guyleslie/EasySD-Gemini/docs/architecture/INIT_LOG_AUDIT_REPORT.md

# Init Log Audit Report

**Date:** 2025-12-26
**Component:** Arduino EasySD Firmware
**Scope:** POST_SPRINT6_PLAN B3 - Init Logging Consolidation

---

## Audit Findings

### 1. Duplicate Initialization (CRITICAL)

**Location:** `EasySD.ino setup()`

**Current flow:**
```cpp
// Line 143-145: Serial init + banner
Serial.begin(57600);
printStartupBanner();

// Line 154: SD init with retry
bool sdSuccess = initSD();

// Line 156-160: DUPLICATE INITIALIZATION #1
if (sdSuccess) {
    dirFunc.ReInit();   // → Calls ToRoot() → "DIR: ROOT"
    dirFunc.Prepare();  // → "DIR: RAM before=...", "DIR: Prep / n=...", "DIR: RAM after=..."
}

// Line 164: SD status
printSDStatus(sdSuccess);

// Line 168: DUPLICATE INITIALIZATION #2
cartApi.Init();  // → Internally calls:
                 //    dirFunc.ReInit();  (line 36)
                 //    dirFunc.Prepare(); (line 37)
```

**Problem:**
- `dirFunc.ReInit()` and `Prepare()` are called **TWICE**
- First call (line 158-159): Only if SD success
- Second call (line 168 → CartApi.cpp:36-37): **ALWAYS**, regardless of SD status

**Debug output duplication:**
```
[First call - line 158-159]
DIR: ROOT
DIR: RAM before=437
DIR: Prep / n=3
DIR: RAM after=437

[Second call - cartApi.Init()]
DIR: ROOT                    ← DUPLICATE
DIR: RAM before=437          ← DUPLICATE
DIR: Prep / n=3              ← DUPLICATE
DIR: RAM after=437           ← DUPLICATE
```

---

## Recommended Fixes

### Fix 1: Remove Redundant Initialization (PREFERRED)

**Action:** Delete lines 156-160 in `EasySD.ino`

**Rationale:**
- `cartApi.Init()` already calls `dirFunc.ReInit()` + `Prepare()`
- No need to call them explicitly in `setup()`
- Simplifies initialization flow
- Reduces log duplication

**New flow:**
```cpp
bool sdSuccess = initSD();
// Removed: dirFunc.ReInit() + Prepare() (cartApi.Init() handles this)
printSDStatus(sdSuccess);
cartApi.Init();  // Handles dirFunc init internally
```

**Note:** There's a comment on line 167:
```cpp
// Note: cartApi.Init() also calls dirFunc.ReInit/Prepare (duplicate but safe)
```
This comment acknowledges the duplication. We're fixing it now.

---

### Fix 2: Improve DirFunction::Prepare() Logging

**Current logging (too verbose):**
```cpp
#ifdef EASYSD_DEBUG_SERIAL
Serial.print(F("DIR: RAM before=")); Serial.println(FreeStack());
// ... processing ...
Serial.print(F("DIR: Prep ")); Serial.print(currentPath);
Serial.print(F(" n=")); Serial.println(count);
Serial.print(F("DIR: RAM after=")); Serial.println(FreeStack());
#endif
```

**Proposed (consolidated):**
```cpp
#ifdef EASYSD_DEBUG_SERIAL
Serial.print(F("[DIR] Prep: "));
Serial.print(currentPath);
Serial.print(F(" ("));
Serial.print(count);
Serial.print(F(" items, "));
Serial.print(FreeStack());
Serial.println(F(" bytes free)"));
#endif
```

**Before:**
```
DIR: RAM before=437
DIR: Prep / n=3
DIR: RAM after=437
```

**After:**
```
[DIR] Prep: / (3 items, 437 bytes free)
```

**Benefits:**
- One line instead of three
- Easier to grep: `grep "\[DIR\]" log.txt`
- Consistent with DebugLog.h format
- Still contains all critical info

---

### Fix 3: ToRoot() Logging Cleanup

**Current:**
```cpp
#ifdef EASYSD_DEBUG_SERIAL
Serial.println(F("DIR: ROOT"));
#endif
```

**Proposed:**
```cpp
#ifdef EASYSD_DEBUG_SERIAL
Serial.println(F("[DIR] Changed to ROOT"));
#endif
```

**Benefit:** Consistent prefix `[DIR]` for all directory operations

---

## Summary of Changes

| File | Line | Change | Priority |
|---|---|---|---|
| `EasySD.ino` | 156-160 | DELETE redundant dirFunc calls | **HIGH** |
| `EasySD.ino` | 167 | UPDATE comment (remove "duplicate but safe") | LOW |
| `DirFunction.cpp` | 224-252 | CONSOLIDATE Prepare() logging (3 lines → 1) | MEDIUM |
| `DirFunction.cpp` | 81 | UPDATE ToRoot() log prefix | LOW |

---

## Expected Outcome

**Before (duplicated logs):**
```
================================
 EasySD v2.1.0
 SdFat 2.3.0 | Arduino Nano
================================

SD: Init attempt 1/3 failed
SD: OK after 2 attempts
DIR: ROOT
DIR: RAM before=437
DIR: Prep / n=3
DIR: RAM after=437
SD OK
RAM: 437
Type 'h' for help

DIR: ROOT                    ← DUPLICATE
DIR: RAM before=437          ← DUPLICATE
DIR: Prep / n=3              ← DUPLICATE
DIR: RAM after=437           ← DUPLICATE
```

**After (clean logs):**
```
================================
 EasySD v2.1.0
 SdFat 2.3.0 | Arduino Nano
================================

SD: Init attempt 1/3 failed
SD: OK after 2 attempts
SD OK
RAM: 437
Type 'h' for help

[DIR] Changed to ROOT
[DIR] Prep: / (3 items, 437 bytes free)
```

**Reduction:** 10 lines → 6 lines (40% reduction)

---

## Implementation Plan

1. **Edit EasySD.ino** (HIGH priority)
   - Delete lines 156-160 (redundant dirFunc init)
   - Update line 167 comment

2. **Edit DirFunction.cpp** (MEDIUM priority)
   - Consolidate Prepare() logging (lines 224-252)
   - Update ToRoot() logging (line 81)

3. **Validation**
   - Build debug firmware
   - Verify no duplicate "DIR: ROOT" messages
   - Verify consolidated Prepare() log format
   - Check SD fail case (dirFunc init should still work via cartApi.Init())

---

**Status:** Ready for implementation
**Estimated time:** 30 minutes
**Risk:** Low (removing redundant code, improving logging only)
