guyleslie/EasySD-Gemini/docs/sprints/SPRINT6_PLAN.md

# Sprint 6 - Production Polish & User Experience

> **Tervezett dátum:** 2025-12-26+
> **Előfeltétel:** Sprint 5 Complete (v2.0.6)
> **Célverzió:** v2.1.0
> **Státusz:** Planning Phase

---

## Sprint Cél

**Professzionális user experience és production stability finomhangolás** a SdFat 2.x migráció lezárásaként.

**Fókusz:**
1. ✨ Serial Monitor UI/UX javítás (user-friendly output)
2. 🔧 Cold Boot SD Init javítás (retry logic)
3. 🎯 SdFat 2.x migráció véglegesítése
4. 📊 Extended testing & validation

---

## Prioritás 1 (P1) - Mandatory

### P1.1: Cold Boot SD Initialization Retry Logic

**Probléma (Sprint 5 Known Issue):**
```
Power cycle → SD init failure → Manual reset required
```

**Root Cause:**
- SD kártya ~100-200ms VCC stabilizáció szükséges
- Arduino gyorsabban bootol mint SD kártya készen áll
- `sd.begin()` túl korán hívódik

**Megoldás:**
```cpp
// IRQHack64.ino setup() módosítás
bool initSD() {
  const uint8_t SD_RETRY_COUNT = 3;
  const uint16_t SD_RETRY_DELAY_MS = 200;

  for (uint8_t retry = 0; retry < SD_RETRY_COUNT; retry++) {
    if (sd.begin(SD_CS_PIN, SD_SCK_MHZ(4))) {
      #ifdef DEBUG
      if (retry > 0) {
        Serial.print(F("SD: OK after "));
        Serial.print(retry + 1);
        Serial.println(F(" attempts"));
      }
      #endif
      return true;
    }

    #ifdef DEBUG
    Serial.print(F("SD: Init attempt "));
    Serial.print(retry + 1);
    Serial.print(F("/"));
    Serial.print(SD_RETRY_COUNT);
    Serial.println(F(" failed"));
    #endif

    if (retry < SD_RETRY_COUNT - 1) {
      delay(SD_RETRY_DELAY_MS);
    }
  }

  return false;
}
```

**Érintett fájl:** `Arduino/IRQHack64/IRQHack64.ino`

**Tesztelés:**
1. Cold boot (USB + SD táp lecsatlakoztatva, visszacsatlakoztatva)
2. Warm boot (Arduino reset gomb)
3. Hot boot (Serial monitor reconnect)

**Success Criteria:**
- ✅ Cold boot 95%+ siker ráta (3 retry esetén)
- ✅ Warm/hot boot továbbra is instant
- ✅ DEBUG log informatív (retry count visible)

**Becsült effort:** 1 óra (implementáció + tesztelés)

---

### P1.2: Serial Monitor UI/UX Refactoring

**Jelenlegi probléma:**
```
DIR: ROOT
DIR: RAM before=389
DIR: Prep / n=3
DIR: RAM after=389
=== IrqHack64 SPRINT 1 ===
d=nav r=reset p=status l=list
Free RAM: 437
```

**Problémák:**
- Nem user-friendly (DEBUG output dominál)
- Keverednek a DEBUG és user üzenetek
- Nincs strukturált navigációs feedback
- Hiányzik status bar / header

#### P1.2.1: Startup Banner Professzionalizálása

**Jelenlegi:**
```
=== IrqHack64 SPRINT 1 ===
```

**Javasolt (v2.1.0):**
```
╔════════════════════════════════════════╗
║   EasySD IRQHack64 Firmware v2.1.0    ║
║   SdFat 2.3.0 | Arduino Nano           ║
╚════════════════════════════════════════╝

Initializing SD card...
✓ SD card ready (FAT32, 32GB)
✓ Directory system initialized
✓ Free RAM: 437 bytes

Ready. Type 'h' for help.
> _
```

**Implementáció:**
```cpp
void printStartupBanner() {
  Serial.println(F("╔════════════════════════════════════════╗"));
  Serial.println(F("║   EasySD IRQHack64 Firmware v2.1.0    ║"));
  Serial.println(F("║   SdFat 2.3.0 | Arduino Nano           ║"));
  Serial.println(F("╚════════════════════════════════════════╝"));
  Serial.println();
}

void printSDStatus() {
  Serial.println(F("Initializing SD card..."));

  if (initSD()) {
    Serial.print(F("✓ SD card ready ("));
    // Print card type (FAT16/FAT32/exFAT)
    Serial.print(F(", "));
    // Print card size
    Serial.println(F(")"));
  } else {
    Serial.println(F("✗ SD card initialization failed"));
    Serial.println(F("  Check: Card inserted? Format correct?"));
  }
}
```

#### P1.2.2: Navigation Feedback Strukturálása

**Jelenlegi:**
```
Navigate: UTILS
DIR: CD UTILS
DIR: Entered /UTILS
OK
Path: /UTILS
Items: 3
```

**Javasolt:**
```
Navigating to: UTILS
  ✓ Changed directory to /UTILS
  ✓ Found 3 items

Current path: /UTILS
> _
```

**Implementáció:**
```cpp
void printNavigationSuccess(const char* path, uint16_t itemCount) {
  Serial.print(F("  ✓ Changed directory to "));
  Serial.println(path);
  Serial.print(F("  ✓ Found "));
  Serial.print(itemCount);
  Serial.println(F(" items"));
  Serial.println();
  Serial.print(F("Current path: "));
  Serial.println(path);
}

void printNavigationError(const char* dirname) {
  Serial.print(F("  ✗ Cannot access directory: "));
  Serial.println(dirname);
  Serial.println(F("    Check: Directory exists? Name correct?"));
}
```

#### P1.2.3: Directory Listing Format

**Jelenlegi:**
```
List: /UTILS
1: .. [DIR]
2: UTILS2 [DIR]
3: 2kscrollerizer.prg
DIR: Iterate Finished
Total: 3
```

**Javasolt:**
```
Directory: /UTILS
────────────────────────────────────────
  📁 ..
  📁 UTILS2
  📄 2kscrollerizer.prg
────────────────────────────────────────
Total: 3 items (2 folders, 1 file)
> _
```

**Implementáció:**
```cpp
void printDirectoryHeader(const char* path) {
  Serial.print(F("Directory: "));
  Serial.println(path);
  Serial.println(F("────────────────────────────────────────"));
}

void printDirectoryEntry(const char* name, bool isDir) {
  Serial.print(F("  "));
  Serial.print(isDir ? F("📁 ") : F("📄 "));
  Serial.println(name);
}

void printDirectoryFooter(uint16_t totalItems, uint16_t dirCount, uint16_t fileCount) {
  Serial.println(F("────────────────────────────────────────"));
  Serial.print(F("Total: "));
  Serial.print(totalItems);
  Serial.print(F(" items ("));
  Serial.print(dirCount);
  Serial.print(F(" folders, "));
  Serial.print(fileCount);
  Serial.println(F(" files)"));
}
```

#### P1.2.4: Help System

**Új parancs:** `h` (help)

**Kimenet:**
```
EasySD IRQHack64 - Command Reference
────────────────────────────────────────
  h     Show this help
  d     Navigate to directory (prompts for name)
  r     Return to root directory
  l     List current directory contents
  p     Show current path and status
  m     Show memory usage (DEBUG only)
────────────────────────────────────────
Examples:
  d → UTILS → d → UTILS2 → r

> _
```

#### P1.2.5: DEBUG Mode Separation

**Stratégia:**
```cpp
#ifdef DEBUG
  // DEBUG-only részletes info
  #define DEBUG_PRINT(x) Serial.print(F("DEBUG: ")); Serial.println(x)
  #define DEBUG_RAM() printRAMStatus()
#else
  #define DEBUG_PRINT(x)
  #define DEBUG_RAM()
#endif

// User-facing mindig látható
#define USER_PRINT(x) Serial.println(x)
```

**Alkalmazás:**
```cpp
// User-facing output
USER_PRINT("Navigating to: UTILS");

// DEBUG details
DEBUG_PRINT("DIR: chdir(UTILS) called");
DEBUG_PRINT("DIR: ResyncDirFromCwd() success");
DEBUG_RAM(); // RAM before/after

// User-facing result
printNavigationSuccess(currentPath, count);
```

**Érintett fájlok:**
- `Arduino/IRQHack64/IRQHack64.ino` (main loop, banner)
- `Arduino/IRQHack64/DirFunction.cpp` (navigation feedback)

**Becsült effort:** 3-4 óra (UI design + implementáció + tesztelés)

---

## Prioritás 2 (P2) - Strongly Recommended

### P2.1: Error Handling Standardization

**Cél:** Egységes error message formátum minden művelethez

**Error Categories:**
1. **SD Card Errors:** Init, read, write failures
2. **Directory Errors:** Navigation, listing failures
3. **File Errors:** Open, read failures
4. **System Errors:** Memory, state inconsistency

**Template:**
```
✗ [Category] Error: [Short description]
  Cause: [Technical reason]
  Action: [User suggestion]
```

**Példa:**
```
✗ Directory Error: Cannot navigate to UTILS2
  Cause: Directory does not exist
  Action: Check directory name spelling

✗ SD Card Error: Card initialization failed
  Cause: No SD card detected
  Action: Insert SD card and press reset button
```

**Implementáció:**
```cpp
enum ErrorCategory {
  ERR_SD_CARD,
  ERR_DIRECTORY,
  ERR_FILE,
  ERR_SYSTEM
};

void printError(ErrorCategory cat, const char* desc, const char* cause, const char* action) {
  Serial.print(F("✗ "));

  switch(cat) {
    case ERR_SD_CARD:   Serial.print(F("SD Card")); break;
    case ERR_DIRECTORY: Serial.print(F("Directory")); break;
    case ERR_FILE:      Serial.print(F("File")); break;
    case ERR_SYSTEM:    Serial.print(F("System")); break;
  }

  Serial.print(F(" Error: "));
  Serial.println(desc);
  Serial.print(F("  Cause: "));
  Serial.println(cause);
  Serial.print(F("  Action: "));
  Serial.println(action);
}
```

**Becsült effort:** 2 óra

---

### P2.2: Memory Status Display Improvement

**Jelenlegi:**
```
Free RAM: 437
DIR: RAM before=389
DIR: RAM after=389
```

**Javasolt (m parancs):**
```
Memory Status
────────────────────────────────────────
  Total SRAM:        2048 bytes
  Used:              1611 bytes (78.7%)
  Free:               437 bytes (21.3%)

  Stack (approx):     256 bytes
  Heap (approx):     1355 bytes

  Dir handle RAM:     389 bytes
────────────────────────────────────────
Status: ✓ Normal (>400 bytes free)
```

**Warning levels:**
```cpp
void printMemoryStatus() {
  uint16_t freeRAM = FreeStack();

  // ... (táblázat kiírása)

  Serial.print(F("Status: "));
  if (freeRAM > 400) {
    Serial.println(F("✓ Normal"));
  } else if (freeRAM > 300) {
    Serial.println(F("⚠ Low (consider freeing resources)"));
  } else {
    Serial.println(F("✗ Critical (risk of stack overflow)"));
  }
}
```

**Becsült effort:** 1.5 óra

---

## Prioritás 3 (P3) - Quality/Polish

### P3.1: Extended Hardware Testing

**Test Suite:**

1. **Stress Test - Navigation Cycles:**
   - 20x Root → UTILS → UTILS2 → Root cycle
   - RAM monitoring minden lépésnél
   - Assertion: Visszatér baseline-ra (<5 byte eltérés)

2. **Deep Nesting Test:**
   - 5-6 szintű directory navigáció (ha van ilyen az SD-n)
   - Path buffer overflow detection (64 byte limit)
   - GoBack működés minden szintről

3. **Large Directory Test:**
   - 50+ fájl egy directory-ban (ha van)
   - Prepare() performance (<500ms)
   - Iterate() stability

4. **Edge Cases:**
   - Üres directory
   - Single file directory
   - Csak subdirectory, file nélkül
   - Very long filename (>20 char)

**Test Script (Python):**
```python
# Tools/test_navigation_stress.py
import serial
import time

def stress_test_navigation(port, cycles=20):
    ser = serial.Serial(port, 57600, timeout=2)

    for i in range(cycles):
        print(f"Cycle {i+1}/{cycles}")

        # Navigate: Root → UTILS → UTILS2
        ser.write(b'd\n')
        time.sleep(0.5)
        ser.write(b'UTILS\n')
        time.sleep(0.5)

        ser.write(b'd\n')
        time.sleep(0.5)
        ser.write(b'UTILS2\n')
        time.sleep(0.5)

        # Return to root
        ser.write(b'r\n')
        time.sleep(0.5)

        # Check memory
        ser.write(b'm\n')
        response = ser.read(500).decode('utf-8')

        # Parse RAM usage
        # Assert: RAM within expected range

    ser.close()
    print("✓ Stress test complete")
```

**Becsült effort:** 2-3 óra (script + manual testing + documentation)

---

### P3.2: SdFat 2.3.0 → 2.3.3 Upgrade Evaluation

**Jelenlegi:** SdFat 2.3.0 (2023)
**Latest:** SdFat 2.3.3 (2024)

**Changelog Review (2.3.0 → 2.3.3):**
- FAT32 edge case bug fixes
- ExFAT performance improvements
- Better error handling

**Kockázat Értékelés:**
- ✅ Minor version jump (low risk)
- ✅ Sprint 5 tests reusable (regression detection)
- ⚠️ New bugs possible (mindig van rizikó)

**Döntési Fa:**
```
1. Review SdFat 2.3.3 changelog részletesen
2. Ha van critical bugfix → UPGRADE (Priority: High)
3. Ha csak minor improvements → DEFER (Priority: Low)
4. Ha uncertainty → TEST in separate branch first
```

**Upgrade Process (ha GO):**
1. Backup current Arduino/libraries/SdFat
2. Install SdFat 2.3.3 via Library Manager
3. Full Sprint 5 regression test suite
4. Extended testing (P3.1)
5. Documentation update

**Becsült effort:** 1-2 óra (review + potential upgrade + testing)

---

### P3.3: Documentation Finalization

**Sprint 6 dokumentáció:**
1. ✅ `SPRINT6_PLAN.md` - Ez a fájl
2. ⏳ `SPRINT6_COMPLETION.md` - Sprint végén
3. ⏳ `SERIAL_UI_GUIDE.md` - User manual a parancsokhoz
4. ⏳ Update `CHANGELOG_UNIFIED.md` - v2.1.0 entry

**SERIAL_UI_GUIDE.md tartalom:**
```markdown
# EasySD IRQHack64 - Serial Interface Guide

## Commands
- h: Help
- d: Navigate
- r: Root
- l: List
- p: Path
- m: Memory (DEBUG)

## Navigation Examples
## Error Messages
## Troubleshooting
```

**Becsült effort:** 1.5 óra

---

## Definition of Done (Sprint 6)

Sprint 6 **COMPLETE** amikor:

### Mandatory (P1)
1. ✅ Cold boot SD init retry logic implementálva és tesztelve
   - 95%+ cold boot success rate (3 retry)
   - No regression warm/hot boot esetén
2. ✅ Serial Monitor UI/UX refactoring befejezve
   - Startup banner professional
   - Navigation feedback user-friendly
   - Directory listing structured
   - Help system working
   - DEBUG/User output separated

### Recommended (P2)
3. ✅ Error handling standardizálva (4 kategória)
4. ✅ Memory status display improved

### Quality (P3)
5. ✅ Extended hardware testing suite completed
   - 20x stress test passed
   - Deep nesting tested
   - Large directory tested
   - Edge cases covered
6. ✅ SdFat upgrade decision made (upgrade or defer)
7. ✅ Documentation finalized
   - SPRINT6_COMPLETION.md
   - SERIAL_UI_GUIDE.md
   - CHANGELOG_UNIFIED.md updated

---

## Sprint 6 Effort Estimate

| Priority | Task | Effort | Cumulative |
|---|---|---|---|
| P1.1 | Cold Boot Retry | 1h | 1h |
| P1.2 | Serial UI/UX | 4h | 5h |
| P2.1 | Error Handling | 2h | 7h |
| P2.2 | Memory Display | 1.5h | 8.5h |
| P3.1 | Extended Testing | 3h | 11.5h |
| P3.2 | SdFat Evaluation | 2h | 13.5h |
| P3.3 | Documentation | 1.5h | **15h total** |

**Becsült Sprint időtartam:** 2-3 nap (casual pace) vagy 1 nap (focused sprint)

---

## Testing Strategy

### Unit Tests (Arduino Serial Monitor)

**Test 1: Cold Boot**
```
1. Power cycle (USB + SD power off/on)
2. Observe: SD init retry attempts
3. Expected: Success within 3 attempts
4. Log: Retry count in DEBUG mode
```

**Test 2: UI/UX Validation**
```
1. Reset Arduino
2. Observe: Startup banner
3. Type: h
4. Expected: Help displayed
5. Type: l
6. Expected: Structured directory listing
```

**Test 3: Navigation Flow**
```
1. Type: d → UTILS → d → UTILS2
2. Observe: User-friendly feedback
3. Type: r
4. Expected: Clean return to root with status
```

### Regression Tests (Reuse Sprint 5)

```
All Sprint 5 tests must PASS:
✅ Multi-level navigation (5 scenarios)
✅ RAM stability (0 byte leaks)
✅ State synchronization (no drift)
```

### Performance Tests

```
Benchmark: Directory operations timing
- Prepare() on 3-item dir: <50ms
- Iterate() per item: <10ms
- ChangeDirectory(): <100ms
```

---

## Risk Assessment

| Risk | Probability | Impact | Mitigation |
|---|---|---|---|
| Serial output breaks existing C64 integration | Low | High | Ensure C64 side ignores Serial, test thoroughly |
| Cold boot retry adds delay | Medium | Low | Only 400ms max (2x200ms), acceptable |
| UI changes confuse users | Low | Medium | Provide SERIAL_UI_GUIDE.md |
| SdFat upgrade breaks code | Low | High | Full regression test suite, backup old version |
| Extended testing finds new bugs | Medium | Medium | Good! Fix before production |

---

## Success Metrics

**User Experience:**
- [ ] Startup time: <2 seconds (including SD init with retry)
- [ ] Command response: Instant (<100ms perceived)
- [ ] Error messages: Clear, actionable
- [ ] Help system: Comprehensive, easy to understand

**Stability:**
- [ ] Cold boot success rate: >95% (vs current ~50%)
- [ ] RAM stability: Maintained (no regression vs Sprint 5)
- [ ] Zero crashes during 20x stress test

**Code Quality:**
- [ ] Code coverage: DEBUG macros properly used
- [ ] Documentation: Complete, professional
- [ ] Maintainability: Clear separation User/DEBUG output

---

## Next Steps (Post Sprint 6)

**v2.1.0 is PRODUCTION READY when Sprint 6 DoD met.**

**Future Sprints (Optional):**
- **Sprint 7:** C64 side improvements (menu UX, error handling)
- **Sprint 8:** Advanced features (file search, recursive ops)
- **Sprint 9:** Performance optimization (if needed)

**Maintenance Mode:**
- Monitor user feedback
- Bug fixes as needed
- Library updates (SdFat, Arduino Core) as released

---

**Status:** 📋 Planning Complete - Ready for Implementation
**Created:** 2025-12-26
**Target Start:** TBD (User decision)
**Estimated Duration:** 1-3 days
