guyleslie/EasySD-Gemini/docs/architecture/ARCHITECTURE_CONSOLIDATION_PLAN.md

# IRQHack64 Architekturális Konszolidációs Terv
## "IO2 Kanonikus Architektúra" - Sprint A-D

**Dokumentum típus:** Stratégiai terv
**Verzió:** 2.2 (SPRINT A.3 CANCELLED - ARCHITECTURAL CORRECTIONS)
**Készült:** 2025-12-29
**Frissítve:** 2025-12-30 (Sprint A.3.0 research findings + NO-GO decision)
**Alapja:** nieuw 7.txt elemzés, Sprint A.3.0 code research, architectural fact-checking
**Status:** SPRINT A COMPLETE (with NO-GO on refactoring)

**v2.0 változások:**
- ✅ Sprint B.0: "Visibility over Magic" filozófia (kritikus kiegészítés)
- ✅ Sprint B.2: Tier-alapú macro rendszer (1=primitives, 2=caller-responsible, 3=lifecycle)
- ✅ Sprint B.3: Code review enforcement (NEM compile-time, pragmatikus)
- ✅ Sprint B.4: Audit tools (grep-based, egyszerű scriptek)

**v2.1 változások (KRITIKUS KORREKCIÓK):**
- ✅ Sprint A.3 előfeltevések javítása: Pluginok NEM hardcode-olják a címeket
- ✅ Sprint A.3.0 ÚJ: Pre-refactoring kutatási fázis hozzáadva
- ✅ Refaktoring stratégia módosítása: "Replace" → "ADD explicit addresses"
- ✅ Refaktoring példák javítása (auto-placement → explicit ORG)
- ✅ BurstLoader exception tisztázása (approved architectural decision)
- ✅ Timeline frissítése: 2-3 nap → 4-5 nap (kutatási fázis miatt)
- ✅ Referencia: docs/sprints/SPRINT_A_AUDIT_FINDINGS.md (részletes audit jelentés)

**v2.2 változások (SPRINT A.3 CANCELLED - ARCHITECTURAL FACT-CHECKING):**
- 🔴 **SPRINT A.3 CANCELLED** - Plugin refactoring NO-GO (architectural assumptions were INCORRECT)
- ✅ **MEMORY_MAP_CANONICAL.md v2.0** released - corrected ZP pointer architecture documentation
- ✅ **Type A/B Program Categorization** - BurstLoader is standalone app (NOT plugin exception)
- ✅ **Zero technical value** from refactoring - API uses ZP pointers (buffers can be anywhere)
- ✅ **Sprint A.1-A.2 COMPLETE** - IO2_PROTOCOL_SPECIFICATION.md ✅, CartMemoryMap.inc ✅
- ✅ **Sprint A.3.0 COMPLETE** - Architectural research, NO-GO decision approved by user
- ✅ Referenciák:
  - docs/sprints/A.3.0_PLUGIN_ARCHITECTURE_RESEARCH.md (Type A/B categories)
  - docs/sprints/A.3.0_REFACTORING_DECISION.md (NO-GO justification)
  - docs/MEMORY_MAP_CANONICAL.md v2.0 (corrected normative spec)

---

## Executive Summary

Ez a dokumentum a **"nieuw 7.txt"** által definiált kanonikus architektúra megvalósításának részletes tervét tartalmazza. A terv négy sprintre (A-D) bontva konzolidálja az IRQHack64 projekt jelenlegi implementációját, tisztázza az IO2-alapú streaming protokollt, standardizálja a memóriatérképet és a kódolási mintázatokat.

### Kulcsmegállapítások a projekt jelenlegi állapotáról

✅ **ERŐSSÉGEK** (már megvalósított elemek):
- IO2/DF00 protokoll **helyesen implementálva** (CartLibStream.s, CartApi.cpp)
- Streaming timeout **működik** (100ms, STREAM_TIMEOUT_MS)
- Transfer buffer memóriatérkép **konzisztens** ($C000-$C19F kanonikus, $A000 csak BurstLoader)
- Zero Page management **professzionális** (ZP_GUIDELINES.md normatív dokument)
- Macro architektúra **érett** (SystemMacros.s, Sprint 1-11 eredményei)
- ByteQueue **helyesen használva** (csak parancsok fogadására, NEM streaminghez)

⚠️ **JAVÍTANDÓ TERÜLETEK** (konszolidációs célpontok):
- ZP naming convention **nem teljes** (Sprint 11 folyamatban, de teljes átnevezés hiányzik)
- Plugin memóriatérkép audit **részleges** (BurstLoader vs. többi plugin esete dokumentált, de nem normatív)
- Makró használat **nem egységes minden pluginban** (411× READCART_MODULATED jó példa, de nem minden plugin használja)
- "Kanonikus architektúra" dokumentáció **szétszórt** (ARCHITECTURE_REVIEW.md, ZP_GUIDELINES.md, MemUsage.txt külön élnek)

📋 **TERV CÉLJAI**:
1. **Konzisztencia** - Egyetlen "igazság forrása" minden architekturális döntésre
2. **Dokumentáltság** - Normatív architektúra dokumentum, amely kötelező referencia
3. **Compliance** - Minden plugin és kód megfelel a kanonikus szabályoknak
4. **Tesztelhetőség** - Determinisztikus tesztek az IO2 protokoll és memória helyességére
5. **Tudatos fejlesztés** - Makrók "segítenek", nem "helyettesítik" a gondolkodást (v2.0 kiegészítés)

---

## JELENLEGI ÁLLAPOT - Részletes Audit Eredmények

### 1. IO2/DF00 Protokoll Implementáció

**STATUS: ✅ HELYES IMPLEMENTÁCIÓ**

#### C64 oldal (CartLibStream.s)

```assembly
; Jelenlegi implementáció (CartLibStream.s:40-42, 81-82)
STREAM_TRIGGER_PORT = $DF00  ; IO2 trigger
STREAM_DATA_PORT    = $DE00  ; Data read

_stream_loop:
    LDA STREAM_TRIGGER_PORT  ; Pulse /IO2
    LDA STREAM_DATA_PORT     ; Read byte
    STA (ZP_STREAM_API_TARGET_LO),Y
```

**Megfelelőség:**
- ✅ IO2 címzés helyes ($DF00 trigger)
- ✅ 32-bit file size támogatás (ZP_STREAM_API_REMAIN0-3, $92-$95)
- ✅ SEI/CLI interrupt védelem
- ✅ Passzív terminálás (C64 abbahagyja a request-eket, Arduino timeout észleli)

#### Arduino oldal (CartApi.cpp)

```cpp
// CartApi.cpp:905-950
#define STREAM_TIMEOUT_MS 100

void CartApi::HandleStream() {
    // Double-buffered streaming (64 byte × 2)
    attachInterrupt(digitalPinToInterrupt(IO2),
                    CartApi::DoubleBufferedStreaming, FALLING);

    while(1) {
        while(usedBuffer == 0) {
            if (!digitalRead(SEL)) goto out;  // Emergency exit
            if (millis() - lastStreamRequestTime > STREAM_TIMEOUT_MS) goto out;  // Timeout
        }
        workingFile.read(streamingBuffer1, DOUBLE_BUFFER_SIZE);
        // ... buffer swap ...
    }
out:
    TIMSK2 = 0x02;  // Restore timer interrupts
}
```

**Megfelelőség:**
- ✅ IO2 interrupt FALLING edge (CartInterface.h:35 - `#define IO2 2`)
- ✅ 100ms timeout implementálva
- ✅ SEL line emergency exit
- ✅ ISR-safe static bufferek (Sprint 1 bugfix)

**KÖVETKEZTETÉS:** Az IO2/DF00 protokoll **kanonikus implementáció**, nincs szükség architektúrális változtatásra. **Dokumentáció hiányzik** egy normatív "IO2 Protocol Specification" formájában.

---

### 2. Memóriatérkép Állapot

**STATUS: ⚠️ KONZISZTENS, DE NEM NORMATÍV**

#### Kanonikus térkép (MemUsage.txt alapján)

```
$C000-$C19F  : Transfer buffer (416 byte) - KANONIKUS
$C1A0-$CEB6  : NMI handlers              - KANONIKUS
$A000-$A18F  : BurstLoader transfer buffer (400 byte) - SPECIÁLIS CÉL
```

#### Plugin állapot audit

| Plugin | Transfer Buffer | Megfelelőség | Megjegyzés |
|---|---|---|---|
| **BurstLoader** | $A000 | ✅ OK | Speciális célú, dokumentált (MemUsage.txt) |
| **PrgPlugin** | $C000 | ✅ OK | Kanonikus |
| **MusPlayer** | $C000 | ✅ OK | Kanonikus |
| **KoalaDisplayer**| $C000 | ✅ OK | Kanonikus |
| **PetsciiDisplayer** | $C000 | ✅ OK | Kanonikus |
| **WavPlayer** | $C000 | ✅ OK | Kanonikus |

**Inkonzisztencia elemzés:**
- ❌ **NINCS valódi inkonzisztencia** - BurstLoader $A000 használat **tervezett döntés**
- ⚠️ **HIÁNYZÓ NORMA** - MemUsage.txt nem normatív dokumentum, hanem csak leíró
- ⚠️ **HIÁNYZÓ SYMBOL** - Nincs egyetlen közös `TRANSFER_BUFFER_ADDR` szimbólum CartZpMap.inc-ben

**KÖVETKEZTETÉS:** Memóriatérkép **helyes**, de **normatív definíció és közös szimbólum hiányzik**.

---

### 3. Zero Page Állapot

**STATUS: ⚠️ RÉSZBEN MEGFELELŐ (Sprint 11 folyamatban)**

#### Kanonikus tartományok (ZP_GUIDELINES.md szerint)

| Tartomány | Kategória | Owner | IRQ Safety | Status |
|---|---|---|---|---|
| $64-$77 | Protocol Layer | IRQHack64 protocol | KRITIKUS | ✅ Stabil |
| $80-$87 | LoadFileBySize API | LoadFileBySize function | UNSAFE | ⚠️ Naming |
| $90-$95 | StreamLargeFile API | StreamLargeFile function | SEI protected | ⚠️ Naming |

#### Naming Convention Compliance

**Előírás (ZP_GUIDELINES.md):**
```
ZP_<MODULE>_<CATEGORY>_<DESC>
Példa: ZP_LOADFILE_API_SIZE0
```

**Jelenlegi állapot (CartZpMap.inc):**
```assembly
; ROSSZ (régi naming):
ZP_LF_SIZE0          = $80  ; LoadFile Size byte 0

; JÓ (új naming):
ZP_LOADFILE_API_SIZE0 = $80  ; Követi a konvenciót
```

**Sprint 11 Progress:**
- ✅ CartZpMap.inc struktúra átdolgozva (Sprint 10)
- ⚠️ Teljes átnevezés **folyamatban** (Sprint 11)
- ❌ Pluginok **nem frissítettek** még az új nevekre

**KÖVETKEZTETÉS:** ZP guideline **kiváló normatív dokumentum**, de a **naming compliance csak 40% körül van**.

---

### 4. ByteQueue Szerepe

**STATUS: ✅ HELYESEN HASZNÁLVA**

#### ByteQueue architektúra

**Jelenlegi használat (CartInterface.cpp:21, 83, 137, 146):**
```cpp
// ISR (ReceiveInterrupt) fogadja a C64-től a parancsokat
volatile ByteQueue readQueue;

static void CartInterface::ReceiveInterrupt() {
    // ... PHI2-clocked serial protocol ...
    if (!readQueue.IsFull()) {
        readQueue.Enqueue(currentByte);  // Parancs byte tárolás
    }
}

uint16_t CartInterface::Read() {
    if (readQueue.IsAvailable()) {
        return readQueue.Dequeue();  // Parancs olvasás
    }
}
```

**Használati terület:**
- ✅ **C64 → Arduino parancs kommunikáció** (IRQ_StartTalking, IRQ_Send, stb.)
- ✅ **Soft-serial protocol** (PHI2-clocked, CartInterface.h:6-9)
- ❌ **NINCS használva streaming adatokhoz** (helyesen!)

**Protokoll szerepek:**
1. **ByteQueue** - Parancsok (command bytes, arguments)
2. **HandleStream()** - Nagy tömegű adat (video, audio, file content)

**KÖVETKEZTETÉS:** ByteQueue **architektúrája helyes**, szerepe **tiszta és dokumentált**. A "nieuw 7.txt" által javasolt "ByteQueue nem a streaming fő megoldása" **már megvalósított állapot**.

---

### 5. Makró Architektúra Használat

**STATUS: ⚠️ NEM EGYSÉGES MINDEN PLUGINBAN**

#### Makró használat példák

**BurstLoader NMI.s - KIVÁLÓ PÉLDA:**
```assembly
; 411× használat READCART_MODULATED makróval
NMI_000:
    READCART_MODULATED $A000, CARTRIDGE_BANK  ; 1. byte
    READCART_MODULATED $A001, CARTRIDGE_BANK  ; 2. byte
    ; ... 409 további sor ...
```

**Pluginok makró compliance:**

| Plugin | READCART használat | SystemMacros include | Compliance |
|---|---|---|---|
| **BurstLoader** | 411× READCART_MODULATED | ✅ Igen | ✅ 100% |
| **PrgPlugin** | Inline LDA $DE00 | ❌ Nem | ❌ 0% |
| **MusPlayer** | Inline cartridge read | ❌ Nem | ❌ 0% |
| **KoalaDisplayer**| Inline | ❌ Nem | ❌ 0% |

**KÖVETKEZTETÉS:** Macro architecture **kiválóan megtervezett** (SystemMacros.s, Sprint 1), de **adoption rate alacsony**. BurstLoader referencia implementáció, de más pluginok nem követik.

---

## SPRINT A - "Egyetlen Igaz Jelút" Konszolidáció

**Cél:** IO2/DF00 protokoll és memóriatérkép normatív dokumentálása, közös szimbólumok létrehozása

**Időtartam:** 4-5 munkanap (frissített - v2.1 audit után)
**Prioritás:** KRITIKUS (alapozza meg a többi sprintet)

**⚠️ v2.1 MEGJEGYZÉS:**
A Sprint A audit felfedezte, hogy a pluginok **NEM hardcode-olják** a memória címeket.
Az assembler automatikusan helyezi el a buffereket. A refaktoring célja **explicit címzés hozzáadása** (nem replace!).
**Részletek:** `docs/sprints/SPRINT_A_AUDIT_FINDINGS.md`

### A.1 - IO2 Protokoll Kanonizálás

**Feladat:** Normatív "IO2 Protocol Specification" dokumentum létrehozása

**Kimenet:** `docs/IO2_PROTOCOL_SPECIFICATION.md`

**Tartalom:**
```markdown
# IO2 Protocol Specification v1.0 (Normative)

## 1. Hardware Layer
- IO2 line: C64 /IO2 → Arduino D2 (INPUT, FALLING edge interrupt)
- Trigger: C64 LDA $DF00 → generates /IO2 pulse
- Data: C64 LDA $DE00 → reads cartridge data register

## 2. C64 Side Contract
- Function: StreamLargeFile (CartLibStream.s)
- ZP usage: $90-$95 (STREAM_TARGET_ADDR, STREAM_REMAIN 32-bit)
- Interrupt state: SEI during streaming
- Termination: PASSIVE (stop requesting, Arduino timeout)

## 3. Arduino Side Contract
- Function: HandleStream() (CartApi.cpp:905)
- ISR: DoubleBufferedStreaming() (FALLING edge on IO2)
- Buffering: Double buffer (64 byte × 2)
- Timeout: 100ms (STREAM_TIMEOUT_MS)
- Emergency exit: SEL line LOW

## 4. Timing Constraints
- C64 request rate: Max ~500 kHz (2 cycles per byte)
- Arduino response: < 2 μs (ISR execution)
- Timeout window: 100ms (no request → exit)

## 5. Error Handling
- Arduino: SUCCESSFUL (0x00) or error code via HandleResponse
- C64: Carry flag (CLC=success, SEC=error)

## 6. Test Requirements (Sprint D)
- Test 1: 1MB file transfer (deterministic byte count)
- Test 2: Mid-stream abort (C64 stops requesting)
- Test 3: Timeout trigger (verify 100ms clean exit)
```

**Approval:** Normatív dokumentum, minden jövőbeli kód ezt KELL kövesse.

---

### A.2 - Memóriatérkép Normatív Definíció

**Feladat:** `docs/MEMORY_MAP_CANONICAL.md` létrehozása + **CartMemoryMap.inc létrehozása** (ÚJ fájl!)

**⚠️ v2.1 VÁLTOZÁS:** CartZpMap.inc **CSAK Zero Page** változókat ($00-$FF) tartalmaz.
High memory szimbólumok ($C000+) egy **ÚJ** fájlba kerülnek: `IRQHack64/Loader/CartMemoryMap.inc`

**1. Normatív dokumentum (`docs/MEMORY_MAP_CANONICAL.md`):**

```markdown
# Canonical Memory Map - IRQHack64 (Normative)

**Version:** 1.0
**Status:** CANONICAL - All code MUST conform

## Standard Plugin Memory Layout

```
$C000-$C19F  : TRANSFER_BUFFER (416 bytes)
               - Temporary storage for file I/O
               - Volatile (content not preserved across plugin calls)
               - ALL standard plugins MUST use this address

$C1A0-$CEB6  : NMI_HANDLER_REGION
               - Reserved for NMI interrupt code
               - Plugins MAY place NMI handlers here
               - MUST NOT overlap TRANSFER_BUFFER
```

## Special Cases

### BurstLoader Exception
```
$A000-$A18F  : BURST_TRANSFER_BUFFER (400 bytes)
               - ONLY BurstLoader plugin
               - Reason: Optimized burst loading algorithm
               - Architectural approval: 2025-12-27
```

## Compliance Rules
1. Standard plugins MUST use $C000 for transfer buffer
2. Exceptions require architectural review
3. MemUsage.txt must document deviations
```

**2. CartMemoryMap.inc létrehozása (ÚJ FÁJL):**

**Fájl:** `IRQHack64/Loader/CartMemoryMap.inc`

```assembly
; ============================================================
; EasySD / IRQHack64 - Canonical Memory Map (High Memory Symbols)
; ============================================================
;
; ⚠️ IMPORTANT: This file defines HIGH MEMORY addresses ($C000+),
;               NOT Zero Page ($00-$FF).
;               For Zero Page variables, see CartZpMap.inc
;
; Reference: docs/MEMORY_MAP_CANONICAL.md
; ============================================================

; Standard transfer buffer (416 bytes)
TRANSFER_BUFFER_ADDR     = $C000  ; Base address (NOT Zero Page!)
TRANSFER_BUFFER_SIZE     = $01A0  ; 416 bytes ($C000-$C19F)
TRANSFER_BUFFER_END      = $C19F  ; Last byte

; NMI handler region
NMI_HANDLER_REGION_START = $C1A0
NMI_HANDLER_REGION_END   = $CEB6
NMI_HANDLER_REGION_SIZE  = $0D17  ; 3351 bytes

; BurstLoader exception (approved architectural exception)
BURST_BUFFER_ADDR        = $A000  ; BurstLoader ONLY
BURST_BUFFER_SIZE        = $0190  ; 400 bytes
BURST_BUFFER_END         = $A18F
```

**3. Plugin refactoring (példa PrgPlugin.s):**

**⚠️ v2.1 JAVÍTÁS:** Az ELŐTTE példa **TÉVES VOLT** (a terv feltételezte, hogy `*=$C000` a buffer címe).

**VALÓDI ELŐTTE (audit alapján):**
```assembly
; PrgPlugin.s - JELENLEGI állapot
*=$C000        ; Entry point (JMP MAIN, 3 byte)
JMP MAIN

*=$C700
MAIN
    ; ... code ...

; NINCS explicit ORG - assembler automatikusan helyezi el!
GENERALBUFFER
    .FILL 256  ; Assembler dönt → $D032 (listing szerint)
```

**UTÁNA (explicit canonical címzés):**
```assembly
; PrgPlugin.s - REFAKTORÁLT állapot
.include "../../Loader/CartMemoryMap.inc"

; Transfer buffer at CANONICAL address
*=TRANSFER_BUFFER_ADDR  ; $C000
FileInfoBuffer:
    .res TRANSFER_BUFFER_SIZE  ; 416 bytes

; Plugin entry point AFTER buffer
*=NMI_HANDLER_REGION_START  ; $C1A0
PluginEntry:
    JMP MAIN

*=$C700
MAIN:
    ; Plugin code...
    ; Minden GENERALBUFFER → FileInfoBuffer referencia módosítása
```

**Érintett fájlok:**
- ✅ CartMemoryMap.inc (ÚJ fájl létrehozva)
- ⏳ PrgPlugin.s, MusPlayer.s, KoalaDisplayer.s, PetsciiDisplayer.s, WavPlayer.s
- ⏳ BurstLoader.s (header comment exception dokumentálása)

---

### A.3.0 - Pre-Refactoring Kutatási Fázis (ÚJ - v2.1)

**⚠️ KRITIKUS ELŐFELTÉTEL:** Audit felfedezte, hogy a pluginok NEM hardcode-olják a címeket!
**Feladat:** Válaszolni kell a kritikus kérdésekre, MIELŐTT refaktorálás kezdődik.

**Kutatási kérdések:**

**1. Plugin Loader Mechanizmus:**
   - Hogyan tölti be a menu a pluginokat?
   - Van-e fix entry point elvárás ($C000)?
   - Mi történik, ha az entry point címe változik?
   - Lehet-e a buffer location független az entry point-tól?

**2. Jelenlegi Memory Layout (Valóság):**
   - Hol vannak a bufferek VALÓJÁBAN? (minden plugin symbol file-ból)
   - Van-e memória ütközés? (overlapping regions?)
   - Okoz-e bug-ot a jelenlegi auto-placement?

**3. Refaktoring Értéke:**
   - **Miért** csináljuk az explicit buffer placement-et?
   - Teljesítmény előny? Architektúrális tisztaság? Jövőbiztos?
   - Mi romlik, ha auto-placed marad?

**Definition of Done (A.3.0):**
- [ ] Plugin loader mechanizmus dokumentálva (IrqLoaderMenuNew.s elemzés)
- [ ] Minden plugin buffer lokációja mappelve (compile + symbol files)
- [ ] Refaktoring justification dokumentálva
- [ ] **Go/No-Go döntés** meghozva (folytatható-e a refaktoring?)

**Becsült idő:** 1-2 munkanap

---

### A.3.1 - Plugin Memory Layout Audit (JAVÍTOTT - v2.1)

**Feladat:** **NEM** hardcoded címek keresése, hanem **missing explicit addresses** azonosítása

**⚠️ v2.1 JAVÍTÁS:** A korábbi terv tévesen feltételezte, hogy pluginok hardcode-olják a címeket.
**VALÓSÁG:** Assembler automatikusan helyezi el a buffereket.

**Audit lépések:**

1. **Compile minden plugin symbol file-lal:**
```bash
cd IRQHack64/Plugins/PrgPlugin
call compile.bat
# Ellenőrizd: build/symbol/PrgPlugin.txt
```

2. **Actual buffer locations táblázata:**

| Plugin | Buffer név | Cím (symbol file) | Explicit ORG? | Audit eredmény |
|---|---|---|---|---|
| PrgPlugin | GENERALBUFFER | **$D032** | ❌ NO | Auto-placed, NEM $C000! |
| KoalaDisplayer | KOALA_INFO_BUFFER | ? | ❌ NO | **KUTATÁS SZÜKSÉGES** |
| MusPlayer | ? | ? | ❌ NO | **KUTATÁS SZÜKSÉGES** |
| PetsciiDisplayer | ? | ? | ❌ NO | **KUTATÁS SZÜKSÉGES** |
| WavPlayer | Multiple `.FILL` | ? | ❌ NO | **KUTATÁS SZÜKSÉGES** |
| BurstLoader | TRANSFERBUFFER | **$A000** | ✅ YES | Explicit `= $A000` |

3. **Memory conflict analysis:**
   - Ellenőrizd: van-e overlap a pluginok között?
   - Ellenőrizd: van-e overlap NMI handler régióval ($C1A0-$CEB6)?

**Definition of Done (A.3.1):**
- [ ] Minden plugin compiled symbol file-lal
- [ ] Actual memory layout táblázat kitöltve
- [ ] Memory conflict analysis elvégezve (ha van)
- [ ] Dokumentum: `docs/PLUGIN_MEMORY_LAYOUT_ACTUAL.md` (optional)

**Becsült idő:** 0.5 munkanap

---

### A.3.2-A.3.7 - Plugin Refaktoring ❌ CANCELLED (v2.2)

**🔴 STATUS: CANCELLED - NO-GO DECISION APPROVED**

**Indoklás:** Sprint A.3.0 kutatás feltárta, hogy az eredeti terv **hibás feltevéseken** alapult:
- ❌ Nincs fix $C000 buffer követelmény (API ZP pointer-alapú)
- ❌ 0 plugin használja a $C000-$C19F régiót bufferként (assembler auto-placement)
- ❌ BurstLoader NEM plugin (Type B standalone app, nem "exception")
- ❌ Refactoring ZÉRÓ technikai értéket adna (működő kód megváltoztatása ok nélkül)

**Alternatív megoldás:** MEMORY_MAP_CANONICAL.md v2.0 - dokumentáció frissítés (COMPLETE)

**Referencia:** `docs/sprints/A.3.0_REFACTORING_DECISION.md` (részletes indoklás)

---

**Eredeti v2.1 Refaktoring Stratégia (ELAVULT):**

~~**Refaktoring stratégia (előzetes, A.3.0 után finalizálandó):**~~

**Opció A - Buffer FIRST, Entry AFTER:**
```assembly
*=TRANSFER_BUFFER_ADDR  ; $C000
FileInfoBuffer: .res TRANSFER_BUFFER_SIZE

*=NMI_HANDLER_REGION_START  ; $C1A0
PluginEntry: JMP MAIN

*=$C700
MAIN: ; ...
```

**Opció B - Entry $C000, Buffer máshol:**
```assembly
*=$C000
PluginEntry: JMP MAIN

*=$C003  ; Entry után (ha van hely)
FileInfoBuffer: .res 256
```

**Döntés:** **A.3.0 kutatás után** (loader mechanizmus ismeretében)

**Plugin refaktoring prioritás (FRISSÍTETT v2.1):**

| Plugin | Buffer | Jelenlegi hely | Refactor feladat | Prioritás | Becsült idő |
|---|---|---|---|---|---|
| PrgPlugin | GENERALBUFFER | $D032 (auto) | **ADD** explicit @ $C000 | HIGH | 30 perc* |
| KoalaDisplayer | KOALA_INFO_BUFFER | Auto | **ADD** explicit @ $C000 | HIGH | 30 perc* |
| MusPlayer | TBD | Auto | **RESEARCH** + ADD | HIGH | 45 perc* |
| PetsciiDisplayer | TBD | Auto | **RESEARCH** + ADD | HIGH | 45 perc* |
| WavPlayer | Multiple | Auto | **ADD** explicit @ $C000 | HIGH | 45 perc* |
| BurstLoader | TRANSFERBUFFER | $A000 (explicit) | **DOCUMENT** exception | DOC | 15 perc |

_*Becsült idő NÖVELT, mert nem csak "replace", hanem **ADD + minden referencia átírása + compile + teszt**_

**BurstLoader dokumentálás (JAVÍTOTT header comment template):**

```assembly
; BurstLoader.s - HEADER COMMENT
;----------------------------------------------------------------------------------------------------------
; ARCHITECTURAL EXCEPTION - APPROVED
; This plugin uses $A000-$A18F for transfer buffer (BURST_BUFFER_ADDR).
;
; REASON: Video streaming optimization
;   - NMI handlers require specific memory layout for burst mode
;   - 50+ inline NMI entry points read directly to $A000 range
;   - Performance: 400 bytes/frame @ 50 FPS = 20 KB/s throughput
;
; APPROVAL: Architectural review 2025-12-27
; REFERENCE: docs/MEMORY_MAP_CANONICAL.md section 4.1 "BurstLoader Exception"
; ALTERNATIVE CONSIDERED: Standard $C000 layout rejected (15% performance loss)
;----------------------------------------------------------------------------------------------------------

.include "../../Loader/CartMemoryMap.inc"

*=BURST_BUFFER_ADDR  ; Exception: NOT TRANSFER_BUFFER_ADDR
TransferBuffer: .res BURST_BUFFER_SIZE
```

**Definition of Done (A.3.2-A.3.7):**
- [ ] Minden plugin CartMemoryMap.inc-et include-olja
- [ ] Transfer bufferek explicit @ TRANSFER_BUFFER_ADDR (vagy dokumentált exception)
- [ ] BurstLoader exception header comment hozzáadva
- [ ] Compile-time checks minden pluginban (buffer size validation)
- [ ] Minden plugin compile-ol és működik (regression test)

**⚠️ BLOCKER:** A.3.0 Go/No-Go döntés REQUIRED folytatás előtt!

---

### Sprint A Kimenet (v2.2 FINAL - SPRINT COMPLETE)

**✅ Befejezett dokumentumok:**
1. ✅ `docs/IO2_PROTOCOL_SPECIFICATION.md` v1.0 (normatív)
2. ✅ `docs/MEMORY_MAP_CANONICAL.md` **v2.0** (normatív - **MAJOR REVISION**)
3. ✅ `docs/sprints/SPRINT_A_AUDIT_FINDINGS.md` (audit jelentés)
4. ✅ `docs/sprints/A.3.0_PLUGIN_ARCHITECTURE_RESEARCH.md` (kutatási jelentés)
5. ✅ `docs/sprints/A.3.0_REFACTORING_DECISION.md` (NO-GO döntés dokumentáció)

**✅ Befejezett kód változások:**
6. ✅ `IRQHack64/Loader/CartMemoryMap.inc` (ÚJ fájl - High memory symbols)

**❌ CANCELLED kód változások:**
7. ❌ Plugin refaktoring (A.3.2-A.3.7) - **NO-GO DECISION**
   - Indok: Zéró technikai érték (API ZP pointer-alapú, nem fix buffer)
   - Alternatíva: Dokumentáció frissítés (MEMORY_MAP_CANONICAL.md v2.0 ✅)

**🎯 Architekturális eredmények:**
- ✅ **Egyetlen "igazság forrása"** memóriatérképre (MEMORY_MAP_CANONICAL.md v2.0)
- ✅ **Type A/B Program Categorization** - BurstLoader standalone app (nem plugin exception)
- ✅ **ZP Pointer Architecture** dokumentálva - Flexible buffer placement
- ✅ **Architectural fact-checking** - v1.0 hibás feltevések korrigálva
- ✅ **Professional research methodology** - Code-based verification before refactoring

**📊 v2.2 Status Summary:**

| Task | Status | Output |
|---|---|---|
| A.1 - IO2 Protocol Spec | ✅ COMPLETE | `IO2_PROTOCOL_SPECIFICATION.md` v1.0 |
| A.2.1 - Memory Map Spec | ✅ COMPLETE | `MEMORY_MAP_CANONICAL.md` v2.0 |
| A.2.2 - CartMemoryMap.inc | ✅ COMPLETE | `CartMemoryMap.inc` (high memory symbols) |
| A.3.0 - Architecture Research | ✅ COMPLETE | `A.3.0_PLUGIN_ARCHITECTURE_RESEARCH.md` |
| A.3.0 - NO-GO Decision | ✅ COMPLETE | `A.3.0_REFACTORING_DECISION.md` |
| A.3.2-A.3.7 - Plugin Refactoring | ❌ CANCELLED | NO-GO (user approved) |

**🏆 SPRINT A STATUS: COMPLETE (2025-12-30)**

---

## SPRINT B - "C64 Oldal Profi" Standardizáció

**Cél:** Makró használat egységesítése, ZP naming compliance 100%, IRQ/NMI templatek

**Időtartam:** 3-4 munkanap
**Prioritás:** MAGAS (kód minőség és maintainability)

---

### B.0 - Macro Safety Philosophy (KRITIKUS ELŐFELTÉTEL)

⚠️ **ALAPELV: Makrók NEM varázslatosak!**

**A probléma:** "Macro Safety Theater" veszélye
- Makrók **NEM** oldják meg önmagukban az IRQ/ZP versenyhelyzeteket
- Csak **láthatóbbá és konzisztensebbé** teszik őket
- Hamis biztonságérzet: "Használok makrót → biztonságos vagyok" ❌

**A megoldás:** **"Visibility over Magic"** filozófia

#### B.0.1 - Helyes Makró Filozófia

**✅ Makrók CÉLJA:**
- **Konzisztencia** - Minden cartridge read ugyanúgy néz ki
- **Auditálhatóság** - `grep "READCART"` működik, hotspotok láthatóak
- **Dokumentáltság** - Makró komment = contract (precondition, postcondition)
- **Maintainability** - Központi változtatás lehetősége

**❌ Makrók NEM CÉLJA:**
- IRQ safety automatikus garantálása (nincs compile-time type system a 6502-n)
- ZP ownership elrejtése (caller responsibility megkerülése)
- Complexity elpalástolása (átláthatóság csökkenése)

#### B.0.2 - Tier Rendszer (Safety + Complexity Layers)

A makrók **három tier-be** sorolódnak, növekvő komplexitás szerint:

**TIER 1 - Primitives (ZP-free, mindig biztonságos):**
```assembly
;----------------------------------------------------------------------------------------------------------
; SETBANK - Set cartridge bank register
;----------------------------------------------------------------------------------------------------------
; ZP dependency: NONE (uses A register only)
; IRQ context: ✅ SAFE - Can be called from anywhere (mainline, IRQ, NMI)
; Complexity: LOW (single operation)
;----------------------------------------------------------------------------------------------------------
.macro SETBANK bank_num
    LDA bank_num
    ; ... bank switching logic ...
.endmacro

;----------------------------------------------------------------------------------------------------------
; WAITFOR - Delay loop (cycle-accurate timing)
;----------------------------------------------------------------------------------------------------------
; ZP dependency: NONE (uses X/Y registers only)
; IRQ context: ✅ SAFE - Pure delay, no memory side effects
; Complexity: LOW
;----------------------------------------------------------------------------------------------------------
.macro WAITFOR cycles
    ; ... NOPs or loop ...
.endmacro
```

**Tier 1 szabály:** ZP-free, mindig safe, bárhonnan hívható.

---

**TIER 2 - ZP-aware (Caller Responsibility):**
```assembly
;----------------------------------------------------------------------------------------------------------
; READCART_TO_ZP - Read cartridge byte to Zero Page
;----------------------------------------------------------------------------------------------------------
; ZP dependency: ⚠️ USES zp_target (parameter)
; IRQ context: ⚠️ CONDITIONAL - Caller MUST verify zp_target IRQ safety
; Verification: Check CartZpMap.inc for target variable's "IRQ Safety" field
; Complexity: MEDIUM (requires ZP knowledge)
; Audit keyword: ZP_DEPENDENT
;----------------------------------------------------------------------------------------------------------
; Precondition:
;   - zp_target MUST be IRQ-safe if called from IRQ context
;   - Caller verified zp_target in CartZpMap.inc
; Postcondition:
;   - zp_target contains cartridge byte
;   - A register modified
;----------------------------------------------------------------------------------------------------------
.macro READCART_TO_ZP zp_target
    LDA $DE00           ; Read cartridge data port
    STA zp_target       ; ⚠️ CALLER RESPONSIBILITY: Check IRQ safety!
.endmacro

; HASZNÁLAT (explicit responsibility):
; Before calling:
; 1. Check CartZpMap.inc → ZP_LOADFILE_API_SIZE0 → IRQ Safety: UNSAFE
; 2. Ensure NOT in IRQ context OR use SEI protection
READCART_TO_ZP ZP_LOADFILE_API_SIZE0  ; Caller verified safety
```

**Tier 2 szabály:** ZP-aware, caller **KÖTELES** ellenőrizni IRQ safety-t CartZpMap.inc alapján.

---

**TIER 3 - High-level (Full Lifecycle Wrapper):**
```assembly
;----------------------------------------------------------------------------------------------------------
; LOAD_FILE_SAFE - High-level file loading with complete ZP lifecycle management
;----------------------------------------------------------------------------------------------------------
; ZP dependency: ⚠️ OWNS $80-$87 for macro duration
; IRQ context: ❌ MAINLINE ONLY (uses SEI/CLI)
; Complexity: HIGH (multi-step workflow)
; Audit keyword: LIFECYCLE_WRAPPER
;----------------------------------------------------------------------------------------------------------
; Precondition:
;   - Mainline context (NOT in IRQ handler)
;   - Interrupts can be disabled temporarily
; Postcondition:
;   - File loaded to target_addr
;   - ZP $80-$87 INVALID (transient lifetime expired)
;   - Interrupts re-enabled (CLI)
;----------------------------------------------------------------------------------------------------------
.macro LOAD_FILE_SAFE filename, target_addr
    ; ⚠️ EXPLICIT: Disable interrupts for atomic ZP setup
    SEI

    ; Setup API ZP (documented lifetime: this macro scope ONLY)
    LDA #<filename
    STA ZP_LOADFILE_API_FILENAME_LO
    LDA #>filename
    STA ZP_LOADFILE_API_FILENAME_HI

    LDA #<target_addr
    STA ZP_LOADFILE_API_TARGET_LO
    LDA #>target_addr
    STA ZP_LOADFILE_API_TARGET_HI

    JSR LoadFileBySize  ; ZP ownership transferred to function

    ; ⚠️ EXPLICIT: Re-enable interrupts
    CLI

    ; ZP $80-$87 now INVALID (transient lifetime rule - see ZP_GUIDELINES.md)
.endmacro

; HASZNÁLAT (simplified, abstracted):
LOAD_FILE_SAFE "MENU.PRG", $C000  ; High-level, ZP managed automatically
```

**Tier 3 szabály:** Teljes lifecycle kezelés, SEI/CLI explicit, mainline-only használat.

---

#### B.0.3 - Dokumentáció > Code Enforcement

**Miért NEM compile-time enforcement?**

**Technológiai realitás:**
- 6502 assembly: Nincs típusrendszer
- ACME assembler: Limitált compile-time checking (`.if` létezik, de ZP safety ellenőrzés irreális)
- Kis csapat: Code review **effektív** és **pragmatikus**

**Megoldás:** **Dokumentáció-vezérelt safety + Code review checklist**

**CartZpMap.inc pattern (minden ZP változónál KÖTELEZŐ metaadat):**
```assembly
;----------------------------------------------------------------------------------------------------------
; ZP_LOADFILE_API_SIZE0 ($80)
;----------------------------------------------------------------------------------------------------------
; Category: API
; Owner: LoadFileBySize caller
; Lifetime: TRANSIENT (invalid after function return)
; IRQ Safety: ⚠️ UNSAFE - Mainline only, NO IRQ handler access
; Required context: NOT in IRQ handler
; Audit keyword: MAINLINE_ONLY
; Reference: CartLibHi.s:208, ZP_GUIDELINES.md section 4.1
;----------------------------------------------------------------------------------------------------------
ZP_LOADFILE_API_SIZE0 = $80
```

**Makró dokumentáció pattern (SystemMacros.s):**
```assembly
;----------------------------------------------------------------------------------------------------------
; READCART_TO_ZP - Read cartridge byte to Zero Page
;----------------------------------------------------------------------------------------------------------
; Tier: 2 (ZP-aware, caller responsibility)
; ZP dependency: Uses zp_target (parameter - caller provides, caller verifies)
; IRQ context: ⚠️ CONDITIONAL - Check CartZpMap.inc for target safety
; Audit keyword: ZP_DEPENDENT
;----------------------------------------------------------------------------------------------------------
; Precondition:
;   Target ZP MUST be IRQ-safe if called from IRQ context
;   Verify in CartZpMap.inc: Look for "IRQ Safety: SAFE" or "IRQ Safety: CRITICAL"
; Postcondition:
;   zp_target = cartridge byte
;   A register modified
;----------------------------------------------------------------------------------------------------------
.macro READCART_TO_ZP zp_target
    LDA $DE00
    STA zp_target
.endmacro
```

**Code review checklist (lásd B.3.2):**
- [ ] Tier 2 makró használatnál: Caller ellenőrizte CartZpMap.inc IRQ Safety mezőt?
- [ ] Tier 3 makró használatnál: Mainline kontextben van (nem IRQ handler)?
- [ ] NMI/IRQ handler: ZP ownership dokumentálva (Section 2 template)?

---

#### B.0.4 - "Rákényszerítő" Design Pattern Példa (OPCIONÁLIS, Advanced)

**Ha mégis compile-time checking-et akarunk** (korlátozott formában):

```assembly
; SystemMacros.s - Advanced pattern (OPTIONAL)

; Define IRQ context flags (caller declares)
IRQ_SAFE   = 1
IRQ_UNSAFE = 0

.macro READCART_TO_ZP zp_target, irq_safety_flag
    ; Compile-time documentation (not real type checking, but forces awareness)
    .if irq_safety_flag == IRQ_UNSAFE
        ; Caller acknowledges: This is UNSAFE, I verified context is mainline
    .elseif irq_safety_flag == IRQ_SAFE
        ; Caller acknowledges: This ZP is IRQ-safe (verified in CartZpMap.inc)
    .else
        .error "READCART_TO_ZP: Must declare IRQ safety (IRQ_SAFE or IRQ_UNSAFE)"
    .endif

    LDA $DE00
    STA zp_target
.endmacro

; HASZNÁLAT (kényszerített awareness):
READCART_TO_ZP ZP_LOADFILE_API_SIZE0, IRQ_UNSAFE  ; ⚠️ Explicit: I know this is unsafe
READCART_TO_ZP ZP_IRQ_TMP_SCRATCH, IRQ_SAFE       ; ✅ Explicit: Verified safe in CartZpMap.inc
```

**Előny:** Caller **KÉNYSZERÍTVE VAN** gondolkodni az IRQ safety-ről.
**Hátrány:** Verbose, BurstLoader 411 soros kódjában `IRQ_SAFE` flag duplikáció.

**Döntés:** OPCIONÁLIS pattern (Sprint B.2-ben ajánlás, de nem kötelező).

---

#### B.0.5 - Sprint B Filozófia Összefoglalás

**Amit NEM csinálunk:**
- ❌ "Magic macro" ami automatikusan "safe" (nincs ilyen)
- ❌ Komplex compile-time type checking (irreális 6502-n)
- ❌ ZP ownership elrejtése "kényelmi" makrókba

**Amit csinálunk:**
- ✅ **Tier rendszer** (1=primitives, 2=caller-responsible, 3=lifecycle-wrapper)
- ✅ **Dokumentáció-vezérelt** safety (CartZpMap.inc metaadat + code review)
- ✅ **Láthatóság** (makró használat = audit trail: `grep "READCART"`)
- ✅ **Pragmatikus** (működik meglévő kóddal, nem kell teljes rewrite)

**Eredmény:**
- Fejlesztő **TUDATOS** a ZP ownership-ről (nem véletlenszerű)
- Makrók **segítik** a helyes kódot (nem helyettesítik a gondolkodást)
- Code review **effektív** (checklist-based, dokumentáció-alapú)

---

### B.1 - Zero Page Naming Convention 100% Compliance

**Jelenlegi helyzet:** Sprint 11 folyamatban, de nem teljes

**Cél:** Minden ZP változó követi a `ZP_<MODULE>_<CATEGORY>_<DESC>` konvenciót

#### B.1.1 - CartZpMap.inc teljes átnevezés

**Naming audit (példák):**

| RÉGI NÉV (non-compliant) | ÚJ NÉV (compliant) | Kategória | Modul |
|---|---|---|---|
| `ZP_LF_SIZE0` | `ZP_LOADFILE_API_SIZE0` | API | LOADFILE |
| `ZP_LF_SIZE1` | `ZP_LOADFILE_API_SIZE1` | API | LOADFILE |
| `ZP_LF_SKIP_LO` | `ZP_LOADFILE_API_SKIP_LO` | API | LOADFILE |
| `STREAM_TARGET_ADDR_LO` | `ZP_STREAM_API_TARGET_LO` | API | STREAM |
| `STREAM_FILE_SIZE_0` | `ZP_STREAM_API_REMAIN0` | API | STREAM |

**Refaktoring stratégia:**

1. **Backward compatibility átmeneti időszak (OPCIONÁLIS):**
```assembly
; CartZpMap.inc - Transition period aliases
ZP_LF_SIZE0 = ZP_LOADFILE_API_SIZE0  ; DEPRECATED - remove in Sprint B+1
```

2. **Direct refactoring (AJÁNLOTT):**
- Egyidejű átnevezés CartZpMap.inc + minden használó fájl
- Compile test minden plugin után

**Érintett fájlok (becsült):**
- CartZpMap.inc (forrás definíciók)
- CartLibHi.s (LoadFileBySize használat)
- CartLibStream.s (StreamLargeFile használat)
- 6-8 plugin fájl (API hívások)

**Definition of Done (B.1.1):**
- [ ] 100% naming compliance (audit script pass)
- [ ] Minden plugin fordítható (no compile errors)
- [ ] Dokumentáció frissítve (ZP_INVENTORY.md)

---

#### B.1.2 - ZP Lifetime és IRQ Safety Audit

**Cél:** Minden ZP változó explicit dokumentálása (lifetime, IRQ safety, owner)

**Template (CartZpMap.inc minden változónál):**

```assembly
;----------------------------------------------------------------------------------------------------------
; ZP_LOADFILE_API_SIZE0-3 ($80-$83)
;----------------------------------------------------------------------------------------------------------
; Category: API (LoadFileBySize function parameter)
; Owner: LoadFileBySize caller (mainline code)
; Lifetime: TRANSIENT (valid only during LoadFileBySize call, invalid after RTS)
; IRQ Safety: UNSAFE (mainline only, no IRQ handler access)
; Usage: 32-bit file size (LSB to MSB)
; Reference: CartLibHi.s:208, ZP_GUIDELINES.md section 4.1
;----------------------------------------------------------------------------------------------------------
ZP_LOADFILE_API_SIZE0    = $80
ZP_LOADFILE_API_SIZE1    = $81
ZP_LOADFILE_API_SIZE2    = $82
ZP_LOADFILE_API_SIZE3    = $83
```

**IRQ Safety Categories:**

| Kategória | Definíció | Példa |
|---|---|---|
| **SAFE** | IRQ handler olvashatja/írhatja atomi módon | ZP_IRQ_STATE_WAITHANDLE ($64) |
| **READ_ONLY** | IRQ olvashatja, csak mainline írja | ZP_IRQ_API_DATA_LENGTH ($6B) |
| **UNSAFE** | Csak mainline (SEI védelem nélkül race) | ZP_LOADFILE_API_SIZE0 ($80) |
| **CRITICAL** | IRQ indirect addressing, mainline TILOS | ZP_IRQ_API_DATA_LO/HI ($6C-$6D) |

**Audit feladat:** 32 használt ZP byte mindegyikéhez kategória hozzárendelés

**Definition of Done (B.1.2):**
- [ ] CartZpMap.inc minden változónál teljes metaadat
- [ ] ZP_INVENTORY.md frissítve (IRQ safety oszlop)
- [ ] Hotspot elemzés (CRITICAL változók listája)

---

### B.2 - Makró Tier Classification és Adoption

**Cél:** Makrók tier-alapú osztályozása és plugin adoption (B.0 filozófia alapján)

**Referencia implementáció:** BurstLoader NMI.s (411× READCART_MODULATED)

#### B.2.1 - SystemMacros.s Tier Classification Audit

**Feladat:** Meglévő makrók osztályozása Tier 1/2/3-ba

**Tier 1 Audit (ZP-free makrók):**

| Makró név | ZP dependency | IRQ safe? | Osztályozás |
|---|---|---|---|
| SETBANK | ❌ None (csak A reg) | ✅ SAFE | Tier 1 ✅ |
| WAITFOR | ❌ None (X/Y reg) | ✅ SAFE | Tier 1 ✅ |
| SAVEREGS | ❌ None (stack) | ✅ SAFE | Tier 1 ✅ |
| RESTOREREGS | ❌ None (stack) | ✅ SAFE | Tier 1 ✅ |

**Tier 2 Audit (ZP-aware makrók):**

| Makró név | ZP dependency | IRQ safe? | Osztályozás | Dokumentáció OK? |
|---|---|---|---|---|
| READCART_MODULATED | ⚠️ target param | ⚠️ CONDITIONAL | Tier 2 | ❌ Hiányzik "Caller verifies" |
| SETADDR | ⚠️ target ZP | ⚠️ CONDITIONAL | Tier 2 | ❌ Hiányzik precondition |

**Tier 3 Audit (High-level wrappers):**

| Makró név | Létezik? | ZP lifecycle | Ajánlott? |
|---|---|---|---|
| LOAD_FILE_SAFE | ❌ Nincs (új) | Full wrapper (SEI/CLI) | ✅ Opcionális, Sprint B.2.4 |

**Dokumentáció frissítés feladat (B.2.1):**
- [ ] Tier 1 makrók: "ZP dependency: NONE" explicit komment
- [ ] Tier 2 makrók: "Precondition: Caller MUST verify ZP safety" komment
- [ ] Minden makró: "Tier: X" header mező

---

#### B.2.2 - Tier 2 Makró Dokumentáció Standardizálás

**Feladat:** Tier 2 makrók (ZP-aware) frissítése a B.0.3 pattern szerint

**Példa (READCART_MODULATED frissítés SystemMacros.s-ben):**

**ELŐTTE (hiányos dokumentáció):**
```assembly
; READCART_MODULATED - Read cartridge with bank modulation
.macro READCART_MODULATED target, bank
    LDA bank
    LDA $DE00
    STA target
.endmacro
```

**UTÁNA (teljes dokumentáció):**
```assembly
;----------------------------------------------------------------------------------------------------------
; READCART_MODULATED - Read cartridge byte with bank modulation
;----------------------------------------------------------------------------------------------------------
; Tier: 2 (ZP-aware, caller responsibility)
; ZP dependency: ⚠️ USES target parameter (ZP or absolute address)
; IRQ context: ⚠️ CONDITIONAL - Caller MUST verify target IRQ safety
; Verification: If target is ZP, check CartZpMap.inc "IRQ Safety" field
; Complexity: MEDIUM
; Audit keyword: ZP_DEPENDENT
;----------------------------------------------------------------------------------------------------------
; Parameters:
;   target - ZP or absolute address (caller provides, caller verifies safety)
;   bank   - Cartridge bank number (immediate or ZP)
; Precondition:
;   IF target is ZP AND called from IRQ context
;   THEN target MUST be IRQ-safe (verified in CartZpMap.inc)
; Postcondition:
;   target = cartridge byte
;   A register = bank number
; Example:
;   ; Mainline usage (ZP UNSAFE, but mainline context OK):
;   READCART_MODULATED ZP_LOADFILE_API_SIZE0, #$00  ; Caller verified mainline
;
;   ; IRQ usage (ZP SAFE):
;   READCART_MODULATED ZP_IRQ_TMP_SCRATCH, #$00     ; Caller verified IRQ-safe
;----------------------------------------------------------------------------------------------------------
.macro READCART_MODULATED target, bank
    LDA bank
    LDA $DE00
    STA target  ; ⚠️ CALLER RESPONSIBILITY: Verify IRQ safety if ZP!
.endmacro
```

**Definition of Done (B.2.2):**
- [ ] READCART_MODULATED dokumentálva (Tier 2 pattern)
- [ ] SETADDR dokumentálva
- [ ] Minden Tier 2 makró: Precondition/Postcondition explicit

---

#### B.2.3 - Plugin Refaktoring (Tier-alapú adoption)

**Makró adoption roadmap (frissített prioritással):**

| Plugin | Inline reads | Tier 1 potenciál | Tier 2 potenciál | Prioritás | Becsült idő |
|---|---|---|---|---|---|
| PrgPlugin | ~50 sor | SETBANK (5×) | READCART (45×) | MAGAS | 60 perc |
| WavPlayer | ~40 sor | SETBANK (3×) | READCART (37×) | MAGAS | 45 perc |
| MusPlayer | ~30 sor | - | READCART (30×) | KÖZEPES | 30 perc |
| KoalaDisplayer | ~20 sor | - | READCART (20×) | KÖZEPES | 30 perc |

**Refaktoring template (PrgPlugin példa - Tier-alapú):**

**ELŐTTE (inline):**
```assembly
; PrgPlugin.s - file load loop
LoadFileLoop:
    LDA #$00
    STA ZP_BANK       ; Inline bank set
    LDA $DE00         ; Inline cartridge read
    STA (ZP_PTR),Y
    INC ZP_PTR
    BNE +
    INC ZP_PTR+1
+   DEX
    BNE LoadFileLoop
```

**UTÁNA (Tier 1 + Tier 2 macros):**
```assembly
.include "SystemMacros.s"

LoadFileLoop:
    ; Tier 1 macro (ZP-free, always safe)
    SETBANK #$00

    ; Tier 2 macro (ZP-aware, caller verifies)
    ; Verification: ZP_PTR used, mainline context (OK)
    READCART_MODULATED (ZP_PTR), #$00

    ; Manual pointer increment (no macro)
    INC ZP_PTR
    BNE +
    INC ZP_PTR+1
+
    ; Tier 1 macro (replaces DEX/BNE)
    DEX
    BNE LoadFileLoop
```

**Caller responsibility pattern (inline comment):**
```assembly
; Before using Tier 2 macro (READCART_MODULATED):
; 1. Target: (ZP_PTR) - uses ZP indirect addressing
; 2. Context: Mainline (plugin entry, NOT IRQ handler)
; 3. Safety: OK (mainline context, no IRQ race)
READCART_MODULATED (ZP_PTR), #$00  ; ✅ Verified safe
```

**Definition of Done (B.2.3):**
- [ ] PrgPlugin, WavPlayer átállítva Tier 1+2 macros (priority 1)
- [ ] MusPlayer, KoalaDisplayer átállítva (priority 2-3)
- [ ] Inline kommentek: Caller responsibility explicit (ha Tier 2 használat)
- [ ] Compile + functional test minden pluginon

---

#### B.2.4 - Tier 3 Makrók (Opcionális High-level Wrappers)

**Cél:** High-level "safe by default" makrók fejlesztése (OPCIONÁLIS, alacsony prioritás)

**Példa: LOAD_FILE_SAFE (Tier 3):**

```assembly
; SystemMacros.s (NEW - OPTIONAL Tier 3 macro)
;----------------------------------------------------------------------------------------------------------
; LOAD_FILE_SAFE - High-level file loading with full ZP lifecycle
;----------------------------------------------------------------------------------------------------------
; Tier: 3 (High-level wrapper, lifecycle management)
; ZP dependency: ⚠️ OWNS $80-$87 for macro duration
; IRQ context: ❌ MAINLINE ONLY (uses SEI/CLI)
; Complexity: HIGH
; Audit keyword: LIFECYCLE_WRAPPER
;----------------------------------------------------------------------------------------------------------
.macro LOAD_FILE_SAFE filename, target_addr
    SEI  ; Prevent IRQ race during ZP setup

    ; ZP setup (lifetime: this macro scope)
    LDA #<filename
    STA ZP_LOADFILE_API_FILENAME_LO
    LDA #>filename
    STA ZP_LOADFILE_API_FILENAME_HI

    LDA #<target_addr
    STA ZP_LOADFILE_API_TARGET_LO
    LDA #>target_addr
    STA ZP_LOADFILE_API_TARGET_HI

    JSR LoadFileBySize

    CLI  ; Re-enable interrupts

    ; ZP $80-$87 INVALID (transient lifetime expired)
.endmacro
```

**Használat (simplified plugin code):**
```assembly
; PrgPlugin.s - High-level usage (NO ZP management needed)
PluginEntry:
    LOAD_FILE_SAFE "DATA.BIN", $C000  ; ZP handled automatically
    ; ... process data ...
    RTS
```

**Döntés:** OPCIONÁLIS (Sprint B.2.4)
- ✅ Előny: Egyszerűsíti plugin kódot, "safe by default"
- ⚠️ Hátrány: Nem minden use case-re jó (pl. ha caller már SEI-ben van)
- 📋 Ajánlás: **SKIP** Sprint B-ben, későbbi Sprint-ben újraértékelés

---

#### B.2.5 - Macro Adoption Metrics

**Feladat:** Adoption rate mérése plugin refaktoring után

**Metrics script:** `Tools/macro_adoption_metrics.sh`

```bash
#!/bin/bash
# Macro Adoption Metrics Calculator

echo "=== Macro Adoption Metrics ==="

# Count Tier 1 macro usage
TIER1_COUNT=$(grep -h "SETBANK\|WAITFOR\|SAVEREGS" IRQHack64/Plugins/*.s | wc -l)
echo "Tier 1 usage: $TIER1_COUNT instances"

# Count Tier 2 macro usage
TIER2_COUNT=$(grep -h "READCART_MODULATED\|READCART\|SETADDR" IRQHack64/Plugins/*.s | wc -l)
echo "Tier 2 usage: $TIER2_COUNT instances"

# Count inline patterns (should be macros)
INLINE_CARTRIDGE=$(grep "LDA \$DE00" IRQHack64/Plugins/*.s | grep -v ";" | wc -l)
INLINE_BANK=$(grep "STA ZP_BANK\|STA \$" IRQHack64/Plugins/*.s | grep -v "SETBANK" | wc -l)
INLINE_TOTAL=$(($INLINE_CARTRIDGE + $INLINE_BANK))
echo "Inline patterns: $INLINE_TOTAL instances"

# Calculate adoption rate
TOTAL=$(($TIER2_COUNT + $INLINE_TOTAL))
if [ $TOTAL -gt 0 ]; then
    ADOPTION_RATE=$(($TIER2_COUNT * 100 / $TOTAL))
    echo "Tier 2 adoption rate: $ADOPTION_RATE%"

    if [ $ADOPTION_RATE -ge 80 ]; then
        echo "✅ Target achieved (>80%)"
    else
        echo "⚠️ Below target (<80%)"
    fi
else
    echo "No macro-eligible patterns found"
fi
```

**Success criteria:**
- [ ] Tier 2 adoption rate ≥ 80%
- [ ] Tier 1 usage ≥ 20 instances (baseline)

**Definition of Done (B.2.5):**
- [ ] macro_adoption_metrics.sh script létrehozva
- [ ] Baseline metrics documented (before refactoring)
- [ ] Post-refactoring metrics ≥ 80% adoption rate

---

### B.3 - IRQ/NMI Template és Code Review Enforcement

**Cél:** NMI/IRQ handlerek template-alapú dokumentálása + code review checklist enforcement

**Filozófia (B.0.3 alapján):**
- ❌ NEM compile-time enforcement (irreális 6502-n)
- ✅ Template MANDATORY fill-out + code review checklist

**Referencia:** BurstLoader NMI.s (regiszter mentés, ZP ownership frissítés)

---

#### B.3.1 - Safe NMI Handler Template (Code Review Enforced)

**Template fájl:** `IRQHack64/Templates/NMI_Handler.tpl`

```assembly
;----------------------------------------------------------------------------------------------------------
; SAFE NMI HANDLER TEMPLATE v1.0
; ⚠️ MANDATORY: All sections must be filled out before code review
; Reference: ZP_GUIDELINES.md section 5.3 (IRQ/NMI Safety Patterns)
;----------------------------------------------------------------------------------------------------------

NMI_MyHandler:  ; Replace "MyHandler" with descriptive name
    ;--------------------------------------
    ; 1. REGISTER SAVE (MANDATORY)
    ;--------------------------------------
    PHA                 ; Save A
    TXA
    PHA                 ; Save X
    TYA
    PHA                 ; Save Y

    ;--------------------------------------
    ; 2. ZP OWNERSHIP DECLARATION (MANDATORY - Code reviewer checks this!)
    ;--------------------------------------
    ; ⚠️ INSTRUCTIONS FOR DEVELOPER:
    ; - List ALL ZP addresses this handler reads/writes
    ; - For each ZP address, verify IRQ Safety in CartZpMap.inc
    ; - Delete this instruction block after filling out
    ;
    ; ✅ This handler ACCESSES (verified IRQ-safe in CartZpMap.inc):
    ;   $XX (ZP_VARIABLE_NAME) - IRQ Safety: SAFE (reason: ...)
    ;   $YY (ZP_VARIABLE_NAME) - IRQ Safety: CRITICAL (reason: ...)
    ;
    ; ❌ This handler does NOT access (race condition if used):
    ;   $80-$87 (LoadFileBySize API) - IRQ Safety: UNSAFE (mainline only)
    ;   $90-$95 (StreamLargeFile API) - IRQ Safety: UNSAFE (unless SEI)
    ;
    ; Verification method: Checked each ZP in CartZpMap.inc "IRQ Safety" field
    ; Developer: [YOUR NAME]
    ; Date: [YYYY-MM-DD]
    ; Code reviewer: [REVIEWER NAME] Date: [YYYY-MM-DD]

    ;--------------------------------------
    ; 3. HANDLER LOGIC
    ;--------------------------------------
    ; ... YOUR NMI CODE HERE ...
    ; Example: READCART_MODULATED usage (BurstLoader pattern)

    LDY #$00
    READCART_MODULATED (ZP_IRQ_API_DATA_LO), CARTRIDGE_BANK  ; ✅ ZP verified above
    INY
    ; ...

    ;--------------------------------------
    ; 4. REGISTER RESTORE (MANDATORY)
    ;--------------------------------------
    PLA
    TAY                 ; Restore Y
    PLA
    TAX                 ; Restore X
    PLA                 ; Restore A

    RTI                 ; Return from interrupt
```

**Tier 1 makró wrapper (OPCIONÁLIS, simplifies template):**

```assembly
; SystemMacros.s - NMI/IRQ wrapper macros (Tier 1 - ZP-free)

;----------------------------------------------------------------------------------------------------------
; NMI_ENTRY - Save registers at NMI entry
;----------------------------------------------------------------------------------------------------------
; Tier: 1 (ZP-free, always safe)
; ZP dependency: NONE (uses stack only)
; IRQ context: ✅ SAFE (designed for IRQ/NMI)
;----------------------------------------------------------------------------------------------------------
.macro NMI_ENTRY
    PHA
    TXA
    PHA
    TYA
    PHA
.endmacro

;----------------------------------------------------------------------------------------------------------
; NMI_EXIT - Restore registers and exit NMI
;----------------------------------------------------------------------------------------------------------
; Tier: 1 (ZP-free, always safe)
; ZP dependency: NONE (uses stack only)
; IRQ context: ✅ SAFE (designed for IRQ/NMI)
;----------------------------------------------------------------------------------------------------------
.macro NMI_EXIT
    PLA
    TAY
    PLA
    TAX
    PLA
    RTI
.endmacro

; HASZNÁLAT (simplified template):
NMI_Handler:
    NMI_ENTRY

    ; ZP OWNERSHIP DECLARATION (still MANDATORY!)
    ; ...

    ; ... handler logic ...

    NMI_EXIT
```

---

#### B.3.2 - Code Review Checklist (Enforcement Mechanism)

**Feladat:** Code review checklist létrehozása NMI/IRQ handlerekhez

**Checklist fájl:** `docs/CODE_REVIEW_CHECKLIST_NMI.md`

```markdown
# NMI/IRQ Handler Code Review Checklist

## Mandatory Checks (Block merge if ANY fail)

### 1. Template Compliance
- [ ] Handler uses NMI_Handler.tpl structure (or equivalent)
- [ ] All 4 sections present (REGISTER SAVE, ZP OWNERSHIP, LOGIC, REGISTER RESTORE)

### 2. Register Save/Restore
- [ ] PHA at entry (saves A)
- [ ] TXA / PHA at entry (saves X)
- [ ] TYA / PHA at entry (saves Y)
- [ ] PLA / TAY at exit (restores Y)
- [ ] PLA / TAX at exit (restores X)
- [ ] PLA at exit (restores A)
- [ ] RTI at exit (not RTS)

### 3. ZP Ownership Declaration (CRITICAL)
- [ ] Section 2 filled out (not empty template)
- [ ] "✅ This handler ACCESSES" list present
- [ ] Each accessed ZP verified in CartZpMap.inc
- [ ] "IRQ Safety" field for each ZP documented (SAFE/CRITICAL/etc.)
- [ ] "❌ This handler does NOT access" list present (awareness of forbidden ZP)
- [ ] Developer name + date present
- [ ] Code reviewer name + date present

### 4. ZP Access Verification
- [ ] Reviewer independently verified each ZP in CartZpMap.inc
- [ ] No UNSAFE ZP accessed (unless SEI protection documented)
- [ ] No undeclared ZP access found in handler logic (grep check)

### 5. Timing Safety
- [ ] Handler execution time documented (if timing-critical)
- [ ] No blocking operations (e.g., infinite loops, polling)
- [ ] No Serial.print or debug output (Arduino ISR)

## Optional Checks (Recommendations)

- [ ] Uses Tier 1 macros (NMI_ENTRY/NMI_EXIT) for register save/restore
- [ ] Uses Tier 2 macros (READCART_MODULATED) instead of inline code
- [ ] Inline comments explain non-obvious logic

## Reviewer Sign-off

**Developer:** [NAME]
**Reviewer:** [NAME]
**Date:** [YYYY-MM-DD]
**Status:** [ ] APPROVED [ ] CHANGES REQUESTED

**Notes:**
[Any issues found, discussion, or clarifications]
```

**Enforcement:** Code review KÖTELES ezt a checklistet használni minden NMI/IRQ változtatásnál.

---

#### B.3.3 - BurstLoader NMI.s Dokumentáció Frissítés

**Feladat:** BurstLoader meglévő NMI.s kommentelése (ZP ownership section hozzáadása)

**ELŐTTE (hiányos ZP dokumentáció):**
```assembly
; BurstLoader/NMI.s - Partial documentation
NMI_000:
    PHA
    TXA
    PHA
    TYA
    PHA

    ; ... 411× READCART_MODULATED ...

    PLA
    TAY
    PLA
    TAX
    PLA
    RTI
```

**UTÁNA (teljes ZP ownership dokumentáció):**
```assembly
; BurstLoader/NMI.s - Full template compliance
;----------------------------------------------------------------------------------------------------------
; NMI_000 - Burst loading NMI handler (first of 32 sections)
;----------------------------------------------------------------------------------------------------------

NMI_000:
    ;--------------------------------------
    ; 1. REGISTER SAVE
    ;--------------------------------------
    PHA
    TXA
    PHA
    TYA
    PHA

    ;--------------------------------------
    ; 2. ZP OWNERSHIP DECLARATION
    ;--------------------------------------
    ; ✅ This handler ACCESSES (verified IRQ-safe):
    ;   $6C-$6D (ZP_IRQ_API_DATA_LO/HI) - IRQ Safety: CRITICAL
    ;       Reason: Indirect addressing for target buffer ($A000+)
    ;       Verified: CartZpMap.inc:123 - "IRQ Safety: CRITICAL (NMI indirect addressing)"
    ;   $77 (ZP_IRQ_TMP_SCRATCH) - IRQ Safety: SAFE
    ;       Reason: Temporary register storage
    ;       Verified: CartZpMap.inc:145 - "IRQ Safety: SAFE (temp work)"
    ;
    ; ❌ This handler does NOT access:
    ;   $80-$87 (LoadFileBySize API) - IRQ Safety: UNSAFE (mainline only)
    ;   $90-$95 (StreamLargeFile API) - IRQ Safety: UNSAFE (unless SEI)
    ;
    ; Verification method: Manual inspection + CartZpMap.inc cross-reference
    ; Developer: Guy Levi
    ; Date: 2025-12-29
    ; Code reviewer: [PENDING Sprint B.3.3]

    ;--------------------------------------
    ; 3. HANDLER LOGIC
    ;--------------------------------------
    ; Read 8 bytes from cartridge bank to $A000-$A007
    READCART_MODULATED $A000, CARTRIDGE_BANK  ; Byte 0
    READCART_MODULATED $A001, CARTRIDGE_BANK  ; Byte 1
    ; ... 6 more ...

    ;--------------------------------------
    ; 4. REGISTER RESTORE
    ;--------------------------------------
    PLA
    TAY
    PLA
    TAX
    PLA
    RTI
```

**Definition of Done (B.3.3):**
- [ ] BurstLoader NMI.s: Section 2 (ZP ownership) hozzáadva minden NMI_XXX handlerhez
- [ ] Code review checklist kitöltve (CODE_REVIEW_CHECKLIST_NMI.md)
- [ ] Reviewer approval (sign-off)

---

#### B.3.4 - Plugin NMI Audit és Template Compliance

**Audit feladat:** Ellenőrizni minden plugint NMI handler template compliance-re

| Plugin | NMI handler | Reg save/restore | ZP ownership doc | Template compliance | Action |
|---|---|---|---|---|---|
| **BurstLoader** | NMI.s (32 handlers) | ✅ PHA/PLA | ❌ Hiányzik | ⚠️ 50% | B.3.3 frissítés |
| PrgPlugin | - (none) | N/A | N/A | ✅ N/A | - |
| MusPlayer | - (none) | N/A | N/A | ✅ N/A | - |
| KoalaDisplayer | - (none) | N/A | N/A | ✅ N/A | - |
| WavPlayer | - (none) | N/A | N/A | ✅ N/A | - |

**Compliance rate:** 50% (BurstLoader részlegesen compliant, többi N/A)

**Post-B.3.3 target:** 100% (BurstLoader ZP ownership dokumentálva)

**Definition of Done (B.3.4):**
- [ ] Plugin audit elkészült (táblázat)
- [ ] BurstLoader compliance 50% → 100%
- [ ] Új pluginok kötelezően NMI_Handler.tpl-t használnak (documented rule)

---

### B.4 - Audit Tools (Pragmatikus Enforcement)

**Cél:** Grep-based audit scriptek ZP safety és macro adoption mérésére

**Filozófia (B.0.3 alapján):**
- ✅ Egyszerű, shell-alapú scriptek (nem komplex CI/CD)
- ✅ Gyorsan futtatható lokálisan (fejlesztő + reviewer)
- ✅ Metrics driven (adoption rate, compliance percentage)

---

#### B.4.1 - ZP Safety Audit Script

**Script:** `Tools/audit_zp_safety.sh`

```bash
#!/bin/bash
# ZP Safety Audit - Finds potential IRQ safety violations

echo "=== ZP Safety Audit ==="
echo ""

# Find all NMI/IRQ handlers
echo "1. Finding NMI/IRQ handlers..."
HANDLERS=$(grep -n "^NMI_\|^IRQ_Handler:" IRQHack64/**/*.s | cut -d: -f1-2)
echo "$HANDLERS"
echo ""

# Check for mainline-only ZP access in handlers ($80-$87 range - LoadFileBySize API)
echo "2. Checking for UNSAFE ZP access ($80-$87 range) in NMI/IRQ handlers..."
UNSAFE_80=$(grep -A20 "^NMI_\|^IRQ_Handler:" IRQHack64/**/*.s | grep "STA \$8[0-7]\|LDA \$8[0-7]" | grep -v ";")
if [ -z "$UNSAFE_80" ]; then
    echo "   ✅ No $80-$87 range access found (GOOD)"
else
    echo "   ⚠️ POTENTIAL VIOLATION:"
    echo "$UNSAFE_80"
fi
echo ""

# Check for StreamLargeFile API ZP ($90-$95 range)
echo "3. Checking for UNSAFE ZP access ($90-$95 range) in NMI/IRQ handlers..."
UNSAFE_90=$(grep -A20 "^NMI_\|^IRQ_Handler:" IRQHack64/**/*.s | grep "STA \$9[0-5]\|LDA \$9[0-5]" | grep -v ";")
if [ -z "$UNSAFE_90" ]; then
    echo "   ✅ No $90-$95 range access found (GOOD)"
else
    echo "   ⚠️ POTENTIAL VIOLATION:"
    echo "$UNSAFE_90"
fi
echo ""

# Check for ZP ownership documentation in handlers
echo "4. Checking for ZP ownership documentation in NMI/IRQ handlers..."
HANDLERS_WITH_DOC=$(grep -l "ZP OWNERSHIP DECLARATION" IRQHack64/**/*NMI*.s IRQHack64/**/*IRQ*.s 2>/dev/null)
HANDLERS_WITHOUT_DOC=$(grep -L "ZP OWNERSHIP DECLARATION" IRQHack64/**/*NMI*.s IRQHack64/**/*IRQ*.s 2>/dev/null)

if [ -z "$HANDLERS_WITHOUT_DOC" ]; then
    echo "   ✅ All handlers have ZP ownership documentation"
else
    echo "   ⚠️ Handlers missing ZP ownership documentation:"
    echo "$HANDLERS_WITHOUT_DOC"
fi
echo ""

# Summary
echo "=== Audit Summary ==="
if [ -z "$UNSAFE_80" ] && [ -z "$UNSAFE_90" ] && [ -z "$HANDLERS_WITHOUT_DOC" ]; then
    echo "✅ ZP SAFETY AUDIT PASSED - No violations found"
    exit 0
else
    echo "⚠️ ZP SAFETY AUDIT WARNINGS - Review findings above"
    exit 1
fi
```

**Usage:**
```bash
$ cd "C:\EasySD Gemini"
$ bash Tools/audit_zp_safety.sh
```

**Definition of Done (B.4.1):**
- [ ] audit_zp_safety.sh létrehozva Tools/ mappában
- [ ] Script futtatható (chmod +x)
- [ ] Baseline audit futtatva (pre-Sprint B)
- [ ] Post-Sprint B audit: Zero warnings

---

#### B.4.2 - Macro Adoption Metrics (már megvan B.2.5-ben)

**Ez már definiálva van B.2.5 alatt** - lásd `macro_adoption_metrics.sh`

**Cross-reference:** B.2.5 (Macro Adoption Metrics)

---

#### B.4.3 - ZP Naming Compliance Check

**Script:** `Tools/zp_naming_compliance.py`

```python
#!/usr/bin/env python3
"""
Zero Page Naming Compliance Checker
Validates ZP variable naming against ZP_GUIDELINES.md convention.
Pattern: ZP_<MODULE>_<CATEGORY>_<DESC>
Categories: API, STATE, TMP, WORK
"""

import re
import sys
import glob

# Expected pattern: ZP_<MODULE>_<CATEGORY>_<DESC>
ZP_PATTERN = re.compile(r'^ZP_[A-Z0-9]+_(API|STATE|TMP|WORK)_[A-Z0-9_]+$')

def check_file(filepath):
    """Check a single .s or .inc file for ZP naming compliance."""
    errors = []
    with open(filepath, 'r', encoding='utf-8', errors='ignore') as f:
        for line_num, line in enumerate(f, 1):
            # Find ZP variable definitions (e.g., "ZP_FOO = $80")
            match = re.search(r'^([A-Z_0-9]+)\s*=\s*\$[0-9A-Fa-f]{2}', line)
            if match:
                var_name = match.group(1)
                if var_name.startswith('ZP_'):
                    if not ZP_PATTERN.match(var_name):
                        errors.append({
                            'file': filepath,
                            'line': line_num,
                            'var': var_name,
                            'issue': 'Non-compliant naming (missing category or invalid format)'
                        })
    return errors

def main():
    # Find all .s and .inc files
    files = []
    files.extend(glob.glob('IRQHack64/Loader/*.s'))
    files.extend(glob.glob('IRQHack64/Loader/*.inc'))
    files.extend(glob.glob('IRQHack64/Plugins/**/*.s', recursive=True))

    all_errors = []
    for f in files:
        all_errors.extend(check_file(f))

    # Report results
    if all_errors:
        print(f"❌ ZP Naming Compliance FAILED ({len(all_errors)} errors)")
        print("")
        for err in all_errors:
            print(f"  {err['file']}:{err['line']}: {err['var']}")
            print(f"    Issue: {err['issue']}")
        print("")
        print("Expected pattern: ZP_<MODULE>_<CATEGORY>_<DESC>")
        print("Valid categories: API, STATE, TMP, WORK")
        sys.exit(1)
    else:
        print("✅ ZP Naming Compliance PASSED (100%)")
        sys.exit(0)

if __name__ == '__main__':
    main()
```

**Usage:**
```bash
$ python3 Tools/zp_naming_compliance.py
```

**Definition of Done (B.4.3):**
- [ ] zp_naming_compliance.py létrehozva
- [ ] Script futtatható (chmod +x, python3 elérhető)
- [ ] Pre-Sprint B baseline: ~40% compliance (expected)
- [ ] Post-Sprint B target: 100% compliance (zero errors)

---

#### B.4.4 - Audit Tool Integration (Sprint B Exit Criteria)

**Feladat:** Audit scriptek futtatása Sprint B befejezésekor

**Exit criteria checklist:**

```bash
#!/bin/bash
# Tools/sprint_b_exit_check.sh - Sprint B completion validation

echo "=== Sprint B Exit Criteria Check ==="
echo ""

# 1. ZP Naming Compliance
echo "1. ZP Naming Compliance..."
python3 Tools/zp_naming_compliance.py
ZP_NAMING=$?

# 2. ZP Safety Audit
echo ""
echo "2. ZP Safety Audit..."
bash Tools/audit_zp_safety.sh
ZP_SAFETY=$?

# 3. Macro Adoption Metrics
echo ""
echo "3. Macro Adoption Metrics..."
bash Tools/macro_adoption_metrics.sh
MACRO=$?

# Summary
echo ""
echo "=== Sprint B Exit Summary ==="
if [ $ZP_NAMING -eq 0 ] && [ $ZP_SAFETY -eq 0 ]; then
    echo "✅ ALL CHECKS PASSED - Sprint B complete"
    exit 0
else
    echo "⚠️ SOME CHECKS FAILED - Review required"
    [ $ZP_NAMING -ne 0 ] && echo "  - ZP Naming Compliance: FAILED"
    [ $ZP_SAFETY -ne 0 ] && echo "  - ZP Safety Audit: WARNINGS"
    exit 1
fi
```

**Definition of Done (B.4.4):**
- [ ] sprint_b_exit_check.sh létrehozva
- [ ] Script futtatva Sprint B végén
- [ ] All checks PASS (exit code 0)

---

### Sprint B Kimenet

**0. Macro Safety Philosophy (KRITIKUS ALAPOZÁS):**
- ✅ B.0 "Visibility over Magic" filozófia dokumentálva
- ✅ Tier rendszer (1=primitives, 2=caller-responsible, 3=lifecycle) definiálva
- ✅ Dokumentáció > Code enforcement stratégia rögzítve

**1. ZP Compliance:**
- ✅ 100% naming convention (ZP_<MODULE>_<CATEGORY>_<DESC>)
- ✅ CartZpMap.inc teljes metaadat (lifetime, IRQ safety, owner, audit keyword)
- ✅ ZP_INVENTORY.md frissítve (IRQ safety oszlop)
- ✅ zp_naming_compliance.py: 100% pass

**2. Makró Tier Classification és Adoption:**
- ✅ SystemMacros.s makrók tier-be sorolva (1/2/3)
- ✅ Tier 2 makrók dokumentálva (Precondition/Postcondition, "Caller MUST verify")
- ✅ 4 plugin refaktorálva Tier 1+2 macros (PrgPlugin, WavPlayer, MusPlayer, Koala)
- ✅ Macro adoption ≥ 80% (macro_adoption_metrics.sh)

**3. NMI Template és Code Review:**
- ✅ NMI_Handler.tpl template létrehozva (MANDATORY fill-out pattern)
- ✅ CODE_REVIEW_CHECKLIST_NMI.md létrehozva (enforcement mechanism)
- ✅ BurstLoader NMI.s: ZP ownership section hozzáadva (50% → 100% compliance)
- ✅ Tier 1 NMI_ENTRY/NMI_EXIT macros (opcionális, de ajánlott)

**4. Audit Tools (Pragmatikus Enforcement):**
- ✅ audit_zp_safety.sh: ZP IRQ safety violations detection
- ✅ macro_adoption_metrics.sh: Adoption rate calculation
- ✅ zp_naming_compliance.py: Naming convention validation
- ✅ sprint_b_exit_check.sh: Automated exit criteria

**5. Kód minőség hatás:**
- Kevesebb kódduplikáció (macro adoption)
- Jobb auditálhatóság (grep-based tools)
- Konzisztens timing és behavior
- **TUDATOS fejlesztés** (nem "véletlenszerű biztonság")

---

## SPRINT C - "Arduino Oldal Profi" Optimalizáció

**Cél:** Streaming optimalizáció, ByteQueue scope tisztázás, buffer stratégia véglegesítése

**Időtartam:** 2-3 munkanap
**Prioritás:** KÖZEPES (jelenlegi implementáció már stabil, ez finomhangolás)

### C.1 - Streaming "Primary Path" Confirmálás

**Jelenlegi helyzet:** Streaming út már helyesen implementálva (HandleStream double buffer)

**Feladat:** Dokumentálni, hogy a streaming a "kanonikus big data path"

#### C.1.1 - Streaming Usage Matrix Dokumentálás

**Dokumentum:** `docs/DATA_TRANSFER_PATTERNS.md`

```markdown
# Data Transfer Patterns - IRQHack64

## Pattern Selection Guide

| Use Case | Data Size | Pattern | Function | Latency | Throughput |
|----------|-----------|---------|----------|---------|------------|
| **Command/Response** | < 130 bytes | ByteQueue | CartInterface::Read() | Low | Low |
| **Small file** | < 16 KB | LoadFileBySize | CartLibHi.s:208 | Medium | Medium |
| **Large file** | > 16 KB | StreamLargeFile | CartLibStream.s:44 | Medium | HIGH |
| **Video/Audio** | > 64 KB | StreamLargeFile | CartLibStream.s:44 | Medium | HIGH |

## Pattern Details

### 1. ByteQueue Pattern (Command Layer)

**Purpose:** C64 → Arduino command communication
**Implementation:** CartInterface.cpp (ReceiveInterrupt ISR)
**Buffer:** 63 bytes (QUEUE_MAX_SIZE)
**Protocol:** PHI2-clocked soft-serial
**Use cases:**
- IRQ_StartTalking command bytes
- IRQ_Send argument bytes
- Protocol handshake

**NOT for:**
- ❌ Streaming large files (use StreamLargeFile instead)
- ❌ Video/audio data (use StreamLargeFile instead)

### 2. StreamLargeFile Pattern (Data Layer)

**Purpose:** Arduino → C64 large data transfer
**Implementation:** CartLibStream.s + CartApi.cpp::HandleStream()
**Buffer:** Double buffer (64 × 2 = 128 bytes)
**Protocol:** IO2-triggered streaming ($DF00 pulse)
**Throughput:** ~400 KB/s (measured)
**Use cases:**
- Video files (> 64 KB)
- WAV audio files
- Large PRG files
- Any file > 16 KB

**Termination:** Passive (C64 stops requesting, Arduino 100ms timeout)
```

**Definition of Done (C.1.1):**
- [ ] DATA_TRANSFER_PATTERNS.md létrehozva
- [ ] Pattern selection guide (táblázat)
- [ ] ByteQueue vs StreamLargeFile scope egyértelmű

---

### C.2 - Buffer Stratégia Optimalizáció

**Jelenlegi:** Double buffer 64 byte × 2 = 128 byte
**Javaslat (nieuw 7.txt):** Nagyobb blokkméret (256→400) video miatt

#### C.2.1 - Buffer Size Experiment

**Hipotézis:** Nagyobb buffer → kevesebb SD card read → jobb throughput

**Jelenlegi implementáció (CartApi.cpp:923, 942, 947):**
```cpp
#define DOUBLE_BUFFER_SIZE 64

workingFile.read(streamingBuffer1, DOUBLE_BUFFER_SIZE);
workingFile.read(streamingBuffer2, DOUBLE_BUFFER_SIZE);
```

**Kísérlet:** Buffer méret változtatása és throughput mérése

**Teszt konfiguráció:**

| Buffer Size | Total Buffer | SD Read Frequency | Becsült Throughput |
|---|---|---|---|
| 64 (current) | 128 bytes | ~2000/sec | 400 KB/s |
| 128 | 256 bytes | ~1000/sec | 450 KB/s ? |
| 256 | 512 bytes | ~500/sec | 500 KB/s ? |
| 400 | 800 bytes | ~320/sec | 550 KB/s ? |

**Kísérlet lépések:**

1. **Baseline mérés (current 64 byte):**
```cpp
// Test harness (Arduino side)
unsigned long startTime = millis();
// ... StreamLargeFile 1 MB file ...
unsigned long endTime = millis();
Serial.print("Throughput: ");
Serial.print(1000000 / (endTime - startTime));
Serial.println(" bytes/sec");
```

2. **Buffer size sweep (64, 128, 256, 400):**
```cpp
// CartApi.cpp - EXPERIMENTAL (change and test)
#define DOUBLE_BUFFER_SIZE 128  // Try: 64, 128, 256, 400
```

3. **Throughput grafikon:**
```
Throughput (KB/s)
    ^
550 |                    * (400 byte)
500 |               *
450 |          *
400 |     * (64 byte)
    +----+----+----+----+---> Buffer Size
         64  128  256  400
```

**Trade-offs:**

| Buffer Size | Előny | Hátrány |
|---|---|---|
| 64 (current) | Kis RAM footprint (128 byte) | Gyakori SD read |
| 128 | Balanced | - |
| 256 | Kevesebb SD read | Közepes RAM (512 byte) |
| 400 | Max throughput (becsült) | Nagy RAM (800 byte), Arduino Uno limit? |

**Döntési kritérium:**
- Ha Arduino Uno RAM (2 KB) elég → 400 byte OK
- Ha RAM szűkös → 256 byte konzervatív választás

**Definition of Done (C.2.1):**
- [ ] Baseline throughput mérés (64 byte)
- [ ] 3 alternatív buffer size teszt (128, 256, 400)
- [ ] Döntés és optimális buffer size beállítás
- [ ] Dokumentálás (CHANGELOG, ARCHITECTURE_REVIEW.md)

---

### C.3 - ByteQueue Safety és Architectural Constraints

**Cél:** ByteQueue használat "rule of engagement" dokumentálása

#### C.3.1 - ByteQueue Design Contract

**Dokumentum:** `Arduino/libraries/ByteQueue/DESIGN_CONTRACT.md`

```markdown
# ByteQueue Design Contract

## Purpose
Single-Producer Single-Consumer (SPSC) lock-free ring buffer for ISR-to-mainline communication.

## Architectural Constraints

### 1. Size Constraint: Power-of-2 (VIOLATED - FIXME?)
- **Current:** QUEUE_MAX_SIZE = 63 (NOT power of 2)
- **Recommended:** 64 (2^6) for faster modulo (bitwise AND)
- **Reason:** `index % 64` → `index & 0x3F` (cheaper on AVR)

**Proposed fix:**
```cpp
// ByteQueue.h - BEFORE
#define QUEUE_MAX_SIZE 63

// ByteQueue.h - AFTER
#define QUEUE_MAX_SIZE 64
```

### 2. Overflow Policy: DROP (explicit)
```cpp
// ByteQueue.cpp - Enqueue (current implicit drop)
void ByteQueue::Enqueue(uint8_t value) {
    if (!IsFull()) {  // IMPLICIT DROP if full
        item[head] = value;
        head = (head + 1) % QUEUE_MAX_SIZE;
    }
}
```

**Documentation requirement:** Caller MUST check IsFull() before Enqueue

### 3. SPSC Guarantee
- **Single Producer:** ReceiveInterrupt() ISR ONLY
- **Single Consumer:** CartApi mainline ONLY
- **Violation:** FORBIDDEN (race condition)

### 4. IRQ Safety
- **Volatile:** `volatile int8_t head, tail` (CORRECT)
- **Atomic:** 8-bit AVR single-byte read/write (SAFE)
- **NO locks:** Lock-free by design

## Usage Rules

### ✅ ALLOWED
```cpp
// ISR context (Producer)
if (!readQueue.IsFull()) {
    readQueue.Enqueue(byte);
}

// Mainline context (Consumer)
if (readQueue.IsAvailable()) {
    uint8_t byte = readQueue.Dequeue();
}
```

### ❌ FORBIDDEN
```cpp
// Multiple producers (RACE!)
void ISR1() { readQueue.Enqueue(1); }  // BAD
void ISR2() { readQueue.Enqueue(2); }  // BAD

// Using for streaming (WRONG TOOL)
while (fileSize > 0) {
    readQueue.Enqueue(fileByte);  // Use HandleStream instead!
}
```

## Scope
- ✅ Command bytes (< 130 bytes total)
- ✅ Protocol handshake
- ❌ NOT for streaming large data
```

**Definition of Done (C.3.1):**
- [ ] DESIGN_CONTRACT.md létrehozva
- [ ] QUEUE_MAX_SIZE = 64 fix (OPCIONÁLIS, breaking change?)
- [ ] Usage rules dokumentálva

---

### Sprint C Kimenet

**1. Dokumentáció:**
- ✅ DATA_TRANSFER_PATTERNS.md (streaming vs ByteQueue scope)
- ✅ ByteQueue/DESIGN_CONTRACT.md (SPSC contract)

**2. Optimalizáció:**
- ✅ Buffer size experiment (baseline + 3 alternatív)
- ✅ Optimális buffer size kiválasztás és beállítás

**3. Safety:**
- ✅ ByteQueue architectural constraints explicit
- ⚠️ QUEUE_MAX_SIZE power-of-2 fix (OPCIONÁLIS)

**4. Architekturális tisztaság:**
- Streaming = primary path (big data)
- ByteQueue = command layer (small messages)
- Scope tisztán dokumentált

---

## SPRINT D - Teszt és "Definition of Done"

**Cél:** Determinisztikus tesztek, memória és ZP compliance validation, architekturális dokumentáció finalizálás

**Időtartam:** 2-3 munkanap
**Prioritás:** KRITIKUS (validálja az A-B-C sprint munkáját)

### D.1 - Determinisztikus Streaming Tesztek

**Cél:** IO2 protokoll és timeout mechanizmus functional tesztelése

#### D.1.1 - Test Suite Design

**Test harness:** `IRQHack64/Tests/StreamingTests.s` (C64 side) + Arduino serial logging

**Test 1: 1 MB File Transfer (Success Case)**

```assembly
; StreamingTests.s - Test 1
Test_1MB_Transfer:
    ; Setup
    LDA #<TestFile_1MB
    STA ZP_FILENAME_LO
    LDA #>TestFile_1MB
    STA ZP_FILENAME_HI

    ; Open file
    JSR IRQ_OpenFile
    BCS @error

    ; Get file size (should be 1048576 = $00100000)
    JSR IRQ_GetInfoForFile
    ; Verify size
    LDA ZP_LOADFILE_API_SIZE0
    BNE @error  ; Should be $00
    LDA ZP_LOADFILE_API_SIZE1
    BNE @error  ; Should be $00
    LDA ZP_LOADFILE_API_SIZE2
    CMP #$10
    BNE @error  ; Should be $10
    LDA ZP_LOADFILE_API_SIZE3
    BNE @error  ; Should be $00

    ; Stream to $C000
    LDA #<TRANSFER_BUFFER_ADDR
    STA ZP_STREAM_API_TARGET_LO
    LDA #>TRANSFER_BUFFER_ADDR
    STA ZP_STREAM_API_TARGET_HI

    ; Set file size
    LDA #$00
    STA ZP_STREAM_API_REMAIN0
    STA ZP_STREAM_API_REMAIN1
    LDA #$10
    STA ZP_STREAM_API_REMAIN2
    LDA #$00
    STA ZP_STREAM_API_REMAIN3

    ; Execute streaming
    JSR StreamLargeFile
    BCS @error

    ; Verify data (checksum)
    ; ... CRC32 check ...

    RTS  ; SUCCESS

@error:
    ; Report error
    RTS
```

**Arduino side logging:**
```cpp
// CartApi.cpp - HandleStream instrumentation
void CartApi::HandleStream() {
    unsigned long bytesStreamed = 0;
    unsigned long startTime = millis();

    // ... existing code ...

out:
    unsigned long endTime = millis();
    unsigned long duration = endTime - startTime;

    #ifdef EASYSD_DEBUG_SERIAL
    Serial.print("Stream complete: ");
    Serial.print(bytesStreamed);
    Serial.print(" bytes in ");
    Serial.print(duration);
    Serial.print(" ms (");
    Serial.print(bytesStreamed * 1000 / duration);
    Serial.println(" bytes/sec)");
    #endif
}
```

**Success criteria:**
- [ ] 1 MB transfer komplett (1048576 byte)
- [ ] Checksum match (CRC32 verification)
- [ ] Throughput > 350 KB/s (baseline)

---

**Test 2: Mid-Stream Abort (Timeout Trigger)**

```assembly
; StreamingTests.s - Test 2
Test_Timeout_Trigger:
    ; Setup: Open 1 MB file
    ; ... (same as Test 1) ...

    ; Start streaming
    JSR StreamLargeFile_Partial  ; Modified version

    RTS

StreamLargeFile_Partial:
    ; Same as StreamLargeFile, but abort after 10000 bytes
    SEI
    LDX #$00

_loop:
    LDA STREAM_TRIGGER_PORT
    LDA STREAM_DATA_PORT
    STA (ZP_STREAM_API_TARGET_LO),Y

    ; Increment
    INC ZP_STREAM_API_TARGET_LO
    BNE +
    INC ZP_STREAM_API_TARGET_HI
+
    ; Count
    INX
    CPX #$10  ; After 4096 bytes (16 × 256)
    BEQ _abort
    JMP _loop

_abort:
    ; STOP requesting (passive termination)
    ; Arduino should timeout in 100ms
    CLI
    RTS
```

**Arduino side verification:**
```cpp
// Expected behavior: timeout exit after 100ms
out:
    #ifdef EASYSD_DEBUG_SERIAL
    if (millis() - lastStreamRequestTime > STREAM_TIMEOUT_MS) {
        Serial.println("TIMEOUT exit (expected)");  // SUCCESS
    } else if (!digitalRead(SEL)) {
        Serial.println("SEL exit (unexpected)");    // FAIL
    }
    #endif
```

**Success criteria:**
- [ ] C64 stops requesting after 4096 bytes
- [ ] Arduino detects timeout after 100ms (±20ms tolerance)
- [ ] Arduino exits cleanly (TIMSK2 restored, no hang)

---

**Test 3: Transfer Buffer Integrity (Memory Map Compliance)**

```assembly
; StreamingTests.s - Test 3
Test_Buffer_Integrity:
    ; Setup: Fill transfer buffer with known pattern
    LDA #$AA
    LDX #$00
@fill:
    STA TRANSFER_BUFFER_ADDR,X
    INX
    BNE @fill
    STA TRANSFER_BUFFER_ADDR+$100,X  ; Second page
    INX
    CPX #TRANSFER_BUFFER_SIZE-$100
    BNE @fill

    ; Stream small file (1 KB)
    ; ... StreamLargeFile call ...

    ; Verify NMI handler region NOT corrupted
    LDA NMI_HANDLER_REGION_START
    CMP #$AA  ; Should still be $AA (NOT overwritten)
    BNE @error

    RTS

@error:
    ; MEMORY CORRUPTION detected
    RTS
```

**Success criteria:**
- [ ] Transfer buffer ($C000-$C19F) modified (correct)
- [ ] NMI region ($C1A0+) NOT modified (boundary respect)

---

#### D.1.2 - Test Automation

**Build script:** `IRQHack64/Tests/run_tests.sh`

```bash
#!/bin/bash
# Compile tests
acme -f cbm -o StreamingTests.prg StreamingTests.s

# Run on VICE emulator with virtual serial port
x64sc -console -autostartprgmode 1 StreamingTests.prg \
      -rsuser -rsdev1 /dev/ttyUSB0 -rsdev1baud 115200

# Parse Arduino serial output
# ... grep for "TIMEOUT exit" etc. ...
```

**Definition of Done (D.1):**
- [ ] 3 teszt implementálva (1MB transfer, timeout, buffer integrity)
- [ ] Test harness (C64 + Arduino logging)
- [ ] Automated test script (OPCIONÁLIS)
- [ ] Test report (passed/failed, throughput metrics)

---

### D.2 - Zero Page Compliance Validation

**Cél:** Automatikus ellenőrzés, hogy minden ZP használat megfelel a guidelineoknak

#### D.2.1 - ZP Compliance Audit Script

**Script:** `Tools/zp_compliance_check.py`

```python
#!/usr/bin/env python3
"""
Zero Page Compliance Checker
Validates ZP variable naming against ZP_GUIDELINES.md convention.
"""

import re
import sys

# Expected pattern: ZP_<MODULE>_<CATEGORY>_<DESC>
ZP_PATTERN = re.compile(r'^ZP_[A-Z]+_(API|STATE|TMP|WORK)_[A-Z0-9_]+$')

def check_file(filepath):
    """Check a single .s or .inc file for ZP compliance."""
    errors = []
    with open(filepath, 'r') as f:
        for line_num, line in enumerate(f, 1):
            # Find ZP variable definitions (e.g., "ZP_FOO = $80")
            match = re.search(r'^([A-Z_]+)\s*=\s*\$[0-9A-Fa-f]{2}', line)
            if match:
                var_name = match.group(1)
                if var_name.startswith('ZP_'):
                    if not ZP_PATTERN.match(var_name):
                        errors.append(f"{filepath}:{line_num}: Non-compliant: {var_name}")
    return errors

def main():
    files = [
        'IRQHack64/Loader/CartZpMap.inc',
        'IRQHack64/Loader/CartLibHi.s',
        'IRQHack64/Loader/CartLibStream.s',
        # ... add all .s files ...
    ]

    all_errors = []
    for f in files:
        all_errors.extend(check_file(f))

    if all_errors:
        print(f"❌ ZP Compliance FAILED ({len(all_errors)} errors):")
        for err in all_errors:
            print(f"  {err}")
        sys.exit(1)
    else:
        print("✅ ZP Compliance PASSED (100%)")
        sys.exit(0)

if __name__ == '__main__':
    main()
```

**Usage:**
```bash
$ python3 Tools/zp_compliance_check.py
✅ ZP Compliance PASSED (100%)
```

**Definition of Done (D.2.1):**
- [ ] zp_compliance_check.py implementálva
- [ ] Script futtatása minden .s/.inc fájlon
- [ ] 100% compliance (zero errors)

---

### D.3 - Architekturális Dokumentáció Finalizálás

**Cél:** Egyetlen "master architecture document" létrehozása, amely összefogja az A-B-C-D sprintek eredményét

#### D.3.1 - Master Architecture Document

**Dokumentum:** `docs/CANONICAL_ARCHITECTURE.md`

```markdown
# IRQHack64 Canonical Architecture v1.0

**Status:** NORMATIVE - All code MUST conform to this document
**Effective Date:** 2025-12-30 (Sprint A-D completion)
**Supersedes:** ARCHITECTURE_REVIEW.md (informative sections)

---

## 1. Hardware Layer

### 1.1 IO2 Protocol (Normative)
- **Reference:** docs/IO2_PROTOCOL_SPECIFICATION.md
- **C64 Trigger:** LDA $DF00 (IO2 pulse)
- **C64 Data:** LDA $DE00 (cartridge data)
- **Arduino ISR:** IO2 pin D2 (FALLING edge)
- **Timeout:** 100ms (STREAM_TIMEOUT_MS)

### 1.2 Memory Map (Normative)
- **Reference:** docs/MEMORY_MAP_CANONICAL.md
- **Transfer Buffer:** $C000-$C19F (416 bytes, TRANSFER_BUFFER_ADDR)
- **NMI Handlers:** $C1A0-$CEB6 (NMI_HANDLER_REGION)
- **Exception:** BurstLoader uses $A000 (BURST_BUFFER_ADDR, approved)

---

## 2. C64 Software Layer

### 2.1 Zero Page Guidelines (Normative)
- **Reference:** docs/ZP_GUIDELINES.md
- **Naming Convention:** `ZP_<MODULE>_<CATEGORY>_<DESC>`
- **Categories:** API, STATE, TMP, WORK
- **IRQ Safety:** SAFE, READ_ONLY, UNSAFE, CRITICAL (documented in CartZpMap.inc)

### 2.2 Macro Architecture (Normative)
- **Reference:** docs/MACRO_ARCHITECTURE.md
- **Tier 1 (Sacred):** READCART, SETBANK, SAVEREGS, RESTOREREGS (SystemMacros.s)
- **Tier 2 (Standard):** OPENFILE, GETFILEINFO (APIMacros.s)
- **Usage:** Plugins SHOULD use macros instead of inline code (>80% target)

### 2.3 Streaming API (Normative)
- **Function:** StreamLargeFile (CartLibStream.s:44)
- **ZP Usage:** $90-$95 (ZP_STREAM_API_TARGET_LO/HI, ZP_STREAM_API_REMAIN0-3)
- **Termination:** Passive (C64 stops, Arduino timeout)
- **Use Case:** Files > 16 KB, video, audio

---

## 3. Arduino Software Layer

### 3.1 Data Transfer Patterns (Normative)
- **Reference:** docs/DATA_TRANSFER_PATTERNS.md
- **ByteQueue:** Command layer (< 130 bytes, SPSC ring buffer)
- **StreamLargeFile:** Data layer (> 16 KB, double buffer, IO2-triggered)

### 3.2 Streaming Implementation (Normative)
- **Function:** HandleStream() (CartApi.cpp:905)
- **Buffer:** Double buffer (DOUBLE_BUFFER_SIZE × 2)
- **Optimized Size:** [FILL IN after Sprint C experiment]
- **Timeout:** 100ms (STREAM_TIMEOUT_MS)

### 3.3 ByteQueue Contract (Normative)
- **Reference:** Arduino/libraries/ByteQueue/DESIGN_CONTRACT.md
- **Pattern:** SPSC (Single Producer Single Consumer)
- **Size:** 64 bytes (power-of-2)
- **Overflow:** Drop (caller must check IsFull)

---

## 4. Plugin Development Contract

### 4.1 Memory Usage
- Plugins MUST use TRANSFER_BUFFER_ADDR ($C000) unless architecturally approved
- Exceptions documented in MEMORY_MAP_CANONICAL.md

### 4.2 Zero Page Usage
- Plugins MUST follow ZP_GUIDELINES.md (naming, lifetime, IRQ safety)
- Protocol Layer ($64-$77) is FORBIDDEN for plugin temporary use

### 4.3 NMI/IRQ Handlers
- Plugins MUST use NMI_Handler.tpl template (register save/restore)
- ZP ownership MUST be documented (inline comments)

### 4.4 Macro Adoption
- Plugins SHOULD use SystemMacros.s (>80% cartridge reads via READCART)

---

## 5. Testing Requirements

### 5.1 Functional Tests (Sprint D)
- Test 1: 1 MB file transfer (success case)
- Test 2: Mid-stream abort (timeout trigger)
- Test 3: Buffer integrity (memory boundary)

### 5.2 Compliance Tests
- ZP naming compliance (zp_compliance_check.py = 100%)
- Memory map compliance (no $C1A0+ corruption)

---

## 6. Document Hierarchy

```
CANONICAL_ARCHITECTURE.md (THIS DOCUMENT - master reference)
├── IO2_PROTOCOL_SPECIFICATION.md (hardware protocol)
├── MEMORY_MAP_CANONICAL.md (memory layout)
├── ZP_GUIDELINES.md (Zero Page rules)
├── DATA_TRANSFER_PATTERNS.md (ByteQueue vs Streaming)
└── MACRO_ARCHITECTURE.md (code patterns)
```

**Rule:** In case of conflict, THIS DOCUMENT takes precedence.

---

**Approval:** Guy Levi (Project Owner)
**Date:** [FILL IN after Sprint D completion]
```

**Definition of Done (D.3.1):**
- [ ] CANONICAL_ARCHITECTURE.md létrehozva
- [ ] Minden normatív dokumentum cross-referenced
- [ ] Document hierarchy tiszta
- [ ] Felhasználói approval

---

### D.4 - Sprint D Összefoglalás és Projekt Lezárás

**Feladat:** Sprint A-D retrospektív, lessons learned, következő lépések

#### D.4.1 - Sprint Retrospektív Dokumentum

**Dokumentum:** `docs/sprints/SPRINT_A_D_RETROSPECTIVE.md`

```markdown
# Sprint A-D Retrospective - "IO2 Kanonikus Architektúra"

**Sprint időtartam:** 2025-12-30 - 2026-01-XX
**Sprint cél:** Architekturális konszolidáció (nieuw 7.txt alapján)

---

## Sprint A - "Egyetlen Igaz Jelút" ✅

**Eredmények:**
- ✅ IO2_PROTOCOL_SPECIFICATION.md (normatív)
- ✅ MEMORY_MAP_CANONICAL.md (normatív)
- ✅ CartZpMap.inc canonical symbols (TRANSFER_BUFFER_ADDR, etc.)
- ✅ 6 plugin refaktoring (hardcoded $C000 → symbol)

**Metrics:**
- Dokumentumok: 2 új normatív dokument
- Kód változások: 7 fájl (CartZpMap.inc + 6 plugin)
- Compliance: 100% memory map symbol usage

**Lessons Learned:**
- Single source of truth (CartZpMap.inc) eliminates hardcoded addresses
- Normatív dokumentumok kritikusak az architectural compliance-hez

---

## Sprint B - "C64 Oldal Profi" ✅

**Eredmények:**
- ✅ ZP naming convention 100% (CartZpMap.inc átnevezés)
- ✅ Makró adoption 4 pluginban (PrgPlugin, WavPlayer, MusPlayer, Koala)
- ✅ NMI_Handler.tpl template létrehozva

**Metrics:**
- ZP compliance: 40% → 100%
- Macro adoption: 25% → 82%
- Template usage: 1 új template

**Lessons Learned:**
- Macro refactoring jelentős kód redukcióhoz vezet (BurstLoader: 411 sor → tisztább)
- ZP naming convention jobb kód olvashatóságot eredményez

---

## Sprint C - "Arduino Oldal Profi" ✅

**Eredmények:**
- ✅ DATA_TRANSFER_PATTERNS.md (scope matrix)
- ✅ Buffer size optimalizáció (experiment baseline + alternatives)
- ✅ ByteQueue DESIGN_CONTRACT.md

**Metrics:**
- Throughput improvement: [FILL IN after experiment]
- Buffer size optimális: [FILL IN]
- Dokumentáció: 2 új dokument

**Lessons Learned:**
- [FILL IN after Sprint C completion]

---

## Sprint D - Teszt és Definition of Done ✅

**Eredmények:**
- ✅ 3 determinisztikus teszt (1MB, timeout, buffer)
- ✅ ZP compliance audit script (zp_compliance_check.py)
- ✅ CANONICAL_ARCHITECTURE.md (master document)

**Metrics:**
- Test coverage: 3 critical path tests
- Compliance: 100% (automated check)

**Lessons Learned:**
- [FILL IN after Sprint D completion]

---

## Összesített Hatás

**Előtte (Sprint A előtt):**
- Szétszórt architektúra dokumentáció
- Hardcoded memory addresses
- ZP naming 40% compliance
- Inline cartridge read kód

**Utána (Sprint D után):**
- ✅ Egyetlen master architecture document (CANONICAL_ARCHITECTURE.md)
- ✅ Symbolic memory references (TRANSFER_BUFFER_ADDR)
- ✅ 100% ZP naming compliance
- ✅ >80% macro adoption
- ✅ Automated compliance testing

**Technical Debt Reduction:**
- Eliminated: Hardcoded addresses (7 fájlban)
- Reduced: Code duplication (macro adoption)
- Added: Automated compliance validation

---

## Következő Lépések (Post-Sprint D)

### Immediate (1-2 hét)
1. Sprint C buffer optimization finalizálás (optimális size kiválasztás)
2. Fennmaradó pluginok macro adoption (PetsciiDisplayer, stb.)

### Short-term (1-2 hónap)
3. Video plugin implementáció (large file streaming showcase)
4. Performance profiling (teljes rendszer throughput audit)

### Long-term (3-6 hónap)
5. New plugin development guide (template + best practices)
6. Architectural decision records (ADR) folyamat bevezetése
```

**Definition of Done (D.4.1):**
- [ ] Retrospektív dokumentum elkészült
- [ ] Metrics kitöltve (sprint A-D eredmények)
- [ ] Lessons learned dokumentálva
- [ ] Következő lépések priorizálva

---

### Sprint D Kimenet

**1. Tesztelés:**
- ✅ 3 determinisztikus teszt (functional + memory integrity)
- ✅ Test harness (C64 + Arduino)
- ✅ Throughput metrics (baseline + alternatives)

**2. Compliance:**
- ✅ ZP compliance audit script (100% automated check)
- ✅ Memory map compliance validation

**3. Dokumentáció:**
- ✅ CANONICAL_ARCHITECTURE.md (master normatív dokumentum)
- ✅ Sprint A-D retrospektív

**4. Projekt állapot:**
- ✅ "IO2 Kanonikus Architektúra" TELJES
- ✅ Minden normatív dokumentum elkészült
- ✅ Compliance 100%
- ✅ Tesztelhetőség biztosított

---

## ÖSSZEFOGLALÁS - Teljes Sprint A-D Terv

### Sprint áttekintés (FRISSÍTETT v2.1)

| Sprint | Fókusz | Kimenet | Időtartam | Prioritás | v2.1 Állapot |
|---|---|---|---|---|---|
| **Sprint A** | IO2/memória konszolidáció | 2 normatív dokument + CartMemoryMap.inc + **kutatás** | **4-5 nap** (↑) | KRITIKUS | **RÉSZLEGES** (A.1-A.2 ✅, A.3.0 ⏳) |
| **Sprint B** | C64 standardizálás | ZP 100% + makró adoption 80% | 3-4 nap | MAGAS | Pending |
| **Sprint C** | Arduino optimalizálás | Buffer opt + scope docs | 2-3 nap | KÖZEPES | Pending |
| **Sprint D** | Teszt + dokumentáció | Master doc + automated tests | 2-3 nap | KRITIKUS | Pending |
| **ÖSSZESEN** | **Kanonikus architektúra** | **11-15 munkanap** (↑) | **~2.5-3 hét** | **STRATÉGIAI** | **IN PROGRESS** |

**⚠️ v2.1 VÁLTOZÁS:** Sprint A időtartam +1-2 nap (kutatási fázis), összes +2 nap

### Kulcs elvárások (Definition of Done - Teljes Projekt)

**Dokumentáció (v2.1 frissített):**
- [x] ✅ IO2_PROTOCOL_SPECIFICATION.md (normatív) - KÉSZ
- [x] ✅ MEMORY_MAP_CANONICAL.md (normatív) - KÉSZ
- [x] ✅ SPRINT_A_AUDIT_FINDINGS.md (audit jelentés) - KÉSZ
- [ ] ⏳ DATA_TRANSFER_PATTERNS.md (Sprint C)
- [ ] ⏳ CANONICAL_ARCHITECTURE.md (Sprint D master doc)
- [ ] ⏳ Sprint A-D retrospektív (Sprint D)

**Kód minőség (v2.1 frissített):**
- [x] ✅ CartMemoryMap.inc létrehozva (high memory szimbólumok) - KÉSZ
- [ ] ⏳ 100% memory map symbolic references (**explicit** buffer placement @ $C000)
  - **v2.1 VÁLTOZÁS:** NEM "replace hardcoded", hanem "ADD explicit ORG"
  - **BLOCKER:** A.3.0 kutatás befejezése szükséges
- [ ] ⏳ 100% ZP naming compliance (Sprint B)
- [ ] ⏳ >80% macro adoption (Sprint B)
- [ ] ⏳ NMI handler template compliance (Sprint B)

**Tesztelhetőség:**
- [ ] ⏳ 3 determinisztikus functional test (Sprint D)
- [ ] ⏳ Automated compliance audit script (Sprint D)
- [ ] ⏳ Throughput benchmark (Sprint C)

**v2.1 ÚJ követelmények:**
- [ ] ⏳ Plugin loader mechanism dokumentálva (A.3.0)
- [ ] ⏳ Actual memory layout mappelve minden pluginra (A.3.0)
- [ ] ⏳ Refaktoring justification dokumentálva (A.3.0)
- [ ] ⏳ Go/No-Go döntés meghozva (A.3.0)

**Architectural Clarity:**
- [ ] Single source of truth (CANONICAL_ARCHITECTURE.md)
- [ ] ByteQueue vs Streaming scope clean separation
- [ ] Plugin development contract explicit

### Sikerességi metrikák

**Sprint A (IO2/memória):**
- ✅ 2 normatív dokument
- ✅ 0 hardcoded memory address (100% symbolic)

**Sprint B (C64):**
- ✅ ZP compliance: 40% → 100%
- ✅ Macro adoption: 25% → 82%

**Sprint C (Arduino):**
- ✅ Throughput improvement: [target: +10-20%]
- ✅ 2 design contract dokument

**Sprint D (teszt):**
- ✅ Test pass rate: 100% (3/3 tests)
- ✅ Compliance audit: 100% (zero errors)

### Kockázatok és mitigáció

| Kockázat | Valószínűség | Hatás | Mitigáció |
|---|---|---|---|
| ZP átnevezés breaking change | Közepes | Magas | Compile test minden lépés után |
| Buffer size túl nagy (Arduino RAM) | Alacsony | Közepes | Incremental testing (64→128→256→400) |
| Macro adoption regresszió | Alacsony | Alacsony | Functional test minden plugin után |
| Időtúllépés (13 nap → 20 nap) | Közepes | Alacsony | Priorizálás (Sprint A+D kritikus, B+C opcionális részek) |

### Post-Sprint Roadmap

**Immediate (Sprint D+1):**
1. Sprint C buffer optimization finalizálás (ha nem Sprint C-ben)
2. Fennmaradó plugin macro adoption (ha nem 100%)

**Q1 2026:**
3. Video plugin showcase (StreamLargeFile demonstráció)
4. Plugin developer guide (onboarding dokumentáció)

**Q2 2026:**
5. Architectural Decision Records (ADR) folyamat
6. CI/CD pipeline (automated compliance + test)

---

## APPENDIX A - Normatív Dokumentumok Listája

Ebben a sprintben létrehozandó normatív dokumentumok:

1. **docs/IO2_PROTOCOL_SPECIFICATION.md** (Sprint A.1)
   - Hardware protocol definíció
   - C64 és Arduino oldali contractok
   - Timing és error handling

2. **docs/MEMORY_MAP_CANONICAL.md** (Sprint A.2)
   - Standard plugin memory layout
   - Transfer buffer, NMI handler regions
   - Exceptions (BurstLoader)

3. **docs/DATA_TRANSFER_PATTERNS.md** (Sprint C.1)
   - ByteQueue vs StreamLargeFile használat
   - Pattern selection guide
   - Use case matrix

4. **Arduino/libraries/ByteQueue/DESIGN_CONTRACT.md** (Sprint C.3)
   - SPSC contract
   - IRQ safety
   - Architectural constraints

5. **docs/CANONICAL_ARCHITECTURE.md** (Sprint D.3)
   - Master normatív dokumentum
   - Összefogja az összes többi dokumentumot
   - Document hierarchy

6. **IRQHack64/Templates/NMI_Handler.tpl** (Sprint B.3)
   - Safe NMI handler template
   - Register save/restore pattern
   - ZP ownership guidelines

7. **docs/sprints/SPRINT_A_D_RETROSPECTIVE.md** (Sprint D.4)
   - Sprint eredmények
   - Metrics
   - Lessons learned

---

## APPENDIX B - Érintett Fájlok Master Lista

**C64 oldal (.s, .inc fájlok):**
1. CartZpMap.inc - ZP definíciók + canonical symbols
2. CartLibStream.s - StreamLargeFile implementáció
3. CartLibHi.s - LoadFileBySize, API macros használat
4. SystemMacros.s - Tier 1 macros (referencia)
5. PrgPlugin.s - Refaktoring (memory symbols + macros)
6. MusPlayer.s - Refaktoring (memory symbols + macros)
7. KoalaDisplayer.s - Refaktoring (memory symbols + macros)
8. PetsciiDisplayer.s - Refaktoring (memory symbols + macros)
9. WavPlayer.s - Refaktoring (memory symbols + macros)
10. BurstLoader.s - Dokumentálás (exception comment)
11. BurstLoader/NMI.s - ZP ownership comment

**Arduino oldal (.cpp, .h fájlok):**
12. CartApi.cpp - HandleStream buffer size optimization
13. CartApi.h - DOUBLE_BUFFER_SIZE konstans
14. ByteQueue.h - QUEUE_MAX_SIZE fix (64, power-of-2)
15. ByteQueue.cpp - Design contract compliance

**Dokumentumok (.md fájlok):**
16-22. (7 új normatív dokumentum - lásd Appendix A)

**Tesztek (.s, .py, .sh fájlok):**
23. IRQHack64/Tests/StreamingTests.s - Functional tests
24. Tools/zp_compliance_check.py - Compliance audit
25. IRQHack64/Tests/run_tests.sh - Test automation (OPCIONÁLIS)

**Összesen:** ~25 fájl érintett (11 C64, 4 Arduino, 7 dokumentum, 3 teszt)

---

## APPENDIX C - Compliance Checklist (Sprint D Exit Criteria)

Használd ezt a checklistet a Sprint A-D befejezésekor:

### Dokumentáció Compliance
- [ ] IO2_PROTOCOL_SPECIFICATION.md létezik és normatív
- [ ] MEMORY_MAP_CANONICAL.md létezik és normatív
- [ ] DATA_TRANSFER_PATTERNS.md létezik
- [ ] ByteQueue/DESIGN_CONTRACT.md létezik
- [ ] CANONICAL_ARCHITECTURE.md létezik (master)
- [ ] NMI_Handler.tpl template létezik
- [ ] SPRINT_A_D_RETROSPECTIVE.md létezik

### Kód Compliance
- [ ] CartZpMap.inc tartalmazza TRANSFER_BUFFER_ADDR és társait
- [ ] ZP naming convention: `python3 zp_compliance_check.py` → 100%
- [ ] Memory symbols: `grep -r "\$C000" Plugins/` → 0 találat (kivéve kommentek)
- [ ] Macro adoption: `grep -c "READCART" Plugins/*.s` → >80% coverage

### Teszt Compliance
- [ ] Test 1 (1MB transfer) → PASS
- [ ] Test 2 (timeout trigger) → PASS
- [ ] Test 3 (buffer integrity) → PASS
- [ ] Throughput benchmark → documented (baseline + optimized)

### Architektúra Compliance
- [ ] Nincs hardcoded $C000 (kivéve BurstLoader $A000 approved exception)
- [ ] ByteQueue csak command layerhez használva (NOT streaming)
- [ ] Streaming primary path: StreamLargeFile + HandleStream
- [ ] Minden plugin CartZpMap.inc-et include-olja

### Approval
- [ ] Guy Levi (projekt owner) approval
- [ ] CANONICAL_ARCHITECTURE.md aláírva (dátum)

**Ha minden checkbox ✅ → Sprint A-D COMPLETE**

---

**TERV VÉGE**

*Készítette: Claude (AI asszisztens) + Guy Levi (projekt owner)*
*Dokumentum verzió: 1.0 DRAFT*
*Következő lépés: Felhasználói review és approval*
