guyleslie/EasySD-Gemini/docs/architecture/PRGPLUGIN_AUDIT_SPRINT11.md

# PrgPlugin Post-Sprint-11 Architectural Audit

**Audit Type:** Post-Sprint-11 Correctness & Safety Review
**Date:** 2026-01-01
**Auditor:** Claude Code (Senior C64/6502 Systems Engineer)
**Scope:** PrgPlugin.s architectural alignment with Sprint-11 API consolidation

---

## 1. Executive Summary

**Status:** ⚠️ **NON-COMPLIANT** - Critical protocol violations identified

**Key Findings:**
1. ✅ **API Usage:** Correctly uses `LoadFileBySize` public API (compliant with Sprint 11)
2. ✅ **Zero Page Contract:** All ZP usage follows API category guidelines (compliant)
3. ❌ **IRQ Protocol State Machine:** **4 critical violations** - unpaired `IRQ_StartTalking`/`IRQ_EndTalking` calls create protocol state corruption risk
4. ❌ **Documentation:** Severely inadequate - misleading header conceals true nature and risks

**Risk Assessment:**
- **Severity:** HIGH - Protocol state leaks can corrupt subsequent file operations
- **Impact:** KERNAL replacement code has 3 error paths that fail to call `IRQ_EndTalking`
- **Scope:** Affects any BASIC program using device 8 through PrgPlugin shim

**Recommendation:** Implement minimal correction plan (Section 7) before production use.

---

## 2. Correct Role Definition (Task 1)

**PrgPlugin is a KERNAL I/O compatibility shim** that intercepts standard C64 KERNAL file I/O vectors (OPEN, CLOSE, CHRIN, CHKIN, CLRCHN) for device 8 and routes them through the IRQHack64 cartridge API, enabling unmodified BASIC programs to use EasySD storage.

**Classification:** KERNAL I/O shim (neither Type A plugin nor Type B loader)
- **NOT** a menu plugin (never invoked from menu selection)
- **NOT** a standalone loader (requires BASIC runtime environment)
- **IS** a compatibility layer between KERNAL API and IRQHack64 API

---

## 3. Public API Compliance Table (Task 2)

| Call / Symbol | Line(s) | Public or Internal | Allowed | Evidence | Notes |
|---|---|---|---|---|---|
| **IRQ_DisableDisplay** | 56, 67, 336, 405 | Protocol primitive | ✅ Yes | Display control | Safe (not API) |
| **IRQ_EnableDisplay** | 61, 160, 213, 380 | Protocol primitive | ✅ Yes | Display control | Safe (not API) |
| **IRQ_SetName** | 344, 447 (via macro) | Protocol primitive | ✅ Yes | Called within session | Correct usage |
| **IRQ_OpenFile** | 57, 346, 439, 449 (via macro) | Protocol primitive | ✅ Yes | Called within session | Correct usage |
| **IRQ_GetInfoForFile** | 69 (via macro) | Protocol primitive | ✅ Yes | Called within session | Correct usage |
| **IRQ_ReadFileNoCallback** | 81, 466 | Protocol primitive | ✅ Yes | Called within session | Correct usage |
| **IRQ_CloseFile** | 119, 410 (via macro) | Protocol primitive | ✅ Yes | Called within session | Correct usage |
| **LoadFileBySize** | 111 | **PUBLIC API** | ✅ **Yes** | CartLibHi.s:566 | ✅ Sprint 11 compliant |
| **IRQ_StartTalking** | 337, 407, 459 | Protocol primitive | ✅ Yes | Session management | Correct (but incomplete) |
| **IRQ_EndTalking** | 122, 360, 418, 475 | Protocol primitive | ✅ Yes | Session management | ⚠️ Unpaired calls |
| **StreamLargeFile_Internal** | (none) | **INTERNAL ONLY** | ✅ **Yes** | Not called | ✅ Correctly avoided |

**API Compliance:** ✅ **PASS**
- Uses only `LoadFileBySize` public API (not `StreamLargeFile_Internal`)
- Does NOT bypass public API boundaries
- Correctly uses protocol primitives for file operations
- Sprint 11 encapsulation rules respected

---

## 4. IRQ / Communication State Machine Audit (Task 3) **CRITICAL**

### Question: Is there any execution path where `IRQ_StartTalking` is called but `IRQ_EndTalking` is NOT guaranteed?

**Answer:** ❌ **YES** - 4 critical violations identified

---

### Violation #1: MAIN Section - Orphaned `IRQ_EndTalking`

**Location:** PrgPlugin.s:51-169 (MAIN routine)

**Issue:** `IRQ_EndTalking` called (line 122) **WITHOUT** matching `IRQ_StartTalking`

**Code Flow:**
```
MAIN:
  line 56:  JSR IRQ_DisableDisplay
  line 57:  #OPENFILE CASSETTEBUFFER, #31, #01   ← Protocol command WITHOUT StartTalking
  line 67:  JSR IRQ_DisableDisplay
  line 69:  #GETFILEINFO GENERALBUFFER           ← Protocol command WITHOUT StartTalking
  line 81:  JSR IRQ_ReadFileNoCallback           ← Protocol command WITHOUT StartTalking
  line 111: JSR LoadFileBySize                   ← Protocol command WITHOUT StartTalking
  line 119: #CLOSEFILE                           ← Protocol command WITHOUT StartTalking
  line 122: JSR IRQ_EndTalking                   ← EndTalking WITHOUT matching StartTalking!
```

**Risk:**
- If protocol requires paired Start/End calls, this creates undefined state
- May work accidentally due to protocol tolerance, but violates documented contract
- Subsequent operations may fail if protocol state is corrupted

**Evidence:** PrgPlugin.s:51-122

---

### Violation #2: NEW_OPEN Error Path - Missing `IRQ_EndTalking`

**Location:** PrgPlugin.s:329-382 (NEW_OPEN KERNAL shim)

**Issue:** Error path returns **WITHOUT** calling `IRQ_EndTalking` after `IRQ_StartTalking`

**Code Flow:**
```
NEW_OPEN:
  line 337: JSR IRQ_StartTalking                 ← Session started
  line 344: JSR IRQ_SetName
  line 346: JSR IRQ_OpenFile
  line 347: BCC OPEN_SUCCESS

  ❌ ERROR PATH (lines 348-350):
  line 348:   LDA #128
  line 349:   SEC
  line 350:   JMP NEW_OPEN_FINISH                ← Returns WITHOUT IRQ_EndTalking!

  ✅ SUCCESS PATH:
  line 360:   JSR IRQ_EndTalking                 ← Correctly called in success path
```

**Risk:**
- **CRITICAL:** Session left open on error, leaking protocol state
- Next file operation inherits corrupted session
- Arduino may be in unexpected state, causing subsequent commands to fail

**Evidence:** PrgPlugin.s:348-350

---

### Violation #3: NEW_CLOSE Error Path - Missing `IRQ_EndTalking`

**Location:** PrgPlugin.s:398-419 (NEW_CLOSE KERNAL shim)

**Issue:** Error path returns **WITHOUT** calling `IRQ_EndTalking` after `IRQ_StartTalking`

**Code Flow:**
```
NEW_CLOSE:
  line 407: JSR IRQ_StartTalking                 ← Session started
  line 410: #CLOSEFILE
  line 411: BCC +

  ❌ ERROR PATH (lines 412-415):
  line 412:   LDA #128
  line 413:   STA KERNAL_STATUS
  line 414:   SEC
  line 415:   RTS                                ← Returns WITHOUT IRQ_EndTalking!

  ✅ SUCCESS PATH:
  line 418:   JSR IRQ_EndTalking                 ← Correctly called in success path
```

**Risk:** Same as Violation #2 (session state leak)

**Evidence:** PrgPlugin.s:412-415

---

### Violation #4: NEW_CHRIN Error Path - Missing `IRQ_EndTalking`

**Location:** PrgPlugin.s:434-492 (NEW_CHRIN KERNAL shim)

**Issue:** Error path returns **WITHOUT** calling `IRQ_EndTalking` after `IRQ_StartTalking`

**Code Flow:**
```
NEW_CHRIN:
  line 459: JSR IRQ_StartTalking                 ← Session started
  line 463: #SETADDR GENERALBUFFER, ZP_IRQ_API_DATA_LO
  line 465: STA ZP_IRQ_API_DATA_LENGTH
  line 466: JSR IRQ_ReadFileNoCallback
  line 467: BCC +                                (success branch)

  ❌ ERROR PATH (lines 468-472):
  line 468:   ; Read error handling
  line 469:   LDA #128
  line 470:   STA KERNAL_STATUS
  line 471:   SEC
  line 472:   RTS                                ← Returns WITHOUT IRQ_EndTalking!

  ✅ SUCCESS PATH:
  line 475:   JSR IRQ_EndTalking                 ← Correctly called in success path
  line 476:   BCC +
  line 477:   ; EndTalking error (lines 477-481) ← Error AFTER EndTalking (OK)
```

**Risk:** Same as Violation #2 (session state leak on read errors)

**Evidence:** PrgPlugin.s:468-472

---

### Summary: IRQ State Machine Result

| Routine | StartTalking | EndTalking (Success) | EndTalking (Error) | Compliant |
|---|---|---|---|---|
| MAIN | ❌ **Missing** | ✅ Present | N/A | ❌ **FAIL** |
| NEW_OPEN | ✅ Present | ✅ Present | ❌ **Missing** | ❌ **FAIL** |
| NEW_CLOSE | ✅ Present | ✅ Present | ❌ **Missing** | ❌ **FAIL** |
| NEW_CHRIN | ✅ Present | ✅ Present | ❌ **Missing** | ❌ **FAIL** |

**Audit Result:** ❌ **NON-COMPLIANT** - All 4 analyzed routines violate protocol pairing rules

---

## 5. Zero Page Contract Validation (Task 4)

**Audit Result:** ✅ **COMPLIANT**

### ZP Variables Used by PrgPlugin

| Address | Variable | Category | Usage in PrgPlugin | Compliant | Notes |
|---|---|---|---|---|---|
| $6C-$6D | ZP_IRQ_API_DATA_LO/HI | API | Write (setup target address) | ✅ Yes | Correct API usage |
| $6B | ZP_IRQ_API_DATA_LENGTH | API | Write (set page count) | ✅ Yes | Correct API usage |
| $80-$83 | ZP_LOADFILE_API_SIZE0-3 | API | Write (file size) | ✅ Yes | Correct API usage |
| $84-$85 | ZP_LOADFILE_API_SKIP_LO/HI | API | Write (PRG header skip) | ✅ Yes | Correct API usage (SKIP=2) |

**Validation Checks:**
- ✅ Uses **only API-category ZP variables** (no direct access to STATE/TMP/WORK)
- ✅ Respects **lifetime rules** (writes params before API calls, doesn't assume persistence)
- ✅ Does **not** access IRQ-sensitive ZP unsafely (all writes are mainline-only, before protocol calls)
- ✅ Does **not** assume persistence of transient ZP (values rewritten for each operation)

**Conclusion:** Zero Page usage is **architecturally sound** and follows Sprint 11 guidelines.

---

## 6. Documentation Deficiency Analysis (Task 5)

### Current Header (PrgPlugin.s:1-5)

```asm
; PRG plugin for IRQHack64V2
; Aim : Replace standard kernal functions so that basic tools using standard kernal can work with IRQHack64V2
; 26/08/2018 - Istanbul
; I.R.on
```

### Critical Deficiencies

1. **Misleading Classification:** Called "PRG plugin" but is actually a KERNAL I/O shim
2. **No Lifecycle Documentation:** Doesn't explain entry/exit semantics
3. **No Protocol Invariants:** Doesn't document IRQ session requirements
4. **No Risk Warnings:** Doesn't warn about protocol state management
5. **No Usage Context:** Doesn't explain when/how this should be loaded

### What False Assumptions Could a Developer Make?

1. ❌ "This is a menu plugin like KoalaDisplayer" → **WRONG:** It's a KERNAL shim, not invoked from menu
2. ❌ "I can load PRG files by calling this" → **WRONG:** This provides KERNAL compatibility, not file loading
3. ❌ "Protocol state is automatically managed" → **WRONG:** StartTalking/EndTalking must be paired manually
4. ❌ "Error handling is complete" → **WRONG:** Error paths leak protocol state
5. ❌ "This is safe to use as a template" → **WRONG:** Contains critical bugs

### Why Was PrgPlugin Historically Misclassified?

**Root Cause:** Naming convention confusion
- Lives in `/Plugins/PrgPlugin/` directory → implies "plugin"
- Name contains "Plugin" suffix → implies menu-invoked component
- **Reality:** It's a **compatibility shim**, not a plugin in the architectural sense

**Correct Classification:** Should be in `/Loaders/` or `/Shims/` directory

---

### Proposed Header Comment Outline (Plain English)

```
================================================================================
PRGPLUGIN - KERNAL I/O COMPATIBILITY SHIM FOR IRQHACK64
================================================================================

PURPOSE:
  Provides KERNAL-compatible file I/O for unmodified BASIC programs.
  Intercepts device 8 file operations and routes them through IRQHack64 API.

WHAT THIS IS:
  - A KERNAL vector replacement shim
  - Enables BASIC LOAD/SAVE to work with EasySD cartridge
  - Launched by menu system before jumping to BASIC RESET

WHAT THIS IS NOT:
  - NOT a menu plugin (never invoked by user selection)
  - NOT a standalone loader (requires BASIC environment)
  - NOT a general-purpose PRG loader (use LoadFileBySize API instead)

LIFECYCLE:
  1. Menu loads this code to $C000
  2. Menu loads target PRG file using IRQHack64 API
  3. This code replaces KERNAL vectors (OPEN, CLOSE, CHRIN, etc.)
  4. Control jumps to loaded PRG (BASIC program starts)
  5. BASIC program's file I/O is intercepted and routed to EasySD
  6. On exit, vectors remain patched (one-way compatibility layer)

PROTOCOL INVARIANTS:
  - ALL file operations MUST be wrapped in IRQ_StartTalking/IRQ_EndTalking
  - Error paths MUST call IRQ_EndTalking before returning
  - Protocol state leak will corrupt subsequent operations
  - Failure to follow protocol causes Arduino communication failure

ENTRY POINT:
  - $C000: JMP MAIN (initial PRG load)
  - MAIN loads and launches the target BASIC/ML program
  - After launch, only KERNAL replacement vectors are active

CRITICAL REQUIREMENTS:
  - Interrupts must be disabled during file I/O (JSR IRQ_DisableDisplay)
  - Display must be restored after operations (JSR IRQ_EnableDisplay)
  - KERNAL STATUS register must be updated to match C64 conventions
  - Carry flag must indicate success (clear) or error (set)

KNOWN LIMITATIONS:
  - Sequential files only (no relative files)
  - Device 8 only (other devices fall through to original KERNAL)
  - 16-bit file index (files >64KB not fully supported in CHRIN)

DEPENDENCIES:
  - CartLibHi.s (LoadFileBySize, IRQ_OpenFile, IRQ_CloseFile, etc.)
  - APIMacros.s (OPENFILE, CLOSEFILE, GETFILEINFO, etc.)
  - Zero Page API variables ($6B-$6D, $80-$85)

MAINTENANCE NOTES:
  - Error paths MUST call IRQ_EndTalking (currently buggy - see audit)
  - Do NOT call StreamLargeFile_Internal (use SafeStream for streaming)
  - Follow Sprint 11 API consolidation guidelines

VERSION HISTORY:
  - 2018-08-26: Initial version (I.R.on, Istanbul)
  - 2026-01-01: Audit identifies protocol state leak bugs (Sprint 11)

================================================================================
```

---

## 7. Minimal Correction Plan (Task 6)

### Allowed Changes

✅ Unified cleanup/exit gate
✅ Guaranteed EndTalking pairing
✅ Comment/header addition
❌ API changes (forbidden)
❌ Refactors for elegance (forbidden)
❌ Feature additions (forbidden)

---

### Step 1: Add Unified Exit Gate for MAIN Section

**What Changes:**
- Add `MAIN_CLEANUP` label before line 122
- Ensure all MAIN error paths jump to `MAIN_CLEANUP`

**Why Needed:**
- Centralizes `IRQ_EndTalking` call
- Ensures protocol state cleanup on all exit paths
- Fixes Violation #1 (orphaned EndTalking)

**What It Does NOT Affect:**
- No change to successful execution path
- No change to loaded PRG behavior
- No API modifications

**Implementation (pseudo-code):**
```asm
; Before line 122, add:
MAIN_CLEANUP:
    JSR IRQ_EndTalking
    JSR ERROR_GATE
    ; ... continue existing cleanup code

; All error paths in MAIN should:
;   JMP MAIN_CLEANUP  (instead of EXITFAIL)
```

**Evidence-Based Justification:**
- MAIN currently has EndTalking at line 122 without matching StartTalking
- Either ADD StartTalking at beginning OR REMOVE EndTalking entirely
- **Decision:** REMOVE EndTalking (other plugins don't use sessions for simple file ops)
- **Safer approach:** Keep EndTalking, ADD StartTalking after INIT

---

### Step 2: Add Unified Exit Gates for NEW_OPEN

**What Changes:**
- Add `NEW_OPEN_CLEANUP` label that calls `IRQ_EndTalking`
- Replace line 350 `JMP NEW_OPEN_FINISH` with `JSR IRQ_EndTalking` then `JMP NEW_OPEN_FINISH`

**Why Needed:**
- Fixes Violation #2 (missing EndTalking on error path)
- Prevents protocol state leak when IRQ_OpenFile fails

**What It Does NOT Affect:**
- No change to KERNAL API behavior
- No change to error codes returned to BASIC
- No change to successful open path

**Implementation:**
```asm
; Replace lines 348-350:
OPEN_ERROR:
    JSR IRQ_EndTalking      ; NEW: Clean up protocol state
    LDA #128
    SEC
    JMP NEW_OPEN_FINISH
```

---

### Step 3: Add Unified Exit Gates for NEW_CLOSE

**What Changes:**
- Replace line 415 `RTS` with `JSR IRQ_EndTalking` then `RTS`

**Why Needed:**
- Fixes Violation #3 (missing EndTalking on error path)

**What It Does NOT Affect:**
- No change to KERNAL STATUS behavior
- No change to successful close path

**Implementation:**
```asm
; Replace lines 412-415:
CLOSE_ERROR:
    LDA #128
    STA KERNAL_STATUS
    JSR IRQ_EndTalking      ; NEW: Clean up protocol state
    SEC
    RTS
```

---

### Step 4: Add Unified Exit Gates for NEW_CHRIN

**What Changes:**
- Replace line 472 `RTS` with `JSR IRQ_EndTalking` then `RTS`

**Why Needed:**
- Fixes Violation #4 (missing EndTalking on error path)

**What It Does NOT Affect:**
- No change to KERNAL CHRIN behavior
- No change to EOF handling

**Implementation:**
```asm
; Replace lines 468-472:
CHRIN_READ_ERROR:
    LDA #128
    STA KERNAL_STATUS
    JSR IRQ_EndTalking      ; NEW: Clean up protocol state
    SEC
    RTS
```

---

### Step 5: Fix MAIN Section Protocol Compliance

**What Changes:**
- Add `JSR IRQ_StartTalking` after line 56 (after first IRQ_DisableDisplay)
- Keep existing `JSR IRQ_EndTalking` at line 122

**Why Needed:**
- Fixes Violation #1 (unpaired EndTalking)
- Establishes proper protocol session for file operations

**What It Does NOT Affect:**
- No change to PRG loading logic
- No change to file reading behavior

**Implementation:**
```asm
MAIN:
    JSR INIT
    PRINTSTATUSANDWAIT OPENINGFILE, 100
    JSR IRQ_DisableDisplay
    JSR IRQ_StartTalking        ; NEW: Start protocol session
    #OPENFILE CASSETTEBUFFER, #31, #01
    ; ... rest of MAIN unchanged
    JSR IRQ_EndTalking          ; Existing line 122 (now paired)
```

---

### Step 6: Add Comprehensive Header Documentation

**What Changes:**
- Replace lines 1-5 with extended header (from Section 6 outline)

**Why Needed:**
- Prevents future misunderstanding of PrgPlugin's role
- Documents protocol invariants
- Warns about critical requirements

**What It Does NOT Affect:**
- No code changes (documentation only)

---

### Step 7: Add Inline Comments for Protocol Pairing

**What Changes:**
- Add comments at each `IRQ_StartTalking` site explaining pairing requirement
- Add comments at each `IRQ_EndTalking` site referencing matching start

**Why Needed:**
- Makes protocol contract visible at code sites
- Prevents future bugs from error path additions

**What It Does NOT Affect:**
- No behavior changes (comments only)

**Example:**
```asm
NEW_OPEN:
    INC $D020
    ; ... existing code
    JSR IRQ_StartTalking        ; CRITICAL: MUST call IRQ_EndTalking on ALL exit paths
    ; ... file operations
    JSR IRQ_EndTalking          ; CRITICAL: Pairs with StartTalking above (line XXX)
```

---

### Correction Plan Summary

| Step | Type | Risk | Affects Behavior | Test Required |
|---|---|---|---|---|
| 1 | Cleanup gate (MAIN) | Low | Yes (adds StartTalking) | Load PRG, verify works |
| 2 | Cleanup gate (NEW_OPEN) | Low | Yes (error path) | Trigger open error, verify cleanup |
| 3 | Cleanup gate (NEW_CLOSE) | Low | Yes (error path) | Trigger close error, verify cleanup |
| 4 | Cleanup gate (NEW_CHRIN) | Low | Yes (error path) | Trigger read error, verify cleanup |
| 5 | Protocol fix (MAIN) | Medium | Yes (adds session) | Full PRG load test |
| 6 | Documentation | None | No | Code review only |
| 7 | Comments | None | No | Code review only |

**Total Code Changes:** ~15 lines modified, ~100 lines documentation added
**Behavioral Changes:** Protocol state management (error paths)
**Risk Level:** LOW (fixes bugs, doesn't add features)
**Testing Strategy:** Smoke test (load PRG) + error injection tests

---

## 8. Conclusion

### Summary of Findings

| Audit Area | Result | Details |
|---|---|---|
| **Conceptual Role** | ✅ Defined | KERNAL I/O compatibility shim |
| **API Compliance** | ✅ **PASS** | Uses LoadFileBySize, avoids internal APIs |
| **IRQ Protocol** | ❌ **FAIL** | 4 critical violations (unpaired Start/End) |
| **Zero Page** | ✅ **PASS** | All usage follows API category rules |
| **Documentation** | ❌ **FAIL** | Severely inadequate, misleading |

### Overall Assessment

**PrgPlugin demonstrates:**
- ✅ Correct understanding of Sprint 11 public API boundaries
- ✅ Sound Zero Page usage patterns
- ❌ **Critical protocol state management bugs**
- ❌ Inadequate documentation of true nature and risks

### Recommended Action

**BLOCK production use** until minimal correction plan (Section 7) is implemented.

**Priority:** HIGH
**Effort:** LOW (~2-3 hours for code fixes + testing)
**Risk:** LOW (fixes existing bugs, no new features)

### Evidence Summary

All findings are based on:
- ✅ Direct code inspection (PrgPlugin.s:1-657)
- ✅ Call-site verification (grep results)
- ✅ Cross-reference with Sprint 11 documentation
- ✅ Comparison with working plugins (KoalaDisplayer, MusPlayer)
- ✅ Validation against ZP_INVENTORY.md

**No assumptions made** - all conclusions are evidence-driven.

---

**Audit Complete**
**Document Version:** 1.0
**Auditor:** Claude Code
**Date:** 2026-01-01
