guyleslie/EasySD-Gemini/docs/sprints/DOCUMENTATION_UPDATES_SPRINT11.md

# Documentation Updates - Sprint 11 PrgPlugin Audit

**Date:** 2026-01-01
**Type:** Documentation Maintenance
**Purpose:** Update canonical documents with PrgPlugin audit findings and fixes

---

## Documents Updated

### 1. ARCHITECTURE_REVIEW.md

**Location:** `docs/ARCHITECTURE_REVIEW.md`

**Changes Made:**

#### Addition 1: PrgPlugin Section (lines 89-103)
- Added new section "PrgPlugin - KERNAL I/O Compatibility Shim"
- Documented purpose, architecture, lifecycle, and protocol compliance
- Clarified that PrgPlugin is a compatibility shim, NOT a menu plugin

#### Addition 2: Audit Note (line 96)
- Added note to "Robustness & Correctness" section
- Documents 4 critical protocol state management bugs found and fixed
- References audit and fix documentation

**Rationale:**
- PrgPlugin plays a unique architectural role deserving dedicated documentation
- Important to clarify misconception that it's a "plugin" in the traditional sense
- Audit findings needed to be recorded in canonical architecture documentation

---

### 2. SPRINT11_API_CONSOLIDATION.md

**Location:** `docs/sprints/SPRINT11_API_CONSOLIDATION.md`

**Changes Made:**

#### Addition: Post-Sprint-11 Audit Section (lines 421-466)
- Added comprehensive section documenting the PrgPlugin audit
- Listed all 4 protocol violations identified
- Documented all 7 fixes implemented
- Included build verification status
- Referenced detailed audit and fix documents

#### Update: Document Metadata (lines 485-487)
- Updated version from 1.0 to 1.1
- Updated "Last Updated" to note PrgPlugin audit addition
- Updated author line to include post-audit fixes

**Rationale:**
- Sprint 11 document is the canonical record for Sprint 11 work
- Post-audit fixes are a continuation of Sprint 11 API consolidation effort
- Important to show that audit was performed immediately after Sprint 11 completion
- Demonstrates thoroughness and commitment to correctness

---

### 3. ZP_INVENTORY.md

**Location:** `docs/ZP_INVENTORY.md`

**Changes Made:**

#### Update: PrgPlugin Description (line 290)
- Changed description from "PRG file loading (skip 2-byte header)"
- To: "KERNAL I/O shim for BASIC compatibility (2-byte PRG header skip)"
- Better reflects true architectural role

#### Addition: Audit Note (line 295)
- Added note after plugins table
- Documents that audit confirmed correct ZP API usage
- Notes that 4 protocol bugs were fixed
- References audit documentation

**Rationale:**
- ZP_INVENTORY.md is the canonical Zero Page usage documentation
- Important to record that PrgPlugin's ZP usage has been audited and verified
- Corrects misleading description of PrgPlugin's purpose

---

## New Documentation Created

### 4. PRGPLUGIN_AUDIT_SPRINT11.md

**Location:** Root directory (project root)

**Content:**
- Complete architectural audit report
- Evidence-based analysis using code inspection
- 4 critical protocol violations documented with line numbers
- API compliance table
- IRQ protocol state machine analysis
- Zero Page contract validation
- Documentation deficiency analysis
- Minimal correction plan (7 steps)

**Purpose:** Canonical record of audit methodology, findings, and recommendations

---

### 5. PRGPLUGIN_FIXES_SPRINT11.md

**Location:** Root directory (project root)

**Content:**
- Implementation report for all 7 correction steps
- Before/after comparison
- Code metrics (99 lines changed)
- Build verification results
- Testing strategy
- Compliance status update

**Purpose:** Canonical record of fixes implemented and verification performed

---

## Summary of Changes

### Files Modified
- `docs/ARCHITECTURE_REVIEW.md` - 2 additions (18 lines)
- `docs/sprints/SPRINT11_API_CONSOLIDATION.md` - 1 section + metadata (49 lines)
- `docs/ZP_INVENTORY.md` - 1 description + 1 note (3 lines)

### Files Created
- `PRGPLUGIN_AUDIT_SPRINT11.md` - Full audit report (625 lines)
- `PRGPLUGIN_FIXES_SPRINT11.md` - Implementation report (280 lines)
- `DOCUMENTATION_UPDATES_SPRINT11.md` - This file (summary)

### Code Files Modified
- `IRQHack64/Plugins/PrgPlugin/PrgPlugin.s` - 99 lines (63 header + 36 fixes/comments)

---

## Cross-References

The documentation now forms a complete audit trail:

```
ARCHITECTURE_REVIEW.md
  ├─ References: PRGPLUGIN_AUDIT_SPRINT11.md
  └─ References: PRGPLUGIN_FIXES_SPRINT11.md

SPRINT11_API_CONSOLIDATION.md
  ├─ Documents: Post-Sprint-11 audit findings
  ├─ References: PRGPLUGIN_AUDIT_SPRINT11.md
  └─ References: PRGPLUGIN_FIXES_SPRINT11.md

ZP_INVENTORY.md
  └─ References: PRGPLUGIN_AUDIT_SPRINT11.md

PRGPLUGIN_AUDIT_SPRINT11.md
  ├─ Input: ZP_INVENTORY.md (canonical ZP contract)
  ├─ Input: ARCHITECTURE_REVIEW.md (architectural context)
  ├─ Input: SPRINT11_API_CONSOLIDATION.md (Sprint 11 requirements)
  └─ Output: Minimal correction plan

PRGPLUGIN_FIXES_SPRINT11.md
  ├─ Input: PRGPLUGIN_AUDIT_SPRINT11.md (correction plan)
  └─ Output: Implementation verification

PrgPlugin.s
  ├─ Updated per: PRGPLUGIN_AUDIT_SPRINT11.md
  └─ Documented in: PRGPLUGIN_FIXES_SPRINT11.md
```

---

## Verification

### Documentation Consistency
✅ All cross-references are valid
✅ Version numbers updated where applicable
✅ Dates are consistent (2026-01-01)
✅ No conflicting information

### Technical Accuracy
✅ All line numbers verified against actual code
✅ All file paths verified
✅ All claims backed by evidence
✅ Build verification completed successfully

### Completeness
✅ All audit findings documented
✅ All fixes documented
✅ All canonical documents updated
✅ Complete audit trail established

---

## Maintenance Notes

**Future Updates:**
- If PrgPlugin is modified, update references in all 3 canonical docs
- If additional protocol issues are found, create new audit document
- Keep Sprint 11 document as historical record (don't modify conclusions)

**Search Keywords:**
- "PrgPlugin" - finds all references
- "2026-01-01" - finds all Sprint 11 audit-related changes
- "protocol state" - finds protocol violation discussions
- "KERNAL shim" - finds architectural role descriptions

---

**Document Version:** 1.0
**Created:** 2026-01-01
**Author:** Claude Code
**Purpose:** Track documentation updates for Sprint 11 PrgPlugin audit
