guyleslie/EasySD-Gemini/docs/sprints/SPRINT_SAFE_STREAM_TRUTH_CLEANUP_DECISION.md

# SafeStream Truth Cleanup - Resolution Decision (PHASE 2)

**Sprint:** SPRINT_SAFE_STREAM_TRUTH_CLEANUP
**Date:** 2026-01-01
**Author:** Claude Sonnet 4.5
**Status:** Phase 2 Complete - Decision Made

---

## Decision: **OPTION B (REMOVE SafeStream Entirely)**

**Selected Strategy:** Remove SafeStreamImpl completely, expose honest streaming API, eliminate all misleading profile/parameter code.

---

## Why Option B? (User-Corrected Decision)

### Initial Analysis Was Wrong

**Initial recommendation:** Option A (keep as NO-OP/reserved)

**User feedback:**
> "Ha nem használjuk felesleges megtartani, csak félrevezető szerintem. Lehet egy kicsit nagyobb munka, de rendbe kell ezt raknunk nem halogatni a valós megoldást."
>
> Translation: "If we're not using it, keeping it is pointless, just misleading in my opinion. It might be a bit more work, but we need to properly fix this, not postpone the real solution."

**User is correct because:**

1. **"Future reserved" is a cop-out**
   - Parameters are **physically impossible** due to PHI2 timing constraints (<500ns window)
   - Not "unimplemented" - **unimplementable** on this hardware architecture
   - Keeping them for "future compatibility" is dishonest if they can never work

2. **Misleading code is worse than deleted code**
   - A developer seeing `STREAM_SAFE/NORMAL/FAST` will assume they control performance
   - Comment saying "NO-OP" doesn't prevent this - it just creates confusion
   - **Absence of feature is clearer than presence of fake feature**

3. **Technical debt compounds**
   - Every sprint doc, ZP inventory, architecture review now has to explain "SafeStream exists but does nothing"
   - Every new developer asks "why do we have unused profiles?"
   - Maintenance burden > one-time cleanup effort

4. **Work plan allows behavior-neutral deletions**
   - "Do NOT change runtime behavior" means don't break streaming
   - Removing a no-op wrapper doesn't change streaming behavior
   - The actual streaming (StreamLargeFile_Internal loop) remains untouched

---

## Revised Decision Rationale

### 1. Maximum Clarity (Primary Goal)

**Option A (Keep):**
- Code says: "Here are three streaming profiles: SAFE, NORMAL, FAST"
- Comments say: "These do nothing"
- **Result:** Confusion. Code and truth contradict each other.

**Option B (Remove):**
- Code says: "Here is streaming. It works one way."
- Comments say: "Streaming is request-driven, deterministic, no parameters"
- **Result:** Clarity. Code and truth align.

**Philosophy:**
*Good code should make wrong assumptions hard, not just documented.*

If SafeStream exists with profiles, developers will use it and expect behavior. Better to not provide the false option at all.

---

### 2. Architectural Honesty

**Current Lie:**
- SafeStreamImpl.s defines 3 profiles with distinct parameters
- Suggests: "Streaming is tunable for different performance/safety trade-offs"
- Reality: Streaming is hardware-bound by PHI2 timing, zero tunability

**Hardware Truth:**
From external research:
- C64 reads $DF00 → /IO2 pulse → ~500ns
- C64 reads $DE00 immediately (same PHI2 cycle)
- Arduino ISR MUST place byte on bus within ~2μs
- Any delay → C64 reads stale/garbage data

**Implication:**
The concept of "delay between bytes" is **meaningless**. The C64 is in a tight loop:
```assembly
_stream_loop:
    LDA $DF00    ; Trigger
    LDA $DE00    ; Read (IMMEDIATELY)
    STA (ptr),Y  ; Store
    ; ... increment/decrement ...
    JMP _stream_loop
```

There is no "interval" or "chunk" or "delay" - it's a **continuous request stream**. The Arduino responds as fast as possible or the C64 gets corruption.

**Verdict:** Profiles are not just unimplemented - they're **architecturally nonsensical**. Remove them.

---

### 3. Single Caller = Easy Migration

**Impact Analysis:**
- **SafeStream_Impl callers:** WavPlayer.s:60 ONLY
- **CustomStream_Impl callers:** ZERO
- **SafeStream_Debug_Impl callers:** ZERO (DEBUG=0 in production)

**Migration Effort:**
- 1 file to modify: WavPlayer.s (1 line change)
- 0 other plugins affected

**Comparison:**
- Option A: Maintain dead code forever, confuse future developers
- Option B: 5 minutes to update WavPlayer, permanent clarity

**Verdict:** Cost/benefit overwhelmingly favors Option B.

---

### 4. Eliminate Duplicated Initialization

**Current Bug:**
1. SafeStream_Impl calls `JSR IRQ_Stream` with profile parameters (e.g., 64,32,4)
2. StreamLargeFile_Internal calls `JSR IRQ_Stream` with 0,0,0
3. Second call overwrites first (confusing and wasteful)

**Option A Fix:**
Keep both, document that second overrides first (still confusing)

**Option B Fix:**
Remove SafeStream entirely → only ONE initialization path remains → zero confusion

**Verdict:** Option B eliminates architectural confusion, not just documents it.

---

### 5. Future Extensibility Counter-Argument REJECTED

**Hypothetical Scenario:**
"What if future firmware wants to implement throttling?"

**Rebuttal:**
1. **Physical impossibility:** PHI2 timing constraints don't change with firmware
2. **Architecture redesign required:** If throttling is needed, it requires:
   - Different hardware (cartridge with buffer RAM + independent timing)
   - Different protocol (not IO2-based synchronous streaming)
   - Complete rewrite of C64 streaming loop
3. **Protocol version bump:** Such a major change would be COMMAND_STREAM_V2 with new parameters anyway
4. **Preservation fallacy:** Keeping dead code "just in case" is how codebases rot

**Real Future:**
If adaptive streaming is ever needed:
- It will require new hardware architecture (can't be done with current cartridge design)
- It will need a new command with new parameters (not reuse of old ignored parameters)
- The current parameter space is not "reserved" - it's **incompatible** with the use case

**Verdict:** "Future compatibility" argument is invalid here.

---

## Option B Implementation Plan

### Files to DELETE Entirely

1. **IRQHack64/Loader/SafeStreamImpl.s**
   - All profile definitions (STREAM_PROFILE_SAFE/NORMAL/FAST)
   - SafeStream_Impl function
   - CustomStream_Impl function
   - SafeStream_Debug_Impl debug code

### Files to MODIFY (C64 Side)

#### 1. CartLibStream.s

**Change 1:** Remove misleading includes/references (if any)

**Change 2:** Update header comment (lines 14-21):
```assembly
;----------------------------------------------------------------------------------------------------------
; StreamLargeFile_Internal - Raw streaming loop for IO2 transfers
;----------------------------------------------------------------------------------------------------------
; *** INTERNAL USE ONLY - Prefer LoadFileBySize for public API ***
;
; This is the low-level streaming primitive for large file transfers (>64KB).
; Uses deterministic request-driven protocol with passive termination.
;
; CONTRACT:
;   Inputs: ZP_STREAM_API_TARGET_LO/HI (target address)
;           ZP_STREAM_API_REMAIN0..3 (32-bit byte count)
;   Behavior: Mutates target/remain, SEI-held (not IRQ-safe)
;   Termination: Passive (C64 stops requesting, Arduino timeout exits)
;   Returns: Carry clear=success, set=error
;----------------------------------------------------------------------------------------------------------
```

**Change 3:** Update comment at line 58-62 (streaming parameter initialization):
```assembly
    ; Step 1: Initialize Arduino streaming mode
    ; Protocol: Request-driven, deterministic (no flow control parameters)
    ; Parameters are sent for protocol compliance but have no effect (Arduino ignores them)
    ; Streaming speed is hardware-bound by PHI2 timing (~400 KB/s measured)
    LDA #$00                ; Placeholder parameter (protocol legacy)
    LDX #$00                ; Placeholder parameter (protocol legacy)
    LDY #$00                ; Placeholder parameter (protocol legacy)
    JSR IRQ_Stream
    BCS _stream_error
```

#### 2. CartZpMap.inc

**DELETE:** Lines $8B-$8E SafeStream ZP variable definitions (section 3.2)

Remove this entire block:
```assembly
; ============================================================
; 3.2 SafeStream Parameters ($8B-$8E)
; ============================================================
; ...
ZP_SAFESTREAM_TMP_OFFSET = $8B
ZP_SAFESTREAM_WORK_INTERVAL = $8C
ZP_SAFESTREAM_WORK_CHUNK    = $8D
ZP_SAFESTREAM_WORK_DELAY    = $8E
```

**REPLACE with:**
```assembly
; ============================================================
; 3.2 UNUSED / AVAILABLE ($8B-$8E)
; ============================================================
; Formerly: SafeStream parameters (removed in SPRINT_SAFE_STREAM_TRUTH_CLEANUP)
; Status: 4 bytes available for future allocation
; ============================================================
```

**UPDATE:** Table of contents (line 13):
```assembly
;   2. LoadFileBySize API ($80-$87) - File loading interface
;   3. UNUSED / AVAILABLE ($8B-$8E) - Free range
;   4. StreamLargeFile API ($90-$95) - Large file streaming
```

#### 3. WavPlayer.s (ONLY Plugin Affected)

**File:** IRQHack64/Plugins/WavPlayer/WavPlayer.s

**OLD (lines 57-60):**
```assembly
	; Use SafeStream wrapper with NORMAL profile
	; (Previously: direct IRQ_Stream call with hardcoded params)
	LDA #STREAM_NORMAL
	JSR SafeStream_Impl
```

**NEW:**
```assembly
	; Initialize Arduino streaming mode
	; (Parameters are ignored by firmware - protocol is deterministic)
	LDA #$00
	LDX #$00
	LDY #$00
	JSR IRQ_Stream
```

**Explanation:**
WavPlayer originally used SafeStream thinking it configured performance. Now it directly calls IRQ_Stream with the truth: parameters are zero because they have no effect.

**Alternative (if WavPlayer does full streaming):**
If WavPlayer needs the complete streaming loop (not just initialization), replace with:
```assembly
	; Stream file using internal streaming API
	; (Setup: ZP_STREAM_API_TARGET_LO/HI and ZP_STREAM_API_REMAIN0..3 already configured)
	JSR StreamLargeFile_Internal
```

(Need to check WavPlayer code to determine which path is correct)

#### 4. MusPlayer.s (Check if affected)

**File:** IRQHack64/Plugins/MusPlayer/MusPlayer.s

**Action:** Grep for `SafeStream` - if found, apply same fix as WavPlayer

**DELETE (lines 1126-1127):**
```assembly
.include "../../Loader/CartLibStream.s"
.include "../../Loader/SafeStreamImpl.s"  ← DELETE THIS LINE
```

### Files to MODIFY (Arduino Side)

#### CartApi.cpp

**Change:** Update comment at HandleStream parameter reading (lines 912-916):
```cpp
  uint8_t initialDelay = Arguments[0];
  uint8_t countStreamedBytes = Arguments[1];
  uint8_t delayBetweenBytes = Arguments[2];

  // PROTOCOL NOTE: These parameters are currently IGNORED and exist only for
  // historical protocol compatibility. The C64 streaming code always sends 0,0,0.
  //
  // Streaming behavior is fixed:
  //   - Buffer size: DOUBLE_BUFFER_SIZE (64 bytes)
  //   - Timeout: STREAM_TIMEOUT_MS (100ms)
  //   - No artificial delays (deterministic request-driven protocol)
  //
  // Rationale: C64 PHI2 timing constraints (~500ns) prevent any ISR delays.
  // Attempting to implement "delayBetweenBytes" would cause data corruption
  // (C64 reads $DE00 in same cycle as $DF00 trigger).
  //
  // These variables are kept to prevent protocol desync but should eventually
  // be removed in a future protocol version cleanup.
```

**Optional future cleanup:**
Remove Arguments[0-2] entirely and change GetArgumentsStatic(3) to GetArgumentsStatic(0), but this changes wire protocol (out of scope for this sprint).

### Files to MODIFY (Documentation)

#### 1. IO2_PROTOCOL_SPECIFICATION.md

**DELETE:** Any references to streaming parameters (if they exist)

**UPDATE:** Section 3.2 "Arduino Side Contract" - clarify no parameters:
```markdown
### 3.1 Function Signature

**Function:** `CartApi::HandleStream()` (CartApi.cpp:905)

**Purpose:** Respond to C64 streaming requests with double-buffered SD card data.

**Parameters:** NONE (historical protocol includes 3 unused arguments for legacy compatibility)
```

#### 2. README.md

**DELETE:** Section "3. Data Streaming: SafeStream (CartLibStream.s)" entirely

**REPLACE with:**
```markdown
### 3. Large File Streaming: StreamLargeFile_Internal (CartLibStream.s)

**Internal API** for streaming files >64KB using IO2 protocol.

**Recommendation:** For most use cases, use `LoadFileBySize` (public API).
StreamLargeFile_Internal is a low-level primitive for advanced streaming needs.

**Protocol:** Request-driven, deterministic, passive termination (100ms timeout).
**Performance:** ~400 KB/s measured throughput.

**Documentation:** See `docs/IO2_PROTOCOL_SPECIFICATION.md` for full protocol spec.
```

#### 3. docs/ZP_INVENTORY.md

**DELETE:** Section 3.2 "SafeStream Parameters ($8B-$8E)" entirely

**UPDATE:** Section 3.1 summary table to show $8B-$8E as "UNUSED":
```markdown
| Range | Purpose | Bytes | Status |
|-------|---------|-------|--------|
| $80-$87 | LoadFileBySize API | 8 | ALLOCATED |
| $8B-$8E | UNUSED / AVAILABLE | 4 | FREE |
| $90-$95 | StreamLargeFile API | 6 | ALLOCATED |
```

#### 4. docs/ARCHITECTURE_CONSOLIDATION_PLAN.md

**DELETE:** Section "2. SafeStream (Public Streaming API)"

**UPDATE:** Internal Primitives section:
```markdown
**Internal Primitives (Not for Direct Use):**
*   **StreamLargeFile_Internal:** Low-level IO2 streaming loop. Used internally by file loading APIs. Direct use discouraged (prefer LoadFileBySize for public API).
```

#### 5. gemini.md (Architecture Overview)

**DELETE:** SafeStream references in ZP table and API section

**UPDATE:** ZP table (line 69):
```markdown
| $80-$87 | LoadFileBySize API | ZP_LOADFILE_API_SIZE0..3, ZP_LOADFILE_API_PAYLOAD_LO/HI |
| $8B-$8E | UNUSED / AVAILABLE | (Formerly SafeStream - removed 2026-01-01) |
| $90-$95 | StreamLargeFile API | ZP_STREAM_API_TARGET_LO/HI, ZP_STREAM_API_REMAIN0..3 |
```

**DELETE:** "SafeStream (CartLibStream.s)" section (lines 179-181)

---

## What Option B Changes

### Runtime Behavior: IDENTICAL (99.9%)

**WavPlayer.s change:**
- **OLD:** `JSR SafeStream_Impl` → calls `IRQ_Stream` with A=64,X=32,Y=4
- **NEW:** Direct `JSR IRQ_Stream` with A=0,X=0,Y=0

**Effect on Arduino:**
- OLD: Arduino receives 64,32,4 → ignores them
- NEW: Arduino receives 0,0,0 → ignores them
- **Result:** IDENTICAL (parameters ignored either way)

**Streaming Loop:**
- Unchanged (StreamLargeFile_Internal request loop remains identical)
- Timing unchanged
- Performance unchanged

**Binary Difference:**
- WavPlayer.s: ~10 bytes different (LDA #0 vs LDA #STREAM_NORMAL, direct JSR)
- No other binaries affected

---

### Code Quality: MASSIVELY IMPROVED

**Deleted:**
- 134 lines of misleading code (SafeStreamImpl.s)
- 3 profile definitions with fake parameters
- 2 unused functions (CustomStream_Impl, SafeStream_Debug_Impl)
- 4 ZP variables that served no purpose

**Simplified:**
- 1 streaming init path (not 2 competing paths)
- 0 contradictions between SafeStream profiles and 0,0,0 hardcoded values
- Clear documentation (no "this exists but does nothing" explanations)

**Maintainability:**
- Future developers see: "Streaming works this way"
- Not: "Streaming has profiles (but they're fake), and parameters (but they're ignored), and..."

---

### Documentation: HONEST AND CONCISE

**Before:**
Every doc must explain SafeStream exists, profiles exist, parameters exist, BUT they do nothing.

**After:**
Docs state: "Streaming is request-driven and deterministic. See IO2_PROTOCOL_SPECIFICATION.md."

**Clarity:**
New developers learn the truth immediately, not after reading 5 contradictory doc sections.

---

## Risk Assessment (Option B)

### Risk 1: Breaking WavPlayer

**Likelihood:** LOW
**Impact:** HIGH (plugin doesn't work)
**Mitigation:**
- Test WavPlayer after modification
- Verify it still plays .wav files correctly
- Check if it uses SafeStream for init-only or for full streaming loop

**Confidence:** HIGH that change is safe (SafeStream was no-op, replacing with equivalent no-op)

### Risk 2: Breaking MusPlayer

**Likelihood:** VERY LOW (grep shows MusPlayer includes SafeStreamImpl.s but may not call it)
**Impact:** MEDIUM
**Mitigation:**
- Grep MusPlayer for `JSR SafeStream_Impl` or `JSR CustomStream_Impl`
- If found, apply same fix as WavPlayer
- Test MusPlayer after changes

### Risk 3: Future Protocol Extensions

**Likelihood:** VERY LOW (parameters are architecturally impossible)
**Impact:** LOW (if ever needed, requires protocol V2 anyway)
**Mitigation:**
- None needed (keeping dead code is not valid mitigation)

### Risk 4: Build Breakage

**Likelihood:** MEDIUM (include dependencies, symbol references)
**Impact:** HIGH (code doesn't compile)
**Mitigation:**
- Grep for all `SafeStream` symbols before deletion
- Update all include statements
- Test build after each file modification

---

## Implementation Order (Minimize Breakage)

### Step 1: Verify Impact Scope
```bash
grep -r "SafeStream" IRQHack64/
grep -r "STREAM_PROFILE" IRQHack64/
grep -r "STREAM_SAFE\|STREAM_NORMAL\|STREAM_FAST" IRQHack64/
grep -r "CustomStream" IRQHack64/
```

### Step 2: Modify Callers FIRST
1. Update WavPlayer.s (replace SafeStream call)
2. Update MusPlayer.s (if affected)
3. Test build → plugins compile

### Step 3: Delete SafeStream Implementation
1. Remove `.include "SafeStreamImpl.s"` from CartLibStream.s
2. Delete SafeStreamImpl.s file
3. Test build → loader compiles

### Step 4: Clean Up ZP Allocations
1. Update CartZpMap.inc (mark $8B-$8E as unused)
2. Test build → no ZP reference errors

### Step 5: Update Documentation
1. README.md
2. IO2_PROTOCOL_SPECIFICATION.md
3. ZP_INVENTORY.md
4. Architecture docs

### Step 6: Verify No References Remain
```bash
grep -r "SafeStream" . --exclude-dir=Archive
# Should return ZERO results (except sprint docs explaining the removal)
```

---

## Decision Summary

**Chosen:** Option B (Remove SafeStream Entirely)

**Corrected Justification:**
1. ✅ **Honest code:** Fake features removed, truth revealed
2. ✅ **Clarity:** New developers see one streaming path, not confusing duplicates
3. ✅ **Minimal impact:** 1 plugin affected (WavPlayer), easy migration
4. ✅ **No future cost:** Eliminates maintenance burden of explaining dead code
5. ✅ **Architecturally sound:** Acknowledges parameters are impossible, not just unimplemented

**Rejected:** Option A (Keep as NO-OP)

**Corrected Reasons:**
1. ❌ **Misleading:** Code presence implies functionality (even with comments)
2. ❌ **Technical debt:** Perpetual documentation burden
3. ❌ **False hope:** "Future reserved" is dishonest if architecturally impossible
4. ❌ **Wrong lesson:** Teaches "keep dead code just in case" anti-pattern

---

**User Feedback Validated:**
> "Ha nem használjuk felesleges megtartani, csak félrevezető szerintem."

**Correct.** Dead code is worse than no code. Option B is the right choice.

---

## Next Steps

**PHASE 3:** Implement Option B changes:
1. Modify WavPlayer.s (replace SafeStream with direct IRQ_Stream call)
2. Check/modify MusPlayer.s if affected
3. Delete SafeStreamImpl.s
4. Update CartZpMap.inc (free $8B-$8E)
5. Add clarifying comments to CartLibStream.s and CartApi.cpp

**PHASE 4:** Documentation cleanup (comprehensive update to all docs)

**PHASE 5:** Verification and sprint doc completion

---

**End of Decision Document (Corrected)**
