guyleslie/EasySD-Gemini/docs/sprints/MACRO_SPRINT1_SUMMARY.md

# Macro Refactoring Sprint 1 - Quick Summary

**Date:** 2025-12-27
**Status:** ✅ COMPLETE
**Impact:** 403 patterns converted, 803 lines removed (66% reduction)

---

## What We Accomplished

### 1. Created SystemMacros.s Library
**File:** `IRQHack64/Loader/SystemMacros.s` (293 lines)

**7 Tier 1 Macros:**
- `READCART` - Cartridge read/store
- `READCART_MODULATED` - Modulated cartridge read (**400× used!**)
- `SETBANK` - Type-safe banking (3× used)
- `SAVEREGS` / `RESTOREREGS` - Register preservation
- `WAITFOR` - Status polling
- `WAITVALUE` - Value wait

### 2. Converted 403 Code Patterns

**CartLib.s:**
- 3× SETBANK patterns (6 lines → 3 lines)

**BurstLoader/NMI.s:**
- 400× READCART_MODULATED patterns (1200 lines → 400 lines!)
- File reduced from 1803 → ~1003 lines (**44.4% smaller**)

### 3. Automation
Created `Tools/convert_nmi_macros.py` - automated 400 pattern conversions

### 4. Documentation
- Master plan (5 sprints)
- Sprint 1 detailed plan
- Sprint 1 completion report
- Macro architecture guide
- Updated README.md, gemini.md, CHANGELOG

---

## Before & After

### Before (3 lines per occurrence):
```assembly
LDA MODULATION_ADDRESS
LDA CARTRIDGE_BANK_VALUE
STA $a000
```

### After (1 line):
```assembly
#READCART_MODULATED $a000
```

---

## Build Verification

✅ All builds pass:
- `python Tools/build.py core` ✅
- `python Tools/build.py plugins` ✅
- `python Tools/build.py release` ✅

✅ Zero behavioral changes
✅ No performance regression

---

## Updated Documents

1. **README.md** - Added macro architecture badge
2. **gemini.md** - Macro usage guide section
3. **CHANGELOG_UNIFIED.md** - Sprint 1 entry
4. **docs/MACRO_ARCHITECTURE.md** - Complete macro reference (NEW)

---

## Next Steps

**Sprint 2:** Memory & API Macros
- SETADDR (141 patterns)
- DISPLAYOFF/ON (32 patterns)
- OPENFILE (20 patterns)
- GETFILESIZE (12 patterns)

**Total Remaining:** ~1,100 patterns across 4 more sprints

---

## Key Metrics

| Metric | Value |
|---|---|
| **Patterns converted** | 403 |
| **Lines removed** | ~803 (66%) |
| **Macros created** | 7 |
| **Files modified** | 2 |
| **Build success** | 100% |
| **Documentation pages** | 4 |

---

## Quick Reference

**Use macros like this:**
```assembly
.include "../../Loader/CartLibStream.s"  ; In plugins

#READCART_MODULATED $a000
#SETBANK PP_CONFIG_DEFAULT
#SAVEREGS
; ... code ...
#RESTOREREGS
```

**Full docs:** `docs/MACRO_ARCHITECTURE.md`

---

**Sprint 1: COMPLETE** ✅
**Production Ready:** YES
**Next Sprint:** Ready to start
