guyleslie/EasySD-Gemini/docs/sprints/SPRINT11_COMPLETION.md

# Sprint 11 - Variable Renaming - COMPLETION

**Project:** EasySD IRQHack64
**Sprint:** Sprint 11 (Zero Page Variable Renaming)
**Status:** ✅ **COMPLETE**
**Date:** 2025-12-27
**Version:** v2.2.0 (no version change - symbol renaming only)

---

## Summary

**Goal:** Rename all 23 ZP variables to follow `ZP_<MODULE>_<CATEGORY>_<DESC>` convention.

**Result:** ✅ **100% COMPLETE** - All variables renamed, build verified.

---

## Variables Renamed (23 total)

### Protocol Layer ($64-$77) - 11 variables
1. ZP_IRQ_WaitHandle → **ZP_IRQ_STATE_WAITHANDLE**
2. ZP_IRQ_SEEK_LOW → **ZP_IRQ_API_SEEK_LO**
3. ZP_IRQ_SEEK_HIGH → **ZP_IRQ_API_SEEK_HI**
4. ZP_IRQ_DATA_LENGTH → **ZP_IRQ_API_DATA_LENGTH**
5. ZP_IRQ_DATA_LOW → **ZP_IRQ_API_DATA_LO**
6. ZP_IRQ_DATA_HIGH → **ZP_IRQ_API_DATA_HI**
7. ZP_IRQ_CALLBACK_LO → **ZP_IRQ_API_CALLBACK_LO**
8. ZP_IRQ_CALLBACK_HI → **ZP_IRQ_API_CALLBACK_HI**
9. ZP_IRQ_SEEK_UPPER_LO → **ZP_IRQ_API_SEEK_UPPER_LO**
10. ZP_IRQ_SEEK_UPPER_HI → **ZP_IRQ_API_SEEK_UPPER_HI**
11. ZP_IRQ_TEMP → **ZP_IRQ_TMP_SCRATCH**

### LoadFileBySize API ($80-$87) - 8 variables
12. ZP_LF_SIZE0 → **ZP_LOADFILE_API_SIZE0**
13. ZP_LF_SIZE1 → **ZP_LOADFILE_API_SIZE1**
14. ZP_LF_SIZE2 → **ZP_LOADFILE_API_SIZE2**
15. ZP_LF_SIZE3 → **ZP_LOADFILE_API_SIZE3**
16. ZP_LF_SKIP_LO → **ZP_LOADFILE_API_SKIP_LO**
17. ZP_LF_SKIP_HI → **ZP_LOADFILE_API_SKIP_HI**
18. ZP_LF_PAYLOAD_LO → **ZP_LOADFILE_API_PAYLOAD_LO**
19. ZP_LF_PAYLOAD_HI → **ZP_LOADFILE_API_PAYLOAD_HI**

### SafeStream ($8B-$8E) - 4 variables
20. ZP_SS_OFFSET → **ZP_SAFESTREAM_TMP_OFFSET**
21. ZP_SS_INTERVAL → **ZP_SAFESTREAM_WORK_INTERVAL**
22. ZP_SS_CHUNK → **ZP_SAFESTREAM_WORK_CHUNK**
23. ZP_SS_DELAY → **ZP_SAFESTREAM_WORK_DELAY**

### StreamLargeFile ($90-$95) - 6 variables (already compliant)
- ZP_STREAM_TARGET_ADDR_LO → **ZP_STREAM_API_TARGET_LO**
- ZP_STREAM_TARGET_ADDR_HI → **ZP_STREAM_API_TARGET_HI**
- ZP_STREAM_BYTES_REMAIN_0 → **ZP_STREAM_API_REMAIN0**
- ZP_STREAM_BYTES_REMAIN_1 → **ZP_STREAM_API_REMAIN1**
- ZP_STREAM_BYTES_REMAIN_2 → **ZP_STREAM_API_REMAIN2**
- ZP_STREAM_BYTES_REMAIN_3 → **ZP_STREAM_API_REMAIN3**

---

## Files Modified (10 total)

1. **CartZpMap.inc** - All 23 variable definitions
2. **CartLib.s** - Protocol layer usage
3. **CartLibDE.s** - Protocol layer usage
4. **CartLibHi.s** - Protocol + LoadFile API usage
5. **CartLibStream.s** - StreamLargeFile API usage
6. **SafeStreamImpl.s** - SafeStream usage
7. **IrqLoaderMenuNew.s** - Menu usage
8. **MusPlayer.s** - Plugin usage
9. **PrgPlugin.s** - Plugin usage
10. **KoalaDisplayer.s** - Plugin usage
11. **PetsciiDisplayer.s** - Plugin usage

---

## Build Verification ✅

**Command:** `python Tools/build.py debug-vice`
**Result:** ✅ **BUILD SUCCESSFUL**

- All assemblies: PASS
- Binaries: Identical (addresses unchanged, only symbols renamed)
- Plugins: All 6 compiled successfully

---

## Naming Convention Compliance

**Before Sprint 11:** 0/23 compliant (0%)
**After Sprint 11:** 23/23 compliant (100%)

All variables now follow: **ZP_`<MODULE>`_`<CATEGORY>`_`<DESC>`**

**Examples:**
- `ZP_IRQ_API_DATA_LO` = IRQ module, API category, data low byte
- `ZP_LOADFILE_API_SIZE0` = LoadFile module, API category, size byte 0
- `ZP_SAFESTREAM_WORK_INTERVAL` = SafeStream module, WORK category, interval
- `ZP_STREAM_API_TARGET_LO` = Stream module, API category, target address low

---

## Definition of Done ✅

- ✅ All 23 variables renamed
- ✅ All 10 assembly files updated
- ✅ Build produces identical binaries
- ✅ Naming convention 100% compliant

---

**Sprint 11 COMPLETE** ✅
**Status:** Production-ready, 100% naming compliance
**Date:** 2025-12-27
