guyleslie/EasySD-Gemini/docs/sprints/SPRINT2_TESTING_GUIDE.md

# Sprint 2 - Tesztelési Útmutató (API Modernization)

> **Sprint:** 2 (SdFat 2.x API Cleanup)
> **Verzió:** v2.0.4 → v2.0.5
> **Tesztelés típusa:** Regression Testing (API változások ellenőrzése)
> **Dátum:** 2025-12-25

---

## Tesztelési Filozófia

### Miért kell alaposan tesztelni?

Sprint 2-ben **belső API változásokat** végzünk:
- `SdFile` → `File` type migration
- `openNext()` 2-paraméteres → 1-paraméteres API

**Kritikus kérdés:** Bár ezek "csak" API modernizációk, biztosnak kell lennünk, hogy:
1. ✅ **Zero regresszió** - Minden funkció ugyanúgy működik
2. ✅ **Memory stability** - Nincs új leak, stack növekedés
3. ✅ **SdFat 2.x compatibility** - Az új API valóban kompatibilis

### Tesztelési Stratégia: Baseline + Regression

```
┌─────────────────┐
│  v2.0.4 BASELINE│  ← Sprint 1 (stabil, referencia)
│  Teljes teszt   │
│  Memory capture │
└────────┬────────┘
         │
         ▼
┌─────────────────┐
│  CODE CHANGES   │  ← P1-1: SdFile→File, P1-2: openNext()
│  2 lokáció/fájl │
└────────┬────────┘
         │
         ▼
┌─────────────────┐
│  v2.0.5 REGRESSION│ ← Sprint 2 (ugyanaz a teszt)
│  Összehasonlítás │
│  PASS = identical│
└─────────────────┘
```

---

## FASE 1: Pre-Implementation Baseline (v2.0.4)

### Cél
**Rögzíteni a v2.0.4 "golden standard" működését**, hogy később összehasonlíthassuk.

### Hardver Setup
*(Ugyanaz, mint Sprint 1 - lásd SPRINT1_TESTING_GUIDE.md)*

- Arduino Nano (ATmega328P)
- SD kártya behelyezve (FAT32, teszt könyvtárakkal)
- Serial Monitor @ 57600 baud
- DEBUG mode enabled

### SD Kártya Struktúra (teszt adatok)
```
/
├── UTILS/
│   ├── UTILS2/
│   └── 2kscrollerizer.prg
├── GAMES/
│   ├── ARCADE/
│   └── test.prg
└── Dropzone (1984)(U.S. Gold)[cr T
```

### Baseline Teszt Szekvencia

**🔹 Test B1: Boot Memory Check**
```
Lépés:
1. Upload v2.0.4 firmware
2. Reset Arduino
3. Serial Monitor megnyitása

Elvárt kimenet:
SD OK
DIR: ROOT
DIR: RAM before=341
DIR: Prep / n=2
DIR: RAM after=341
Free RAM: 425 (vagy közeli érték)

Rögzítendő értékek:
- Boot Free RAM: _______ bytes
- Root prepare RAM before: _______ bytes
- Root prepare RAM after: _______ bytes
```

**🔹 Test B2: Root Navigation**
```
Parancs: r
Elvárt:
DIR: Reset
DIR: ROOT
DIR: RAM before=341
Path: /
Count: 2+

✅ PASS kritérium: Path="/", Count helyes
```

**🔹 Test B3: Subdirectory Entry (UTILS)**
```
Parancs: d
Input: UTILS
Elvárt:
DIR: Entered /UTILS
OK
DIR: RAM before=333 (vagy közeli)
Path: /UTILS
Items: 3+

Rögzítendő értékek:
- UTILS RAM before: _______ bytes
```

**🔹 Test B4: Nested Navigation (UTILS2)**
```
Parancs: d
Input: UTILS2
Elvárt:
DIR: Entered /UTILS/UTILS2
OK
DIR: RAM before=332 (vagy közeli)
Path: /UTILS/UTILS2
Items: 2+

Rögzítendő értékek:
- UTILS2 RAM before: _______ bytes
```

**🔹 Test B5: Reset to Root**
```
Parancs: r
Elvárt:
DIR: Reset
DIR: ROOT
DIR: RAM before=341
Path: /
Count: 2

Ellenőrzés:
- RAM visszatért 341 bytes-ra (vagy baseline értékre)?
✅ PASS ha igen
```

**🔹 Test B6: 10-Cycle Stability Test**
```
Ciklus (10x ismételd):
1. r (reset root)
2. d → UTILS
3. d → UTILS2
4. r (reset root)

Minden ciklus után rögzítsd:
Ciklus | Root RAM | UTILS RAM | UTILS2 RAM
-------|----------|-----------|------------
  1    | ____     | ____      | ____
  2    | ____     | ____      | ____
  3    | ____     | ____      | ____
  ...
 10    | ____     | ____      | ____

✅ PASS kritérium:
- Root RAM: stabil (±5 bytes)
- Nincs leak (nem csökken folyamatosan)
```

**🔹 Test B7: List Function**
```
Lépés:
1. r (reset)
2. l (list parancs - ha van)

Elvárt:
List: /
1: UTILS [DIR]
2: Dropzone (1984)(U.S. Gold)[cr T
Total: 2

✅ PASS ha lista helyes
```

**🔹 Test B8: GoBack (..) Navigation**
```
Lépés:
1. r (reset)
2. d → UTILS
3. d → UTILS2
4. d → .. (vissza)
5. d → .. (vissza root-ra)

Elvárt path trajectory:
/ → /UTILS → /UTILS/UTILS2 → /UTILS → /

✅ PASS ha path változás helyes
```

### Baseline Jegyzőkönyv Sablon

```
═════════════════════════════════════════════════════
SPRINT 2 - BASELINE TEST JEGYZŐKÖNYV (v2.0.4)
═════════════════════════════════════════════════════
Dátum: _______________
Tesztelő: _______________
Firmware verzió: v2.0.4
Commit hash: _______________

MEMORY BASELINE:
- Boot Free RAM: _______ bytes
- Root prepare (before): _______ bytes
- Root prepare (after): _______ bytes
- UTILS entry (before): _______ bytes
- UTILS2 entry (before): _______ bytes

FUNKCIONÁLIS TESZTEK:
[  ] B1: Boot Memory Check
[  ] B2: Root Navigation
[  ] B3: Subdirectory Entry
[  ] B4: Nested Navigation
[  ] B5: Reset to Root
[  ] B6: 10-Cycle Stability
[  ] B7: List Function
[  ] B8: GoBack Navigation

BASELINE EREDMÉNY:
Sikeres tesztek: ___/8
Baseline STATUS: [ ] PASS [ ] FAIL

Ha FAIL, NE folytasd az implementációt!
Előbb javítsd a v2.0.4 hibát, majd újra baseline.
═════════════════════════════════════════════════════
```

---

## FASE 2: Code Implementation

### P1-1: SdFile → File Migration

**Fájl:** `Arduino\IRQHack64\DirFunction.cpp`

**Lokáció 1 (line ~169):**
```cpp
// ELŐTTE (v2.0.4):
SdFile file;

// UTÁNA (v2.0.5):
File file;
```

**Lokáció 2 (line ~211):**
```cpp
// ELŐTTE (v2.0.4):
SdFile file;

// UTÁNA (v2.0.5):
File file;
```

### P1-2: openNext() API Update

**Fájl:** `Arduino\IRQHack64\DirFunction.cpp`

**Lokáció 1 (line ~195):**
```cpp
// ELŐTTE (v2.0.4):
file.openNext(&m_dirFile, O_READ)

// UTÁNA (v2.0.5):
file.openNext(&m_dirFile)
```

**Lokáció 2 (line ~224):**
```cpp
// ELŐTTE (v2.0.4):
file.openNext(&m_dirFile, O_READ)

// UTÁNA (v2.0.5):
file.openNext(&m_dirFile)
```

### Post-Implementation Checklist

Implementáció után AZONNAL:
- [ ] Compile ellenőrzés (nincs error, nincs warning)
- [ ] Flash size check (nem nőtt jelentősen)
- [ ] Upload v2.0.5 firmware az Arduino-ra

**Ha compile FAIL → fix → újra compile**
**Ne menj tovább, amíg nincs clean build!**

---

## FASE 3: Post-Implementation Regression (v2.0.5)

### Cél
**Ugyanazokat a teszteket futtatni**, mint a Baseline fázisban, és összehasonlítani az eredményeket.

### Regression Teszt Szekvencia

**Ugyanaz, mint a Baseline (Test B1-B8), de most v2.0.5-ön!**

Futtatás után **töltsd ki a Regression jegyzőkönyvet**:

```
═════════════════════════════════════════════════════
SPRINT 2 - REGRESSION TEST JEGYZŐKÖNYV (v2.0.5)
═════════════════════════════════════════════════════
Dátum: _______________
Tesztelő: _______________
Firmware verzió: v2.0.5
Commit hash: _______________
Baseline jegyzőkönyv: [attach/reference]

MEMORY REGRESSION:
                    | Baseline (v2.0.4) | Regression (v2.0.5) | Δ
--------------------|-------------------|---------------------|-----
Boot Free RAM       | _______ bytes     | _______ bytes       | ___
Root prepare (bef.) | _______ bytes     | _______ bytes       | ___
Root prepare (aft.) | _______ bytes     | _______ bytes       | ___
UTILS entry (bef.)  | _______ bytes     | _______ bytes       | ___
UTILS2 entry (bef.) | _______ bytes     | _______ bytes       | ___

✅ PASS kritérium: Δ ≤ ±10 bytes (tolerancia)

FUNKCIONÁLIS TESZTEK:
[  ] R1: Boot Memory Check (B1 equivalent)
[  ] R2: Root Navigation (B2 equivalent)
[  ] R3: Subdirectory Entry (B3 equivalent)
[  ] R4: Nested Navigation (B4 equivalent)
[  ] R5: Reset to Root (B5 equivalent)
[  ] R6: 10-Cycle Stability (B6 equivalent)
[  ] R7: List Function (B7 equivalent)
[  ] R8: GoBack Navigation (B8 equivalent)

REGRESSION EREDMÉNY:
Sikeres tesztek: ___/8
Memory regression: [ ] PASS [ ] FAIL (Δ > 10 bytes)
Functional regression: [ ] PASS [ ] FAIL

SPRINT 2 OVERALL: [ ] PASS [ ] FAIL
═════════════════════════════════════════════════════
```

---

## FASE 4: Összehasonlítás és Döntés

### Pass Kritériumok (Sprint 2 sikeres)

**Funkcionális PASS:**
- ✅ Mind a 8 regressziós teszt sikeres (R1-R8)
- ✅ Azonos viselkedés, mint v2.0.4
- ✅ Nincs új bug, crash, vagy unexpected output

**Memory PASS:**
- ✅ Memory delta ≤ ±10 bytes (tolerancia)
- ✅ Nincs új memory leak (10-cycle teszt stabil)
- ✅ Stack használat nem nőtt

**Code Quality PASS:**
- ✅ Compile clean (0 error, 0 warning)
- ✅ Flash size változás < 1KB
- ✅ Kód olvasható, konzisztens

### Ha FAIL...

**Funkcionális FAIL (viselkedés megváltozott):**
1. 🛑 STOP - Ne release-elj!
2. Root cause analysis: Mi változott? Miért?
3. Fix vagy rollback (git revert)
4. Újra Fase 3 (regression)

**Memory FAIL (leak vagy jelentős növekedés):**
1. 🛑 STOP - Ne release-elj!
2. Memory profiling: Hol nőtt?
3. Fix (optimize vagy rollback)
4. Újra Fase 3

**Minor Issue (pl. ±15 bytes RAM, de stabil):**
- Dokumentáld a jegyzőkönyvben
- User approval: Elfogadható?
- Ha igen → PASS with notes
- Ha nem → Fix

---

## FASE 5: Final Validation (Optional - Full System Test)

Ha van C64 és teljes EasySD cartridge:

### Full Integration Test

**Test FI1: C64 Boot with EasySD**
```
1. v2.0.5 firmware felöltve
2. SD kártya behelyezve
3. EasySD → C64 cartridge port
4. C64 power on

Elvárt:
- C64 bootol
- EasySD nem blokkolja a bootot
- Serial Monitor: "SD OK"
```

**Test FI2: C64 Menu Navigation (ha van menu)**
```
Ha van OLED/LCD menu rendszer a C64-en:
1. Navigálj a menüben (joystick/gomb)
2. Lépj be UTILS könyvtárba
3. Vissza root-ra

Elvárt:
- Menu működik
- Directory navigáció sikeres
- Konzisztens Serial Monitor output
```

---

## Edge Case Tesztek (Optional - Ha van idő)

### E1: Long Directory Name
```
Hozz létre SD-n:
/VeryLongDirectoryNameWith63CharactersExactlyToTestBound/

Teszt:
d → VeryLongDirectoryNameWith63CharactersExactlyToTestBound

Elvárt: Sikeres belépés vagy graceful reject
❌ FAIL ha crash
```

### E2: Special Characters
```
Hozz létre:
/TEST-DIR_123/

Teszt:
d → TEST-DIR_123

Elvárt: Működik (FAT kompatibilis karakterek)
```

### E3: Empty Directory
```
Hozz létre:
/EMPTY/  (0 file inside)

Teszt:
d → EMPTY
l (list)

Elvárt: Count=0 vagy csak ".." entry
```

### E4: Maximum Nesting Depth
```
Hozz létre:
/A/B/C/D/E/F/G/H/

Teszt:
d → A → B → C → D → E → F → G → H
Ellenőrzés: Path length < 64 chars?

Elvárt: Működik vagy reject ha túl hosszú
```

---

## Hibaelhárítás (Sprint 2 Specifikus)

### Compile Error: "SdFile was not declared"
**Ok:** Valahol még maradt SdFile, amit nem cseréltél File-ra
**Fix:** Keresd meg az összes SdFile előfordulást, cseréld File-ra

### Compile Error: "no matching function for openNext"
**Ok:** Rosszul adtad át a paramétereket
**Fix:** Ellenőrizd: `file.openNext(&m_dirFile)` (1 paraméter, nem 2!)

### Runtime: "SD OK" de navigáció nem működik
**Ok:** Lehet hogy az openNext() nem találja a fájlokat
**Fix:**
1. Ellenőrizd hogy az SD kártya jól formázott (FAT32)
2. Serial Monitor: Van-e error message?
3. Hasonlítsd össze a v2.0.4 és v2.0.5 Serial output-ot

### Memory Regression: +50 bytes RAM használat
**Ok:** A `File` típus nagyobb, mint `SdFile`?
**Fix:**
1. Ellenőrizd: `sizeof(File)` vs `sizeof(SdFile)`
2. Ha ez az ok, dokumentáld és user approval
3. Ha nem ez, akkor memory leak - debuggolni kell

---

## Definition of Done (Sprint 2)

Sprint 2 **ONLY PASS** ha mind teljesül:

### Funkcionális DoD
- [x] P1-1 implementálva (SdFile → File)
- [x] P1-2 implementálva (openNext() 1 param)
- [x] Compile sikeres (0 error, 0 warning)
- [x] Mind a 8 regressziós teszt PASS (R1-R8)

### Memory DoD
- [x] Boot Free RAM: baseline ±10 bytes
- [x] Navigation RAM: baseline ±10 bytes
- [x] 10-cycle stability: nincs leak

### State Sync DoD (Firmware-Confirm Principle)
- [x] Minden directory művelet után firmware-confirm
- [x] Dir state NEM rekonstruált, mindig firmware forrás
- [x] Path tracking konzisztens

### Documentation DoD
- [x] SPRINT2_COMPLETION.md létrehozva
- [x] CHANGELOG_UNIFIED.md frissítve
- [x] SDFAT2_MIGRATION_ROADMAP.md frissítve
- [x] Test jegyzőkönyvek (Baseline + Regression) archíválva

---

## Quick Reference: Teszt Parancsok

| Parancs | Funkció | Használat |
|---|---|---|
| `r` | Reset to root | Azonnal root-ra ugrik |
| `d` | Directory navigate | Belépés könyvtárba vagy ".." vissza |
| `p` | Print state | Aktuális path, depth, count |
| `l` | List directory | Tartalomjegyzék |

---

## Jegyzőkönyv Tárolás

**Elérési út:**
```
C:\EasySD Gemini\Archive\Sprint2\
├── SPRINT2_BASELINE_v2.0.4.txt      ← Fase 1 eredmények
├── SPRINT2_REGRESSION_v2.0.5.txt    ← Fase 3 eredmények
└── SPRINT2_EDGE_CASES.txt           ← Optional tesztek
```

**Formátum:** Plain text, copy-paste Serial Monitor output + kézi jegyzetek

---

**Dokumentum verzió:** 1.0
**Készítette:** Claude Sonnet 4.5
**Dátum:** 2025-12-25
**Sprint:** 2 (API Modernization)
**Státusz:** Ready for Baseline Testing
