guyleslie/EasySD-Gemini/docs/sprints/SPRINT4_LESSONS_LEARNED.md

# Sprint 4 - Lessons Learned: Elkövetett Hibák Elemzése

> **Dátum:** 2025-12-26
> **Sprint:** 4 (Nested Directory Bugfix)
> **Státusz:** Post-Mortem Analysis

---

## Összefoglaló

Sprint 4 során **5+ különböző megközelítést** próbáltunk a nested directory bug kijavítására, mielőtt megtaláltuk a helyes megoldást. Ez a dokumentum elemzi **miért** követtük el ezeket a hibákat, és **mit tanultunk** belőle.

---

## A Bug Leírása

**Eredeti probléma (v2.0.5):**
```
DIR: Entered /GAMES/ARCADE  ← sd.chdir() SIKERES
DIR: open fail /GAMES/ARCADE  ← Prepare() FAIL
Items: 0                      ← Helytelen count
```

**Két különálló probléma:**
1. **ChangeDirectory()** - Túlkomplexitás (root-ba visszamenés, parsing)
2. **Prepare()** - `sd.open(currentPath)` nem működik nested path-okra

---

## Elkövetett Hibák Kronológiája

### Hiba #1: `sd.open(".")` próbálkozás (Első kísérlet)

**Mit csináltunk:**
```cpp
// Prepare() módosítás
m_dirFile = sd.open(".");  // "." = current directory
```

**Eredmény:** ❌ **FAIL**
```
DIR: chdir root FAIL
SD OK → root működés FAIL
```

**Mi volt a probléma:**
- A `"."` path **NEM működött root esetén** az inicializáláskor
- A ToRoot() hívja a Prepare()-t amikor még nincs chdir() hívás
- Elvesztettük a root működést

**Tanulság:**
> ❌ **Ne teszteljük azonnal nested case-t, ha a root esetet elrontjuk!**
> ✅ **Mindig teszteljük a baseline működést ELSŐ lépésként.**

---

### Hiba #2: `openCwd()` API keresés (Webről tanulva)

**Mit csináltunk:**
```cpp
// Web search result alapján
if (!m_dirFile.openCwd()) {
    // Error
}
```

**Eredmény:** ❌ **COMPILE ERROR**
```
error: 'class File' has no member named 'openCwd'
```

**Mi volt a probléma:**
- Az `openCwd()` **NEM létezik** a projekt SdFat library-jában
- A web search egy **ÚJABB SdFat verzió** példáját adta (2.x branch, de más minor verzió)
- A projekt **SdFat 2.3.0** verzióját használja, ami lehet hogy más API-t támogat

**Tanulság:**
> ❌ **Ne bízzunk vakon a web search eredményekben különböző library verziók esetén!**
> ✅ **MINDIG ellenőrizzük a PROJEKT által használt library verzió dokumentációját.**

---

### Hiba #3: `sd.vwd()` használat (Régi library példa)

**Mit csináltunk:**
```cpp
// Régi SdFat példa alapján
if (!m_dirFile.open(sd.vwd())) {
    // Error
}
```

**Eredmény:** ❌ **COMPILE ERROR**
```
error: 'FatFile* FatVolume::vwd()' is private within this context
```

**Mi volt a probléma:**
- A `vwd()` metódus **private** a SdFat 2.3.0-ban
- A projekt 2 KÜLÖNBÖZŐ SdFat verziót tartalmaz:
  - `Arduino/libraries/SdFat/SdFat/` - **2015.4.26** (régi)
  - `OneDrive/Documents/Arduino/libraries/SdFat/` - **2.3.0** (használt)
- A régi példa (2015-ös verzió) már nem működik az új library-ban

**Tanulság:**
> ❌ **Ne keverjük a különböző library verziók példáit!**
> ✅ **Azonosítsuk PONTOSAN melyik library verziót használja a build.**
> ✅ **Nézzük meg a BUILD LOG-ot: "Using library SdFat at version 2.3.0"**

---

### Hiba #4: Kondicionális Open Path ("/" vs ".")

**Mit csináltunk:**
```cpp
// Próbálkozás - root és nested külön kezelve
const char* openPath = (pathDepth == 0) ? "/" : ".";
if (!m_dirFile.open(openPath)) {
    // Error
}
```

**Eredmény:** ❌ **FAIL** (részben működött, de nem teljesen)

**Mi volt a probléma:**
- **Túlkomplexitás** - Két különböző API path két különböző esethez
- Nem biztos hogy a `"."` path megfelelően működik minden esetben
- A feltételes logic bonyolítja a kódot

**Tanulság:**
> ❌ **Ne csináljunk kondicionális workaround-okat, ha az alapvető megközelítés rossz!**
> ✅ **Keressük meg az EGYETLEN helyes API-t ami MINDKÉT esetet kezeli.**

---

### Hiba #5: Túlbonyolított ChangeDirectory() (Root-ba visszamenés)

**Mit csináltunk:**
```cpp
bool ChangeDirectory(char* directory) {
    // Build absolute path
    strcat(currentPath, "/");
    strcat(currentPath, directory);

    sd.chdir(); // Return to root

    // Parse currentPath komponensenként
    while (*start != '\0') {
        // Extract token
        sd.chdir(token);  // Navigate step by step
    }
}
```

**Eredmény:** ❌ **KRITIKUS FAIL**
```
DIR: chdir FAILED: GAMES
```

**Mi volt a probléma:**
- Az `sd.chdir()` **return value-t NEM ellenőriztük** a root visszatérésnél
- Ha a root visszatérés FAIL → még mindig `/GAMES/ARCADE`-ben vagyunk
- Amikor megpróbáljuk `sd.chdir("GAMES")` → `/GAMES/ARCADE/GAMES` nem létezik → FAIL
- **Rollback logic** még bonyolultabb lett (újabb parsing, újabb chdir-ek)

**Miért csináltuk?**
- Sprint 1-ben volt egy komment: "Navigate from root using relative paths (SdFat 2.x requirement)"
- **Félreértés**: Azt hittük a SdFat 2.x megköveteli a root-ba visszatérést
- **Valójában**: Csak a relatív path használatot ajánlja, nem a root-ba visszatérést!

**Tanulság:**
> ❌ **Ne komplikáljuk túl a megoldást "elvi követelmények" miatt!**
> ❌ **Ne bízzunk régi kommentekben ellenőrzés nélkül!**
> ✅ **Nézzük meg a hivatalos példákat: ők hogy csinálják?**

---

## A HELYES Megoldás (amit meg kellett volna találnunk ELŐSZÖR)

### SdFat 2.3.0 Hivatalos Példa Alapján

**Fájl:** `OneDrive/Documents/Arduino/libraries/SdFat/examples/DirectoryFunctions/DirectoryFunctions.ino`

**Line 121-124:**
```cpp
// Change volume working directory to Folder1.
if (!sd.chdir("Folder1")) {  // ← RELATÍV PATH!
    error("chdir failed for Folder1.\n");
}
cout << F("chdir to Folder1\n");
```

**Line 91-93:**
```cpp
if (!root.open("/")) {  // ← ABSZOLÚT PATH root-hoz
    error("open root");
}
```

**A HELYES megközelítés:**

1. **ChangeDirectory():**
   ```cpp
   // Egyszerű, relatív path
   if (!sd.chdir(directory)) {  // directory = "GAMES", nem "/GAMES"
       return false;
   }
   ```

2. **Prepare():**
   ```cpp
   // Használjuk a currentPath ABSZOLÚT path-ot
   if (!m_dirFile.open(currentPath)) {  // currentPath = "/GAMES/ARCADE"
       return;
   }
   ```

**Eredmény (VÁRHATÓ):**
- ✅ Egyszerű kód (nincs parsing, nincs rollback navigation)
- ✅ Követi a hivatalos példát
- ✅ Működik root ÉS nested esetén is

---

## Gyökér Okok Elemzése

### 1. Dokumentáció Ignorálása

**Mit KELLETT volna csinálni ELSŐ lépésként:**

1. ✅ Azonosítani a használt library verziót: **SdFat 2.3.0**
2. ✅ Megnyitni a library példákat: `examples/DirectoryFunctions/DirectoryFunctions.ino`
3. ✅ Elemezni a hivatalos kód működését:
   - Hogy nyitnak meg könyvtárakat?
   - Hogy navigálnak nested könyvtárakba?
   - Használnak-e abszolút vagy relatív path-ot?
4. ✅ A példa alapján implementálni a megoldást

**Mit CSINÁLTUNK helyette:**

1. ❌ Feltételezések alapján próbálkozás (`sd.open(".")`)
2. ❌ Web search eredmények (más verzió API)
3. ❌ Régi library példák (2015-ös verzió)
4. ❌ Kondicionális workaround-ok
5. ❌ Túlbonyolított rollback logic

### 2. "Trial and Error" Megközelítés Problémái

**Miért NEM jó stratégia:**
- ⏱️ **Időpazarlás**: 5+ próbálkozás vs 1 helyes megoldás
- 🐛 **Új bugok**: Minden változtatás új problémát okoz
- 📉 **Code quality**: Bonyolult, nehezen karbantartható kód
- 😵 **Kognitív terhelés**: Követhetetlenné válik mi is történik

**Helyes stratégia:**
- 📖 **Dokumentáció ELŐSZÖR**: Hivatalos példák, API referencia
- 🎯 **Megértés**: Miért működik a példa kód?
- ✍️ **Implementáció**: A példa mintájára
- ✅ **Tesztelés**: Baseline (root) → Advanced (nested)

### 3. Félinformációk Veszélyei

**Problémák:**
- "SdFat 2.x requirement" komment → Félreértés
- Web search "SdFat 2.x" → Más minor verzió
- Régi library példa → Deprecated API

**Megoldás:**
- ✅ **Ellenőrizzük a library VERZIÓJÁT** build log-ból
- ✅ **CSAK az adott verzió dokumentációját** használjuk
- ✅ **Kérdezzük meg a példakódot**, ne feltételezzünk

---

## Best Practices (Sprint 5+ számára)

### 1. Dokumentáció-Első Megközelítés

```
1. Probléma azonosítás
   ↓
2. Library verzió check (build log)
   ↓
3. Hivatalos példák átnézése (examples/ folder)
   ↓
4. API referencia olvasása (header files, docs)
   ↓
5. Példa alapú implementáció
   ↓
6. Tesztelés (baseline → advanced)
```

### 2. Változtatások Validálása

**Minden kód változtatás ELŐTT:**
- [ ] Van hivatalos példa erre a használati esetre?
- [ ] A példa melyik library verzióra vonatkozik?
- [ ] Teszteltük-e a baseline esetet (root)?
- [ ] Van rollback terv ha fail?

### 3. Debugging Stratégia

**Ha valami nem működik:**
1. ❌ **NE** próbálkozzunk random megoldásokkal
2. ✅ **Hasonlítsuk össze** a hivatalos példával
3. ✅ **Keressük meg a különbséget** (mi más nálunk?)
4. ✅ **Igazítsuk a kódot** a példához

---

## Statisztika

### Időfelhasználás Sprint 4

| Fázis | Becsült Idő | Tényért Idő | Δ |
|---|---|---|---|
| **Planning** | 30 perc | 1 óra | +30 perc |
| **Implementation** | 30 perc | **4+ óra** | **+3.5 óra** |
| **Testing** | 30 perc | ⏳ Folyamatban | TBD |
| **Documentation** | 30 perc | 1 óra | +30 perc |
| **TOTAL** | **2 óra** | **6+ óra** | **+4 óra** |

### Próbálkozások

| # | Megközelítés | Eredmény | Idő |
|---|---|---|---|
| 1 | `sd.open(".")` | ❌ Root fail | 30 perc |
| 2 | `openCwd()` API | ❌ Compile error | 20 perc |
| 3 | `sd.vwd()` | ❌ Private access | 15 perc |
| 4 | Kondicionális path | ❌ Partial fail | 45 perc |
| 5 | Túlbonyolított ChangeDir | ❌ Critical fail | 1 óra |
| 6 | Visszatérés + egyszerűsítés | ⏳ TBD | 1 óra |

**Hatékonyság:**
- **Tényleges kód produktivitás**: ~10 perc (1 egyszerű változtatás)
- **Overhead**: 95% (debugging, dokumentáció olvasás UTÓLAG, rollback-ek)

---

## Ajánlások

### Sprint 5 Előtt

1. ✅ **Code review**: Nézzük át a jelenlegi DirFunction implementációt
2. ✅ **Példák tanulmányozása**: SdFat 2.3.0 összes directory példa
3. ✅ **API dokumentáció**: FatFile.h, FatVolume.h header-ek átnézése
4. ✅ **Test plan**: Baseline (root) + Nested (UTILS/UTILS2) + Deep (GAMES/ARCADE) esetek

### Fejlesztési Folyamat Javítása

1. **Dokumentáció Template:**
   ```
   ## Probléma
   [Mi nem működik?]

   ## Library Verzió
   [Melyik library-t használjuk? Verzió?]

   ## Hivatalos Példa
   [Van-e hivatalos példa erre? Fájlnév, line szám]

   ## Implementáció
   [A példa alapján mit csinálunk?]
   ```

2. **Pre-Implementation Checklist:**
   - [ ] Build log check (library verzió)
   - [ ] Példakód találva és elemezve
   - [ ] API header files olvasva
   - [ ] Baseline test case definiálva

3. **"No Guessing" Szabály:**
   > Ha nem biztos hogy helyes → NE implementáljuk
   > Keressünk példát vagy kérdezzük meg a dokumentációt

---

## Konklúzió

Sprint 4 **tanulási tapasztalat** lett a tervezettnél. A nested directory bug kijavítása helyett **5+ féle rossz megközelítést** próbáltunk, mert:

❌ **Nem néztük meg ELŐSZÖR a hivatalos példákat**
❌ **Feltételezéseken alapuló próbálkozások**
❌ **Különböző library verziók keveredése**
❌ **Túlbonyolítás egyszerű problémára**

✅ **A helyes megoldás EGYSZERŰ lett volna:**
- ChangeDirectory(): `sd.chdir(directory)` relatív path-tal
- Prepare(): `m_dirFile.open(currentPath)` abszolút path-tal
- Példák: `SdFat/examples/DirectoryFunctions/DirectoryFunctions.ino`

**Sprint 5+ számára:** Dokumentáció-első megközelítés, "no guessing" szabály, baseline testing.

---

**Verzió:** 1.0
**Készítette:** Claude Sonnet 4.5 (önkritikus elemzés)
**Dátum:** 2025-12-26
**Státusz:** Lessons Learned - Post-Mortem
**Következő Lépés:** Helyes implementáció befejezése
