guyleslie/EasySD-Gemini/Arduino/EasySD/CartInterface.cpp

#include <Arduino.h>
#include <ByteQueue.h>
#include "CartInterface.h"
#include "EasySD.h"
#include "EasySDLog.h"

volatile ByteQueue readQueue;
volatile uint8_t bitState = BIT_STARTED;
volatile int receiveState = IDLE;

volatile uint8_t currentByte = 0;
volatile uint8_t bitMask = 1;
volatile unsigned long lastInterruptTime = 0;
volatile unsigned long timeDifference = 0;
volatile unsigned long interruptTime = 0;

// Stale identifier timeout: if the C64 sends 1-2 identifier bytes then
// stops (crash, bus glitch), the receive state machine stays in
// IDENTIFIER_1_OK or IDENTIFIER_2_OK forever, blocking new sessions.
// Track when the state last changed; reset to IDLE if stuck too long.
static unsigned long identifierStateChangeMs = 0;
static constexpr unsigned long IDENTIFIER_STALE_TIMEOUT_MS = 200;
#if defined(EASYSD_DEBUG_SERIAL) || defined(EASYSD_RELEASE_LOG)
static unsigned long lastStaleIdentLogMs = 0;
#endif

namespace {

// Settling delay between cartridge state changes. Named after PHI2 historically:
// an earlier version gated these transitions on the PHI2 clock (A4). That gate
// was removed to match the original IRQHack64 boot path, which does not read
// PHI2 at all, and only the delay remained.
void settleBusChange() {
  delayMicroseconds(1);
}

// Release the EPROM page-select lines (D4-D7 = A12-A15, A0-A3 = A8-A11).
// These are not C64 data lines; see the pin map in CartInterface.h.
// Clear the output latches before switching to INPUT, so the AVR does not leave
// weak pull-ups driving the EPROM address inputs while "released".
void releasePageSelectPins() {
  PORTD &= 0x0F;  // D4-D7 latch low, keep D0-D3 untouched
  PORTC &= 0xF0;  // A0-A3 latch low, keep A4-A7 untouched
  DDRD &= ~0xF0;  // D4-D7 back to input
  DDRC &= ~0x0F;  // A0-A3 back to input
}

}

// C64 -> AVR bit timing. The C64 encodes each bit as the gap between two /IO2
// accesses; these are the gap widths in microseconds that the decoder accepts.
// They must match the delays the C64 side emits in SystemMacros.s.
#define BIT_GAP_MIN_US   350   // shorter: line noise, resynchronise
#define BIT_GAP_ZERO_US  450   // below this: bit value 0
#define BIT_GAP_ONE_US   700   // above this: bit value 1 (between = invalid)
#define BIT_GAP_MAX_US  1000   // longer: gap between bytes, resynchronise

static void CartInterface::ReceiveInterrupt() {
    lastInterruptTime = interruptTime;
    interruptTime = micros();
    timeDifference = interruptTime - lastInterruptTime;

    switch(bitState) {
    case BIT_STARTED :
      if (timeDifference<BIT_GAP_MIN_US || timeDifference>BIT_GAP_MAX_US) {
        bitState = BIT_STARTED;
        currentByte = 0;
        bitMask = 1;
      } else {
        if (timeDifference<BIT_GAP_ZERO_US) {
          bitState = BIT_ZERO_END;
        } else if (timeDifference>BIT_GAP_ONE_US) {
          bitState = BIT_ONE_END;
        } else {
          bitState = BIT_STARTED;
          currentByte = 0;
          bitMask = 1;          
        }     
      }
    break;
    case BIT_ZERO_END :
      bitState = BIT_STARTED;
      return;
    break;
    case BIT_ONE_END :
      bitState = BIT_STARTED;
      return;
    break;
  }

  if (receiveState == IN_TRANSMISSION) {
    if (bitState > BIT_STARTED) {
      if (bitState == BIT_ONE_END) {
        currentByte = currentByte | bitMask;      
      }  
    
      bitMask<<=1;
      
      if (bitMask == 0) {      
        if (!readQueue.IsFull()) {
          readQueue.Enqueue(currentByte);
        }                  
        
        bitMask = 1;
        currentByte = 0;      
      }      
    }
  }
  
}

uint8_t CartInterface::ReceiveHandler() {
    if (receiveState == IN_TRANSMISSION) {
        return receiveState;
    }

    // Guard: if stuck in partial identifier match for too long, the C64
    // likely crashed or aborted mid-handshake. Reset to IDLE so a fresh
    // PROT_StartTalking can succeed without power-cycling.
    if (receiveState > IDLE && receiveState < IN_TRANSMISSION) {
      if ((unsigned long)(millis() - identifierStateChangeMs) > IDENTIFIER_STALE_TIMEOUT_MS) {
#if defined(EASYSD_DEBUG_SERIAL) || defined(EASYSD_RELEASE_LOG)
        // Rate-limit log to avoid serial flood in release-log/debug modes.
        if ((unsigned long)(millis() - lastStaleIdentLogMs) > 1000UL) {
          LOGE(SYS, "Stale ident reset");
          lastStaleIdentLogMs = millis();
        }
#endif
        bitState = BIT_STARTED;
        bitMask = 1;
        currentByte = 0;
        receiveState = IDLE;
        return receiveState;
      }
    }

    if (bitState < BIT_ZERO_END) {
      return receiveState;
    }

    // A bit transfer has been finished.

    if (bitState == BIT_ONE_END) {
      currentByte = currentByte | bitMask;      
    }
  
    bitMask<<=1;
    
    if (bitMask == 0) {
      switch(receiveState) {
        case IDLE : 
        if (currentByte == IDENTIFIER_1) {
          receiveState = IDENTIFIER_1_OK;
          identifierStateChangeMs = millis();
        }
        break;
        
        case IDENTIFIER_1_OK : 
        if (currentByte == IDENTIFIER_2) {
          receiveState = IDENTIFIER_2_OK;
          identifierStateChangeMs = millis();
        } else {
          receiveState = IDLE;  // wrong byte — restart
        }
        break;

        case IDENTIFIER_2_OK :
        if (currentByte == IDENTIFIER_3) {
          receiveState = IDENTIFIER_3_OK;
        } else {
          receiveState = IDLE;  // wrong byte — restart
        }
        break;
        
        case IDENTIFIER_3_OK :
          if (!readQueue.IsFull()) {
            readQueue.Enqueue(currentByte);
          }
          receiveState = IN_TRANSMISSION;
          EnableCartridge();
          LOGI(SYS, "HS OK");  // C64 PROT_StartTalking handshake completed
        break;

        case IN_TRANSMISSION :
          // Bytes during a transmission are enqueued by ReceiveInterrupt() (ISR);
          // ReceiveHandler() must not enqueue here or the byte would be duplicated.
          break;
      }
      
      bitMask = 1;
      currentByte = 0;      
    }

    // Preserve the original edge-to-edge synchronization, but do not wedge the
    // whole main loop forever if the C64 disappears or aborts mid-byte.
    unsigned long waitStart = micros();
    while(bitState >= BIT_ZERO_END) {
      if (receiveState == IN_TRANSMISSION) break;
      if ((unsigned long)(micros() - waitStart) > 2000UL) {
        bitState = BIT_STARTED;
        bitMask = 1;
        currentByte = 0;
        receiveState = IDLE;
        break;
      }
    }

    return receiveState;
}

// Drive the EPROM page-select lines (see CartInterface.h).
void CartInterface::SetAddressPinsOutput() {
  #ifdef __AVR__
  DDRD = DDRD | B11110000; // D4-D7 as outputs: EPROM A12, A13, A14, A15
  DDRC = DDRC | B00001111; // A0-A3 as outputs: EPROM A8, A9, A10, A11
  #endif
}


// Returns the next received byte, or -1 when the queue is empty. The return
// type must stay signed: callers test `value >= 0` to tell a byte from "nothing
// available", and 0xFF is a legal data byte.
int16_t CartInterface::Read() {
  if (readQueue.IsAvailable()) {
    uint8_t val = readQueue.Dequeue();
    return val;
  } else {      
      return -1;
  }
}

void CartInterface::IOSetup() {
  // IRQHack64-style cold boot: configure the cartridge immediately, release
  // /RESET and /NMI open-collector style, and let the C64 boot on its own RC
  // reset timing. SEL is A6 with an external 10k pull-up, so no pull-up here.
  pinMode(IO2, INPUT);
  PORTD |= _BV(PD2);   // EXROM latch HIGH before enabling output.
  DDRD  |= _BV(PD2);   // EXROM HIGH: cartridge hidden.
  ResetHigh();
  NmiHigh();
  pinMode(PHI2, INPUT);
}


void CartInterface::ResetReceive() {
  bitState = BIT_STARTED;
  receiveState = IDLE;
  bitMask = 1;  
  //Discard any received items that are not consumed.
  readQueue.Reset(); 
}

void CartInterface::ResetReceiveNoStateChange() {
  bitState = BIT_STARTED;
  bitMask = 1;  
  //Discard any received items that are not consumed.
  readQueue.Reset(); 
}

void CartInterface::StartListening() {
  ResetReceive();
  attachInterrupt(digitalPinToInterrupt(IO2), CartInterface::ReceiveInterrupt, FALLING);      
}

void CartInterface::EndListening() {
  detachInterrupt(digitalPinToInterrupt(IO2));
  ResetReceive();
  DisableCartridge();
}

void CartInterface::SoftStartListening() {
  ResetReceiveNoStateChange();
  attachInterrupt(digitalPinToInterrupt(IO2), CartInterface::ReceiveInterrupt, FALLING);      
}

void CartInterface::SoftEndListening() {
  detachInterrupt(digitalPinToInterrupt(IO2));
  ResetReceiveNoStateChange();
}

void CartInterface::Init() {
  IOSetup();
  SetAddressPinsOutput();
  StartListening();
}


// Select the EPROM page the C64 reads from. This is how a byte is handed to the
// C64: the page number is the payload.
void CartInterface::SetPage(unsigned char value) {
  // Read the PORT registers (output latch state), not PIN (external signals).
  PORTD = (PORTD & 0x0F) | (value & 0xF0);
  PORTC = (PORTC & 0xF0) | (value & 0x0F);
}

void CartInterface::ResetC64() {
  ResetLow();
  delayMicroseconds(1000);
  ResetHigh();
}

void CartInterface::TransmitByteSlow(unsigned char val) {
  SetPage(val);
  NmiLow();
  delayMicroseconds(10);  //Wait for interrupt to trigger
  NmiHigh();    
  delayMicroseconds(75);  //Wait for interrupt to finish it's job 
}

void CartInterface::TransmitByteBlockEnd(unsigned char val) {
  SetPage(val);
  NmiLow();
  delayMicroseconds(6);    //Wait for interrupt to trigger
  NmiHigh(); 
  delayMicroseconds(100);  //Wait for interrupt to finish it's job
}

void CartInterface::ResetIndex() {
  transferIndex = 0;
}

void CartInterface::EnableCartridge() {
  settleBusChange();
  DDRD |= 0xF0;          // D4-D7: OUTPUT (drive data bus)
  DDRC |= 0x0F;          // A0-A3: OUTPUT (drive data bus)
  PORTD &= ~_BV (PD2);   // EXROM LOW — cartridge visible to C64
}

void CartInterface::EnableExromOnly() {
  // EXROM LOW — cartridge ROML chip (AT28C64B / M27C64A) becomes visible to
  // C64 at $8000-$9FFF (ROML active).
  // Data bus pins intentionally left as INPUT (tristate) so the cartridge ROML
  // chip can drive the data bus undisturbed. Required for the CBM80 check at
  // $8004-$8008: if data pins were OUTPUT(0x00) here, ATmega's 40mA sink would
  // override the chip's 4mA source and CBM80 detection would fail even with
  // the chip installed.
  settleBusChange();
  releasePageSelectPins();
  PORTD &= ~_BV (PD2);
}

void CartInterface::EnableDataBus() {
  // Switch data bus pins to OUTPUT — call after delay(300) CBM80 window,
  // immediately before NMI data transfers begin (SendHeader / TransmitByte*).
  settleBusChange();
  DDRD |= 0xF0;   // D4-D7: OUTPUT
  DDRC |= 0x0F;   // A0-A3: OUTPUT
}



void CartInterface::DisableCartridge() {
  settleBusChange();
  PORTD |= _BV (PD2);    // EXROM HIGH — cartridge hidden from C64
}

void CartInterface::EnterBasicSafeMode() {
  detachInterrupt(digitalPinToInterrupt(IO2));
  ResetReceive();
  DisableCartridge();
}

void CartInterface::ReleaseToBasic(bool pulseReset) {
  EnterBasicSafeMode();
  if (pulseReset) {
    ResetC64();
  } else {
    delay(2);
    ResetHigh();
  }
}

void CartInterface::ResetLow() {
  PORTB &= ~_BV(PB1);
  DDRB |= _BV(PB1);
}

void CartInterface::ResetHigh() {
  DDRB &= ~_BV(PB1);  // release /RESET
  PORTB |= _BV(PB1);  // weak pull-up only, matching original IRQHack64 style
}

// Open-collector drive: /NMI is shared with the C64, never driven HIGH.
void CartInterface::NmiLow() {
  PORTB &= ~_BV(PB0); // turn off internal pull-up
  DDRB |= _BV(PB0);   // drive LOW
}

void CartInterface::NmiHigh() {
  DDRB &= ~_BV(PB0); // switch to input while the latch is still low
  PORTB |= _BV(PB0); // then enable the internal pull-up
}

void CartInterface::TransmitByteFast(unsigned char val)
{
   SetPage(val);
   if (transferIndex==255) {
      NmiLow();
      delayMicroseconds(10); // FIX: Increased from 7µs (hardware detection minimum)
      NmiHigh();
      delayMicroseconds(80); // Wait for interrupt to finish its job
      transferIndex = 0;
   } else {
      NmiLow();
      delayMicroseconds(10); // FIX: Increased from 6µs (was too short!)
      NmiHigh();
      delayMicroseconds(50); // FIX: Increased from 31µs (handler execution time)
      transferIndex++;
   }
}


void CartInterface::TransmitByteFastStd(unsigned char val)
{
   SetPage(val);
   if (transferIndex==255) {
      NmiLow();
      delayMicroseconds(10); // FIX: Increased from 7µs (hardware detection minimum)
      NmiHigh();
      delayMicroseconds(80); // Wait for interrupt to finish its job
      transferIndex = 0;
   } else {
      NmiLow();
      delayMicroseconds(10); // FIX: Increased from 7µs
      NmiHigh();
      delayMicroseconds(50); // FIX: Increased from 40µs (safer handler execution time)
      transferIndex++;
   }
}

// MK3 audio path: 35µs inter-byte delay → ~22133 Hz fill rate.
// Must exceed C64 CIA1 rate (21894 Hz) so the ISR never laps the NMI fill.
// Block-end delay kept at 80µs (same as FastStd) for safe page-boundary handling.
void CartInterface::TransmitByteFastMK3(unsigned char val)
{
   SetPage(val);
   if (transferIndex==255) {
      NmiLow();
      delayMicroseconds(10);
      NmiHigh();
      delayMicroseconds(80); // block-end: extra margin at 256-byte boundary
      transferIndex = 0;
   } else {
      NmiLow();
      delayMicroseconds(10);
      NmiHigh();
      delayMicroseconds(35); // 35µs → 45µs/byte → 22222 Hz (avg 22133 Hz with block-end)
      transferIndex++;
   }
}

void CartInterface::StreamByte(unsigned char value)
{
    SetPage(value);

    NmiLow();
    delayMicroseconds(10); // FIX: Increased from 5µs (was too short!)
    NmiHigh();

    // Note: No delay after NmiHigh() - streaming relies on external sync
}

void CartInterface::InitTransfer()  {
  /* Cart software waits for data while page is negative */
  SetPage(0x80);    
  /* Enable cartridge so on restart rom code is executed */    
  EnableCartridge();
  /* Reset C64 */        
  ResetC64();   
}
