guyleslie/EasySD-Gemini/Arduino/EasySD/CartApi.h

#ifndef _CARTAPI_H
#define _CARTAPI_H
#include <Arduino.h>
#include <SdFat.h>
#include "DirFunction.h"
#include "CartInterface.h"

// ============================================================================
// Protocol response codes ($01-$7F = error, $80+ = success)
// ============================================================================
#define NOT_INITIALIZED       0x01
#define FILE_NOT_FOUND        0x02
#define FILE_CANNOT_BE_OPENED 0x03
#define FILE_IS_NOT_OPENED    0x04
#define FILE_WRITE_HAS_FAILED 0x05
#define WRITE_NOT_COMPLETE    0x06
#define FILE_DELETION_FAILED  0x07
#define CANT_SEEK             0x08
#define INVALID_ARGUMENT      0x09
#define NOT_IMPLEMENTED       0x0A
#define DIR_NOT_FOUND         0x0B
#define DIR_DELETION_FAILED   0x0C
#define DIR_ALREADY_EXISTS    0x0D
#define DIR_CREATION_FAILED   0x0E
#define FILE_INFO_FAILED      0x0F  // reserved; kept for protocol completeness
#define INVALID_SOURCE_TYPE   0x10
#define INVALID_CONTENT       0x11
#define SUCCESSFUL            0x80

// ============================================================================
// Command codes — must match EasySD.inc on the C64 side
// ============================================================================
#define COMMAND_READ_FILE           78
#define COMMAND_OPEN_FILE            2
#define COMMAND_CLOSE_FILE           3
#define COMMAND_WRITE_FILE           4
#define COMMAND_DELETE_FILE          5
#define COMMAND_SEEK_FILE            6
#define COMMAND_LONG_SEEK_FILE       7
#define COMMAND_GET_INFO_FOR_FILE    8
#define COMMAND_GET_PATH             9
#define COMMAND_READ_DIR            10
#define COMMAND_CHANGE_DIR          11
#define COMMAND_DELETE_DIR          12
#define COMMAND_CREATE_DIR          13
// 20, 21 retired: SET_PORT / SET_IO are sent by nothing and handled by no case.
// Numbers kept reserved (see Common/EasySD.inc) so nothing silently reuses them.
#define COMMAND_INVOKE_WITH_NAME    23
#define COMMAND_INVOKE_WITH_INDEX   24  // menu-only: launch by current page + row index
#define COMMAND_STREAM              25
#define COMMAND_NI_STREAM           26
#define COMMAND_READ_NEXT_CHUNK     27  // NMI-buffered chunk transfer (MK3 WAV path)
#define COMMAND_END_TALKING         30
#define COMMAND_EXIT_TO_MENU        31
#define COMMAND_CHANGE_DIR_INDEX    33  // menu-only: change directory by visible entry index
#define COMMAND_GET_MEMORY_STATUS   34  // menu-only: bottom status memory summary

// ============================================================================
// Seek direction constants
// ============================================================================
#define SEEK_FROM_BEGINNING 0
#define SEEK_FROM_CURRENT   1
#define SEEK_FROM_END       2

// ============================================================================
// Buffer sizes and SRAM budget
// ----------------------------------------------------------------------------
// EasySD runs on ATmega328P with only 2 KB SRAM. Cold boot stability depends on
// keeping enough stack/slack for SD init, logging, and C64 reset release.
//
// IO2 streaming, NI streaming, and command argument parsing are mutually
// exclusive at runtime. Their backing buffers are overlaid in a single union
// in CartApi.cpp (sharedBuf) so only max(128, 400, 130) = 400 bytes of SRAM
// are consumed instead of 128+400+130 = 658 bytes.
//
// Treat roughly 350 B free SRAM as the practical warning floor.
// ============================================================================
#define WRITE_BUFFER_SIZE       32
#define MAX_ARGUMENTS_LENGTH   128
#define DOUBLE_BUFFER_SIZE      64
#define NON_INTERRUPTED_BUFFER_SIZE 400

class CartApi {

 protected:
  File    workingFile;
  // Arguments buffer lives in the file-scope sharedBuf union (CartApi.cpp).
  // Declared here as a pointer so all Handle* methods can access it unchanged.
  uint8_t *Arguments;
  bool    m_argsOk;   // false after GetArguments* timeout — handler should bail

  // Keep per-byte command argument timeout short so line noise / partial frames
  // cannot stall the main loop for long periods (SEL button responsiveness).
  static constexpr uint16_t ARGS_TIMEOUT_MS = 120;

  int16_t GetByte();
  int16_t AwaitByte(uint16_t timeoutMs);
  void GetArgumentsDynamic(int16_t argumentsLength);
  void GetArgumentsStatic(int16_t argumentsLength);

  void HandleReadFile();
  void HandleOpenFile();
  void HandleCloseFile();
  void HandleWriteFile();
  void HandleDeleteFile();
  void HandleSeekFile();
  void HandleLongSeekFile();
  void HandleGetInfoForFile();
  void HandleGetPath();
  void HandleGetMemoryStatus();
  void HandleReadDirectory();
  void HandleChangeDirectory();
  void HandleChangeDirectoryIndex();
  void HandleDeleteDirectory();
  void HandleCreateDirectory();
  void HandleEndTalking();
  void HandleInvokeWithName();
  void HandleInvokeWithIndex();
  void HandleKoalaInvokeFromOpenFile(const char* returnPath);
  void HandleKoalaInvoke(char* mediaPath, const char* returnPath);
  void HandleStream();
  void HandleNonInterruptedStream();
  void HandleReadNextChunk();

  static void DoubleBufferedStreaming();

 public:
  void SendHeader(unsigned char startLow, unsigned char startHigh,
                  unsigned char transferPages, long dataLength,
                  unsigned char type, unsigned char transferMode);
  void Init();
  void HandleApi();
  void SendLoaderStub();
  void TransferMenu();
  void ResetNoCartridge();
  void LoadAndLaunchFile(const char* path, bool expectPluginSession);
  void LoadAndLaunchOpenedFile(const char* displayName, bool expectPluginSession, uint8_t entryType);
};

#endif
