guyleslie/EasySD-Gemini/Arduino/EasySD/CartInterface.h

#ifndef _CARTINTERFACE_

#define _CARTINTERFACE_
#include "Arduino.h"
#include "EasySD.h"
#include <ByteQueue.h>

// How a byte reaches the C64: the AVR does not touch the C64 data bus at all.
// D4-D7 and A0-A3 drive the EPROM address lines A8-A15, i.e. they select which
// 256-byte EPROM page the C64 sees; the C64 supplies A0-A7 and reads the EPROM
// outputs. SetPage() is therefore the data path, and "releasing the bus" means
// releasing those page-select pins, not the C64 data lines.
//
// /NMI and /RESET are shared, open-collector lines: the firmware drives them LOW
// and releases them to INPUT with the internal pull-up, never HIGH push-pull.
#define IO2 3    // D3 <- C64 /IO2 (INPUT, INT1, $DF00-$DFFF trigger detect)
#define EXROM 2  // D2 -> C64 /EXROM (push-pull OUTPUT, controls ROM visibility)
#define NMI 8    // D8 -> C64 /NMI (open-collector: LOW = drive, HIGH = release)
#define RESET 9  // D9 -> C64 /RESET (open-collector: LOW = drive, HIGH = release)
#define SEL A6         // A6 — analog-only local MENU button input; 10k pull-up to +5V, switch to GND
#define PHI2 A4        // A4 <- C64 PHI2 clock (INPUT, optional; not used by default)
// A7 (pin 21): NC on PCB — not driven by firmware
// A5 = IRQ input from C64 cartridge port (future use — not yet read in firmware)

// A6 is analog-only: no digitalRead/INPUT_PULLUP support.
// Returns true when button is released (high), false when pressed (low).
inline bool selRead() { return analogRead(SEL) >= 512; }
inline bool phi2Read() { return digitalRead(PHI2) != LOW; }

#define ONE 1
#define ZERO 0
#define BIT_WAITING  0
#define BIT_STARTED 1
#define BIT_ZERO_END 2
#define BIT_ONE_END 3

#define IDENTIFIER_1 0x64
#define IDENTIFIER_2 0x46
#define IDENTIFIER_3 0x17

#define IDLE 0
#define IDENTIFIER_1_OK 1
#define IDENTIFIER_2_OK 2
#define IDENTIFIER_3_OK 3
#define GOT_COMMAND_BYTE 4
#define IN_TRANSMISSION 5



class CartInterface {

 protected:
  //static ByteQueue readQueue;
  unsigned int transferIndex;
  //unsigned char transferBufferIndex;
  //static const unsigned char bytesPerNMI = 1;   

 
  void SetAddressPinsOutput();
  void IOSetup();
 private : 
  static void ReceiveInterrupt();
  
 public :
  static const uint8_t TransferMode = 0;
  void Init();  
  void SetPage(unsigned char value);   
  void ResetC64();
  void TransmitByteSlow(unsigned char val);
  void TransmitByteBlockEnd(unsigned char val) ;
  void ResetIndex();
  void EnableCartridge();
  void EnableExromOnly();   // EXROM LOW only — data bus stays tristate (use before ResetC64)
  void EnableDataBus();     // data bus OUTPUT — call after delay(300), before NMI transfers
  void DisableCartridge();
  void EnterBasicSafeMode();
  void ReleaseToBasic(bool pulseReset);
  void ResetLow();
  void ResetHigh();
  void NmiLow();
  void NmiHigh();  
  void TransmitByteFast(unsigned char val);
  void TransmitByteFastStd(unsigned char val);
  void TransmitByteFastMK3(unsigned char val);  // 35µs delay: 22133 Hz > C64 21894 Hz
  void StreamByte(unsigned char value);
  void InitTransfer();
  void ResetReceive();
  void ResetReceiveNoStateChange();
  void StartListening();
  void EndListening();

  void SoftStartListening();
  void SoftEndListening();
 
  int16_t Read();  
  uint8_t ReceiveHandler();    
};

#endif
