guyleslie/EasySD-Gemini/Arduino/EasySD/DirFunction.h

#ifndef _DIR_FUNCTION_H
#define _DIR_FUNCTION_H

#include <SdFat.h>

#define ENTRY_TYPE_FILE 0x00
#define ENTRY_TYPE_PRG  0x01
#define ENTRY_TYPE_CRT  0x02
#define ENTRY_TYPE_DIR  0x04
#define ENTRY_TYPE_KOA  0x08
#define ENTRY_TYPE_WAV  0x09
#define ENTRY_TYPE_CVD  0x0A

class DirFunction {

  protected:
    File m_dirFile;
    bool ResyncDirFromCwd();
    void CountEntries();
    bool FindEntrySFN(const char* prefix, uint8_t len, char* outSFN, size_t outSize, bool wantDir);

  public:
    char currentPath[64];
    uint8_t pathDepth;

    unsigned int count;
    unsigned int currentIndex;

    void ReInit(void);
    void ToRoot();
    bool GoBack();
    void Rewind();
    void Prepare();
    bool ChangeDirectory(char* directory);
    unsigned int GetCount();
    int Iterate();

    bool ChangeDirectoryBasename(const char* basename);
    bool FindDirectoryNameByVisibleIndex(uint16_t visibleIndex, char* outName, size_t outSize);
    // Walks segment-by-segment from root. May modify absPath in place
    // (null-overwrites slashes during iteration); caller's buffer must be
    // mutable.  No internal copy — saves 64 bytes of stack per call.
    bool NavigateToPath(char* absPath);
    const char* GetCurrentPath() const;
    void ForceReset();
    void CloseDirHandle();

    // Resolve a (possibly LFN) basename to its 8.3 short filename (SFN).
    // SdFat 2.x sd.open()/sd.chdir() can fail for LFN names with spaces or
    // lowercase even when the entry exists; the SFN form (e.g. PICBRA~1.KOA,
    // KOALAP~1) opens reliably for the same on-disk entry. Iterates CWD via
    // openNext (which reads LFN entries correctly), case-insensitive prefix-
    // matches the LFN, then writes the SFN into outSFN.
    // SFN max is 12 chars + NUL — outSize 16 is plenty.
    bool FindFileSFN(const char* prefix, uint8_t len, char* outSFN, size_t outSize);
    bool FindDirSFN(const char* prefix, uint8_t len, char* outSFN, size_t outSize);

    // Open a directory entry by its FAT directory-entry index and retrieve its
    // full LFN name.  Used by HandleReadDirectory's O(N) two-pass sort.
    bool GetEntryByDirIdx(uint16_t idx, char* outName, size_t outSize, uint8_t* outType);
    bool GetLFNByDirIdx(uint16_t idx, char* outName, size_t outSize, bool* outIsDir);
    bool OpenFileByDirIdx(uint16_t idx, File& outFile);

    // Preview buffer used for menu listing transport to the C64.
    // It intentionally stores only the leading part of a filename.
    char currentFileName[32];
    uint16_t currentDirIdx; // FAT dir-entry index of the last Iterate() result
    uint8_t IsDirectory;
    uint8_t IsFinished;
    uint8_t InSubDir;
};

#endif  // _DIR_FUNCTION_H
