guyleslie/EasySD-Gemini/(commit log)

2026-02-15 Initial commit: EasySD Gemini v2.1.0
    Reorganized project structure for GitHub:
    - Added root .gitignore
    - Moved documentation to docs/ (architecture, build, arduino, plugins, sprints)
    - Moved legacy tools (.exe, .cs, old .py, .bat) to Archive/
    - Moved duplicate docs from root to Archive/duplicate-docs/
    - Translated CHANGELOG and Tools/README to English
    - Rewrote README.md for GitHub audience
    - Updated CLAUDE.md file paths
2026-02-20 Add SD card test file preparation script
    Creates TESTDATA.BIN (256B, 0x00-0xFF), TESTFILE.TXT, BIGFILE.BIN (2048B),
    and TESTDIR/INNER.TXT required by the Arduino self-test suite.
2026-02-20 Add PC-side serial test runner for Arduino communication
    Provides auto, interactive, and dir_nav test modes over serial at 57600
    baud. Requires pyserial.
2026-02-20 Add v2.1.1 changelog entry
    Documents SD error recovery, self-test suite, SPI speed fix, flash
    optimization, and new test tools.
2026-02-20 Update CLAUDE.md with Arduino constraints and test tools
    Adds String class ban, SPI_QUARTER_SPEED requirement, recoverSD() rule,
    test tool references, and serial debug testing section.
2026-02-21 Fix write/delete bugs and standardize debug log format in CartApi
    HandleWriteFile: fix size_t return checked against -1 (always false),
    add sync() after each write for C64 data integrity, add getWriteError()
    check with clearWriteError() recovery.
    HandleDeleteFile/DeleteDirectory/CreateDirectory: add missing NUL
    termination of fileName (was reading random memory past buffer).
    Standardize all debug log prefixes to [TAG] format for consistency
    and flash savings (~180 bytes reclaimed).
    [CartApi.cpp]
2026-02-21 Add serial debug log prefix legend to test_arduino_comm.py
    Documents all abbreviated [TAG] prefixes used by Arduino firmware
    debug output for easier interpretation of serial monitor logs.
2026-02-21 Update GEMINI.md with SdFat write/delete API patterns and CartApi conventions
    Expands SD error handling section with write API rules (sync, size_t,
    getWriteError), delete patterns, hardware capacitor requirement, CartApi
    null-termination rule, and debug log format reference table.
2026-02-21 Add SD write/delete API reference with C64 project comparison
    Documents SdFat 2.x write flow, open flags, error handling, sync
    behavior, delete patterns, CartApi v2.1.1 bugfixes, similar C64 SD
    projects (SD2IEC, UNO2IEC, BackBit, Kung Fu Flash) comparison table,
    and hardware requirements for reliable write operations.
2026-02-22 Add PRG loading test via VICE binary monitor (tests 8-9)
    Mock PRG mechanism: in DEBUG mode, PROGRAM path copies a 13-byte stub
    to $C000 that sets sentinels ($CF50-$CF52) and JMPs back to INPUT_GET,
    testing PATHBUFFER construction without Arduino communication.
    Test 8 (PRG_SELECT_ROOT): verifies "/giana.prg" path from root.
    Test 9 (PRG_SELECT_SUBDIR): verifies "/games/bubble.prg" absolute path.
    All 9 VICE menu tests pass. Release build unaffected (zero overhead).
2026-02-22 v3.0.0: PETMATE menu frame redesign with dynamic build pipeline
    - Replace hardcoded PETSCII art frame with clean box-drawing border from PETMATE
    - Add convert_petmate_asm() to build.py: menu.asm -> menu.bin automatic conversion
    - PRGSCREENDATA now uses .binary "menu.bin" (edit in PETMATE, re-export, rebuild)
    - Switch to lowercase/uppercase charset mode for mixed-case title display
    - Remove unused PRINTTITLE routine and TITLE data
    - Interior text color: dark grey for readability
    - Update CHANGELOG, CLAUDE.md, GEMINI.md
2026-02-22 v3.0.0: Inverse selection, menu decorations, cursor key nav, uppercase filenames
    - Inverse highlight: selected file shown as reversed white text (non-space chars only)
    - Selection cursor: white solid block + $40 char at cols 2-3
    - Left-side decorations: first item ■─, middle │, last ■ (all white)
    - Cursor UP/DOWN ($91/$11) replaces +/- navigation
    - Key repeat disabled ($028A=$40) to prevent rapid scrolling
    - Filenames forced uppercase in lc/uc charset (PRINTASCIIFILENAME rewrite)
    - PETMATE color data: interior spaces all dark grey, only frame chars keep colors
    - Removed dead code: PRINTFILENAME, FROMASCII
    - Updated VICE test expected screen codes for lc/uc mode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
2026-02-28 v3.1.0: Add directory header row to file browser menu
    - Add PRINTDIRHEADER routine: displays current dir on header row 1
    as inverted /DIRNAME─■ with normal ■─ prefix decoration
    At root shows /ROOT, in subdirs shows last dirname (max 18 chars)
    Clears only up to col 25 to preserve PETMATE frame at col 26+
    - Change display order: PRINTDIRHEADER before PRINTPAGE (frame→dir→files→decorations)
    - Remove FIRST item decoration (■─) from file list: all file items
    now use MIDDLE (│ ) or LAST (■ ) style since header takes first role
2026-02-28 Fix VICE test suite: cursor key codes and screen verify
    - Fix NAV_DOWN/UP/WRAP/_navigate_to_row: replace '+'/'-' ($2B/$2D)
    with actual PETSCII cursor key codes $11 (DOWN) and $91 (UP)
    (v3.0.0 switched navigation from +/- to cursor keys, test not updated)
    - Fix SCREEN_VERIFY: navigate off row 0 before reading so CLEARARROW
    restores normal screen codes (SETARROW inverts chars on selected row)
    - Update test_screen_verify docstring: remove stale FROMASCII references,
    document correct screen layout with dir header at row 1
    - Result: 9/9 tests pass
2026-02-28 Add VICE test 10 (DIR_DEPTH): multi-level directory navigation
    - New test_dir_depth: root→/games/→/games/demos/ depth check
    Verifies CURRENTDIRINDEX=1/2 and CURPAGEITEMS=6 at each level,
    then cleans up by going back to root via '..'
    - New _go_up_one_level(expected_dirlevel): resume-first pattern
    Resumes C64 before reading CURRENTROW (avoids stale render state),
    then navigates to row 0 and injects ENTER while C64 is running,
    waits for DIRLEVEL to reach expected value via polling
    - Fix _navigate_to_row: bidirectional (UP/DOWN) instead of UP-only
    Was wrapping around entire list when target > current row;
    now correctly moves DOWN when current < target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
2026-02-28 Fix GOBACK crash when returning from 2nd directory depth
    BCC ++ in the GOBACK loop jumped to the second forward anonymous
    label, which landed in ISPREVIOUSDIRECTORY instead of the clamp
    skip target. This corrupted the stack on RTS, causing a blue screen
    READY. crash.
    The loop is only entered when CURRENTDIRINDEX > 0 (depth >= 2),
    which is why going in/out of depth-1 (/games/) worked fine while
    returning from depth-2 (/games/demos/) always crashed.
    Fix: BCC + (single forward label) correctly skips the DIRLEVEL
    clamp and falls through to DELAYFRAMES, PLA, INY as intended.
2026-02-28 Update docs and fix test_dir_depth back-navigation assertion
    docs/testing/VICE_MENU_TEST.md:
    - 9 → 10 test cases throughout
    - Cursor key codes: $2B/$2D → $91/$11 (v3.0.0 changed nav keys)
    - Add MOCK_DIR3 (/games/demos/) table
    - Add Test 10 (DIR_DEPTH) description with _go_up_one_level detail
    - Update keyboard mapping table, SCREEN_VERIFY note, example output
    - Document _navigate_to_row bidirectional behavior
    CHANGELOG.md:
    - Add v3.1.0 (directory header row) and v3.1.1 (GOBACK fix + test fixes)
    - Update version header to v3.1.1 / 2026-02-28
    - Add to version history summary
    GEMINI.md:
    - Current version v3.0.0 → v3.1.1
    Tools/test_vice_menu.py:
    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
2026-02-28 Add crash detection to VICE test suite (JAM + PC + READY. screen)
    Three-layer threading-free crash detection in _wait_for_value():
    1. JAM event (illegal opcode): passively captured in _recv_response()
    via unsolicited req_id=0xFFFFFFFF side-channel — zero overhead
    2. PC in KERNAL/BASIC ROM (>= $E000): read via REGISTERS_GET (cmd 0x31)
    3. BASIC READY. screen pattern: scan $0400-$04FF for screen codes
    [0x12, 0x05, 0x01, 0x04, 0x19, 0x2E]
    On crash detection: prints [CRASH] <reason> and immediately returns
    False, so tests fail fast instead of timing out on bad state.
    New ViceBinaryMonitor members:
    CMD_REGISTERS_GET=0x31, RESP_JAM=0x61, _EVENT_REQ_ID=0xFFFFFFFF
    crash_reason: str|None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
2026-03-01 Add STATUS_LED on pin A5 with boot and SD recovery indication
    - Define STATUS_LED = 19 (A5) in CartInterface.h
    - IOSetup(): init LED pin as OUTPUT, LOW at startup
    - Boot OK: 3 blinks (200/150ms) then LED steady ON
    - Boot FAIL: 6 fast blinks (100/100ms), LED stays OFF
    - SD recovered: 2 blinks (200/150ms), LED ON
    - SD recover FAIL: LED OFF
    - Blink sequences guarded with #ifndef EASYSD_DEBUG_SERIAL to
    preserve debug build flash budget (serial output replaces visual cues)
    - Release: 22718/30720 bytes (73%), Debug: 30630/30720 bytes (99%)
    [CartInterface.cpp, CartInterface.h]
2026-03-01 Remove LED code from debug build entirely (zero overhead in debug)
    All STATUS_LED calls now guarded with #ifndef EASYSD_DEBUG_SERIAL.
    Debug build: serial monitor covers all status info, no LED needed.
    Release: 22716/30720 (73%), Debug: 30578/30720 (99%) - unchanged.
2026-03-01 Refactor: move LED logic into dedicated StatusLed.h module
    All STATUS LED code now lives in StatusLed.h with named semantic
    functions (ledInit, ledBootOk, ledBootFail, ledSdRecovered, ledSdFail).
    Debug/release split is internal to the header - main code has no
    #ifndef guards for LED anywhere.
    CartInterface.cpp: removed LED lines from IOSetup() entirely.
    IRQHack64.ino: removed inline ledBlink(), replaced scattered #ifndef
    blocks with clean function calls. Flash unchanged: release 22716,
    debug 30578.
    [CartInterface.cpp]
2026-03-01 Cleanup: remove dead code and development history comments
    IRQHack64.ino:
    - Remove stateBoot/stateMenu/stateGame constants (never used)
    - Remove commented-out cartridgeState/transferMode variables
    - Remove SerialTestTerminal() function (never called)
    - Remove 7 commented-out legacy serial menu cases
    - Move ShowMem() inside #ifdef EASYSD_DEBUG_SERIAL block
    - Replace SPRINT N: comments with current-state descriptions
    CartInterface.h:
    - Remove EndTransfer() declaration (never defined, dead)
    - Remove duplicate Signaling/SM definitions comment
    CartApi.h / CartApi.cpp:
    - Remove SendStubLoader() (never called, only caller of undefined EndTransfer)
    IrqHack64.h:
    - Remove commented NOOUT/PATCHPROCE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
    [CartApi.cpp, CartApi.h, CartInterface.h]
2026-03-01 Cleanup: remove dead commented-out code from C64 assembly
    Deleted:
    - PrgPlugin/PrgPlugin.s.bak_sprint2 (sprint backup, git preserves history)
    - PrgPlugin/PrgPluginStub.s.bak_sprint2
    CartLib.s:
    - Remove commented-out stack debug block (TSX/STX $C100 loop, JMP/RTS manip)
    IrqLoaderMenuNew.s:
    - Remove old commented init sequence (MODULATION_ADDRESS, PROCESSOR_PORT)
    - Remove commented POSTINIT / JMP INPUT_GET
    - Remove old memory layout block (FakeCartLib includes, *=$0E00,
    GAMELIST/IRQBUFFER/CURPAGEITEMS old definitions, *=$2800 marker)
    PetsciiDisplayer.s:
    - Remove commented directory stack code (DIRSTACK, DIRNAMESLO/HI, PARENTDIR)
    - Remove test file reference (.binary "unclenash.petg")
    All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
2026-03-01 Refactor: rename BurstLoader plugin to CvidPlayer, video file to VIDEO.CVID
    - Rename IRQHack64/Plugins/BurstLoader/ → CvidPlayer/ (all files)
    - Rename BurstLoader.s → CvidPlayer.s, BurstLoaderTest.s → CvidPlayerTest.s
    - Add full CVID format specification block comment in CvidPlayer.s
    - Rename hardcoded video filename BADAPPLE.CVID → VIDEO.CVID in both .s files
    - Update build.py PLUGIN_MATRIX: BurstLoader dir → CvidPlayer
    - Update IRQ_NIStream doc comments in CartLibHi.s, CartLibHiDE.s, MyCartLibHi.s
    - Update CLAUDE.md plugin list, MACRO_ARCHITECTURE.md, SystemMacros.s references
    - Remove dead PETGLPLUGINREAD labels from CvidPlayer.s, KoalaDisplayer.s, WavPlayer.s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
2026-03-01 Add: CVID converter tool (Tools/cvid_convert.py)
    Converts MP4/AVI to C64 CVID format for the EasySD CvidPlayer plugin.
    Pure Python, requires only ffmpeg/ffprobe in PATH (no extra dependencies).
    Usage:
    python Tools/cvid_convert.py input.mp4 VIDEO.CVID
    python Tools/cvid_convert.py input.mp4 VIDEO.CVID --dither
    python Tools/cvid_convert.py --info input.mp4
    Output: flat binary, 4000 bytes/frame (10 blocks x 400 bytes).
    Supports Floyd-Steinberg dithering and configurable B&W threshold.
2026-03-01 Add: CvidPlayer plugin documentation
    Covers cvid_convert.py usage, SD card layout, C64 playback flow,
    controls, CVID file format reference, and build integration.
2026-03-01 Add: arduino-upload-isp command for USBTinyISP programmer
    Adds ISP upload support to build.py for cases where USB serial upload
    is unavailable (e.g. PCB Nano with DTR/reset issue). Uses avrdude
    directly with usbtiny programmer. Configurable SCK period via
    --isp-sck flag (default 10µs = 100kHz; use 100 for blank/slow chips).
2026-03-01 Cleanup: remove old schematic, update README
    - Delete Schematic EasySD original.png (replaced by v3)
    - Update schematic link to Schematic EasySD v3.png
    - Add CVID plugin to features list
    - Update version to v3.1.1
2026-03-01 Update README: features, hardware, build commands
    - Add cursor nav, inverse selection, directory header to features
    - Add STATUS LED feature and hardware requirement
    - Add arduino-upload-isp to Quick Start build commands
    - Add VICE test suite to documentation table
    - Fix hardware: Arduino Nano 3.x (not Pro Mini)
2026-03-01 Add: sdcard/ folder structure and SD card layout README
    - Add sdcard/README.md documenting expected SD card contents
    - Add Schematic EasySD v3.png (was missing from git)
    - Ignore sdcard/*.CVID (large generated binaries)
2026-03-01 Refactor: rename CASSETTEBUFFER→FILE_PATH_BUF, fix CvidPlayer plugin loading
    - System.inc: CASSETTEBUFFER = $033C → FILE_PATH_BUF (clearer intent)
    - All plugins and menu updated to use FILE_PATH_BUF
    - CvidPlayer.s: replace hardcoded LDA #0 with strlen loop so the
    path length is correctly sent to the Arduino (length=0 caused
    INVALID_ARGUMENT on the Arduino side)
    - CvidPlayer.s: remove dead VIDEOFILE/VIDEO.CVID data and * = $4190
    placement (the menu fills FILE_PATH_BUF before jumping to plugin)
    - CvidPlayer.s: remove unused FILENAMESHADOW = $FF00 local constant
    - build.py: rename plugin output cvidplugin → cvdplugin (.cvd extension)
    Any .cvd file can now be played by pressing Ente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
2026-03-01 Rename: irqhack64 → easysd throughout build and source files
    Source files renamed (git mv):
    IrqLoaderMenuNew.s → EasySDMenu.s
    IrqLoaderMenu.bas → EasySDMenu.bas
    Build outputs renamed:
    irqhack64.prg → easysd.prg
    irqhack64-debug.prg → easysd-debug.prg
    IrqLoaderMenu.obj → easysd.obj
    IrqLoaderMenuNew.bin/txt/vs → easysd.bin/txt/vs
    Also:
    CartApi.cpp: TransferMenu() SD override checks for easysd.prg
    Warning.s: updated user-facing text (EN + TR)
    CartLibDebug.s, test_vice_menu.py: reference comments updated
    build.py: removed sdcard populate step (plugins/ already accessible)
2026-03-01 Add: STATUS_LINE with color param, SD/VICE error display on startup
    - STATUS_LINE now takes color in A (lo/hi string in X/Y)
    - SL_WRITE + SL_COLOR internal helpers; col 3-36 only (3-char margins)
    - SD read error shown in red on IRQ_ReadDirectory / IRQ_ReadDirectoryNC fail
    - VICE debug build shows "VICE DEBUG MODE" in red at startup
    - All MSG_ strings updated with 3 leading spaces for consistent col-3 indent
    - Frame decoration (col 0-2, 37-39) preserved on every STATUS_LINE call
2026-03-01 Fix: SL_COLOR clobbered NAMELOW/NAMEHIGH/COLLOW nav ZP — caused screen corruption
    SL_COLOR used $FB/$FC/$FD as temps, but these are NAMELOW/NAMEHIGH/COLLOW —
    the navigation system's indirect screen/color RAM pointers. Rewritten to use
    no ZP at all: color saved in X register, string index in Y. Single-pass loop.
    Also fix test_vice_menu.py: PRG path updated irqhack64-debug -> easysd-debug.
    All 10 VICE tests pass.
2026-03-01 Fix: PrgPlugin IRQ_StartTalking/EndTalking protocol pairing on all error paths
    - MAIN: add IRQ_StartTalking after IRQ_DisableDisplay, route open-error to
    MAIN_ERROR_EXIT (new label) which calls IRQ_EndTalking before EXITFAIL
    - NEW_OPEN: add IRQ_EndTalking on both error paths before JMP NEW_OPEN_FINISH
    (OpenFile failure, GetInfoForFile failure)
    - NEW_CLOSE: add IRQ_EndTalking on CloseFile error path before RTS
    - NEW_CHRIN: add IRQ_EndTalking on ReadFileNoCallback error path before RTS
    Without these fixes, protocol state leaked on any file error, corrupting
    subsequent Arduino communication.
2026-03-01 Cleanup: remove SafeStream dead abstraction, direct IRQ_Stream call in WavPlayer
    SafeStream_Impl set ZP_SS_INTERVAL/CHUNK/DELAY params that Arduino firmware
    completely ignored — the abstraction had zero effect on actual streaming.
    - WavPlayer: replace LDA #STREAM_NORMAL / JSR SafeStream_Impl with JSR IRQ_Stream
    - WavPlayer, MusPlayer: remove .include SafeStreamImpl.s
    - CartZpMap.inc: free $8B-$8E (ZP_SS_OFFSET/INTERVAL/CHUNK/DELAY)
    - Delete IRQHack64/Loader/SafeStreamImpl.s
2026-03-03 ZP: Apply Sprint 11 naming convention to main project
    Rename 23 ZP variables from legacy names to ZP_<MODULE>_<CATEGORY>_<DESC>
    convention across 11 assembly files. Addresses unchanged, binary output
    identical (verified by diff against pre-rename build artifacts).
    Protocol layer ($64-$77): ZP_IRQ_WaitHandle→STATE_WAITHANDLE,
    ZP_IRQ_DATA_*/SEEK_*/CALLBACK_*/TEMP→ZP_IRQ_API_* / ZP_IRQ_TMP_SCRATCH.
    LoadFileBySize API ($80-$87): ZP_LF_*→ZP_LOADFILE_API_*.
    StreamLargeFile API ($90-$95): ZP_STREAM_TARGET_*/BYTES_REMAIN_*→ZP_STREAM_API_*.
    Also includes PrgPluginStub.s (1 var, not in original plan) and excludes
    WavPlayer.s (no ZP vars from this range). EasySDMenu.s is the correct
    main proj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
2026-03-03 Arduino: Migrate logging to EasySDLog.h (Sprint 12)
    Replace 277 Serial.print/#ifdef blocks with structured LOG macro calls using
    EasySDLog.h (7 categories, 5 levels, selective compile). Single-call macro
    design (F("[LVL][CAT] " msg) concatenation) saves 924B vs two-call approach.
    Zero functional change — debug build only.
    Debug build: 30248B (98%), 472B margin. Release: 22714B (73%), unchanged.
    Default config: SYS+SD+DIR+FILE+ERR enabled; PROTO+PRG off to fit flash.
    Follows Sprint 12 spec in docs/arduino/LOGGING_MIGRATION_COMPLETE.md
    [CartApi.cpp, DirFunction.cpp, EasySDLog.h]
2026-03-03 Docs: archive outdated B-branch logging design docs
    Move LOGGING_SYSTEM_DESIGN.md, LOGGING_MIGRATION_COMPLETE.md,
    LOGGING_SELECTIVE_CATEGORIES.md to docs/arduino/archive/.
    Superseded by LOGGING_QUICKREF.md and the actual Sprint 12
    implementation (single-call macros, measured flash sizes).
2026-03-04 C64: add CartMemoryMap.inc and Loader README from B-branch
    CartMemoryMap.inc: canonical high-memory symbols (TRANSFER_BUFFER_ADDR
    $C000, NMI_HANDLER_REGION $C1A0, BURST_BUFFER_ADDR $A000). Optional
    reference for plugin development — required for Type A/B distinction.
    README.md: documents Loader folder structure, include chain, Type A vs
    Type B app architecture, and notes CartLibDE/Transfer.65s as archives.
2026-03-04 C64: rename PrgPlugin -> KernalBridge, relocate to Loader/Bridges/
    PrgPlugin was architecturally misclassified as a plugin. It is a KERNAL
    I/O bridge: replaces OPEN/CLOSE/CHKIN/CHRIN/CLRCHN vectors so BASIC
    programs can use the SD card as device 8.
    - Add IRQHack64/Loader/Bridges/KernalBridge/KernalBridge.s (from PrgPlugin.s)
    with new descriptive header and corrected include paths (../../Loader/ removed)
    - Add KernalBridgeStub.s (archived stub, not in active build)
    - Delete IRQHack64/Plugins/PrgPlugin/ (PrgPlugin.s + PrgPluginStub.s)
    - build.py: PLUGIN_MATRIX now uses full rel_path from irq_root; output
    filename prgplugin.prg unchanged (SD card backward compatibility)
    - Loader/README.md: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
2026-03-05 Loader/CartLib: wire SystemMacros.s into chain + adopt SETBANK/WAITFOR
    - Add .include "SystemMacros.s" after CartLibCommon.s — makes Tier 1
    macros available throughout the CartLib → CartLibHi → CartLibStream chain
    - 3× SETBANK PP_CONFIG_DEFAULT (IRQ_EndTalking, ReceiveFragment ×2)
    - 2× WAITFOR ZP_IRQ_STATE_WAITHANDLE (ReceiveFragment, ReceiveFragmentNoCallback)
    Binary output identical to baseline.
2026-03-05 Loader/CartLibStream: adopt SAVEREGS/RESTOREREGS in StreamLargeFile
    Replace manual PHA/TXA/PHA/TYA/PHA and PLA/TAY/PLA/TAX/PLA sequences
    with #SAVEREGS and #RESTOREREGS macros. Macros arrive via CartLib.s chain.
    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
2026-03-05 WavPlayer: adopt SystemMacros + cherry-pick APIMacros improvements
    Macro adoption (Tier 1 via CartLibStream chain):
    - 17× SETBANK PP_CONFIG_DEFAULT/RAM_ON_ROM
    - 6+ SAVEREGS / RESTOREREGS in all interrupt handlers
    APIMacros cherry-pick from b-branch:
    - Add .include APIMacros.s
    - Replace manual IRQ_SetName+IRQ_OpenFile with #OPENFILE FILE_PATH_BUF
    - Add PETGLPLUGINREAD entry point label
    - Document IRQ_Stream parameter intent
2026-03-05 Docs: remove misleading SEL/reset note from CARTRIDGE_PROTOCOL.md
    The note incorrectly implied the /RESET line is inaccessible in the
    cartridge housing. The expansion port pin 30 is always electrically
    connected; only the Arduino onboard reset button is physically covered.
2026-03-05 Tools: archive completed sprint scripts (sprint11, sprint13)
    One-shot migration scripts moved to Tools/archive/ — sprints are done,
    no longer needed in the active tools directory.
2026-03-05 Tools: archive stale sprint docs (Sprint1, Post-Sprint6)
    SPRINT1_TEST_STEPS.txt and FILE_IO_TEST_README.md are completed sprint
    artifacts — moved to Tools/archive/.
2026-03-05 Tools: update README.md to v3.0.0
    - Add arduino-upload-isp command + ISP workflow section
    - Add cvid_convert.py and ComputeSidPlayer.prg to file structure
    - Add archive/ directory listing
    - Mark test_directory_navigation.py and test_file_io.py as legacy
    - Fix build system version v2.2.0 → v3.0.0
    - Update date to 2026-03-05
2026-03-05 Docs: rewrite README.md — accurate, structured, professional
    - Plugin table: correct names (KernalBridge not PRG), add CVID rate
    - Hardware: add capacitor requirement, SRAM constraint note
    - Architecture: document both transfer mechanisms (NMI ~40KB/s, IO2 ~13.5KB/s)
    with table; add two-tier macro system description
    - Project structure: add Bridges/KernalBridge, CartZpMap.inc, SystemMacros.s
    - Docs table: add CARTRIDGE_PROTOCOL.md, MACRO_ARCHITECTURE.md
    - Quick Start: add ISP upload example with --isp-sck flag
    - Remove stale footer line (version now in header)
2026-03-05 Refactor: rename IRQHack64 folders and sketch files to EasySD
    - git mv IRQHack64/ → EasySD/ (C64 source tree)
    - git mv Arduino/IRQHack64/ → Arduino/EasySD/ (Arduino sketch)
    - git mv IRQHack64.ino → EasySD.ino (Arduino requires folder=sketch name)
    - git mv IrqHack64.h → EasySD.h (main Arduino header)
2026-03-05 Refactor: fix include references after header rename (IrqHack64.h → EasySD.h)
    Update #include directives in EasySD.ino, CartInterface.h, DirFunction.cpp
    to reference the renamed main header EasySD.h.
    [CartInterface.h, DirFunction.cpp, EasySD.ino]
2026-03-05 Refactor: update build.py and test_vice_menu.py for renamed folders
    - build.py: replace all IRQHack64 references with EasySD
    (root detection, irq_root/arduino_root vars, print messages, HEX path,
    description string, docstring)
    - test_vice_menu.py: BUILD_DIR → EasySD/build
2026-03-06 Docs: update IRQHack64 → EasySD references in all doc files
    Follow-up to the folder rename refactor (commits 1a4be2d–e396c94).
    Updates path references in CHANGELOG, CLAUDE, GEMINI, README, Tools/README,
    and all docs/ markdown files.
2026-03-06 Docs: correct CARTRIDGE_PROTOCOL — data bus driven by Arduino outputs, not IO1 latch
    SetPage() drives the C64 data bus directly via Arduino D4-D7/A0-A3 (PORTD/PORTC
    outputs). Both $80AB (NMI) and $DE00 (streaming) reads return the current value
    because Arduino outputs are the sole bus driver at those addresses. Removed
    incorrect IO1/hardware-latch description throughout.
2026-03-06 Refactor: rename addressPins → dataPins in TransferConstants.h
    These pins (D4-D7, A0-A3) drive the C64 data bus, not address lines.
    The old name was misleading about the hardware role.
2026-03-06 Docs: fix IO1 latch reference in README protocol table
    Arduino drives the C64 data bus directly (D4-D7, A0-A3 outputs),
    not through an IO1-gated latch.
2026-03-07 Refactor: rename CvidPlayer → CvdPlayer, CVID format → CVD throughout
    The custom C64 video format is named CVD, not CVID. Changes:
    - Rename EasySD/Plugins/CvidPlayer/ → CvdPlayer/ (folder + source files)
    - Rename CvidPlayer.s → CvdPlayer.s, CvidPlayerTest.s → CvdPlayerTest.s
    - Rename Tools/cvid_convert.py → cvd_convert.py
    - Rename docs/plugins/EasySD_CvidPlayer.md → EasySD_CvdPlayer.md
    - Update build.py plugin entry (folder + source name)
    - Replace all CVID/CvidPlayer/cvidplugin references with CVD/CvdPlayer/cvdplugin
    in source comments, docs, README, CLAUDE.md, CHANGELOG, CARTRIDGE_PROTOCOL,
    MACRO_ARCHITECTURE, MEMORY_MAP_CANONICAL, SystemMacros.s, sdcard/README.md,
    Tool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
2026-03-07 Docs: fix CvdPlayer file selection — path from menu, not hardcoded
    CvdPlayer reads the file path from FILE_PATH_BUF (set by the EasySD menu
    when the user presses Enter on a .cvd file). Any CVD file anywhere on the
    SD card can be played — no hardcoded filename. Update source comment,
    plugin doc, and sdcard/README accordingly.
2026-03-08 Archive: move CvdPlayerTest.s to Archive — superseded by CvdPlayer.s
    Standalone debug build with hardcoded VIDEO.CVD path, never part of the
    build system. Production plugin (CvdPlayer.s) reads path from FILE_PATH_BUF.
2026-03-08 Archive: move inactive CvdPlayer files to Archive
    MyCartLibHi.s — superseded by shared Loader/CartLibStream.s
    IRQTemplate.tpl, NMITemplate.tpl, ColorFill.tpl — code generation templates
    used to produce NMI.s (sprint13 scripts already archived)
    MemUsage.txt — old memory map reference note
    Active files remaining: CvdPlayer.s, FGStuff.s, Common.s, NMI.s
2026-03-08 Fix: enable EEPROM (ROML) during HandleStream for WavPlayer
    HandleStream() was not calling EnableCartridge() before starting
    the DoubleBufferedStreaming ISR. With EXROM=HIGH (state left by
    prior NMI transfers), LDA CARTRIDGE_BANK_VALUE ($80AB) in the
    WavPlayer CIA interrupt handler reads RAM instead of EEPROM,
    producing silence on real hardware.
    Fix: call EnableCartridge() (EXROM LOW) before attachInterrupt()
    and DisableCartridge() (EXROM HIGH) at the streaming exit, matching
    the pattern used by all other NMI transfer functions.
    Also fix pre-existing include: IrqHack64.h → EasySD.h in
    CartApi.cpp and CartInterface.cpp (missed by the earlier rename
    commit ca31634).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
    [CartApi.cpp, CartInterface.cpp]
2026-03-08 Feat: add WavPlayerViceTest — standalone VICE audio pipeline test
    - WavPlayerViceTest.s: standalone PRG ($0801) that tests the full
    CIA1 Timer A + SHIFT4BIT + SID master volume chain without Arduino.
    Generates a ~430 Hz sawtooth tone at 11025 Hz sample rate.
    Visual confirmation via border color cycling. STOP key exits.
    - build.py: add VICE_TESTS matrix and build_vice_tests() function.
    debug-vice target now builds standalone VICE test PRGs to
    EasySD/build/vice-tests/. No -b flag: 64tass emits valid PRG header.
2026-03-08 Docs: update CHANGELOG v3.1.2 and CARTRIDGE_PROTOCOL for WavPlayer fix
    - CHANGELOG.md: add v3.1.2 entry documenting the EXROM/HandleStream fix,
    WavPlayerViceTest, build.py VICE_TESTS matrix, and include rename fix.
    - CARTRIDGE_PROTOCOL.md: add EXROM requirement note in HandleStream()
    foreground code block — EnableCartridge() must be called before
    attachInterrupt() so WavPlayer's CIA ISR can read $80AB from ROML.
2026-03-08 Docs: add EEPROM_ARCHITECTURE.md
    Describes both EEPROM concepts in the EasySD project:
    - Physical 64KB cartridge chip (PCB): SetPage mechanism, EXROM control,
    64KB page layout, IRQLoaderRom.bin build artifact, write-only via programmer.
    - Arduino internal 1KB EEPROM: IRQ_ReadEeprom/WriteEeprom/SeekEeprom API,
    implemented but unused (ready for settings storage).
2026-03-08 Feat: persist last-visited directory in Arduino internal EEPROM
    On every successful directory navigation (COMMAND_CHANGE_DIR and legacy
    GoBack/ChangeDirectory path), CartApi::SaveLastDir() writes the current
    absolute path to the ATmega328P internal EEPROM (bytes 0-1: magic 0xE5/0xD0,
    bytes 2+: null-terminated path string, max 64 bytes).
    On boot, CartApi::RestoreLastDir() reads the saved path and navigates
    there segment by segment before the C64 menu starts. Invalid/absent magic
    bytes are silently ignored — safe on fresh chips.
    Uses EEPROM.update() (write-only-if-changed) to respect the 100k
    write-cycle endurance limit. Flash cost: +500 bytes (75% total).
    SRAM free: 774 bytes (unchanged).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
2026-03-08 Feat: add PrgLoadViceTest — standalone VICE PRG loading pipeline test
    Tests the core KernalBridge load sequence without Arduino hardware:
    1. Parse 2-byte little-endian load address from embedded MOCK_PRG header
    2. Copy payload bytes to load address (simulates NMI byte transfer)
    3. Jump via ZP indirect ($FB/$FC), return via pre-pushed RTS address
    4. Visual confirmation: Yellow->Blue->Green->LightBlue border phases
    Output: build/vice-tests/prgtest.prg (debug-vice target)
2026-03-09 Feat: add P2TK — Phase 2 Transfer Kernel for large machine-code PRGs
    KernalBridge lives at $C000-$CFFF; a single-phase load of a PRG whose
    payload extends into $C000+ would overwrite the running loader mid-transfer.
    P2TK solves this by splitting the load into two phases:
    Phase 1 — LoadFileBySize(SIZE=$C000-STARTADDR, SKIP=2) fills STARTADDR..$BFFF
    Phase 2 — writes an 8-byte poll stub to $E000 RAM, a 7-byte Launcher to
    $0334, sets the hardware NMI vector ($FFFA/$FFFB) directly to
    CARTRIDGENMIHANDLERX1 ($80AF), then switches $01=$35 (HIRAM=0,
    $E000 RAM visible) and enters the stub.
    TransferHandler fires via NMI → writes $C000+ via ZP indirec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
2026-03-09 Feat: P2TK Phase 3 — full-range PRG loading to \$FFFF + 3 bug fixes
    Bug fixes:
    - \$01=\$35 → \$01=\$34 in DO_P2TK: \$D000-\$DFFF writes now reach RAM
    - BVC wait-stub relocated \$E000 → \$033B (FILE_PATH_BUF area):
    prevents overwrite by programs extending to \$E000+
    - FILE_PATH_BUF naming: "Cassette buffer" comments corrected
    New feature — Phase 3 tail-write protection:
    - Activates when Phase2_pages=64 (data fills \$FF00-\$FFFF)
    - P3_HANDLER (\$036A): NMI handler that saves \$FFFA-\$FFFF bytes
    to TAIL_BUF (\$03BB) instead of writing them mid-transfer,
    preventing active NMI vector corruption
    - P3_TAIL_CODE (\$0343): copies TAIL_BUF → \$FFFA-\$FFFF after
    transfer, then falls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
2026-03-09 Docs: update README, GEMINI, CARTRIDGE_PROTOCOL, MUS plugin for v3.1.3
    - README.md: bump version to v3.1.3/2026-03-09; fix KernalBridge plugin
    description (LOAD/SAVE → OPEN/CLOSE/GET#, add P2TK note); remove TAP from
    plugin table (it's Arduino firmware + menu, not a /PLUGINS/ plugin); fix
    Plugins/ directory comment
    - CARTRIDGE_PROTOCOL.md: remove CvdPlayer from Mechanism 2 (IO2 streaming)
    — CvdPlayer uses Mechanism 2b (READCART_MODULATED), not StreamLargeFile
    - GEMINI.md: bump version, fix arduino-upload command, fix CHANGELOG ref,
    update sprint doc references, update Last Updated / Status footer
    - EasySD_MUS_Plugin.md: update project name (IrqHack64 → EasySD Gemini)
    and da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
2026-03-10 Test: add automated VICE PRG load test suite (PrgLoadViceTest + test_vice_prgload.py)
    Extends PrgLoadViceTest.s to cover P2TK trigger logic, Phase2_pages
    calculation, Phase 3 setup (copy loops + NMI vectors), and normal NMI
    vector path. Sentinel-based automation ($CF60-$CF8F) replaces the old
    interactive STOP-key poll. Mock PRG reduced to 11 bytes (immediate RTS).
    New test_vice_prgload.py runner with 6 test suites:
    - BINARY_CHECK: verifies P3_TAIL_CODE/P3_HANDLER in prgplugin.prg (no VICE)
    - PIPELINE: parse → copy → execute flow
    - P2TK_TRIG: 4 ENDADDRESS boundary cases ($C000/$C002/$C003/$D000)
    - PAGES_CALC: Phase2_pages calculation for ENDADDR=$FFFF (expects $40)
    - PHASE3_SETUP: BVC st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
2026-03-10 Fix: simplify GOBACK — remove root+replay loop, send single ".." command
    The old GOBACK routine sent ".." to the Arduino then replayed the entire
    DIRSTACK from index 0, re-entering every parent directory. This was a
    workaround for an old SdFat limitation where cd("..") was not supported.
    The Arduino's GoBack() already handles single-step-up correctly via
    sd.chdir(parentAbsPath). A single ".." command is sufficient; the loop
    was redundant and added latency proportional to directory depth.
    DIRSTACK is preserved — it is still used for header display and
    BuildAbsolutePathFromPtr (plugin launch path construction).
    Also updates ARCHITECTURE_REVIEW.md to accurately describe the mechanism
    and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
2026-03-11 Refactor: Arduino is single source of truth for current path
    - Add COMMAND_GET_PATH (cmd 9): Arduino sends currentPath as 256-byte page
    - Add IRQ_GetCurrentPath on C64: queries COMMAND_GET_PATH, copies 64 bytes
    into PATHBUFFER via PLUGIN_HEADER scratch buffer
    - Add ExtractLastDirname: extracts last path component from PATHBUFFER
    - Remove DIRSTACK, PUSHDIRNAME, POPDIRNAME, BuildAbsolutePathFromPtr:
    C64 no longer maintains a shadow copy of the directory path
    - Remove FILENAMESHADOW, DIRSTACKTEMP, CURRENTDIRINDEX, PATHLEN variables
    - Update .gitignore: add EasySD/ paths (was only covering old IRQHack64/ names)
    and add Tools/__pycache__/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
    [CartApi.cpp, CartApi.h]
2026-03-11 Docs: update ARCHITECTURE_REVIEW directory navigation section
    Section 3.2: rewrite to reflect new single-source-of-truth model —
    Arduino owns currentPath, C64 queries via COMMAND_GET_PATH +
    IRQ_GetCurrentPath. DIRSTACK mirror eliminated.
    Section 5: update path limit note — effective limit is now Arduino's
    64-byte currentPath buffer (was C64-side PATH_MAX of 96 chars).
2026-03-11 Refactor: realistic mock with live MOCK_CURRENT_PATH, share path logic in menu
    EasySDMenuMock.s:
    - Add MOCK_CURRENT_PATH (65-byte buffer, mirrors Arduino currentPath format)
    - Add MOCK_GetCurrentPath (copies to PATHBUFFER, transparent to callers)
    - Enhance MOCK_EnterDir: append dirname to MOCK_CURRENT_PATH with correct '/' logic
    - Add MOCK_GoBack: decrement DIRLEVEL + truncate path, mirrors Arduino GoBack()
    - Remove MOCK_SetDirname, MOCK_PrepareFilePath, MOCK_DIRNAME_L1/L2, MOCK_PATH_L0/1/2
    EasySDMenu.s:
    - PRINTDIRHEADER: only path-fetch JSR is conditional; ExtractLastDirname now
    runs in DEBUG mode too — same root/subdir logic in both modes
    - PrepareFileNameParameter: only path-fetch JS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
2026-03-11 Docs: rewrite README for non-technical audience
    Complete rewrite of the main README. New structure:
    - Plain-language intro (what it does, how it works)
    - Component list with notes
    - SD card layout example
    - Build/flash instructions with prerequisites table
    - Status LED reference
    - Troubleshooting section
    - Developer architecture in collapsed <details> block
    Removes heavy technical content from the top level;
    keeps it accessible to C64 retro enthusiasts.
2026-03-11 Docs: add hardware PCB photo to README
2026-03-11 Docs: correct directory depth limit (path buffer 64 bytes, not 10 levels)
    The 10-level claim was documentation-only; no such constant exists in code.
    The actual limit is the Arduino-side currentPath[64] buffer: ~7 levels
    with 8-char folder names, more with shorter names.
2026-03-11 Docs: replace Sprint 1 changelog with current-state DIR_NAVIGATION_API reference
    Archive the old Sprint 1 change log (DIR_NAVIGATION_API_sprint1.md).
    Write a new reference document describing the actual current behaviour:
    - All DirFunction methods with parameters, return values, behaviour
    - currentPath[64] as the real depth limit (no hardcoded max)
    - ResyncDirFromCwd() design principle documented
    - CartApi error codes table
    - SD error recovery pattern
2026-03-11 Docs: add TIMING.md — timing reference for all Arduino↔C64 transfer mechanisms
    Isolates all timing-critical values and their code locations in one document.
    Covers NMI transfer (TransmitByteFast/Slow/BlockEnd), IO2 streaming 4µs window,
    CvdPlayer STARTRASTER=241 (PAL-only), WAITFOR infinite-loop risk, and tuning history.
2026-03-11 Docs: add Nano Every + SRAM upgrade design study
    Hardware design study for next PCB revision:
    - Arduino Nano Every (ATmega4809): 6KB SRAM, 48KB flash, 20MHz
    - 6264 SRAM replacing AT27C512 EEPROM (boot-time write via Arduino)
    - Accurate ATmega4809 port/bit mapping from official pins_arduino.h
    - Data bus solution: lower nibble unchanged (A0–A3→PORTD), upper nibble on PORTF[5:2]
    - Address counter IC (74HC4040+74HC244) for SRAM init with 3 extra pins
    - Flash budget, software migration scope, open timing questions
2026-03-13 Fix: reduce debug build flash to 30684B (36B margin)
    Replace byte-by-byte EEPROM loops with eeprom_update_block/eeprom_read_block,
    simplify RestoreLastDir path parser, remove low-value debug log calls from
    SaveLastDir/RestoreLastDir/HandleGetPath/TransferMenu. Fixes overflow (was
    30860B, limit 30720B).
    [CartApi.cpp]
2026-03-13 Docs: add PCB_BRINGUP_NOTES — first hardware bringup findings
    Documents three issues found during first PCB test session (2026-03-13):
    debug build flash overflow and fix, USB upload DTR failure + ISP workaround,
    SD card init failure due to USB-only power and capacitor requirements.
2026-03-13 Docs: update CLAUDE.md — ISP upload, macro tiers, corrected file names
    Add ISP upload notes (erases bootloader, 36B debug flash margin warning),
    document macro tier separation (SystemMacros.s vs APIMacros.s), fix
    IrqLoaderMenuNew.s → EasySDMenu.s and IRQHack.inc → EasySD.inc, add
    EEPROM last-dir persistence constraint, update ZP map ($8B-$8E now free).
2026-03-13 Docs: fix stale IRQHack64 and IrqLoaderMenuNew.s references
    Full audit of non-archive documentation. Replaced:
    - 'IRQHack64' project/firmware name → 'EasySD' in titles, descriptions, paths
    - 'Arduino/IRQHack64/' paths → 'Arduino/EasySD/' in all non-archive docs
    - 'IrqLoaderMenuNew.s' → 'EasySDMenu.s' in all references
    - '$8B-$8E SafeStream params' ZP entry → '(reserved, unused)' (params removed)
    - 'irqhack64.prg' → 'easysd.prg' in BUILD_SYSTEM.md
    Sprint/archive docs left unchanged (historical context).
2026-03-13 Docs: clarify flash budget — release has ~8KB free, debug limit is temporary
    Production target is the release build (22.7KB/30.7KB, ~8KB free). Debug build
    margin (36B) is a testing-phase constraint only — in production all debug code
    is stripped: no serial output, no log strings, full budget reclaimed.
2026-03-14 Fix: ISP upload hex path — use --output-dir to get hex at known location
    arduino-cli stores compiled output in a content-addressed AppData cache
    directory whose path is not predictable. Pass --output-dir to arduino_compile
    when called from arduino_upload_isp so the hex lands at
    Arduino/EasySD/build/arduino.avr.nano/EasySD.ino.hex as expected.
2026-03-14 Docs: update README with EasySD v3 PCB render image
    Replace placeholder hardware.jpg with the actual PCB v3 render (PNG),
    update image alt text and caption to match v3 layout.
2026-03-14 Refactor: simplify logging to LOGI/LOGE only, saving ~1.3KB flash
    Remove LOGD/LOGW/LOGT levels from EasySDLog.h — only LOGI and LOGE
    remain. Drop verbose per-function entry LOGD calls throughout CartApi
    and DirFunction. Remove redundant #include <SPI.h> from CartInterface.h.
    Update version string to v3.1.3.
    Debug build: 30684B (99%) → 29416B (95%), ~1.3KB freed.
2026-03-15 Fix: log SD error code and data on init failure
    [EasySD.ino]
2026-03-15 Build: Optiboot, auto bootloader burn, build summary, encoding fix, faster ISP
    - Switch FQBN to atmega328 (Optiboot, 115200 baud upload)
    - arduino-upload-isp now burns Optiboot bootloader by default after firmware
    (--no-bootloader flag to skip); USB upload works immediately after ISP
    - ISP default SCK changed from 10µs to 2µs (500kHz, ~3x faster)
    - Add BUILD SUMMARY box at end of compile/upload (flash & RAM usage)
    - Fix Windows console encoding (CP1252→UTF-8) so Hungarian chars display correctly
    - Remove stale docs/build/BUILD_SYSTEM.md
2026-03-15 Perf: upgrade SPI to HALF_SPEED, all 8 breadboard tests pass
    Switch from SPI_QUARTER_SPEED to SPI_HALF_SPEED (4→8 MHz) for SD
    communication. Verified stable on breadboard: 8/8 self-tests pass
    including WR_DEL. Update all docs and test result references.
2026-03-15 Cleanup: restore standard SOFT_SPI pin order in SdFatConfig.h
    The original IRQHack64 PCB had MOSI/MISO physically swapped, and the
    soft SPI pin constants (MOSI=12, MISO=11) were set in reverse to
    compensate. Since our PCB corrects the hardware and SD_SPI_CONFIGURATION=0
    (hardware SPI only), these constants are dead code — but misleading.
    Restored to standard Arduino values (MOSI=11, MISO=12).
2026-03-15 Feature: add multi-load game support (Sprint 14)
    Installs a resident LOAD hook ($0330/$0331 → $033C stub → $E800 handler)
    that intercepts JSR $FFD5 for device 8 and serves PRG parts from the SD
    card via EasySD CartLib, enabling classic multi-load C64 games.
    New files:
    - EasySD/Loader/ResidentLoader.s — RL_STUB + RL_HANDLER images + RL_INSTALL
    - EasySD/Loader/Bridges/MultiLoad/MultiLoad.s — BOOT.PRG plugin (game launcher)
    Modified:
    - EasySD/Loader/Common/System.inc — RL_* constants, V_LOAD, RL_HANDLER note
    - EasySD/Loader/CartZpMap.inc — document $033C-$035F dual-use, $8B-$8E scratch
    - Tools/build.py — multiload target, bootplugin in PLUGIN_MATRIX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
2026-03-15 Docs: add MultiLoad plugin documentation (Sprint 14)
    New file:
    - docs/plugins/EasySD_MultiLoad_Plugin.md — full reference: purpose,
    RL_STUB/RL_HANDLER/RL_INSTALL components, memory layout, boot flow,
    SD directory structure, configuration, build targets, V1 limitations,
    technical notes on banking and first-page read strategy.
    Updated:
    - docs/architecture/MEMORY_MAP_CANONICAL.md (v2.3): new Section 3.3
    for ResidentLoader memory regions ($033C RL_STUB, $E800 RL_HANDLER),
    MultiLoad added to Type A plugin list and audit notes, revision entry.
    - docs/architecture/MACRO_ARCHITECTURE.md: MultiLoad added to Adopters
    table (uses GETFILEINFO from Tier 2).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
2026-03-16 Docs: update KERNAL_BRIDGE.md with correct addresses; archive outdated PRG doc
    KERNAL_BRIDGE.md:
    - Memory layout table corrected: data variables are at $C060-$C17D
    (relocated from $D000+ in Sprint 11), not in a zero-filled gap.
    Added per-symbol address table (GENERALBUFFER=$C070, FILELENGTH=$C170, etc.)
    - Known Limitations: corrected "binary overflow" entry — only the code
    section ($C700-~$D113) extends past $D000; data variables are fixed.
    - New section: "Overlap with MultiLoad RL_STUB" — documents mutual
    exclusion of Phase 2 wait-stub ($033B-$0342) and RL_STUB ($033C+).
    Archived:
    - docs/plugins/EasySD_PRG_Plugin.md → docs/archive/EasySD_PRG_Plugin_ARCHIVED.md
    (Hungarian, o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
2026-03-16 Feature: MultiLoad V2 — fix 5 bugs, add create_multiload.py tool (Sprint 15)
    V2 fixes all known V1 bugs for reliable multi-load game support:
    1. Banking crash fix: RL_MINI_CARTLIB embedded in handler image ($E800+) with
    NO #SETBANK anywhere; RL_NMI_REDIRECT (JMP $0318) at $0368 written to RAM
    $FFFA/$FFFB by RL_INSTALL — NMI dispatch works correctly under $01=$35.
    2. CartLib overwrite fix: mini-CartLib lives at $E800+ (Kernal ROM area),
    immune to games loading parts into $C000+.
    3. SA=0 (MEMUSS) support: RL_STUB saves X/Y to RL_SAVED_X/Y; handler checks
    KERNAL_SECONDARY_ADDRESS ($B9) and uses saved X/Y as load target when SA=0.
    4. Per-game config without recompile: config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
    [CartApi.cpp, CartApi.h, DirFunction.cpp, DirFunction.h]
2026-03-17 Feature: add protocol echo test mode for Arduino serial verification
    Adds EASYSD_PROTOCOL_TEST build target that redirects SD file data to
    Serial.write() for PC-side byte verification without requiring a real C64.
    - EasySD.ino: testFileDump (F), testGameHeader (G), testBoundaryDump (B)
    commands; mirrors TransferGame/SendHeader header calculation exactly
    - build.py: protocol-test target (compile or compile+upload with port arg);
    disables LOG_ENABLE_DIR/FILE to reclaim ~600B flash headroom
    - test_arduino_comm.py: test_file_dump, test_game_header, test_boundary_dump
    methods + run_protocol_tests(); --test protocol/file_dump/game_header/boundary_dump CLI
    - prepare_test_sd.py: adds TESTPRG.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
2026-03-17 rename: IRQ_ → PROT_ across all active assembly files
    Replace all CartLib function names from IRQ_ prefix to PROT_ (protocol)
    across 15 active .s files. The IRQ_ prefix was historically misleading —
    the protocol no longer uses the IRQ line; PROT_ is accurate and
    self-documenting.
    ZP variable names (ZP_IRQ_*) and the ROM_IRQ_HANDLER system label are
    intentionally preserved — only CartLib API function names are renamed.
    Verified: `python Tools/build.py plugins` + `python Tools/build.py core`
    both pass with zero errors.
2026-03-21 hw: remap IO2/EXROM/SEL/STATUS_LED for PCB v3
    PCB v3 pin changes vs old firmware:
    - IO2: D2 (INT0) → D3 (INT1); PIND bitmask 0x04 → 0x08
    - EXROM: D3 (PD3) → D2 (PD2); PORTD bit in Enable/DisableCartridge()
    - SEL button: A4 (pin18, now PHI2 reserved) → A6 (analog-only);
    digitalRead(SEL) → selRead() (analogRead(A6) >= 512);
    remove pinMode/internal pullup, external 10k pullup used
    - STATUS_LED: A5 (now IRQ reserved) → A7 (pin21, NC)
    Update docs: CARTRIDGE_PROTOCOL.md, EEPROM_ARCHITECTURE.md, TIMING.md
2026-03-28 WavPlayer: add DigiMax MK3 auto-detection and streaming mode
    - EasySD/Plugins/WavPlayer/WavPlayer.s:
    - Add MK3_ACTIVE ($FB) and DETECT_TIMEOUT ($FC) ZP constants
    - Add DETECT_MK3 routine with loop-counter timeout (~60 ms per phase);
    no jiffy clock dependency — safe after KILLCIA disables CIA1 interrupts
    - Insert JSR DETECT_MK3 in SetupBoth and SetupDigimax after NMIDIGI_InitNew
    - Polling uses CIA_2_BASE + CIA_INT_MASK ($DD0D) bit 4 (FLAG2 edge)
    - Phase 1: magic seq $AC $DE $AD $BE → ≥1 FLAG2 pulse confirms MK3 present
    - Phase 2: config bytes $01 (mono) + $40 (1024-byte autostart) →
    3 confirm pulses → MK3_ACTIVE = 1; PlayDigimax handler unchanged
    - docs/plugins/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
2026-03-29 WavPlayer v2: MK3 multi-mode (22K mono, stereo) + wavtodigimax presets
    - Fix PLAYTYPE mapping bug: ShowModeSelector now uses MODE_PLAYTYPE_TABLE
    (cursor index 2 was yielding PLAYTYPE_BOTH instead of PLAYTYPE_MK3)
    - Add PLAYTYPE_MK3_22K=4 (22050 Hz mono, CIA=44) and PLAYTYPE_MK3_STEREO=5
    (11025 Hz stereo, CIA=44, frame_size=2)
    - Add MK3_ConfigureMode: reconfigures MK3 FIFO via SP2 extended commands
    (CMD_FLUSH_FIFO, CMD_SET_RATE_L/H, CMD_SET_FRAME_SIZE, CMD_STREAM_PUSH)
    - Add SP2 helpers: MK3_SP2_HIGH, MK3_SP2_LOW, MK3_SendCmd
    - Add ZP_WAV_TIMERLO ($91) for parameterized CIA1 timer
    - Expand mode selector to 6 items (3 base + 3 MK3-only)
    - wavtodigimax.py: add --mode {11k,22k,stereo} pres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
2026-03-29 Arduino: add COMMAND_READ_NEXT_CHUNK (cmd 27) for WavPlayer MK3 path
    Implements HandleReadNextChunk(): reads numPages*256 bytes from the open
    file and pushes them to the C64 via NMI (TransmitByteFastStd). Sends a
    status byte first (0x80=more data, 0x81=last block), then transmits with
    interrupts disabled. Pads with 0x80 (silence) if file is shorter than
    the requested block size.
    Registers the command in HandleApi() dispatch and adds the #define to
    CartApi.h alongside COMMAND_NI_STREAM=26.
    [CartApi.cpp, CartApi.h]
2026-03-29 fix: WavPlayer MK3 mode3 no-op + mode4 wrong OCR1A; update pin docs
    MK3_ConfigureMode bugs fixed:
    - Mode 3 (PLAYTYPE_MK3): was BEQ MCM_Done (no-op) — MK3 stayed in
    PARSER_IDLE, FIFO path never activated. Fixed: sends CMD_FLUSH_FIFO
    then CMD_STREAM_PUSH using detection defaults (frame_size=1, OCR1A=1450).
    - Mode 4 (PLAYTYPE_MK3_22K): rate sequence sent 4 bytes
    (CMD_SET_RATE_L, 0xD5, CMD_SET_RATE_H=0x21, 0x02). Protocol
    arg-collection ignores is_cmd → 0x21 consumed as OCR1A high byte →
    OCR1A=8661 instead of 725 → wrong playback rate + CMD_ERROR + C64 hang.
    Fixed: CMD_SET_RATE_L takes exactly 2 arg bytes; drop CMD_SET_RATE_H
    opcode: (CMD_SET_RATE_L, 0xD5, 0x02) → OCR1A=0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
    [CartInterface.h]
2026-03-29 hw: update PCB and schematic images for new PCB revision
    Updated PCB layout and schematic to reflect current ordered PCB:
    A5=IRQ, A4=PHI2, A6=MENU/RESET (10k pull-up to +5V), LED on 5V rail.
2026-03-29 feat: add --mode sid to wavtodigimax.py for SID/DigiMax compat playback
    Adds convert_sid_optimized() with a processing pipeline tailored to the
    C64 SID 4-bit DAC (PLAYTYPE_ONLYSID) and original DigiMax compat modes:
    - ffmpeg HP filter at 80 Hz removes DC offset (prevents start/end pops)
    - dynaudnorm maximises loudness within 4-bit dynamic range
    - TPDF dithering before 4-bit quantisation reduces quantisation noise
    - 50 ms fade-in/fade-out to mid-scale (value=8) prevents transient pops
    Output stores the 4-bit value in the upper nibble (byte = val << 4),
    matching WavPlayer's SHIFT4BIT table (SHIFT4BIT[n] = n >> 4 → $D418).
    docs/plugins/WavPlayer.md: add hardware quick-start table an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
2026-03-29 docs: fix README errors — LED pin, cap values, EEPROM size, FlashLib note
    - LED: A5 → A7 (NC); clarify LED is hardware-driven from 5V rail (always on),
    not Arduino-controlled; remove misleading blink table
    - Capacitor: 100 µF → 100 nF ceramic + 10–47 µF electrolytic, both at SD VCC/GND
    (same fix applied in Hardware table and Troubleshooting section)
    - EEPROM size: "512 KB" → "512 Kbit (64 KB)" in How it works section
    - Flash the Arduino: remove incorrect "FlashLib.h → burned to EEPROM" note;
    replace with cross-reference to the Flash the EEPROM section below it
2026-03-29 docs: fix capacitor range — 10–47µF → 10–100µF (100µF is valid)
2026-03-29 docs: fix stale IRQ_→PROT_ renames + add MK3 timing section
    IRQ_ function name cleanup (all architecture docs):
    IRQ_StartTalking/EndTalking/ExitToMenu/GetInfoForFile/OpenFile/CloseFile/
    SeekEeprom/ReadEeprom/WriteEeprom/WaitProcessing/ReadFileNoCallback →
    PROT_* equivalents across KERNAL_BRIDGE.md, MEMORY_MAP_CANONICAL.md,
    EEPROM_ARCHITECTURE.md, MACRO_ARCHITECTURE.md, ARCHITECTURE_REVIEW.md,
    Centralized_Data_Management.md, ZP_GUIDELINES.md.
    ZP_IRQ_* and ROM_IRQ_HANDLER intentionally left unchanged (they relate
    to the actual IRQ/NMI hardware channel, not the protocol layer).
    TIMING.md — new section 3 "WavPlayer MK3 NMI chunk transfer":
    - BUFFER_PAGES=24 → 6144 bytes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
2026-03-30 fix: WavPlayer MK3 rate calibration + stale-read silence guard
    Root cause (Phase 1): CIA 6526 timer uses N+1 period rule.
    - CIA timer=89 → 985248/90=10947 Hz (not 11070); timer=44 → 985248/45=21894 Hz (not 22392).
    - MK3 default OCR1A=1450→11026 Hz (78 Hz above C64), OCR1A=725→22039 Hz (145 Hz above C64).
    - Net FIFO drain: −78 B/s (11K) and −145 B/s (22K) → underrun in seconds.
    Fix (Phase 1): MK3_ConfigureMode now sends calibrated OCR1A via CMD_SET_RATE_L:
    - Mode 3 (11K): OCR1A=1461 → 10944 Hz ≈ C64 10947 Hz (+2.6 B/s, stable)
    - Mode 4 (22K): OCR1A=730 → 21888 Hz ≈ C64 21894 Hz (+6.0 B/s, stable)
    - Mode 5 (stereo): OCR1A=1461 + frame_size=2 → 21889 B/s (+5.2 B/s, sta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
    [CartApi.cpp, CartInterface.cpp, CartInterface.h]
2026-04-01 feat: WavPlayer mode 3 — 4× oversampling via CMD_SET_OVERSAMPLE
    MCM_Mode3 (PLAYTYPE_MK3 11K mono) now sends CMD_SET_OVERSAMPLE $04
    after the OCR1A calibration bytes. Firmware stores g_sample_period=1461
    and writes OCR1A=365 (1461>>2), firing TIMER1 at ~43716 Hz ≈ 4×10929 Hz.
    Each audio byte from the C64 is linearly interpolated across 4 sub-ticks.
    Updated MCM_Mode3 comment: reflects that it now does full configure
    (flush + rate + oversample + stream_push) rather than defaults only.
    Modes 4 (22K) and 5 (stereo) unchanged — no oversampling applied there.
2026-04-01 feat: wavtodigimax --mode hiresm for PCB v2 hi-res mono
    New convert_hiresm() function and --mode hiresm CLI option.
    Decodes source to 16-bit signed PCM mono (11025 Hz, HP 80 Hz, dynaudnorm),
    applies TPDF dither at 16-bit scale, splits each sample into [MSB, LSB],
    and writes a 2-channel 8-bit WAV for WavPlayer mode 5 (MK3 STEREO 11K).
    On PCB v2 (CH2/CH3 → 1.2 MΩ mixing resistors):
    CH0/CH2 receive MSB (full weight), CH1/CH3 receive LSB (1/256 weight)
    → effective 16-bit DAC output.
    Do NOT use on current PCB (R15=4.7kΩ): LSB/MSB weights are equal → distortion.
    See Technical Reference §28 for hardware requirements and resistor topology.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
2026-04-04 feat: menu scroll — 21 rows, auto-page on arrow boundary, scroll indicators
    - MAXDIRITEMS 20→21: uses previously empty row 22 (rows 23-24 stay as frame/status)
    - PRINTASCIIFILENAME: 26-char display + 6-char pad (cols 30-35 reserved for indicators)
    - DOWN: at last item of non-last page → auto-loads next page (cursor row 0); at last page → stop
    - UP: at first item of non-first page → auto-loads prev page (cursor last item); at first page → stop
    - CURSOR_GOTO_LAST flag in NEWCONTENT for UP cross-page cursor placement
    - DRAW_SCROLL_INDICATORS: ↑MORE (green) on row 2 when prev page exists,
    vMORE (green, v = placeholder for custom ↓ char) on row 22 when next page exists
    - '<' / '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
2026-04-04 fix: correct ASCII→screen code conversion and ↑ indicator screen code
    PRINTASCIIFILENAME: SBC #$20 → SBC #$60 so lowercase a-z maps to C64
    screen codes $01-$1A instead of ASCII uppercase $41-$5A. Previously only
    A ($01), S ($13), Y ($19) and digits happened to display correctly.
    DRAW_SCROLL_INDICATORS: ↑ indicator was storing PETSCII value $5E instead
    of screen code $1E ($5E-$40). Now uses correct $1E.
2026-04-04 fix: correct screen code encoding for all displayed text
    Three encoding bugs fixed:
    1. MSG_* strings: wrap all .TEXT message labels with .enc "screen" /
    .enc "none" so 64tass outputs C64 screen codes (A=$01) instead of
    ASCII (A=$41). STATUS_LINE writes bytes directly to screen RAM.
    2. PRINTDIRHEADER ROOT: hardcoded bytes were PETSCII-offset values
    (R=$D2=$52|$80, O=$CF=$4F|$80, T=$D4=$54|$80). Corrected to proper
    screen codes (R=$92=$12|$80, O=$8F=$0F|$80, T=$94=$14|$80).
    Also fixed _pdh_subdir SBC #$20 -> SBC #$60 so dirname uses screen
    codes $01-$1A instead of ASCII uppercase $41-$5A.
    3. menu.asm PETMATE frame: "EASYSD V3" label bytes were PETSCII-coded
    (E=$C5=$45|$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
2026-04-04 chore: archive unused files from Menus/EasySD, add upper case chars.bin
    Moved Org.SidFile.bin, SidFile.bin, screen, PatternMatch.s, PatternMatchTest.s
    to archive/ — none are referenced by the build system or any active source file.
    Added upper case chars.bin (custom charset with ↓ at $1F) to version control.
2026-04-04 rename: menu.asm -> petmate frame.asm, update all references
    build.py, EasySDMenu.s, CLAUDE.md, Tools/README.md updated.
2026-04-04 feat: create_multiload.py V3 — D64/D71/D81/T64 → MultiLoad ZIP
    New --from-disk and --from-autoswap modes convert C64 disk images
    directly to a ready-to-extract MultiLoad ZIP, eliminating manual
    file copying to the SD card.
    - Pure Python D64/D71/D81/T64 parsers (no new dependencies)
    - Multi-disk support: merges files from all disks, first-disk-wins
    on conflicts, warns on raw-sector disks (e.g. Maniac Mansion disk 2)
    - autoswap.lst support: compatible with existing SD2IEC collections
    - PETSCII→FAT conversion: preserves periods and spaces for filenames
    like fastl.o (critical for Gold Box games)
    - --list-only mode: inspect disk contents before converting
    - V2 positional mode unchanged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
2026-04-04 docs: update MultiLoad.md to V3 + add game compatibility guide; add tested game ZIPs
    - MultiLoad.md bumped to V3.0: Quick Start rewritten for --from-disk/ZIP workflow,
    config block file offsets corrected (3/4/5-20, was wrong 18/19/20-35),
    create_multiload.py section updated with full V3 syntax
    - New Section 4: Game Compatibility Guide — compatible/incompatible patterns,
    known working games (Barbarian, Last Ninja, Turrican 2, Robocop),
    known incompatible games (Ultima IV/V, KoL, Lemmings, Sam's Journey),
    special cases (Transwarp/notw, EasyFlash, BackBit), assessment workflow
    - MEMORY_MAP_CANONICAL.md: RL_STUB size corrected 20B→52B, handler size updated
    - multiload/: add BARBARI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
2026-04-05 feat: add Mode 6 — MK3 stereo 11K with 4× oversampling
    New PLAYTYPE_MK3_STEREO_OS (6) in WavPlayer: 11025 Hz stereo with 4×
    linear interpolation. Same NMI bandwidth as Mode 5 (21858 B/s vs
    22133 Hz limit). No firmware change needed — TIMER1 ISR already handles
    frame_size=2 with oversampling correctly (b2=b0, b3=b1 replication).
    MK3_ConfigureMode sequence: FLUSH → SET_RATE(1461) → SET_OVERSAMPLE(4)
    → SET_FRAME_SIZE(2) → STREAM_PUSH. CIA timer unchanged (reload=89).
    Menu now shows 7 items when MK3 detected (was 6).
2026-04-05 docs: fix WavPlayer.md — mode 3 routing, CMD_SET_RATE_H, hiresm, ZP comment
    - Fix: mode 3 does NOT skip MK3_ConfigureMode; it uses MCM_Mode3 branch
    - Fix: remove CMD_SET_RATE_H ($21) from commands table — WavPlayer intentionally
    never sends this opcode (would be consumed as OCR1A hi byte → wrong value)
    - Add: --mode hiresm to quick-start table (PCB v2 hi-res mono)
    - Add: note that --mode stereo is correct for both Mode 5 and Mode 6
    - Fix: ZP_WAV_TIMERLO comment — modes 3+6 use 89, modes 4+5 use 44
2026-04-05 feat: add HWTest plugin — C64 hardware signal diagnostic
    - EasySD/Plugins/HWTest/HWTest.s: new plugin, tests ROML/EXROM (implicit),
    SW serial (CMD_HWTEST response), NMI signal and data bus D0–D7 (10 bit
    patterns). Displays result on status line row 24, auto-exits after ~1.5s.
    - Arduino/EasySD/CartApi.h + CartApi.cpp: COMMAND_HWTEST=32, HandleHwTest()
    sends SUCCESSFUL then 256 bytes via NMI (10 patterns + 246 zeros).
    - EasySD/Loader/Common/EasySD.inc: COMMAND_HWTEST=32 added.
    - Tools/build.py: HWTest added to PLUGIN_MATRIX (hwtplugin.prg).
    - docs/plugins/HWTest.md: new plugin reference doc.
    - docs/architecture/CARTRIDGE_PROTOCOL.md: COMMAND_HWTEST=32 added to
    NMI-Session Commands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
2026-04-05 fix: tristate data bus when cartridge disabled — prevents C64 freeze on boot
    SetAddressPinsOutput() was called in Init(), permanently driving D4-D7/A0-A3
    as OUTPUT (0x00) even with EXROM=HIGH. Arduino boots ~300ms after C64 power-on;
    during this window the driven 0x00 conflicts with KERNAL/BASIC ROM bus drivers,
    causing indeterminate data reads (near-BRK) → 6510 executes garbage → freeze.
    Fix: data bus pins are INPUT (tristate) until EnableCartridge() sets them OUTPUT.
    DisableCartridge() restores them to INPUT. No flash size change (23690B, 77%).
    [CartInterface.cpp]
2026-04-05 fix: tristate data bus during CBM80 check window in TransferMenu()
    ATmega can sink 40mA vs AT27C512R source 4mA — Arduino always wins bus
    fights against the EEPROM. Previously EnableCartridge() set data bus OUTPUT
    (0x00) before ResetC64(), so during the 300ms CBM80 check window Arduino
    overrode the EEPROM's CBM80 bytes → autostart failed even with EEPROM installed.
    Fix: split TransferMenu() into two phases:
    Phase 1 — EnableExromOnly(): EXROM LOW, data bus stays tristate
    → C64 reset + 300ms: EEPROM drives CBM80/NMI handler undisturbed
    Phase 2 — EnableDataBus(): data bus OUTPUT right before SendHeader()
    → NMI transfers: Arduino drives data, EEPROM is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
    [CartApi.cpp, CartInterface.cpp, CartInterface.h]
2026-04-05 docs: document EEPROM role + CBM80 timing fix in PCB bringup notes
    Add Issue 5 (CBM80 window bus conflict), EEPROM functional description,
    current firmware state table and test matrix for post-fix C64 hardware test.
2026-04-05 fix: prevent EXROM LOW glitch during IOSetup() — eliminates C64 immediate freeze
    IOSetup() used pinMode(EXROM, OUTPUT) which drove PD2 LOW for ~1-2µs before
    the subsequent digitalWrite(HIGH) took effect. The C64 PLA samples /EXROM on
    PHI2 (1µs period) and caught this glitch, asserting /ROML and letting the CPU
    read from the empty EEPROM socket — floating data bus caused an immediate crash.
    Fix: set PORTD[2] HIGH via direct register write before enabling the output
    driver (DDRD |= _BV(PD2)), so the pin starts HIGH with no glitch.
    [CartInterface.cpp]
2026-04-06 docs: document MENU button, EEPROM wiring analysis + hardware bringup findings
    - MENU button (A6 analog-only): schematic vs firmware analysis — implementation correct
    - EEPROM A8-A15 wiring: clarified all upper address bits driven by Arduino (SetPage dual-purpose)
    - IRQLoaderRom.bin: verified correct — CBM80, vectors, 256-page structure, placeholder patching
    - M27C512 programmed successfully (ID 0x20 3D, full 64KB verified)
    - Add PCB schematic reference images (Arduino Nano, EEPROM, C64 expansion port, button, SD adapter)
2026-04-06 fix: restore directory navigation on real C64 hardware
    Three bugs fixed in the menu directory change flow:
    1. ENTERDIR was missing PROT_SetNameZ before PROT_ChangeDirectory — Arduino
    received length=0 (stale KERNAL_FILENAME_LENGTH), returned INVALID_ARGUMENT,
    and the C64 froze in CHANGEDIRFAIL. Fix: load NAMELOW/NAMEHIGH (set by
    ISDIRECTORY) into PROT_SetNameZ before calling PROT_ChangeDirectory.
    2. CHANGEDIRFAIL used JMP * (infinite freeze with yellow border). Fix: show
    red "CD FAILED" status message and return to INPUT_GET.
    3. GOBACK did not check PROT_ChangeDirectory return value. Fix: BCS CHANGEDIRFAIL
    for consistent error handling on ".." navigation failure.
    Root ca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
2026-04-06 docs: record directory navigation bug found during PCB v3 C64 hardware test
    Added entry to the bringup summary table: ENTERDIR missing PROT_SetNameZ
    was invisible in VICE/Arduino serial tests but froze the C64 on real hardware.
2026-04-06 fix: cursor highlight for spaces, bracket display, remove release border flashing
    - SETARROW: remove space-skip — spaces now invert to $A0 (solid block) like
    other chars; CLEARARROW already correctly clears bit 7 from $A0 back to $20
    - PRINTASCIIFILENAME: add $5B-$5F mapping (subtract $40 → SC $1B-$1F) so
    '[', '\', ']', '^', '_' display as correct C64 screen chars instead of
    graphics chars; fixes filenames like "10x10! hd [ex].prg"
    - NEWCONTENT / PROGRAM: wrap INC BORDER and STA BORDER in .if DEBUG=1 so
    border color no longer changes during dir navigation or file launch in
    release builds
2026-04-06 feat: left/right arrows for paging, held UP/DOWN for continuous scroll
    - Add cursor RIGHT ($1D) → NEXTPAGE and cursor LEFT ($9D) → PREVPAGE so
    paging no longer requires reaching the list boundary or using < / >
    - Change RPTFLG ($028A) from $40 (no repeat) to $80 (cursor/function keys
    only) so holding UP or DOWN continuously scrolls through the file list
2026-04-06 fix: DisableCartridge after TransferGame — prevents bus contention on next boot
    After TransferGame, EnableCartridge() had left EXROM=LOW and the data bus
    as OUTPUT. On the next power-on, during the ~300ms Optiboot window before
    setup() runs, D2 is INPUT (no driver). The EXROM trace stays at 0V
    (discharged from the previous LOW state), so the C64 sees /EXROM=LOW and
    enters CBM80/IRQLoader. When Arduino's IOSetup finally drives EXROM=HIGH,
    if the data bus is still OUTPUT (0x00), bus contention occurs: Arduino sinks
    current on the bus while the C64 reads KERNAL/BASIC ROM → CPU reads BRK
    ($00) → system freeze.
    Fix: call DisableCartridge() immediately after the last byte is sent. This
    sets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
    [CartApi.cpp]
2026-04-06 fix: cold boot RESET + scroll rate limiting
    - EasySD.ino: pulse /RESET 50ms after Init() so C64 always restarts
    with EXROM=HIGH regardless of Optiboot float window (~300ms).
    Eliminates cold boot freeze caused by CBM80 being seen while D2 floats.
    - EasySDMenu.s: add SCROLL_DELAY (~100ms busy-wait) after UP/DOWN
    single-row moves to limit continuous scroll to ~10 rows/sec.
    Prevents accidental multi-scroll with a brief keypress.
    [EasySD.ino]
2026-04-06 fix: --no-bootloader ISP upload now sets BOOTRST fuse correctly
    Without this fix, --no-bootloader only flashed the sketch but left
    hfuse=0xDA (BOOTRST=0 = start from bootloader section $7E00).
    With no bootloader at $7E00 the chip would hang on reset.
    Now sets hfuse=0xDB (BOOTRST=1 = start from application $0000),
    eliminating the Optiboot 300ms delay entirely. This is the definitive
    fix for cold-boot EXROM float: Arduino code runs immediately on power-on,
    IOSetup() drives EXROM=HIGH within ~1ms, long before C64 reset expires.
    To restore USB upload: run arduino-upload-isp (re-burns Optiboot + fuses).
2026-04-06 fix: auto-load EasySD menu on cold boot via TransferMenu() in setup()
    TransferMenu() was never called from setup(), so the C64 always booted to
    BASIC and the menu only loaded on button press. Adding the call after
    cartApi.Init() gives the correct behaviour: EasySD menu auto-loads on every
    cold boot, short MENU press reloads the menu, long MENU press exits to BASIC.
    Also documents PCB v3 + real C64 hardware test results (8/8 pass) and the
    verified boot behaviour in PCB_BRINGUP_NOTES.md. Updates MultiLoad.md with
    the EASYLOAD.PRG header fix and ZIP folder naming fix.
    [EasySD.ino]
2026-04-06 docs: overhaul CLAUDE.md and GEMINI.md — remove stale sprint history, fix naming
    - GEMINI.md: full rewrite; remove Sprint 1/2 history (~100 lines), fix IRQHack.inc →
    EasySD.inc, IRQ_ExitToMenu → PROT_ExitToMenu, IRQ_Stream → PROT_Stream,
    PLAYTYPE_MK3_HIRESM → PLAYTYPE_MK3_STEREO_OS, SafeStream → removed, add PCB v3
    hardware notes, real-hardware plugin status, WavPlayer/MultiLoad/P2TK summaries
    - CLAUDE.md: fix APIMacros table (all plugins ✅), plugin exit/stream naming,
    flash budget 22.7 → 23.7 KB
2026-04-06 fix(multiload): preserve printable ASCII in petscii_to_fat — fix + mapped to _
    RL_STUB passes raw PETSCII bytes to Arduino; the FAT filename on the SD card must
    be byte-identical. Printable ASCII $21–$7E that is not FAT-illegal is now preserved
    verbatim instead of being replaced with '_'. This fixes filenames containing '+',
    '-', '!', etc. (e.g. "THE LAST NINJA+" on Last Ninja D81 was stored as
    "THE LAST NINJA_", causing part-load failures after the first part).
    Documented in docs/plugins/MultiLoad.md section 12 (Known Limitations).
2026-04-06 fix(multiload): fix first-part open, restore LOAD vector on error, add border-color debug
    - MultiLoad.s: ML_FIRST_PART_NAME now stores NAME.PRG (with extension);
    removes .PRG append logic from MAIN — correct data belongs in the config
    - MultiLoad.s: ML_CONFIG_VERSION bumped 2→3
    - MultiLoad.s: ML_EXIT_TO_MENU calls RL_UNINSTALL before ExitToMenu;
    without this, $0330/$0331 stays patched after failed launch and all
    subsequent PRG loads break until power cycle
    - MultiLoad.s: added ML_DEBUG_BORDERS conditional border-color markers
    (compiled in with -D ML_DEBUG_BORDERS=1) for real-hardware hang diagnosis
    - ResidentLoader.s: added RL_UNINSTALL — restores $0330/$0331 from
    RL_ORIG_VEC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
2026-04-06 fix(arduino): add noInterrupts() to HandleGetInfoForFile transmission loop
    Without noInterrupts(), the INT1 ISR fires mid-transmission and corrupts
    the 256-byte GETFILEINFO response. C64 PROT_WaitProcessing then loops
    forever waiting for a valid response byte.
    Pattern aligned with HandleGetPath (which works correctly):
    - HandleResponse(SUCCESSFUL, 1) for 1ms settling time
    - noInterrupts() / interrupts() brackets around TransmitByteFast loop
    - delayMicroseconds(20) after transmission
    [CartApi.cpp]
2026-04-06 refactor(CartApi): remove dead code, rename TransferGame → LoadAndLaunchFile
    - Remove empty stubs: HandleSetIO, HandleSetSource (was in switch → C64 hang),
    HandleInvokeWithIndex, TransferGame(StringPrint) wrapper
    - Remove TransferInfo() no-op + all 3 call sites
    - Remove ~300 lines of commented-out dead code (old stream, dir transfer, exit, test)
    - Remove unused local variables: streamState, niStartTime
    - Remove misleading inline keyword from HandleReadDirectory (150+ line function)
    - Remove misleading //noInterrupts() comment in LoadAndLaunchFile
    - Rename TransferGame(char*) → LoadAndLaunchFile(const char*) everywhere
    - Fix HandleGetInfoForFile: add noInterrupts() around 256-byte tra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
    [CartApi.cpp, CartApi.h]
2026-04-06 fix(CartApi): close workingFile after launch + verify before SUCCESSFUL
    Two bugs caused intermittent PRG load failure after loading a bad file,
    requiring a full power cycle to recover:
    1. workingFile.close() was missing in LoadAndLaunchFile success path.
    Init() called sd.chdir() while the PRG file handle was still open,
    corrupting SdFat internal state. TransferMenu() (SEL button) only
    closes workingFile when menu is read from SD — for flash-served menu
    the handle was never freed. Only Arduino restart (power cycle) reset
    the SdFat state.
    2. HandleResponse(SUCCESSFUL) was sent before sd.exists() check.
    If the file was missing, C64 received SUCCESSFUL and waited for a
    r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
    [CartApi.cpp]
2026-04-07 fix: three hardware bug fixes for real-C64 reliability
    1. KernalBridge BUG-1: remove dead code spilling into I/O space
    DisplayReceived, GetHigh, GetLow, minikey, columntab (256B table)
    were never called but assembled into $CF1C-$D113, crossing into
    C64 I/O space ($D000+). Reads from $D000+ return VIC/SID/CIA
    register values instead of code → undefined behavior on real HW.
    Binary now ends at $CF1B (3868 bytes). Verified from symbol file.
    2. CartApi: fix LFN filenames with spaces failing to load (BUG-E)
    sd.exists(absolutePath) fails for LFN filenames in SdFat 2.x.
    Fix: extract basename from absolute path, use CWD (set correctly
    by DirFunction during menu navigation)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
    [CartApi.cpp]
2026-04-07 fix(CartApi): replace dirEntry() with fileSize() in HandleGetInfoForFile
    dirEntry() re-reads the directory sector from the SD card via SPI.
    In the MultiLoad context (after HandleGetPath's noInterrupts() NMI
    transfer + sd.open()), the SPI read blocks indefinitely — Arduino
    frozen, data bus stays at $00, C64 loops in PROT_WaitProcessing,
    SEL button unreachable.
    fileSize() returns the value cached by sd.open() with no SPI access.
    Bytes 0-27 of the 32-byte FAT entry are sent as $00; bytes 28-31
    contain the real file size (little-endian). All callers (#GETFILEINFO
    macro → ZP_LOADFILE_API_SIZE0..3) only use bytes 28-31.
    Also removes the FILE_INFO_FAILED error path: fileSize() always
    succeeds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
    [CartApi.cpp]
2026-04-07 fix(menu): increase dir entry filename length from 31 to 63 chars
    Filenames longer than 31 characters (e.g. "Beach Head (1983)(Access
    Software).prg" = 38 chars) were silently truncated when sent from
    Arduino to C64, causing sd.exists() to fail with a truncated name
    and the file to not load.
    Root cause: StringPrint.value[32] limited storage to 31 chars; the
    directory protocol sent at most 31 bytes per entry. Each dir entry
    was 32 bytes (31 name + 1 type flag).
    Fix: extend to 64-byte entries (63 name chars + 1 type flag):
    - StringPrint.value: 32 → 64 bytes
    - StringPrint limits: 31 → 63
    - HandleReadDirectory: loops use 63 instead of 31; entry size 32 → 64
    - MAXFILENAMELENGTH: 32 → 64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
    [CartApi.cpp]
2026-04-07 chore(multiload): regenerate LASTNINJA2.ZIP with updated EASYLOAD.PRG
    Rebuilt after dir entry size fix (32→64 bytes): EASYLOAD.PRG now
    requests 6 pages instead of 3 for the directory listing.
2026-04-07 fix(CartApi): handle >31-char filenames with prefix scan fallback
    Filenames longer than 31 chars (e.g. "Beach Head (1983)(Access Software).prg")
    were truncated by the 32-byte directory protocol, causing sd.exists() to fail
    with FILE_NOT_FOUND. Fix:
    - StringPrint.value[64] (was 32) lets CurrentFileName capture the full name
    up to 63 chars via file.printName() during directory reads.
    - HandleInvokeWithName: when sd.exists() fails on the 31-char truncated name,
    scan the current directory for a file whose name starts with that prefix and
    open using the full filename found in CurrentFileName.
    - All C64 protocol constants reverted to 32-byte entries (no wire format change).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
    [CartApi.cpp]
2026-04-07 chore(multiload): regenerate LASTNINJA2.ZIP from d81 source (BUG-G firmware)
    Rebuilt with current bootplugin.prg (prefix-scan fix, 58f7726).
2026-04-07 fix(CartApi): use SdFat getName() for >31-char LFN prefix scan
    Replace the Iterate()/StringPrint-based fallback scan in
    HandleInvokeWithName with DirFunction::FindByPrefix(), which uses
    SdFat's native file.getName() API directly.
    The old approach called dirFunc.Iterate() which (1) routed through
    the StringPrint wrapper, (2) touched currentIndex/count/InSubDir
    state, and (3) compared only against prefix[i] without lowercasing it.
    FindByPrefix() does a clean openNext() loop on m_dirFile, calls
    file.getName(outName, outSize) directly, and applies tolower() on
    both sides of the comparison for robustness.
    Flash: 24136B/30720B (78%, 6584B free)
    Debug: 30360B/30720B (98%, 360B free)
    Co-Authored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
    [CartApi.cpp, DirFunction.cpp, DirFunction.h]
2026-04-07 refactor(DirFunction): remove dead code and sprint tracking comments
    DirFunction.h:
    - Remove unused #include "CharStack.h" (CharStack never instantiated)
    - Remove SetSd() declaration (not implemented anywhere)
    - Remove NMax constant (unused)
    - Remove commented-out method stubs (InitSerialize, Serialize, Deserialize,
    ChangeToSavedDirectory)
    - Merge duplicate protected: sections into one
    - Remove sprint dev annotations from public section
    - Fix #endif guard style
    DirFunction.cpp:
    - Remove dead #include <FreeStack.h> (not called in this file)
    - Remove dead commented #include <SdFatUtil.h>
    - Replace sprint tracking prefixes ("Sprint 5 P1.1:", "MANDATORY", "CRITICAL FIX")
    with concise techni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
    [DirFunction.cpp, DirFunction.h]
2026-04-07 fix(DirFunction): GoBack() uses NavigateToPath() instead of sd.chdir(absolutePath)
    sd.chdir() with an absolute LFN path is unreliable in SdFat 2.x for
    long filenames. NavigateToPath() navigates segment-by-segment from root
    using relative chdir — consistent with ChangeDirectory() and matching
    the already-established NavigateToPath() pattern.
    Also removes the manual rollback state (savedPath/savedDepth) since
    NavigateToPath() handles failure by landing at root, which is a safe
    known state.
    [DirFunction.cpp]
2026-04-09 refactor(DirFunction): replace StringPrint with file.getName(), delete dead code
    StringPrint was a custom Print subclass used only to capture
    file.printName() output character-by-character via virtual dispatch.
    The correct SdFat 2.x API is file.getName(char*, size_t), which writes
    directly into a plain char buffer — no intermediary class needed.
    Changes:
    - DirFunction::currentFileName is now char[64] instead of StringPrint
    - Iterate() uses file.getName(currentFileName, sizeof(currentFileName))
    instead of file.printName(&CurrentFileName)
    - CartApi HandleReadDirectory uses strlen(currentFileName) instead of
    CurrentFileName.index; loop vars are uint8_t (max 31)
    - EasySD.ino debug print u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
    [CartApi.cpp, DirFunction.cpp, DirFunction.h, EasySD.ino]
2026-04-09 refactor(CartApi): code quality cleanup — dead code, layer separation, comment accuracy
    CartApi.h:
    - Remove dead declarations: GetCommand(), DoStreaming1(), DoStreaming2(),
    InvokeSelected() — declared but never implemented or called
    - Remove Sprint tracking comments on buffer size defines (64B is production
    value, not a sprint compromise)
    - Remove commented-out member variables (TalkStatus, startIndex, currentFileName)
    - Move UpdateFile()/ReceiveFile() under #ifdef EASYSD_DEBUG_SERIAL guard
    - Align response/command defines with consistent formatting
    CartApi.cpp:
    - RestoreLastDir(): replace duplicated segment-by-segment navigation loop
    with dirFunc.NavigateToPath() — eliminates c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
    [CartApi.cpp, CartApi.h]
2026-04-10 fix(HWTest): add missing PROT_EndTalking before PROT_ExitToMenu
    PROT_StartTalking was correctly called before COMMAND_HWTEST,
    but PROT_EndTalking was missing at the _done exit point (both
    success and _comm_fail paths flow through _done). Without it the
    protocol session was not closed and the menu never reloaded.
2026-04-10 docs(DEVELOPMENT_ROADMAP): update status for HWTest fix, add bug log entry
    - HWTest status updated to 🔧 (fix applied, test pending)
    - Bug log entry added for HWTest (missing PROT_EndTalking at _done)
    - Phase 1 checklist updated: HWTest marked ✅
    - Last updated date annotated
2026-04-11 fix(CvdPlayer): redesign NI stream exit — frame counter + Arduino EOF detection
    Previously the STOP key handler called PROT_CloseFile/ExitToMenu while the
    Arduino was still in the NI stream loop (waiting for IO2 pulses), causing
    an immediate deadlock. ERROR_OPENING_FILE was also missing PROT_EndTalking.
    Fix:
    - C64: call #GETFILEINFO before PROT_NIStream to read file size into CVD_SIZE
    ($8B-$8E). OUTCOPY decrements CVD_SIZE by 400 each block; on underflow,
    CVD_DONE does SEI + 5-frame delay + PROT_StartTalking re-sync + clean exit.
    - Arduino: HandleNonInterruptedStream() exits on EOF (workingFile.read() == 0).
    Both sides now exit concurrently when the file is exhausted.
    - Remove broke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
    [CartApi.cpp]
2026-04-12 Fix long name menu previews and restore 64-byte directory protocol
    [CartApi.cpp, DirFunction.cpp, DirFunction.h]
2026-04-12 Fix boot startup path and document EEPROM restore behavior
    [CartApi.cpp, CartInterface.cpp, CartInterface.h, EasySD.ino]
2026-04-12 docs: align key docs with current source
2026-04-12 Arduino: redesign last-directory persistence with validated EEPROM record
    Implement Option B (delayed auto-restore) from LAST_DIR_PERSISTENCE_REDESIGN.md:
    - Boot always starts at root (no change)
    - After menu transfer completes, auto-restore last-dir if valid EEPROM record exists
    - New EEPROM layout: explicit offsets (no struct), versioned, CRC16-protected
    - Write strategy: invalidate-first (committed=0x00), payload+CRC, commit-last (committed=0xAA)
    - Read validation: magic → version → committed → pathLen → CRC16 → navigate
    - Root explicitly invalidates resume record (clean "no resume state" semantics)
    - CartApi.cpp: SaveLastDir() rewritten for new format, RestoreLastDir(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
    [CartApi.cpp, CartApi.h]
2026-04-12 Arduino: clarify old EEPROM format is NOT backward compatible
    The old 2-magic-byte format (bytes 0-1: 0xE5/0xD0, bytes 2-65: raw path)
    is NOT "backward compatible" with the new format. It is silently REJECTED:
    - Old byte 2 contains the path's first character (e.g. 0x2F = '/'), not version (0x01)
    - Version check (EEPROM_LD_VERSION != 0x01) will fail
    - Old record is discarded entirely
    First successful COMMAND_CHANGE_DIR overwrites EEPROM with new format (71 bytes),
    replacing the old layout completely. This is intentional: old format is no longer
    used (boot-time restore was already disabled), and mixing formats is unnecessary.
    Updated comments in CartApi.cpp to be explicit: old format is igno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
    [CartApi.cpp]
2026-04-12 Arduino: implement idle-aware deferred last-directory save
    Diagnosis revealed SaveLastDir() was blocking the COMMAND_CHANGE_DIR
    response path due to ~230ms EEPROM write (71B × 3.3ms/byte), causing
    C64-side protocol timeout and SD ERROR / CD ERROR.
    Solution: Deferred save triggered only during idle time, not in
    critical protocol path.
    - CartApi.h: add lastDirPendingSave flag, lastDirIdleCounter for idle detection
    - CartApi.cpp Init(): initialize deferred save state
    - CartApi.cpp HandleChangeDirectory(): set flag instead of calling SaveLastDir()
    (response sent immediately, no blocking)
    - CartApi.cpp HandleApi(): idle-aware deferred save
    (increment idle counter when no command,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
    [CartApi.cpp, CartApi.h]
2026-04-12 Arduino: implement next-menu-reload flush model for last-directory persistence
    Replaces the previous idle-aware deferred save with a cleaner,
    deterministic model: RAM shadow + menu-reload flush.
    Core concept: directory navigation is "noted" immediately (RAM shadow),
    but persisted only when the EasySD menu next loads—a safe point far from
    protocol-critical paths.
    Design:
    - HandleChangeDirectory(): on success, update RAM shadow (pendingLastDir),
    set lastDirDirty flag. No EEPROM write here — response sent immediately.
    - TransferMenu() end: before RestoreLastDir(), flush the RAM shadow
    if lastDirDirty. Only then call RestoreLastDir() to read the freshly
    persisted or prior session's r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
    [CartApi.cpp, CartApi.h]
2026-04-12 Arduino: remove last-directory persistence feature
    Complete removal of EEPROM-based directory state save/restore:
    - Removed CartApi.h fields: lastDirDirty, pendingLastDir[64]
    - Removed CartApi.cpp functions: SaveLastDirRecord(), RestoreLastDir()
    - Removed CartApi.cpp: EEPROM layout constants, CRC16 helper
    - Removed CartApi.cpp: Init() initialization of lastDirDirty/pendingLastDir
    - Removed CartApi.cpp: HandleChangeDirectory() RAM shadow copy logic
    - Removed CartApi.cpp: TransferMenu() EEPROM flush + restore calls
    - Updated DirFunction.cpp: NavigateToPath() comment to reflect runtime-only use
    - Updated docs/architecture/EEPROM_ARCHITECTURE.md: marked MCU EEPROM as unused
    - Updated docs/archit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
2026-04-12 MultiLoad: fix 3 critical bugs in resident loader + expand config field
    Fix 1: RL_DisableInterrupts now only disables CIA2 NMI sources.
    Previously it destroyed CIA1 timer IRQs and VIC raster IRQs, breaking
    game music/timing/raster effects after every LOAD call. SEI is
    sufficient for IRQ masking during transfer.
    Fix 2: RL_ReceiveFragmentNoCallback now saves/restores $0318/$0319
    (SOFTNMIVECTOR). Previously the game's NMI vector was permanently
    overwritten with the cart transfer handler after the first LOAD,
    causing crashes on any subsequent NMI.
    Fix 3: RL_STUB no longer restores X/Y on return — preserves the end
    address computed by RL_HANDLER. Also moves CLI from RL_EndTalking
    to the stub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
2026-04-13 MultiLoad: move device passthrough to stub before banking switch
    Non-device-8 LOADs now pass through to original Kernal LOAD immediately
    at stub level ($033C), before any $01 banking change or register save.
    This preserves the game's full original execution state for non-SD loads.
    Removes redundant device check and rl_passthru from handler ($E800).
    Also updates MultiLoad and hardware-bug docs to reflect all recent fixes.
2026-04-13 Arduino: hold C64 in /RESET during boot for reliable cold start
    IOSetup() now pulls /RESET LOW as its first action, keeping the C64
    halted while SD init and directory setup complete. TransferMenu() sets
    EXROM LOW then releases /RESET via ResetC64() — the C64's first boot
    sees CBM80 immediately. Removes waitForStablePhi2() from cold boot
    path (C64 has no PHI2 while held in reset). Saves ~200B flash.
    [CartApi.cpp, CartInterface.cpp, EasySD.ino]
2026-04-14 Arduino: BASIC-first boot model — menu loads on SEL press, not cold boot
    Instead of holding the C64 in /RESET during Arduino startup (brick risk
    if release fails), let the C64 boot normally to BASIC. The menu is loaded
    on demand via SEL short press (TransferMenu warm reset). This eliminates
    the single point of failure in the cold-boot autoload path.
    [CartApi.cpp, CartInterface.cpp, EasySD.ino]
2026-04-14 Fix slow directory navigation: revert to 32B records, eliminate redundant scans
    Three fixes combined:
    1. Dir record 64B→32B (screen only shows 26 chars, 31 is plenty)
    2. Remove tolower() from HandleReadDirectory — send original LFN so
    sd.chdir() matches exactly, avoiding expensive FindDirectoryByPrefix
    3. Integrate CountEntries() into ChangeDirectory/ToRoot, removing
    redundant Prepare() full-directory scan from HandleChangeDirectory
    Result: 3x SD scan → 1x per directory entry, half the NMI transfer volume.
    [CartApi.cpp, DirFunction.cpp, DirFunction.h]
2026-04-14 Fix PRINTASCIIFILENAME: map uppercase ASCII to correct screen codes
    After removing tolower() from HandleReadDirectory, uppercase ASCII letters
    ($41-$5A) were passed as-is to screen RAM — wrong glyphs in the custom
    charset. Now both uppercase and lowercase map to screen codes $01-$1A,
    matching the charset while preserving original LFN case in the buffer.
2026-04-14 Add COMMAND_CHANGE_DIR_INDEX (33): change directory by page+row visible index
    - DirFunction: ChangeDirectoryByVisibleIndex() resolves full LFN from
    filesystem via page*21+row, adjusting for synthetic '..' row in subdirs
    - CartApi: HandleChangeDirectoryIndex() sends args (page, row), calls
    ChangeDirectoryByVisibleIndex into Arguments[] scratch buffer
    - CartLibHi.s: PROT_ChangeDirectoryIndex takes A=page, X=row
    - EasySDMenu.s: ENTERDIR now uses PROT_ChangeDirectoryIndex instead of
    PROT_ChangeDirectory+PROT_SetNameZ (avoids 31-char LFN truncation)
    - EasySD.inc: COMMAND_CHANGE_DIR_INDEX = 33
    [CartApi.cpp, CartApi.h, DirFunction.cpp, DirFunction.h]
2026-04-14 Remove LED code: D13=SPI SCK shared pin (unsafe), STATUS_LED=NC on PCB
    - CartInterface.h: remove STATUS_LED define (A7/pin21 is NC on PCB)
    - EasySD.ino: remove StatusLed.h include, ledInit/ledBootOk/ledBootFail/
    ledSdFail/ledSdRecovered calls
    - CartApi.cpp: remove diagnostic PB5 blink blocks from TransferMenu()
    - StatusLed.h: cleared to comment (file kept, not included anywhere)
2026-04-15 Fix directory page reset and read underflow
    [CartApi.cpp]
2026-04-16 Stabilize Arduino protocol and directory listing contract
    Protocol: AwaitByte now uses millis()-based timeout (500ms) instead of
    nested retry loops; GetArgumentsStatic/Dynamic set m_argsOk flag on
    timeout so HandleApi can reset receive state for stale commands.
    CartInterface receives stale identifier guard (200ms timeout) and
    rejects wrong bytes mid-handshake instead of silently ignoring them.
    Directory: Iterate() now skips hidden files internally (consistent with
    CountEntries), removing the IsHidden field. ReadDir loop simplified to
    match. Redundant Prepare() calls removed from Init() and TransferMenu()
    since ReInit() → ToRoot() already does ResyncDirFromCwd + CountEntries.
    Added target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
    [CartApi.cpp, CartApi.h, CartInterface.cpp, DirFunction.cpp, DirFunction.h, EasySD.ino]
2026-04-16 Guard C64 menu against zero-item directory pages
    NEWCONTENT: BEQ guard before DEX prevents X underflow when
    CURPAGEITEMS=0 (empty directory or stale page index).
    PRINTPAGE: CPX CURPAGEITEMS check before the print loop prevents
    the do-while from executing 256 iterations when X starts at 0.
2026-04-16 Add release-log build tier for field diagnosis
    New EASYSD_RELEASE_LOG macro tier in EasySDLog.h: enables serial
    logging for DIR/SYS/SD/ERR categories only (~1-2KB flash cost),
    while FILE/PRG/PROTO remain compiled out. Sits between full debug
    and silent release.
    build.py: --release-log flag threads through arduino-compile,
    arduino-upload, build_core, and all composite targets. BuildConfig.h
    generation consolidated to use arduino_generate_buildconfig() everywhere.
2026-04-16 Fix stack overflow in directory-by-index change
    ChangeDirectoryByVisibleIndex kept a local File object (~32B) on the
    stack while calling ChangeDirectoryBasename → ChangeDirectory →
    sd.chdir → ResyncDirFromCwd → CountEntries (~280B deep chain).
    With only 291-474B free RAM this caused stack corruption → grey screen.
    Split into FindDirectoryNameByVisibleIndex (lookup only, File released
    on return) + ChangeDirectoryBasename called from HandleChangeDirectoryIndex
    where the stack is shallow.
    [CartApi.cpp, DirFunction.cpp, DirFunction.h]
2026-04-16 Add release-log docs and component update guide to README
    - Release logging section: --release-log flag usage, example output
    - When to update each component: Arduino firmware vs SD card vs ROML chip
    - Fix --release-log flag not passed through arduino-upload-isp
2026-04-16 Refine SEL/menu logic, stabilize transfer timing, and add staged release packaging
    [CartApi.cpp, CartInterface.cpp, DirFunction.cpp, DirFunction.h, EasySD.ino]
2026-04-16 Fix build.py skip-arduino flow and robust Windows SD deploy path handling
2026-04-16 Fix SEL session handling and harden build.py Arduino ISP flow
    [CartApi.cpp, CartApi.h, EasySD.ino]
2026-04-16 Fix NI stream lockup and stabilize menu path header refresh
    [CartApi.cpp]
2026-04-16 Fix path/info transfer framing for stable C64 menu header
    [CartApi.cpp]
2026-04-17 Fix menu path/header transfer stability on real hardware
    [CartApi.cpp]
2026-04-17 Fix dir iteration stability to avoid menu header corruption
    [DirFunction.cpp, DirFunction.h]
2026-04-18 Restore proven path/menu sync model from 5331f47 to fix header garbage and dir entry stall
    Root cause: refactors since 5331f47 broke C64-Arduino directory state synchronization.
    PRINTDIRHEADER used cached PATHBUFFER (uninitialized at boot) instead of live
    PROT_GetCurrentPath, HandleChangeDirectory lost its Prepare() call and gained an
    unreliable prefix fallback with 128B static buffer, and GoBack used relative ".."
    instead of absolute path chdir.
    Arduino: restore Prepare() in HandleChangeDirectory/Init/TransferMenu, remove prefix
    fallback (saves 128B SRAM), restore GoBack absolute-path pattern, shrink
    currentFileName to 32B. RAM: 624B free (was 464B).
    C64: PRINTDIRHEADER calls PROT_GetCurre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
    [CartApi.cpp, DirFunction.cpp, DirFunction.h]
2026-04-18 Stabilize menu sessions and startup listening
    [CartApi.cpp, CartInterface.cpp, CartInterface.h, EasySD.ino]
2026-04-18 Stabilize cold-boot SEL handling
    [CartApi.cpp, EasySD.ino]
2026-04-18 Implement cold boot state machine and gate self-test behind EASYSD_SELFTEST
    Cold boot: AVR now holds C64 /RESET LOW during SD init and runtime setup,
    then releases via TransferMenu() for deterministic cartridge boot. The C64
    never sees BASIC on power-on — it boots directly into the EasySD menu.
    If SD init fails, C64 is released to BASIC and SEL retries.
    Boot states: BOOT_HOLD_RESET → BOOT_INIT_SD → BOOT_INIT_RUNTIME →
    BOOT_ARM_CARTRIDGE → RUNNING_READY (or BOOT_ERROR on SD failure).
    Self-test suite (interactive dir tests + testRunAll) moved behind
    EASYSD_SELFTEST flag to fit debug builds within 30720B flash limit.
    Debug without selftest: 29766B (96%, 954B free).
    Enable via: pytho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
    [CartInterface.cpp, EasySD.ino]
2026-04-18 Add deploy batch files for release, debug, and VICE builds
    deploy.bat: release build + ISP upload + SD deploy D:
    deploy-debug.bat: debug-arduino build + ISP upload (serial ON) + SD deploy D:
    deploy-vice.bat: VICE-only C64 debug build (no Arduino, no SD)
2026-04-18 Change cold boot policy from menu-first to BASIC-first
    Cold boot now releases C64 to BASIC instead of auto-loading the menu
    via TransferMenu(). This eliminates the black screen on power-on.
    Menu is loaded only on explicit SEL short press.
    [CartApi.cpp, CartInterface.cpp, EasySD.ino]
2026-04-18 Fix cold-boot reset drive and deploy flow
    [CartInterface.cpp, CartInterface.h]
2026-04-18 Rewrite HWTest plugin as minimal scaffold for incremental development
    Previous full-screen HWTest with NMI transfer, custom ZP pointers ($8F/$90
    overlapping StreamLargeFile range), and complex state machine froze on real
    hardware. Replace with a minimal skeleton that:
    - Sets C64 BASIC colors (border light blue, bg blue)
    - Clears screen via KERNAL CHROUT
    - Prints "EASYSD HARDWARE TEST" centered on row 1
    - Waits for any keypress (SCNKEY + GETIN pattern)
    - Returns to menu via PROT_StartTalking/EndTalking/ExitToMenu
    This validates the plugin loading path end-to-end. HW test logic
    (NMI, data bus verification) will be added back incrementally once
    this scaffold is confirmed working on real C64 ha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
2026-04-18 Fix Arduino source documentation comments
    [CartApi.cpp, DirFunction.cpp, EasySD.ino]
2026-04-19 Fix plugin launch paths and regenerate multiload zips
    [CartApi.cpp]
2026-04-19 Fix SEL/menu return after PRG launch
    [CartApi.cpp]
2026-04-19 Remove Optiboot/bootloader support entirely
    Any bootloader's startup window (~1-2s) leaves /RESET and EXROM floating,
    which breaks the EasySD cold-boot sequence that must hold the C64 in reset
    until the AVR is fully initialised. ISP upload is now the only supported
    upload method.
    Removed: arduino-upload target, --optiboot/--no-bootloader flags,
    find_bootloader_hex(), burn_bootloader parameter, USB serial upload path.
    [EasySD.ino]
2026-04-19 Remove TAP-to-PRG support from menu UI
    TAP conversion was never hardware-verified and added significant
    complexity to the menu (choice dialog, error strings, IS_TAP_SELECTED).
    The Arduino-side TAP decoder will be removed in the next commit along
    with the SRAM optimization work.
2026-04-19 Optimize SRAM: shared buffer union, remove TAP decoder, refactor streaming
    SRAM optimization (ATmega328P, 2KB):
    - Overlay Arguments[130], IO2 buffers[128], and NI buffer[400] in a
    single union (sharedBuf). Saves 258B vs separate allocations while
    enabling the full 400-byte NI buffer for CVD video playback.
    - Reduce ByteQueue from 63 to 31 entries (-32B).
    - Move OpenMenuFromSdRoot string literals to PROGMEM (-26B).
    - Remove dead p_easysd/easysd copy in TransferMenu.
    - Result: release 530B free, debug 353B free (both above 350B floor).
    TAP decoder removal:
    - Remove ConvertStandardTapToPrg and all TAP pulse/block parsing from
    CartApi.cpp (~270 lines). TAP error codes removed from CartApi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
    [CartApi.cpp, CartApi.h, EasySD.ino]
2026-04-21 Fix HandleInvokeWithName for absolute plugin paths + preserve launch dir for all subdirs
    HandleInvokeWithName: restore CWD navigation for absolute paths (e.g.
    "/PLUGINS/PRGPLUGIN.PRG") using the same save/navigate/restore pattern
    as HandleOpenFile. The menu invokes plugins via absolute paths — without
    navigation the basename lookup fails in the game's CWD. Key difference
    from the previous 8079e03 approach: CWD is restored BEFORE launching,
    so LoadAndLaunchFile sees the correct pathDepth and currentPath.
    LoadAndLaunchFile: relax preserveLaunchPath from exact "EASYLOAD.PRG"
    name match to pathDepth > 0, so all subdir launches preserve the CWD
    after Init() reset. This supports mixed-case LFN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
    [CartApi.cpp]
2026-04-25 Fix multiload PRG loading: long paths and case-insensitive .prg
    KernalBridge: switch from fixed-length #OPENFILE (#31) to PROT_SetNameZ
    with a null-terminated buffer so paths longer than 31 bytes (e.g.
    "/MULTILOAD/IOWA JACK/IOWA JACK.PRG", 34 bytes) are no longer truncated
    on the way to the Arduino, which previously caused open failures for
    game-directory PRGs.
    Filename.s ISPRG: force lowercase via ORA #$20 before comparing the
    extension so .prg, .PRG, .Prg etc. all match. Stack-balance with PHA/PLA
    so the CHECKFILENAME return value in A is preserved on the not-PRG path.
2026-04-25 Refresh multiload bundle archives
    Rebuilt EASYLOAD.PRG inside each multiload ZIP. Pairs with the
    KernalBridge long-path / case-insensitive .prg fixes so games in
    /MULTILOAD/<title>/ subdirectories load correctly on real hardware.
2026-04-25 Document edge-connector wear as dominant cause of boot anomalies
    After chasing a cold-boot 'BASIC, no cursor' symptom through five firmware
    variants and ending up worse than the baseline, the root cause was confirmed
    to be 500+ cartridge insertions wearing the edge fingers, not firmware. Build
    1 baseline (ReleaseToBasic(false)) works on cold + warm boot once the
    cartridge is reseated.
2026-04-25 Clean up stable Arduino path: remove dead code and misplaced doc-blocks
    Tidies the boot/menu/PRG hot path without changing behavior. Build size is
    identical (23098 B flash / 1492 B RAM).
    - EasySD.ino: remove file-header doc-block accidentally pasted inside
    suppressButtonsFor() body
    - CartApi.cpp: remove second misplaced doc-block from inside HandleStream's
    goto-out region; drop dead commented vars (chunkLength, inChunkDelay, old
    uint8_t streamBufferIndex); annotate the intentional double SetPage(0) in
    HandleResponse so it is not mistaken for a typo
    - CartInterface.cpp: remove unreachable enqueue branch after
    'case IN_TRANSMISSION : break;' in ReceiveHandler (would have duplicated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
    [CartApi.cpp, CartInterface.cpp, DirFunction.cpp, EasySD.ino]
2026-04-25 Document EASYLOAD hang fingerprint near JMP (\$008B)
    Real-HW observation: when EASYLOAD.PRG loads in a multiload game folder,
    the C64 ends with outer border = black and inner area = blue. Those colors
    come from the loaded first part starting up, not from MultiLoad MAIN.
    Recording this so future debug sessions can use the fingerprint to localize
    the hang: if the system stops with these colors, MAIN finished cleanly and
    the game began executing — narrow the search to RL_HANDLER (resident hook)
    or game-side loader code, not to the EASYLOAD setup path.
2026-04-25 Refresh roadmap and plugin-bug docs to current 0.7 state
    Both docs were stale relative to the post-cleanup `5c40c70` state. Roadmap
    listed TAP refactor as HIGH priority (TAP fully removed in 2026-04) and quoted
    ~1374-line CartApi.cpp (now ~1452). Plugin-bug doc reported MultiLoad as a
    single READY-freeze case and treated the resident-loader hang as still
    TBD post-2026-04-12 changes.
    - DEVELOPMENT_ROADMAP.md
    - Mark sima MultiLoad PRG bundles as verified working on real HW.
    - Move EASYLOAD chain hang into a "known issues, out of scope for 0.7"
    block with the black/blue fingerprint and the RL_STUB-wipe hypothesis.
    - Drop the obsolete TAP refactor phase, renumber Arduino split phases.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
2026-04-26 Stabilize cold-boot BASIC release timing
    [CartInterface.cpp, CartInterface.h, EasySD.ino]
2026-04-26 Sync docs with current cold-boot behavior
2026-04-26 Fix cold-boot freeze: double-edge /RESET release
    After a multi-second /RESET LOW dwell during AVR + SD init, a single
    rising edge ("delay + ResetHigh") was not reliably enough to bring CIA1
    fully out of /RES on real C64 hardware: BASIC text appeared but the
    cursor never blinked (cursor IRQ never started), with NMI-driven SEL
    still alive. This reproduced on every cold boot once edge-connector
    contacts were verified clean, ruling out the previously suspected
    hardware-only explanation.
    Replace ReleaseColdBootToBasic with a double-edge release: end the long
    LOW dwell via ResetHigh, hold HIGH for 50 ms, then issue the same
    ResetC64 pulse the warm reset path uses. The C64 boots from the
    second (s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
    [CartInterface.cpp, EasySD.ino]
2026-04-26 docs: fix grey-area doc errors (boot sequence, ROML terminology, SEL polling)
    - ARCHITECTURE_REVIEW.md: remove incorrect MCU-internal-EEPROM capability;
    add Cold Boot Sequence section documenting the 5-state machine,
    ReleaseColdBootToBasic double-reset rationale, EXROM glitch-free init,
    and SEL button behaviour
    - CARTRIDGE_PROTOCOL.md: correct HandleStream() streaming termination —
    it uses a 100ms IO2 timeout, not SEL pin polling
    - TIMING.md: fix terminology 'EEPROM data' -> 'ROML chip data' in streaming
    debug note
2026-04-26 cleanup: dead code removal, INY bugfix, PROT_ReceiveFragment binary merge
    C1 - PROT_SendFragment: add missing INY (dormant infinite-loop bug; Y was
    never incremented so CPY #\ always failed; PROT_WriteFile not called
    in any active plugin/menu code so this was never triggered)
    A1 - CartLib.s: remove TransferHandler/ENDOFBLOCK/ENDOFTRANSFER dead labels
    from the loader binary (RAM copy; NMI vector always points to ROML
    chip at \, never to these RAM addresses)
    A2 - CartApi: remove SingleBufferedStreaming() -- never called, used raw
    PORTD/PORTC writes that bypassed the ROML page mechanism
    A3 - CartApi: remove HandleValueResponse() -- never called anywhere
    A4 - CartApi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
    [CartApi.cpp, CartApi.h]
2026-04-26 fix: revert PROT_ReceiveFragment carry-trick merge -- ASL clobbers carry
    The B1 merge (SEC/.byte \/CLC+NOP shared-body trick) assumed carry was
    preserved through JSR PROT_DisableInterrupts. It is not: PROT_DisableVICInterrupts
    uses 'ASL VIC_INT_ACK' (shift memory location), which shifts bit 7 of the VIC
    interrupt acknowledge register into carry. This made the BCS epilogue branch
    on random VIC hardware state instead of the intended SEC/CLC selection.
    Symptom: EasySD logo appeared then grey screen -- the fake-RTS callback
    jumped to a garbage address (or vice versa), breaking the NMI transfer.
    Restore two separate routines. The other changes from ef6c302 are kept:
    - TransferHandler/ENDOFBL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
2026-04-26 feat(multiload): add ML_DEBUG_BORDERS border-color stage markers
    Add conditional border-color diagnostic markers to MultiLoad.s (MAIN)
    and ResidentLoader.s (RL_HANDLER chain). Each marker writes a distinct
    color to \ at a key execution point so a hardware hang can be
    pinpointed by the last visible border color.
    Marker map (both files):
    \ light blue : MAIN about to JMP (\)
    \ light red : RL_STUB intercepted device-8 LOAD
    \ dark grey : RL_HANDLER reached
    \ med grey : rl_chdir_to_game OK
    \ yellow : RL_OpenFile OK
    \ orange : RL_GetInfoForFile OK
    \ green : first page received (NMI path intact)
    \ light green : handler success exit
    \ light grey : handler e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
2026-04-26 docs: update for hybrid PRG launch fix and multiload diagnostic state
    CHANGELOG:
    - Add ML_DEBUG_BORDERS entry under Unreleased (2026-04-26)
    - Note real-HW observation: chain advances past MAIN, screen data written,
    RL_HANDLER now the active suspect
    DEVELOPMENT_ROADMAP:
    - Clarify that ordinary .PRG menu launches use LoadAndLaunchFile + LoaderStub,
    not KernalBridge; document SHOULD_RUN_BASIC launch-selection logic
    PLUGIN_HARDWARE_BUGS:
    - Update EASYLOAD chain fingerprint: new observation shows screen characters
    appearing (chain progressing), replacing the earlier black/blue-only state
    - Add baseline clarification: ordinary .PRG menu path bypasses KernalBridge;
    Beach Head regression w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
2026-04-26 chore(multiload): rebuild bundles and add source disk images
    - Rebuild all six multiload ZIPs with current MultiLoad/ResidentLoader binaries
    - Add source .d81/.d64 disk images for reference (gi joe, iowa jack, lastninja1/2,
    street-rod, ultima ii grand)
    - Add docs/NANO_EVERY_MIGRATION.md (Arduino Nano Every migration notes)
2026-04-26 fix(multiload): rebuild all ZIPs with ML_DEBUG_BORDERS=0 (release)
    Previous bundles were built with --ml-debug-borders, embedding the border-color
    stage markers (ML_DEBUG_BORDERS=1). This caused all games to show the same
    repeated marker pattern on real hardware instead of game content.
    Rebuilt all six ZIPs from disk images using the current template with
    ML_DEBUG_BORDERS=0 (no border writes compiled in):
    - GI JOE (SD2IEC).ZIP -69 bytes
    - IOWA JACK.ZIP -69 bytes
    - LASTNINJA1.ZIP -68 bytes
    - LASTNINJA2.ZIP -70 bytes
    - STREET-ROD.ZIP -70 bytes
    - ULTIMA II GRAND.ZIP -70 bytes
2026-04-26 fix(loaderstub): compact SHOULD_RUN_BASIC, eliminate screen RAM overflow
    The hybrid-PRG launch detection added in 461d39a grew LoaderStub to 209
    bytes. The cassette buffer image is always padded/sent as 256 bytes, but
    the stub itself must fit in 192 bytes ($033C-$03FB) — anything beyond
    that overflows into screen RAM at $0400 and shows up as visible garbage
    on the menu just before the PRG launches.
    Rewrite SHOULD_RUN_BASIC as a single linear decision tree:
    - Standard BASIC PRG: load address == $0801
    - Hybrid PRG: load < $0801, end reaches $0809+, $0805 == $9E (SYS)
    Drops the next-line pointer validity check — the SYS token is sufficient
    proof of an embedded BASIC stub.
    S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
2026-04-27 Fix cold boot freeze: replace double-edge reset with single ResetC64() call
    ReleaseColdBootToBasic() previously used ResetHigh()+delay(300)+ResetC64()
    which caused the C64 to boot twice: once from the intermediate ResetHigh()
    edge (garbled screen, interrupted) and again from ResetC64() 300ms later.
    This manifested as a 1-2 second delay with garbled BASIC before clean boot,
    and occasional freeze (cursor never blinks) when the second pulse also failed.
    Fix: call ResetC64() directly from the already-LOW /RESET state. From LOW,
    ResetC64() adds a 1ms LOW dwell then a single LOW->HIGH rising edge, so the
    C64 boots exactly once from that edge.
    Also moved cartApi.Init() to after ReleaseColdBootToB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
    [CartInterface.cpp, EasySD.ino]
2026-04-27 docs: correct cold-boot release description to single-edge ResetC64()
    The double-edge approach (ResetHigh+delay+ResetC64) was superseded on
    2026-04-27. All boot sequence descriptions updated to reflect the current
    implementation: ReleaseColdBootToBasic() calls ResetC64() directly from
    the already-LOW /RESET state, producing a single clean LOW->HIGH edge.
    Files updated: CLAUDE.md, GEMINI.md, docs/DEVELOPMENT_ROADMAP.md,
    docs/architecture/ARCHITECTURE_REVIEW.md, docs/arduino/PCB_BRINGUP_NOTES.md
2026-04-27 deploy: rename deploy.bat -> deploy-release.bat, fix deploy-debug.bat (C64 release + Arduino debug firmware)
2026-04-27 fix(arduino): eliminate stack overflow on subdir PRG launch
    Root cause: during the HandleInvokeWithName -> NavigateToPath ->
    LoadAndLaunchFile -> sd.open() call chain, two 64-byte local char
    arrays (savedPath[64] in HandleOpenFile/HandleInvokeWithName and
    launchPath[64] in LoadAndLaunchFile) occupied 128 bytes of stack
    simultaneously. With only ~210 bytes of stack headroom during menu
    operation in debug builds, any subdir launch (which adds a
    ChangeDirectory() frame on top of ToRoot()) overflowed the stack and
    corrupted the session state, causing an 'Unknown cmd' error and a
    permanently frozen menu. Root-level PRGs worked because their forward
    NavigateToPath() reduces to ToRoot() only (sha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
    [CartApi.cpp]
2026-04-27 cleanup: remove obsolete test infrastructure (VICE mocks, self-test, h/m console)
    The fix in ba16e9b made it possible to run Arduino serial debug while the
    cartridge is plugged into a real C64, so the parallel VICE-only and
    Arduino-only test paths are no longer needed. Drop them along with the
    interactive 'h'/'m' console and on-device self-test/protocol-test suites.
    C64 side:
    - Delete EasySDMenuMock.s + CartLibDebug.s and their includes
    - Delete VICE-only test PRGs (WavPlayerViceTest.s, PrgLoadViceTest.s)
    Arduino side:
    - Delete printHelp(), ShowMem(), and the loop()'s Serial console handler
    - Delete EASYSD_SELFTEST and EASYSD_PROTOCOL_TEST blocks (~360 lines)
    - Keep logRamBudget() / [BOOT]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
    [EasySD.ino, test_directory_navigation.py]
2026-04-28 cleanup: remove archived and obsolete test remnants
    Stop tracking archived/local-only material while keeping it on disk via .gitignore rules for Archive/archive/Archived/archived, _archive, build/, and _ul.
    Remove obsolete VICE/mock and Arduino-only test paths: drop the standalone SD_TEST_MINIMAL sketch, delete stale protocol/VICE test documentation, remove TEST_TERMINAL_MODE plus unused ReceiveFile/UpdateFile serial-transfer helpers, and simplify EasySDMenu.s to the real C64/Arduino protocol path.
    Update build/deploy behavior and documentation to reflect the supported workflow: release C64 software, Arduino debug firmware over USB serial, and real C64 hardware validation. Preserve HWTest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
2026-05-02 fix: IRQHack64-style cold boot — resolves cursor freeze
    AVR no longer holds C64 /RESET LOW during init. IOSetup() now drives
    /RESET HIGH from the start (matching the original IRQHack64 baseline);
    the C64 cold-boots to BASIC on its own RC reset while AVR initializes
    SD in parallel.
    Holding /RESET LOW for 470-1000ms during AVR boot was non-standard for
    the C64 chip set (which expects ~50ms RC reset) and disturbed the CIA1
    Timer A IRQ chain — the kernel printed BASIC banner but cursor never
    blinked. The hold was leftover architecture from an older menu-on-cold-
    boot policy and was not needed under the current BASIC-first model.
    Removed:
    - BootState enum and bootState global (telemetry-onl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
    [CartInterface.cpp, CartInterface.h, EasySD.ino]
2026-05-02 docs: update cold-boot description to IRQHack64-style + uEliteBoard64 context
    Reflect the cold-boot architecture revert across all guides and rewrite
    COLD_BOOT_FAILURE_RETROSPECTIVE.md to capture the resolution path:
    - IRQHack64 baseline comparison identified the /RESET hold as the
    architectural divergence causing the symptom.
    - Hardware co-requirement documented: parasitic loads on the C64 power
    rail (Pi1541 Zero / MicroSD2IEC) on the uEliteBoard64 (uni64.com)
    integrated SD CARD/IEC PORT slot must be removed for stable cold boot.
    - The board's own first-start guide notes that "no blinking cursor
    (especially with cartridge plugged in)" is a known board-class
    behavior that may also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
2026-05-02 Archive legacy Arduino CartLibHi
2026-05-02 build(loader): derive IRQLoader EPROM placeholders from symbols
    Replace the stale IRQLoader note that referenced the retired 64IRQTransferSoftNewForC64Fast/CartridgeSuperFastNew.bat workflow.
    Teach Tools/build.py to read PLACEHOLDER1..12 from the 64tass IRQLoader.txt labels file and feed those offsets into create_eprom_loader(). This keeps IRQLoaderRom.bin generation aligned with the assembled loader layout instead of relying on a hand-maintained position list.
    Verified with python -B syntax compilation, direct placeholder parsing, python Tools/build.py core, and an EPROM page placeholder byte check.
2026-05-03 feat(multiload): MLBoot prologue blob replaces EASYLOAD.PRG/MAIN
    The legacy EASYLOAD.PRG / MultiLoad.s MAIN chain hung before MAIN's first
    Arduino call on real hardware (multiload_v2.md). Replace it with a single
    self-contained ~1.5 KB prologue blob (MLBoot.s) that the Arduino synthesises
    and patches with the user-selected first-part filename, eliminating the
    per-game template-patched PRG and the duplicated launcher logic.
    * MLBoot.s: standalone-buildable; pulls System/EasySD/CartZpMap directly
    (prebuild_checks() whitelisted), mirrors 4 CartLibCommon constants, and
    includes ResidentLoader.s verbatim. MAIN runs RL_INSTALL, then issues
    Kernal LOAD on the patched name (which now flows th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
    [CartApi.cpp, CartApi.h]
2026-05-03 fix(mlboot): settle delay before Kernal LOAD + visible LOAD-error indicator
    Real-HW test showed the C64 cold-boots to BASIC immediately after the
    "MLBoot launched" log line, with no Arduino "OpenFile:" log ever firing
    — meaning JSR $FFD5 returned C=1 and MAIN's BCS branched to ml_load_error.
    Root cause is a race between MLBoot.MAIN's first Kernal LOAD and
    LoadAndLaunchFile()'s post-blob sequence: SendMLBootBlob() returns,
    DisableCartridge() leaves EXROM HIGH, then Init() + NavigateToPath()
    take ~50–100 ms before cartInterface.StartListening() finally attaches
    the IO2 ISR. By then the C64 has long since reached RL_StartTalking and
    emitted the $64/$46/$17 handshake into a deaf Arduino —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
2026-05-03 fix(multiload): SdFat 2.x O_RDONLY remap + resident loader robustness
    HandleOpenFile passed the C64-protocol "read" flag (1, the SdFat 1.x
    O_READ value) directly to sd.open(). SdFat 2.x reinterprets bit 1 as
    O_WRONLY, so files opened "for read" were actually write-only — isOpen()
    and fileSize() worked fine but read() returned -1 immediately. Translate
    protocol flags to SdFat 2.x O_RDONLY/O_WRONLY/O_RDWR explicitly. Also
    unblocks the WAV/KOA/PET/CVD plugin file streams that share PROT_OpenFile.
    HandleReadFile re-enables interrupts around the SD read so multi-sector
    reads (RL_LoadFileBySize 172-page payloads) get fresh millis() timeouts
    during cache misses, and now reports stall vs eof vs o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
    [CartApi.cpp, CartApi.h, CartInterface.cpp, EasySD.ino, EasySDLog.h]
2026-05-05 remove(multiload): drop MultiLoad/MLBoot/EASYLOAD/resident-loader path
    The active MultiLoad chain never reached a stable real-hardware state and the
    synthesised MLBoot prologue blob occupied ~1.5 KB of scarce ATmega328P flash.
    Multi-disk games are no longer supported on EasySD.
    C64 sources removed: MLBoot.s, ResidentLoader.s, archived MultiLoad.s.
    Arduino: dropped COMMAND_GOTO_PATH, HandleGotoPath, m_multiLoadModeActive,
    SendMLBootBlob, MLBOOT_* constants, /MULTILOAD/ prefix branch, ML idle-reset
    session ag and the ML log category. Generated FlashLib.h no longer carries
    mlbootData[]/mlboot_len.
    Build: build.py no longer compiles MLBoot.s; prebuild_checks() back to a
    single CartZpMap.inc inc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
    [CartApi.cpp, CartApi.h, DirFunction.cpp, EasySDLog.h]
2026-05-05 docs: drop MultiLoad/MLBoot/resident-loader leftovers
    Removal commit (1b1ff16) left active docs with "removed" notices that just
    add stale context for current development. Strip those out of CLAUDE.md,
    GEMINI.md, README.md, DEVELOPMENT_ROADMAP.md, PLUGIN_HARDWARE_BUGS.md,
    architecture/KERNAL_BRIDGE.md, plugins/KernalBridge.md, .gitignore and a
    DirFunction.cpp comment. CHANGELOG keeps the historical entry.
    Also fixes two stale "resident loader" mentions in README.md (cartridge
    ROML chip description) and aligns CLAUDE.md flash budget with the
    post-removal numbers (release 22.9 KB / 74%, debug 24.7 KB / 80%).
    [DirFunction.cpp]
2026-05-07 remove(hwtest): drop HWTest plugin from C64/Arduino/build/docs
    Feature scope retired: HWTest signal-diagnostic plugin removed end-to-end.
    Mirrors the MultiLoad removal pattern — single commit, no leftovers.
    - Delete EasySD/Plugins/HWTest/HWTest.s
    - Drop COMMAND_HWTEST from EasySD/Loader/Common/EasySD.inc
    - Drop HandleHwTest() impl + decl + dispatch case
    - Drop COMMAND_HWTEST #define from CartApi.h
    Build system:
    - Remove HWTest entry from Tools/build.py PLUGIN_MATRIX
    Docs: strip HWTest references from CLAUDE.md, GEMINI.md, README.md,
    sdcard/README.md, docs/DEVELOPMENT_ROADMAP.md, docs/NANO_EVERY_MIGRATION.md,
    docs/PLUGIN_HARDWARE_BUGS.md, docs/architecture/{ARCHI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
2026-05-07 fix(build): emit plugin .prg with CBM load-address header
    The plugin build invoked 64tass with both -c and -b, where -b
    (--no-header) wins and stripped the 2-byte load-address header.
    Arduino's LoadAndLaunchFile reads the first 2 bytes as the load
    address, so plugins were loaded at garbage addresses (e.g. CVD
    plugin at $DF20 / IO2 area, WAV/KOA/PET/PRG at $034C) and the
    C64 jumped to nonsense — symptom: grey menu screen, no progress.
    Drop -b so plugin .prg files become proper CBM PRGs again.
2026-05-07 Fix WavPlayer SID and DigiMax playback paths
    Prioritize the non-MK3 WAV playback path used on EasySD hardware.
    - Make the mode selector work with the normal KERNAL IRQ keyboard scan disabled by calling SCNKEY before GETIN.
    - Seek past the 44-byte RIFF/WAVE header before starting compat SID/DigiMax streaming and before the MK3 path.
    - Pass unsigned 8-bit PCM silence () as the IO2 stream EOF pad byte and make the Arduino stream handler honor that argument.
    - Remove playback-time keyboard polling from the SID/DigiMax compat path, the MK3 main loop, and old stream test loops so playback does not touch CIA1 keyboard ports after start.
    - Keep MK3 menu detection/selectability as best-effort, r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
    [CartApi.cpp]
2026-05-08 feat(menu): show 'PLUGIN MISSING' for non-PRG files when plugin absent
    When a media file (.cvd/.koa/.wav/.pet) is selected but its plugin .prg
    is missing from /PLUGINS/, the menu used to fall through to PROGRAM,
    which sent the media bytes to the Arduino as if they were a PRG. The
    Arduino then tried to launch garbage payload — confusing and looked
    like a hang.
    Add ISDIRECTLAUNCH whitelist (only .crt and .irq are valid non-plugin
    direct launches) and a 'PLUGIN MISSING' status line so the user sees
    why nothing happens.
2026-05-08 fix(arduino): keep CWD at plugin parent dir until sd.open() in LoadAndLaunchFile
    HandleInvokeWithName for an absolute path (e.g. /PLUGINS/CVDPLUGIN.PRG)
    restored the user's CWD before calling LoadAndLaunchFile. Inside
    LoadAndLaunchFile, sd.open(basename) then looked in the user's dir
    (e.g. /CVD) — where the plugin file does not exist — and silently
    failed (no [LOAD] launch log, no plugin entry). PRG launches via
    PROGRAM happened to work because the user's CWD already was the file's
    parent dir, so the misordered restore was a no-op.
    Capture the user's CWD into savedPath up front so it persists across
    the sd.exists()/Navigate() reshuffle and across Init() in
    LoadAndLaunchFile. Drop the pr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
    [CartApi.cpp]
2026-05-08 fix(KoalaDisplayer): disable display before PROT_StartTalking; correct transfer offsets
    PROT_Send relies on cycle-counted bit timing (WasteCertainTime). With the VIC
    display ON, badlines steal 40-43 CPU cycles every 8th raster row and stretch
    the long/short modulation pulses, so the Arduino misses the 'I'/'R'/'Q' identifier
    handshake, stays in IDLE, and the C64 hangs forever in PROT_WaitProcessing.
    KernalBridge already disables the display before StartTalking; KoalaDisplayer
    did not. Move JSR PROT_DisableDisplay before JSR PROT_StartTalking to match
    the protocol invariant.
    Also fix the screen/color RAM transfer in VIEWKOALA: source blocks are exactly
    1000 bytes ($3E8), so the last 256-byte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
2026-05-08 fix(cartlib): force Y=0 before PROT_Receive call sites
    PROT_ReceiveFragmentNoCallback uses Y as the index into NMITAB to pick the
    NMI handler (Y=0 → X1, 1 → X4, 2 → X8). Most callers happen to have Y=0
    left over from a prior LDY, but this is implicit and brittle: a future
    refactor could leave Y in any state. Add an explicit LDY #\$00 immediately
    before each call into the receive path:
    - PROT_GetInfoForFile (CartLibHi.s)
    - LoadFileBySize → PROT_ReadFileNoCallback (CartLibHi.s)
    - KernalBridge phase-1 header read → PROT_ReadFileNoCallback
    Also fixes EOL on KernalBridge.s.
2026-05-08 fix(arduino): wait for stable PHI2 in LoadAndLaunchFile before re-arming IO2
    LoadAndLaunchFile already calls ResetC64 at the start of the launch sequence,
    which leaves the C64 bus transitioning during the LoaderStub boot. The original
    code re-attached the IO2 interrupt immediately after DisableCartridge, so stray
    falling edges from the still-settling bus leaked into the cart receive state
    machine. The plugin's subsequent PROT_StartTalking ('I'/'R'/'Q') then could
    not complete the handshake — the receive state was already in a half-matched
    identifier state — and the C64 hung indefinitely in PROT_WaitProcessing.
    TransferMenu has had the same guard for the same reason. Mirror it here:
    Wait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
    [CartApi.cpp]
2026-05-08 feat(debug): expand serial logging for cart-protocol diagnostics
    Debug builds (deploy-debug.bat path) only had LOAD logs enabled, which made
    plugin protocol failures invisible — when the C64 stopped sending commands
    there was nothing in the serial output to indicate where the protocol broke.
    Enable SYS, SD, DIR, FILE, RAW categories in the debug build (Tools/build.py).
    PRG and PROTO stay off (PRG is launch-internal, PROTO has no log calls).
    Adds three targeted diagnostic lines:
    - 'EasySD DEBUG boot' on Arduino setup so the active firmware mode is obvious
    - 'HS OK' when the cart receive state machine completes the I/R/Q handshake
    - 'rx / cmd=N' for every successfully decoded command byte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
    [CartApi.cpp, CartInterface.cpp, EasySD.ino, EasySDLog.h]
2026-05-08 fix(arduino): attach IO2 listening BEFORE post-launch SD housekeeping
    Reverts the PHI2-stabilization guard (60adc31) which was diagnostically wrong
    for the plugin path: it added 20-280 ms of extra delay before StartListening,
    exactly when the C64 plugin needs the AVR to be already listening.
    Timing reality after DisableCartridge in LoadAndLaunchFile:
    - LoaderStub jumps to plugin entry within ~1-2 ms (it's tiny, sits in $033C).
    - Plugin INIT + PROT_DisableDisplay + PROT_StartTalking issues the first IO2
    modulation pulse within ~5-15 ms.
    - Old code did Init() + dirFunc.NavigateToPath() FIRST (10-50 ms of SD ops),
    then StartListening — so the plugin's identifier bytes arrived while the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
    [CartApi.cpp]
2026-05-08 wip(plugin-handshake): pump ReceiveHandler during post-launch SD ops
    Diagnostic / partial fix for the KoalaDisplayer (and other media plugins)
    ending up at a black screen instead of running.
    PROBLEM
    LoadAndLaunchFile() does Init() + NavigateToPath() AFTER StartListening().
    These two SD calls block the main loop for ~20-60 ms. During that window
    the C64 plugin runs INIT and PROT_StartTalking — the I/R/Q identifier
    bytes arrive at the AVR's IO2 ISR, but the byte-level identifier state
    machine (ReceiveHandler) only runs from the main loop. While main loop
    is blocked, the ISR-set bitState is overwritten by the next edge before
    ReceiveHandler can promote it to a byte. Result: identifier never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
    [CartApi.cpp]
2026-05-08 Simplify KOA plugin launch path
    Treat a selected .KOA file as the media input instead of launching a filesystem-aware plugin. The menu now sends the selected KOA path through InvokeWithName, and the AVR associates that media path with /PLUGINS/KOAPLUGIN.PRG.
    Move the KOA loading responsibility to the AVR side: resolve both paths, validate the KOA payload size, validate the PRG plugin load address, prepare the C64 memory image with Koala data at $2000 and plugin code at $C000, then disable the cartridge before jumping into the viewer. This keeps SD/file ownership on the AVR and removes PROT_OpenFile, LOADMEDIAPATH, SetNameZ/BCS-style handshakes from the KOA plugin.
    Remove the unused BIN plu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
    [CartApi.cpp, CartApi.h]
2026-05-08 Stabilize KOA plugin launch
    Keep KOA launch as a one-way AVR-to-C64 transfer. The selected KOA is opened first and kept in its parent directory, while KOAPLUGIN.PRG is treated as a fixed PRG payload staged by the AVR rather than as a protocol-speaking plugin.
    Preload the KOA plugin payload into the existing NI buffer and send it from RAM. This avoids reading the plugin from SD during the timing-critical cartridge transfer and keeps the plugin model PRG-only.
    Move KOA media SD reads out from under noInterrupts(). SdFat reads can stall when timer-based timeouts are frozen, so only the byte transmission to the C64 remains interrupt-protected.
    After a successful KOA launch, leave the cartridg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
    [CartApi.cpp]
2026-05-08 Route KOA media through PRG name resolution
    Do not use a separate OpenReadPath path for KOA media. COMMAND_INVOKE_WITH_NAME now resolves absolute paths, parent CWD, truncated LFN prefixes, and unusual filename bytes through the same path that regular PRG launch already uses.
    After the common name resolution succeeds, KOA launch opens the resolved basename from the already-selected media directory and keeps only the transfer behavior special: KOA data to and KOAPLUGIN.PRG to .
    [CartApi.cpp]
2026-05-10 Bundle SdFat 2.3.0 in Arduino/libraries and pin builds to it
    Replace the legacy SdFat 1.x copy in Arduino/libraries/SdFat with the
    upstream SdFat 2.3.0 release. arduino-cli previously picked up whatever
    SdFat happened to be installed in the user's sketchbook, which masked
    behavioural differences between machines and made KOA loading regressions
    hard to attribute.
    Tools/build.py: pass --libraries Arduino/libraries to arduino-cli compile
    so the project-bundled SdFat is always used regardless of the user's
    sketchbook contents. arduino-setup no longer installs SdFat globally.
2026-05-10 Resolve LFN names to 8.3 SFN before every sd.* call site
    SdFat 2.x sd.open()/sd.chdir()/sd.exists() can intermittently fail for
    long file names with spaces or lowercase even when the entry is on disk —
    observed as `[ERR][SYS] KOA media open` for files like "pic b rambo.koa"
    while ELITE.KOA worked, and as cascading `chdir FAILED: KOALA PAINTER`
    errors after a single sd.open failure poisoned the protocol state.
    The on-disk SFN form (e.g. PICBRA~1.KOA, KOALAP~1) parses through the
    8.3 path logic and opens reliably for the same entry. openNext() reads
    LFN entries correctly, so iterating + getSFN() is the canonical way to
    resolve a (possibly LFN) basename to a sd.*-friendly form.
    DirFunction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
    [CartApi.cpp, DirFunction.cpp, DirFunction.h]
2026-05-10 Docs: refresh SdFat / LFN-handling notes and flash budgets
    CLAUDE.md, GEMINI.md, docs/arduino/DIR_NAVIGATION_API.md:
    - Document the LFN→SFN resolution requirement and the FindFileSFN /
    FindDirSFN helpers introduced in 85719f4.
    - Note that SdFat 2.3.0 is now bundled in Arduino/libraries and that
    builds are pinned to it via --libraries (9f0c442).
    - Update flash budget numbers to current values (release 78%, debug
    94% — debug is tight after the SdFat 2.3.0 bundle).
    - KoalaDisplayer marked working (incl. LFN media names).
    - DIR_NAVIGATION_API.md: ChangeDirectory now retries with SFN on chdir
    failure; GoBack uses sd.chdir(".."); FindByPrefix/FindDirectoryByPrefix
    replaced with FindF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
2026-05-10 Fix CVD streaming first-byte timeout race
    CvdPlayer's grey-screen hang was caused by an AVR/C64 timing mismatch
    in the NI streaming path. After PROT_NIStream returned SUCCESS, the
    AVR entered its IO2 busy-wait loop within ~10 ms, but the C64 took
    ~40-60 ms before firing its first IO2 strobe (DELAYFRAMES 2 + IRQ
    vector setup + raster wait at $241). The single-window timeout
    (0xFFFF inner iterations ≈ 33-41 ms) consistently fired before the
    C64 started streaming, after which the AVR called DisableCartridge()
    and NMI_000 read RAM garbage into the bitmap — leaving the empty
    $2000 bitmap and uniform $D021 grey on screen.
    Two coordinated changes:
    - HandleNonInterruptedStream: introduce IO2_FI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
    [CartApi.cpp]
2026-05-11 Stabilize CVD playback streaming
    Move CVD color-copy code out of the helper segment into the stable - range so the helper/NMI area can host a fully unrolled 400-byte NI receiver again.
    Generate the unrolled CVD NMI receiver with 64tass .for source instead of maintaining hundreds of repeated hand-written reads, preserving X/Y during transfer.
    Fix exact 400-byte multiple EOF handling by exiting when CVD_SIZE reaches zero after a block, preventing one extra padded frame from being displayed.
    Extend the build-time CVD memory layout guard to enforce fixed buffers, bitmap exclusion zones, helper bounds, and the new color-copy segment.
    Add NI stream debug logging controls for serial debug buil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
    [CartApi.cpp, EasySDLog.h]
2026-05-11 Stabilize CVD stream handoff
    Flush debug serial output before protocol responses so UART TX interrupts cannot corrupt the next IO2-decoded command byte.
    Treat exact block-size EOF as final in NI streaming, avoiding an extra synthetic padded request after 400-byte multiples.
    Keep AVR HardwareSerial buffers small in both debug and release builds to recover stack headroom.
    Clean stale CVD transfer comments and document the current unrolled NMI plus single-buffer refill model.
    [CartApi.cpp]
2026-05-11 Fix CVD NI stream startup handshake
    Delay COMMAND_NI_STREAM success until the first 400-byte block is loaded into SRAM and clear the previous response first, so the C64 remains in PROT_WaitProcessing until the AVR is actually ready.
    Precompute PORTD/PORTC values before the IO2 wait and latch them immediately after IO2 returns high, matching the original IRQHack64 DF00 trigger followed by $80AB ROML read.
    Restore the original IRQHack64 two-frame post-NI startup gap in CvdPlayer and document the CVD foreground NI-loop timing and EasySD D3/INT1 IO2 mapping.
    Verified with python .\Tools\build.py plugins, python .\Tools\build.py arduino-compile, python .\Tools\build.py release, CVDPLUGIN.PRG D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
    [CartApi.cpp]
2026-05-12 Disable PHI2-gated runtime bus sync
    Keep PHI2 as an optional/experimental input but default EASYSD_USE_PHI2_BUS_SYNC to off, so EXROM and data-bus changes no longer wait on the unconditioned C64 PHI2 signal.
    Do not gate post-menu listener startup on WaitForStablePhi2; this avoids missing the launched program IO2 handshake when PHI2 is noisy or not electrically conditioned.
    Update protocol and bring-up docs to document that PHI2 is not used by default for runtime bus or stream timing.
    Verified with python .\Tools\build.py arduino-compile and python .\Tools\build.py release; release CVDPLUGIN.PRG still contains 400 DF00-to-80AB read pairs.
    [CartApi.cpp, CartInterface.cpp, CartInterface.h]
2026-05-12 Stabilize C64 cold boot path
    [CartApi.cpp, CartInterface.cpp, EasySD.ino]
2026-05-13 Switch menu display to mixed-case C64 charset
    - Load mixed-case charset binary (mixed case chars.bin) instead of
    uppercase-only; remove reference to custom arrow chars in comments
    - PRINTASCIIFILENAME: uppercase A-Z (\-\) now pass through as-is
    (ASCII-compatible in mixed-case charset); lowercase a-z still map to
    \-\; add @ (\ -> \) handling; rename _paf_upper -> _paf_symbol
    - PRINTDIRHEADER: identical conversion update; 'ROOT' reversed-video
    bytes updated to mixed-case screen codes (\,\,\,\)
    - DRAW_SCROLL_INDICATORS: 'MORE' text uses mixed-case screen codes
    (\,\,\,\); custom arrow chars (\/\) replaced with spaces
    - petmate frame: title-bar 'EASYSD V' screen bytes updated to mixed-c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
2026-05-13 deploy: show Arduino SRAM/flash summary at end of both deploy scripts
    - build.py: save size_cache.json after arduino-compile; add arduino-size command
    - deploy-release.bat: print BUILD SUMMARY before pause
    - deploy-serial-debug.bat: print BUILD SUMMARY before pause, remove serial monitor hint
2026-05-13 UI redesign: content shifts left 1 col, stem 26 chars, DIR label, sorted dirs+files
    C64 side (EasySDMenu.s):
    - COLS table: all 25 base addresses -1 (col 4 -> col 3 base)
    - PRINTASCIIFILENAME: stem width 21->26 chars
    - Dir entries: gap+DIR label at Y=28-30 (D=,I=,R=), tail fills to Y=35
    - File entries: gap at Y=26-27, ext at Y=28-30, space at Y=31, tail to Y=35
    - SETARROW: reversal loop CPY #\->#\ (inversion ends at col 33=last ext char)
    - CLEARARROW: un-reversal CPY #\->#\, dark-grey loop CPY #\->#\ (col 38)
    - CLEARLINE: fill loop CPY #\->#\ (36 chars, col 3-38)
    - DRAW_SCROLL_INDICATORS: 'MORE' (4 chars) at col 35-38 of rows 2/22 (\/\)
    - PRINTDIRHEADER: all hardcoded addresses -1, color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
    [CartApi.cpp, DirFunction.cpp]
2026-05-13 Remove PetsciiDisplayer plugin
    - Delete petscii.c (all functions were commented out, unused)
    - Delete PetsciiDisplayer.s and unclenash.petg sample file
    - Remove #include petscii.c from CartApi.cpp
    - Remove PetsciiDisplayer entry from PLUGIN_MATRIX in build.py
    - Delete PetsciiDisplayer.md plugin doc
2026-05-13 Rewrite README as user-friendly GitHub project page
    Replace developer-status README with a clean, layperson-friendly
    project page suitable for GitHub. Covers features, hardware BOM,
    SD card layout, getting started, build reference, and architecture.
    All build paths and plugin names verified against current source.
2026-05-13 Fix README transfer rate: ~16 KB/s (actual), add PRG load time note
    Remove boastful ~40 KB/s claim (was from older 37us/byte firmware).
    Current timing: 10us + 50us = 60us/byte -> ~16 KB/s protocol ceiling.
    Add practical note: typical 50 KB game loads in about 3 seconds.
2026-05-13 README: describe cold boot from user perspective
    Replace IRQHack64 technical term with plain description:
    C64 boots to BASIC, SEL button launches the EasySD menu.
2026-05-13 Update README with improved instructions
    Clarified boot and menu button instructions in the README.
2026-05-13 README: fix credits — correct author name and tone
    Replace 'major rewrite' with accurate description.
    Credit original IRQHack64 project to I.R.on (2016).
2026-05-14 Arduino: replace O(M*N) directory sort with O(N+M) two-pass algorithm
    Root cause of 10-15 second page load times: HandleReadDirectory was using
    a selection-sort that performed M=21 full directory scans per page. For a
    1000-entry folder this meant ~21,000 openNext() calls (21 scans * 1000
    entries), each involving an SD sector read.
    New algorithm (two-pass, O(N+M)):
    Pass 1 (interrupts enabled, O(N)):
    - cartInterface.SetPage(0) at entry keeps the C64 WAITFOR loop blocked
    while the SD scan runs; the bank register is 0 so the C64 waits safely.
    - Single forward Iterate() pass over all N entries.
    - A 19-byte DirSortSlot (key[16] + dirIdx[2] + isDir[1]) is inserted into
    a 21-slot so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
    [CartApi.cpp, DirFunction.cpp, DirFunction.h]
2026-05-14 Fix PRG launch regression and extension parsing
    [CartApi.cpp, CartApi.h]
2026-05-14 Fix PRG launch in large dirs: INVOKE_WITH_INDEX command + dirIdx page cache
    - Add COMMAND_INVOKE_WITH_INDEX (cmd 24): launch file by current page + row
    index using a cached FAT dirIdx, bypassing the sequential scan that broke
    for directories with more than 21 entries / multiple pages.
    - Page dirIdx cache stored in the tail of sharedBuf.ni (zero extra SRAM).
    Cache is invalidated on chdir, cd-by-index, Init, and SD recovery.
    - Split LoadAndLaunchFile into LoadAndLaunchFile (opens by name) and
    LoadAndLaunchOpenedFile (uses already-open workingFile), so INVOKE_WITH_INDEX
    can open by dirIdx before handing off to the shared launch path.
    - DirFunction::OpenFileByDirIdx: open a file by FAT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
    [CartApi.cpp, CartApi.h, DirFunction.cpp, DirFunction.h]
2026-05-14 Fix KOA launch: dirIdx path + split HandleKoalaInvokeFromOpenFile; save 48 B SRAM
    - Add HandleKoalaInvokeFromOpenFile(): main two-file transfer impl, expects
    workingFile already open by caller (mirrors LoadAndLaunchOpenedFile pattern)
    - HandleKoalaInvoke() becomes a thin wrapper: open by SFN from CWD, then call
    HandleKoalaInvokeFromOpenFile(). Removes stale 'HandleInvokeWithName has
    already moved CWD' comment
    - HandleInvokeWithIndex(): detect .koa extension after OpenFileByDirIdx and
    route to HandleKoalaInvokeFromOpenFile(nullptr) — no path navigation needed,
    workingFile is already open from the dirIdx open
    - SRAM: consolidate 4 separate static sfnBuf[16] locals (HandleOpenFile,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
    [CartApi.cpp, CartApi.h]
2026-05-14 C64 menu: KOA launch via PROT_InvokeWithIndex (eliminate path round-trip)
    PLUGIN/ISKOA branch previously called PrepareFileNameParameter (which does a
    full PROT_GetCurrentPath round-trip to Arduino), built an absolute path string
    in PATHBUFFER, then sent it via PROT_InvokeWithName. HandleInvokeWithName then
    NavigateToPath'd to the parent, FindFileSFN'd, and called HandleKoalaInvoke.
    Now it mirrors the PRG path exactly:
    LDA CURPAGEINDEX / JSR GETCURRENTROW / LDY #0 / JSR PROT_InvokeWithIndex
    Arduino's HandleInvokeWithIndex detects .koa via EndsWithIgnoreCase after
    GetLFNByDirIdx, opens workingFile by dirIdx, and routes to
    HandleKoalaInvokeFromOpenFile — no path building, no navigation,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
2026-05-14 Cleanup: int to uint8_t booleans, eliminate volatile stream pointers, fix ForceReset redundancy
    - IsDirectory/IsFinished/InSubDir: int -> uint8_t (-3 B SRAM on AVR)
    All are boolean flags assigned only 0/1; int was 2 B each needlessly.
    - ForceReset(): remove Prepare() call that duplicated the ResyncDirFromCwd()
    + CountEntries() work already done by ToRoot(). No functional change.
    - Remove streamBuffer1/2 volatile static pointer variables (-4 B SRAM).
    They were permanently initialized to sharedBuf.io2.stream1/2 and never
    reassigned; replace all references with direct array access.
    - DoubleBufferedStreaming ISR: replace if/else-if(usedBuffe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
    [CartApi.cpp, DirFunction.cpp, DirFunction.h]
2026-05-14 refactor(arduino): remove dead SRAM/flash waste
    - CartInterface: drop blockIndex member + GetBlockIndex()/GetTransferIndex()
    methods. blockIndex was written on every 256-byte page boundary but never
    read by any caller; GetTransferIndex had zero callers. Saves 2 B SRAM,
    shrinks every TransmitByteFast* hot path by one instruction.
    - CartInterface: guard lastStaleIdentLogMs and its rate-limit check with
    #if defined(EASYSD_DEBUG_SERIAL) || defined(EASYSD_RELEASE_LOG).
    The variable existed solely to throttle a LOGE() call that is a no-op in
    release builds; wastes 4 B SRAM and a millis() branch on every ReceiveHandler
    call in production firmware.
    - DirFunction: drop selected membe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
2026-05-14 CRT: timing fix, CARTRIDGE branch cleanup, update GEMINI.md
    - CartApi.cpp: move DisableCartridge() before workingFile.close() so EXROM
    goes HIGH ~30us after NMI transfer ends, well before the Kernal cold reset
    RAMTAS routine runs. Previously EXROM stayed LOW for ~1-5ms (workingFile.close
    duration), causing RAMTAS to misdetect the - range as non-RAM and
    potentially set MEMSIZ to 32 KB instead of 64 KB.
    - LoaderStub.65s CARTRIDGE branch: remove dead code (181 -> 163 bytes, 28 B free).
    Removed: LDX/LDY, STX/STY \/\, STX/STY \/\, LDA #\/STA \.
    All of these were overwritten by RAMTAS within microseconds. Kept: LDA #\ /
    STA BORDER (visual feedback) + JMP \ (Kernal cold reset).
    - GE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
    [CartApi.cpp]
2026-05-15 WavPlayer: full rewrite — remove MK3, fix double-play bug, clean 2-mode SID+DigiMax
    WavPlayer.s (1796 -> 448 lines):
    - Remove all DigiMax MK3 / NMI-buffered code (DETECT_MK3, StartMK3Playback,
    PlaybackIRQ_Fast, ReadNextChunk, MK3MainLoop, MK3 ZP labels \-\)
    - Fix critical double-play bug: old PLAYSTATE/PLAYINDEX/READBUFFER pattern
    played every sample twice (effective rate ~5474 Hz instead of ~11 kHz).
    IRQ handlers now read one byte directly from IO2 per interrupt — no C64-side
    buffer, no replay loop.
    - Remove dead code: PlayRoutineSimple, PlayRoutineBoth, PlayDigimaxSimple,
    PlayBothBuffered, STREAMTEST, HEXTOSCREEN table, KILLCIA duplicate
    - Remove CleanReturnToMenu (SEL = hard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
2026-05-15 WavPlayer.s: fix UTF-8 BOM and em-dash encoding for 64tass
    64tass rejects files with a UTF-8 BOM (EF BB BF) at byte 0, and non-ASCII
    characters in source text (em-dash U+2014 in comments). The file was written
    by PowerShell WriteAllText which adds a BOM by default on Windows.
    Fix: rewrite without BOM (UTF8Encoding false), replace all em-dashes with --.
2026-05-15 Fix directory navigation cache ownership
    Change menu directory entry selection to use the C64 visible page and row while Arduino resolves the authoritative sorted SD entry.
    Keep the page dirIdx cache outside sharedBuf because sharedBuf is transient command scratch shared by args, NI transfer, sorting, and IO2 streaming. Document the ownership rule and add a compile-time guard so the DirSortSlot page buffer must fit in the NI scratch area.
    Make parent navigation walk from root instead of relying on sd.chdir('..'), then invalidate the full directory view cache after every successful directory change.
    [CartApi.cpp, DirFunction.cpp, DirFunction.h]
2026-05-15 Restore menu directory changes to existing protocol
    Stop using the new directory-index command from the C64 menu when entering folders. The index-based protocol is too fragile during menu/firmware version skew: an older Arduino does not answer COMMAND_CHANGE_DIR_INDEX and the C64 waits forever with the display disabled.
    Keep the robust Arduino parent-directory fix: the menu sends '..' through the existing COMMAND_CHANGE_DIR path, and the firmware resolves parent navigation by walking from root instead of relying on sd.chdir('..').
2026-05-15 Revert directory navigation regression
    Restore the stable menu and CartApi directory-entry path. Folder entry uses the existing COMMAND_CHANGE_DIR protocol again; no directory-index command or sharedBuf cache ownership change remains in the active folder-entry path.
    Keep the targeted parent-directory fix only: GoBack derives the parent from currentPath and navigates from root instead of relying on sd.chdir('..'), which can fail on some newly-created nested directories.
    [CartApi.cpp]
2026-05-15 Restore stable directory listing path
    Remove the delayed-response two-pass directory listing optimization. READ_DIR now follows the proven legacy sequence again: respond first, reset the cart index, then stream the fixed directory page while scanning visible entries.
    Keep the current-page dirIdx cache for INVOKE_WITH_INDEX, but fill it from the legacy scan instead of storing sorted records in sharedBuf or performing extra SD opens during the C64 receive burst.
    [CartApi.cpp]
2026-05-15 Revert "Restore stable directory listing path"
    This reverts commit cac3878213abedb63ec6ce725418ca81583bb4ed.
    [CartApi.cpp]
2026-05-15 Restore known-good directory baseline
    Return the remaining directory navigation files to the 31ed502 hardware-stable state. This deliberately removes the currentPath-based GoBack experiment so the next hardware test can validate the exact old directory-entry and listing behavior again.
2026-05-15 Fix parent directory navigation only
    Keep the stable directory listing, menu, CartApi, and sharedBuf paths unchanged. Only GoBack changes: instead of relying on sd.chdir('..'), it derives the parent path from currentPath and navigates from root through the existing ChangeDirectory/SFN fallback path.
    This targets the original hardware failure where second-level directories returned CD FAILED on '..' while normal folder entry remained stable.
    [DirFunction.cpp]
2026-05-15 Fix C64 grey screen on 2-deep directory back-navigation
    GoBack's call chain (GoBack → NavigateToPath → ChangeDirectory → SdFat
    openCwd) was peaking at ~350+ bytes of stack against the ATmega328's
    ~470-byte free SRAM budget, overflowing into .bss and corrupting static
    state (sharedBuf, dirFunc, sort watermarks). On the C64 side this
    manifested as a grey screen when navigating back from a 2-deep path
    (e.g. /MUSIC/2SID → /MUSIC).
    Cuts ~128 bytes off the back-nav stack peak:
    - NavigateToPath now takes char* and mutates in place (was const char*
    with an internal 64-byte buf copy).
    - GoBack uses a file-scope static buffer (s_goBackBuf[64]) instead of
    two stack-local 64-byte ar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
    [CartApi.cpp, DirFunction.cpp, DirFunction.h]
2026-05-16 Fix stable memory status footer
    Build the GET_MEMORY_STATUS response in sharedBuf.ni before transmitting so the C64 receives a deterministic 256-byte burst.
    Replace the old flash/BASIC RAM footer with exact MCU SRAM and C64 stack headroom display: MCU SRAM:<bytes>B C64 STK:<bytes>B FREE.
    Disable display around the C64 NMI page receive, then append the TSX-derived SP+1 stack headroom before rendering the status line.
    Directory navigation, paging, and shared directory buffer behavior are intentionally untouched.
    [CartApi.cpp]
2026-05-17 Fix BASIC PRG direct launch finalization
    [CartApi.cpp]
2026-09-26 Shrink debug firmware flash: shared log tag table + polled TX UART
    The debug build sat at 29832 / 30720 B (97%, 888 B free) — the next log line
    would have broken the only real-hardware debug workflow. Two changes, both
    leaving serial output byte-identical:
    - Emit the 12-byte "[LEVEL][CAT] " tag from one shared PROGMEM table
    (easysdLogLine) instead of baking it into every message literal, which cost
    those 12 bytes at each of ~50 call sites. -558 B
    - Replace HardwareSerial with a polled TX-only UART writer. The silent release
    build does not link HardwareSerial at all, so the debug build was paying for
    the Print vtable, both USART ISRs, the ring buffers and the Serial object.
    -846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
    [CartApi.cpp, EasySDLog.cpp, EasySDLog.h]
2026-09-26 docs: hardware debug tooling — USB back-power, PCB plan, logic analyzer
    Records three things that were only in conversation or in gitignored Archive
    material, and refreshes stale CLAUDE.md claims.
    docs/DEBUG_TOOLING.md:
    - Why the Nano USB port cannot be used for cold-boot testing: cartridge port
    pin 2 (+5V) is tied straight to the Nano 5V pin, so USB VBUS drives the whole
    C64 5V rail and the machine half-starts. Supported workflow is an external
    USB-TTL adapter on TX + GND only.
    - PLAN (next PCB spin, not now): Schottky in series to the Nano 5V pin, plus a
    PHI2 presence gate in firmware (PHI2 is already wired to A4) so the AVR does
    not inject current through cartridge-facing pin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
2026-09-26 docs: working plan (docs/NEXT_STEPS.md)
    Records what the project does next, so it survives across sessions instead of
    living in conversation:
    - Status snapshot with measured flash/RAM figures.
    - Step 1 (blocking, hardware side): validate the new polled-UART serial backend
    from 1ffc393 on a real C64, with pass criteria.
    - Step 2: debug content rework. The shipped debug profile compiles out all 23
    value-printing sites, so every log line that should carry data prints only its
    label — this is the main reason the log does not help today.
    - Step 3: measure with the logic analyzer before changing the plugin return path.
    - Step 4: the fix itself.
    - Ranked backlog from the 2026-09-26 audit: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
2026-09-26 docs: two open leads — floating /EXROM at power-on, footer byte loss
    NEXT_STEPS section 5: the machine-specific cold-boot symptom may have a cause
    outside the firmware entirely. Nothing drives /EXROM for the first ~65 ms after
    power-on (16K CK + 65 ms AVR start-up before IOSetup runs) and the board has no
    pull-up on that line, while the C64 own reset pulse is ~50 ms. Whether the PLA
    samples it as asserted depends on the host board pull-up and reset timing, which
    matches the "works on another machine" history. build.py already documents this
    exact failure mode for bootloaders and Optiboot was banned for it; the same
    window without a bootloader was never considered.
    Two zero-cost falsificat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
2026-09-26 Move menu ZP temps into CartZpMap.inc
    $8B-$8E was documented as FREE with a "handler scratch" note, but neither was
    true: no handler in the current sources touches that range, and EasySDMenu.s
    uses all four bytes as raw literals in PRINTASCIIFILENAME. A plugin author
    following the map would have taken bytes the menu was using.
    They now have names in the map — ZP_MENU_EXT_DOTPOS and ZP_MENU_EXT_CH0..CH2 —
    and the 20 raw literal references use those names, so the map is again the
    single source of truth the project rules claim it is.
    All five C64 binaries verified byte-identical to the previous build
    (EASYSD.PRG and the four plugins).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
2026-09-26 Remove dead declarations and name the protocol constants
    Firmware verified byte-identical (stash, rebuild, compare), and all five C64
    binaries are byte-identical too. Nothing here emits code; it is all naming and
    dead weight.
    - CartInterface.h declared HandleReceive(), ReadIO(), SetIO() and
    StreamByteSlow(). None of them has a definition anywhere — they would have
    been link errors if anyone had called them.
    - PRE_WAIT / INITIAL_WAIT / INTER_WAIT / FINAL_WAIT / SINGLE_WAIT were unused
    leftovers of an older send-timing scheme. The thresholds that actually decide
    the C64 -> AVR bit values were bare numbers inside the IO2 ISR; they are now
    BIT_GAP_MIN_US / ZERO / ONE / MAX next to t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
    [CartApi.h, CartInterface.cpp, CartInterface.h]
